STEAM-Academy-PRO/revolution-robotics-kit/certificates/Documentation/Bluetooth-testing-manual/05-select-robots.jpg

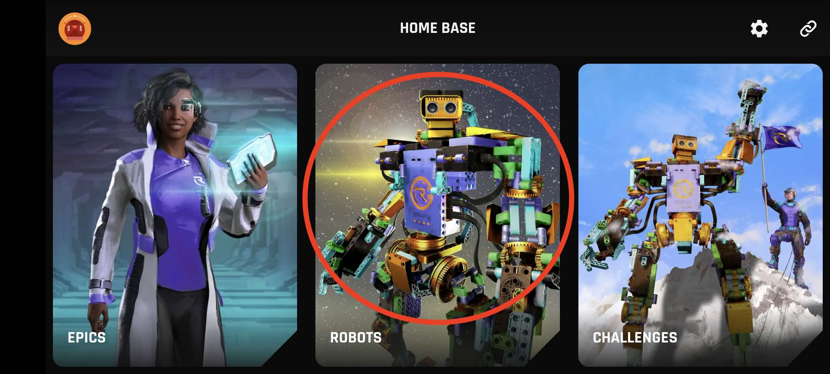
certificates/Documentation/Bluetooth-testing-manual/05-select-robots.jpg
