STEAM-Academy-PRO/revolution-robotics-kit/certificates/Documentation/Bluetooth-testing-manual/06-A-tester-in-most-recent.jpg

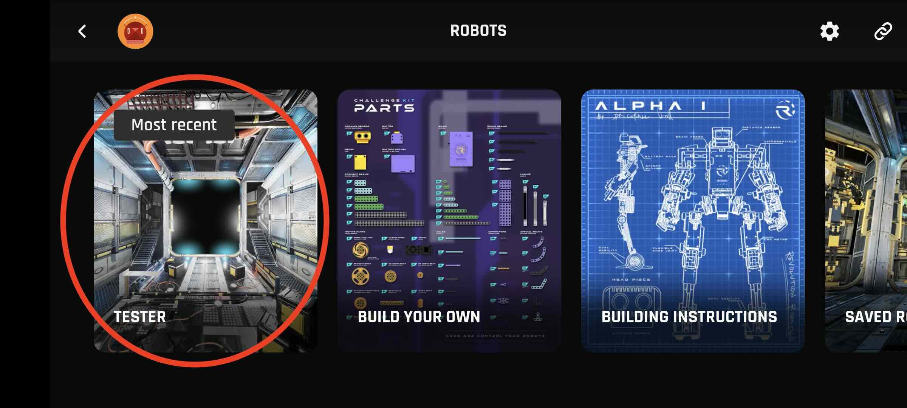
certificates/Documentation/Bluetooth-testing-manual/06-A-tester-in-most-recent.jpg
