STEAM-Academy-PRO/revolution-robotics-kit/README.md

# Revolution Robotics Kit
The repository contains all resources needed to manufacture the kit

# Bill of Materials
Find the [latest BoM here](https://docs.google.com/spreadsheets/d/1262smQJIMRbo7T9IJH0D1xYeTHnK25JgkaZvrPby7Jk/edit#gid=518901317).
