STEAM-Academy-PRO/revolution-robotics-kit/certificates/Documentation/Block-diagram/SA-RR-CK-2.0-Block-diagram-2024-07-18.pptx

## Revolution Robotics Block diagram

2024/07/18
Laszlo B.

## Slide 2

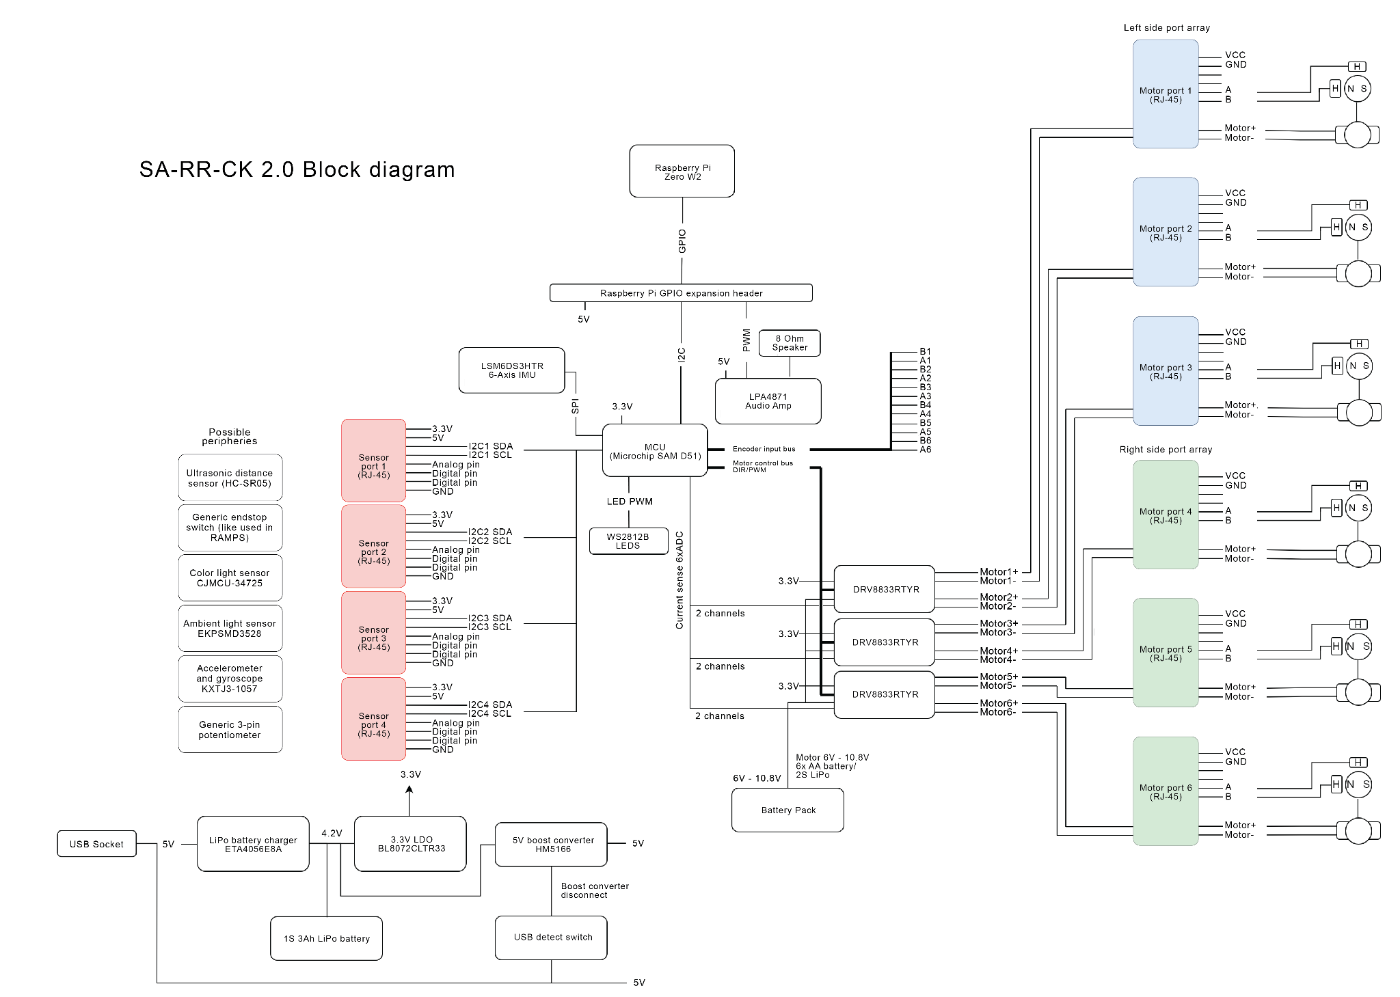
[picture p3: figure]

## Slide 3

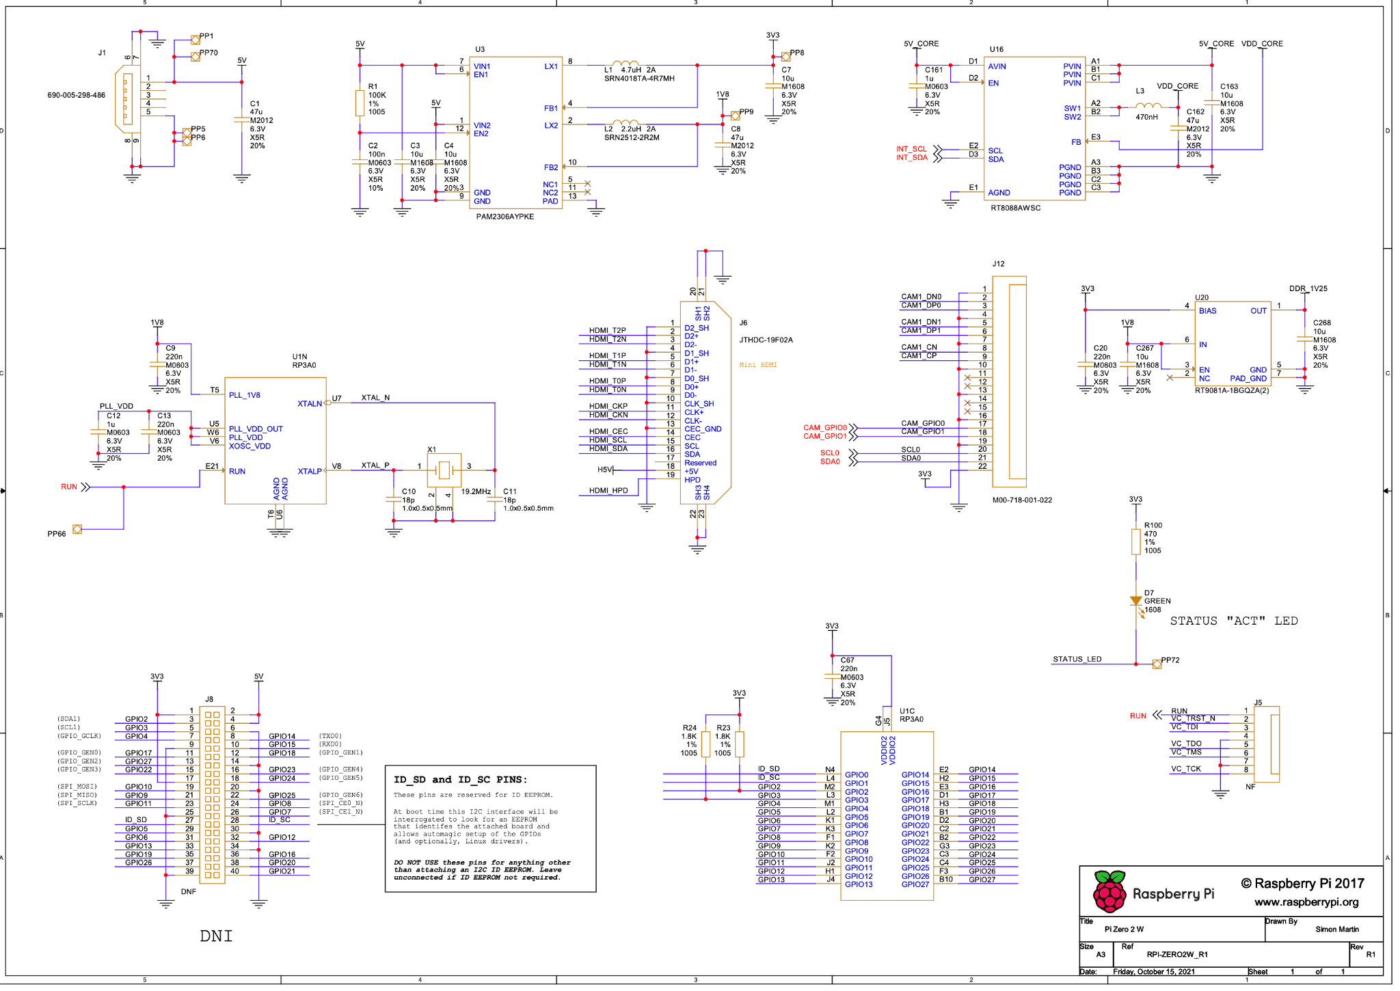
[picture p4: figure]
