STEAM-Academy-PRO/revolution-robotics-kit/accessories/CF - Challenge Field/Challenge Field.png

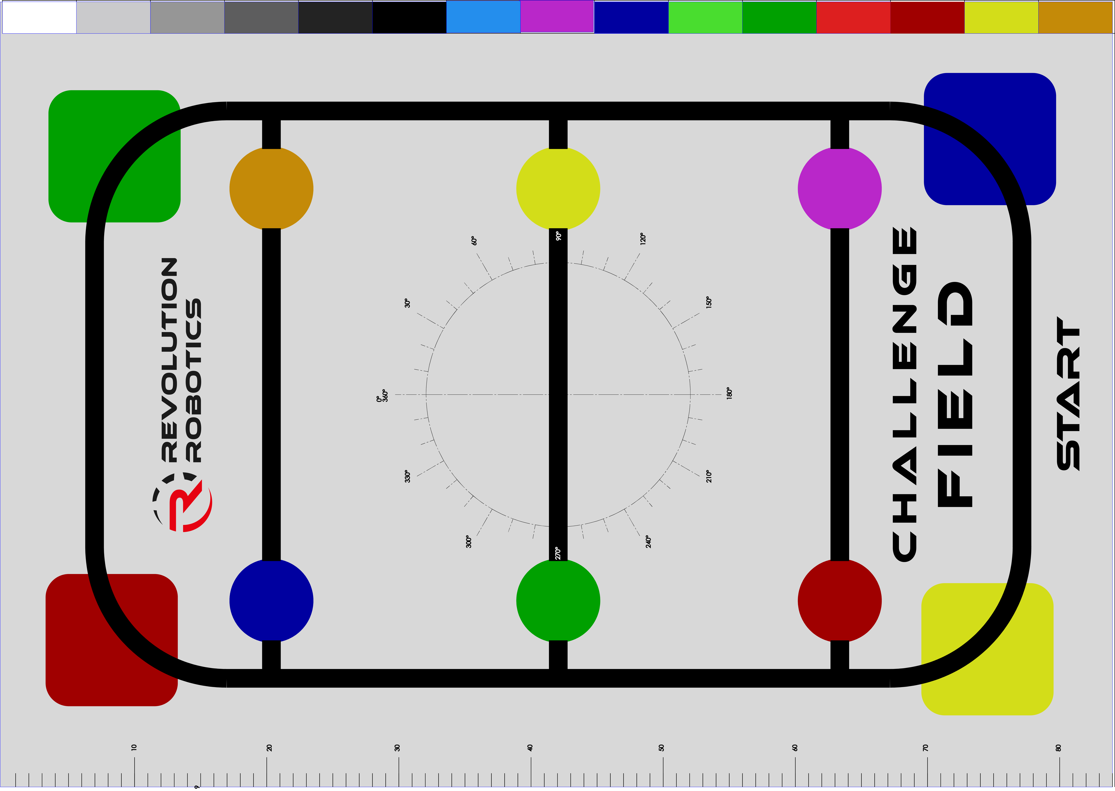
accessories/CF - Challenge Field/Challenge Field.png
