STEAM-Academy-PRO/revolution-robotics-kit/accessories/MT - Measuring tape/Labeling/Measuring-tape-back-bg-trans.png

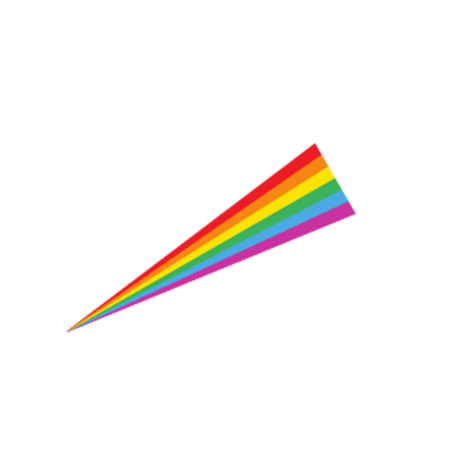
accessories/MT - Measuring tape/Labeling/Measuring-tape-back-bg-trans.png
