STEAM-Academy-PRO/revolution-robotics-kit/mechanical parts/WH - Wheels/CW - Caster Wheel/Specification/caster wheel 万向轮图纸20190429.jpg

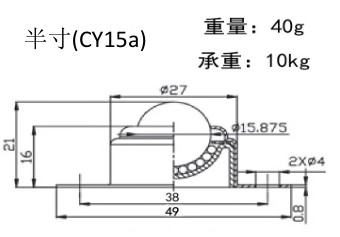
mechanical parts/WH - Wheels/CW - Caster Wheel/Specification/caster wheel 万向轮图纸20190429.jpg
