STEAM-Academy-PRO/revolution-robotics-kit/toolbox/LEGO Spike box additional trays/2024-06-11-lego-spike-box-inside-trays-top-packed.jpg

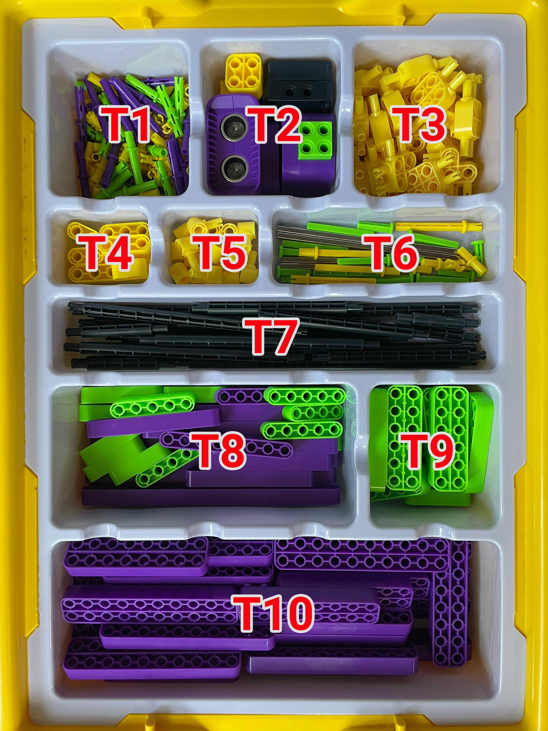
toolbox/LEGO Spike box additional trays/2024-06-11-lego-spike-box-inside-trays-top-packed.jpg
