STEAM-Academy-PRO/revolution-robotics-kit/electronic parts/BA - Battery Pack/Battery-pack-v2-production/Tray/battery-tray.md

Note: There's two different sizes from the tray that fit the plastic. One of them is too big, it fits the space without any room left, so we struggled to pull it out even with the extra rubber band attached around it to help.

**The correct width should be around ~46mm and not ~48mm**
