STEAM-Academy-PRO/revolution-robotics-kit/electronic parts/BU - Button Sensor/Button-sensor-v1-production/BoM/BoM-Button-Sensor.xlsx

Sheet: BOM Report
Bill of Materials |  |  | Bill of Materials For Project [AnalogButton.PrjPCB] (No PCB Document Selected)
Source Data From: |  | AnalogButton.PrjPCB
Project: |  | AnalogButton.PrjPCB
Variant: |  | None
Creation Date: | 2019. 05. 24. | 11:10:39
Print Date: | 2019-07-30 | 13:43:15
# | Footprint | Manufacturer | Manufacturer Part Number | Designator | Description | Quantity
1 | FSMJSMA | Dongguan Rui Peter | TD-06XB | B1 | SMD tactile switch 6*6*7mm | 1
2 | RJ45 | Guozhi | 5721-8P8C-全塑有耳 | U1 | RJ 45 connector | 1
3 |  |  | PCB (Bumper_switch output_0531) | PCB | PCB | 1
 |  |  |  |  |  | 3
Approved |  | Notes

Sheet: Project Information
Project Full Path | C:\_RevolutionRobotics\Hardware\Blocks\AnalogButton\AnalogButton.PrjPCB
Project Filename | AnalogButton.PrjPCB
Variant Name | None
Data-Source Filename | AnalogButton.PrjPCB
Data-Source Full Path | C:\_RevolutionRobotics\Hardware\Blocks\AnalogButton\AnalogButton.PrjPCB
Title | Bill of Materials For Project [AnalogButton.PrjPCB] (No PCB Document Selected)
Total Quantity | 2
Report Time | 11:10:39
Report Date | 2019. 05. 24.
Report Date & Tine | 2019. 05. 24. 11:10:39
Output Name | Bill of Materials
Output Type | BOM_PartType
Output Generator Name | BOM
Output Generator Description | Bill of Materials
