STEAM-Academy-PRO/revolution-robotics-kit/electronic parts/US - Ultrasonic Sensor/Ultrasonic-Sensor-v1-production/BoM/BOM-Ultrasonic-Sensor.xlsx

Sheet: BOM Report
Bill of Materials |  |  | Bill of Materials For Project [HC-SR04.PrjPCB] (No PCB Document Selected)
Source Data From: |  | HC-SR04.PrjPCB
Project: |  | HC-SR04.PrjPCB
Variant: |  | None
Creation Date: | 2019. 05. 24. | 11:03:54
Print Date: | 2019-07-30 | 13:43:15
# | Footprint | Manufacturer | Manufacturer Part Number | Designator | Description | Quantity
1 | US-025 | 宏创微 | US-025 | S1 | Ultrasonic sensor | 1
2 | RJ45 | Guozhi | 5721-8P8C-全塑有耳 | U1 | RJ 45 connector | 1
3 |  |  | PCB (Ultrasound output_0613) | PCB | PCB | 1
 |  |  |  |  |  | 3
Approved |  | Notes

Sheet: Project Information
Project Full Path | C:\_RevolutionRobotics\Hardware\Blocks\HC-SR04\HC-SR04.PrjPCB
Project Filename | HC-SR04.PrjPCB
Variant Name | None
Data-Source Filename | HC-SR04.PrjPCB
Data-Source Full Path | C:\_RevolutionRobotics\Hardware\Blocks\HC-SR04\HC-SR04.PrjPCB
Title | Bill of Materials For Project [HC-SR04.PrjPCB] (No PCB Document Selected)
Total Quantity | 2
Report Time | 11:03:54
Report Date | 2019. 05. 24.
Report Date & Tine | 2019. 05. 24. 11:03:54
Output Name | Bill of Materials
Output Type | BOM_PartType
Output Generator Name | BOM
Output Generator Description | Bill of Materials
