STEAM-Academy-PRO/revolution-robotics-kit/electronic parts/BR - Brain/Brain-v2-production/D sample [Start-of-Production]/BOM/LEDs-board-v2-rev4.4.0-20240621.xlsx

Sheet: Part List Report
 | Component list |  |  | Bill of Materials for Variant [NO_DNP_leds_board] of Project [leds_board.PrjPcb] (No PCB Document Selected)
 | Source Data From: |  |  | leds_board.PrjPcb
 | Project: |  |  | leds_board.PrjPcb
 | Variant: |  |  | NO_DNP_leds_board
 | Version: |  |  | 4.4
 | Report Date: |  | 21.06.2024 | 11:54
 | Print Date: |  | 2024-06-21 | 11:54:36
# | Manufacturer | PartNumber | Description | Quantity | Designator | Mounted
1 | Yageo | CC0402KRX7R7BB104 | Capacitor, 100nF, 10%, 16V, X7R, -55/+125,0402 | 16 | C1, C2, C3, C4, C5, C6, C7, C8, C9, C10, C11, C12, C13, C14, C15, C16 | Yes
2 | Yageo | CC0805KKX5R8BB106 | Capacitor, 10uF, 10%, 25V, X5R, -55/+85, 0805 | 1 | C17 | Yes
3 | TAIWAN TONGJIA OPTOELECTRONICS TECHNOLOGY | TJ-S5050RGBICSY62-A6 | LED, RGB, 3.5-5.5V, SK6812 Serial Interface, 5050, -40/+85, SMD | 16 | LED1, LED2, LED3, LED4, LED5, LED6, LED7, LED8, LED9, LED10, LED11, LED12, LED13, LED14, LED15, LED16 | Yes
4 | SHENZHENTONGHUIDA TECHNOLOGY | HTD-S1511-30LH-003 | Speaker, magnetic, spring, 8 Ohm, 0.7W, 300Hz-20kHz, Top Rectangular, 85dB | 1 | LS1 | No
5 |  | LED_board | PCB, Rev_4.4 | 1 | MECH1
6 | Nexperia | NX7002AK,215 | MOSFET, N-CH, 60V, 190mA, -55/+150, TO-236AB | 1 | Q1 | Yes
7 | Yageo | RC0402FR-074K7L | Resistor, 4.7K, 1%, 0.063W, -55/+155, 0402 | 1 | R1 | Yes
8 | Yageo | RC0402FR-0747KL | Resistor, 47K, 1%, 0.063W, -55/+155, 0402 | 1 | R2 | Yes

Sheet: Project Information
Project Full Path | Z:\Projects\Revolution_Robotics_Robot_Controller\robot_controller_V3\Development\SCH-PCB_AD_24\leds_board.PrjPcb
Project Filename | leds_board.PrjPcb
Variant Name | NO_DNP_leds_board
Data-Source Filename | leds_board.PrjPcb
Data-Source Full Path | Z:\Projects\Revolution_Robotics_Robot_Controller\robot_controller_V3\Development\SCH-PCB_AD_24\leds_board.PrjPcb
Title | Bill of Materials for Variant [NO_DNP_leds_board] of Project [leds_board.PrjPcb] (No PCB Document Selected)
Total Quantity | 38
Report Time | 11:54
Report Date | 21.06.2024
Report Date & Tine | 21.06.2024 11:54
Output Name | Bill of Materials
Output Type | BomReport
Output Generator Name | BOM
Output Generator Description | Bill of Materials
