STEAM-Academy-PRO/revolution-robotics-kit/electronic parts/BR - Brain/Brain-v2-production/C sample [Pre-Production]/BOM/Carrier-board-v2-rev3.3.0-20240415.xlsx

Sheet: Part List Report
 | Component list |  |  | Bill of Materials for Variant [NO_DNP_carrier_board] of Project [carrier_board.PrjPcb] (No PCB Document Selected)
 | Source Data From: |  |  | carrier_board.PrjPcb
 | Project: |  |  | carrier_board.PrjPcb
 | Variant: |  |  | NO_DNP_carrier_board
 | Version: |  |  | 3.3.0
 | Report Date: |  | 15.04.2024 | 18:18
 | Print Date: |  | 2024-04-15 | 18:19:07
# | Manufacturer | PartNumber | Description | Quantity | Designator | Mounted
1 | ShenZhen BatteryPower Technology | 683866P | Battery, Li-Pol, 3.7V, 2000mAh, 69x39x7mm, 0/+40 | 1 | BAT1
2 | Yageo | CC0402KRX7R8BB103 | Capacitor, 10nF, 25V, X7R, 10%, -55/+125, 0402 | 7 | C1, C21, C22, C32, C33, C46, C47 | Yes
3 | Yageo | CC0805KKX5R8BB106 | Capacitor, 10uF, 25V, X5R, 10%, -55/+85, 0805 | 18 | C2, C3, C23, C34, C48, C52, C53, C55, C56, C85, C87, C89, C91, C93, C95, C97, C101, C103 | Yes
4 | Yageo | CC0402KRX7R7BB104 | Capacitor, 100nF, 16V, X7R, 10%, -55/+125,0402 | 43 | C4, C5, C7, C8, C9, C10, C11, C12, C13, C14, C18, C26, C35, C39, C43, C44, C58, C69, C70, C71, C73, C74, C76, C77, C82, C84, C86, C88, C90, C92, C94, C96, C100, C102, C104, C106, C108, C109, C110, C116, C117, C118, C119 | Yes
5 | Yageo | CC0402MRX5R7BB475 | Capacitor, 4.7uF, 16V, X5R, 20%, -55/+85, 0402 | 3 | C6, C15, C59 | Yes
6 | Murata | GCM155R71H222KA37D | Capacitor, 2.2nF, 50V, X7R, 10%, -55/+125, 0402 | 15 | C16, C17, C24, C25, C28, C29, C30, C37, C38, C41, C42, C49, C50, C51, C107 | Yes
7 | Yageo | CC0402KRX5R6BB225 | Capacitor, 2.2uF, 10V, X5R, 10%, -55/+85, 0402 | 4 | C20, C31, C45, C99 | Yes
8 | Samsung | CL21A226KPCLRNC | Capacitor, 22uF, 10V, X5R, 10%, -55/+85, 0805 | 5 | C27, C60, C72, C75, C114 | Yes
9 | Yageo | CC0402KRX5R7BB105 | Capacitor, 1uF, 16V, X5R, 10%, -55/+85, 0402 | 15 | C36, C57, C61, C62, C63, C64, C65, C66, C67, C68, C80, C81, C83, C98, C113 | Yes
10 | Yageo | CC0402KRX7R9BB153 | Capacitor, 15nF, 10%, 50V, X7R, -55/+125, 0402 | 1 | C40 | Yes
11 | Yageo | CC0603KRX7R6BB394 | Capacitor, 390nF, 10%, 10V, X7R, -55/+125, 0603 | 1 | C78 | Yes
12 | Yageo | CC0402KRX7R7BB333 | Capacitor, 33nF, 16V, X7R, 10%, -55/+125, 0402 | 1 | C79 | Yes
13 | Yageo | CC0402KRX7R9BB332 | Capacitor, 3300pF, 10%, 50V, X7R, -55/+125, 0402 | 1 | C105 | Yes
14 | AVX | TPSD227K010R0150 | Capacitor, Tantal, 220uF, 10%, 10V, 150mOhm, -55/+125, 2917 | 1 | C115 | Yes
15 | Astron | 5611086-103-R | Conn, RJ-45, RA, 3POS, Shielded, -40/+85, TH | 2 | CON2, CON3 | Yes
16 | Dongguan Rui Peter | DC-091 | Conn, Jack, 30VDC, 8A, Flat angle, -30/+70, TH | 1 | CON4 | Yes
17 | Astron | RL23D26-40-C | Conn, Header, Female, 20x2POS, P-2.54mm, RA, -40/+105, TH | 1 | CON6 | Yes
18 | Astron | A1001-WV-05-NP | Conn, Header, Vertical, Male, 5POS, P-1mm, -25/+85, SMD | 1 | CON7 | Yes
19 | Guozhi | 56L-88-421223 | Conn, RJ-45, RA, 4POS, Shielded, -40/+85, TH | 1 | CON8 | Yes
20 | Micro Commercial | SD15C-TP | Diode, TVS, Bidir, 15VWM, 30VC, -55/+125, SOD-323 | 12 | D1, D4, D5, D9, D17, D18, D19, D23, D31, D32, D33, D37 | Yes
21 | Sursemi | ST0521D4 | Diode, TVS, 5VWM, 12VC, -55/+125, DFN1006-2 | 11 | D2, D10, D15, D24, D29, D38, D43, D51, D55, D60, D64 | Yes
22 | TI | LM431BCM3/NOPB | Zener shunt regulator, Precision, 2.5-36V, 1%, 0/+70, SOT-23 | 4 | D3, D8, D11, D14 | Yes
23 | Sursemi | ST0361D4 | Diode, TVS, 3.3VWM, 8VC, -55/+125, DFN1006-2 | 20 | D6, D7, D12, D13, D20, D21, D26, D27, D34, D35, D40, D41, D52, D56, D61, D65, D66, D68, D69, D70 | Yes
24 | Diodes | SMBJ10CA-13-F | Diode, TVS, Bidir, 10VRWM, 17VC, -55/+150, SMB | 1 | D44 | Yes
25 | Sursemi | ST0524D25 | Diode, TVS, 4-ch, 5VWM, 15VC, -55/+125, DFN2510-10 | 4 | D48, D53, D58, D71 | Yes
26 | Murata | BLM18AG121SN1D | Ferrite Bead, 0.5A, 120 Ohm/100MHz, -55/+125, 0603 | 2 | FB1, FB2 | Yes
27 | Taiyo Yuden | BKP1005EM221-T | Ferrite Bead, 1A, 220Ohm/100MHz, -55/+85, SMD, 0402 | 8 | FB4, FB5, FB6, FB7, FB8, FB9, FB10, FB11 | Yes
28 | Bel Fuse | 0ZCM0005FF2G | Fuse, PTC, Resettable, 50mA, 15VDC, -40/+85, 0603, AEC-Q200 | 6 | FU2, FU4, FU6, FU8, FU10, FU12 | Yes
29 | Bel Fuse | 0ZCK0010FF2G | Fuse, PTC, Resettable, 100mA, 15VDC, -40/+85, 0805, AEC-Q200 | 7 | FU13, FU14, FU15, FU16, FU18, FU19, FU20 | Yes
30 | Bel Fuse | 0ZCK0050AF2E | Fuse, PTC, Resettable, 500mA, 9VDC, -40/+85, 0805, AEC-Q200 | 1 | FU17 | Yes
31 | Littelfuse | 1206SFH100F/24-2 | Fuse, 10A, 24VDC, -55/+125, 1206 | 1 | FU21 | Yes
32 | SHENZHEN MICROGATE TECHNOLOGY | MAPM0520F-1R0M-LF | Inductor, 1uH, 6A, 20%, 17mOhm, Shielded, -55/+125, 5.9x5.2x2.0 | 1 | L2 | Yes
33 | SHENZHEN MICROGATE TECHNOLOGY | MPIT5020-2R2N-LF | Inductor, 2.2uH, 2.9A, 30%, 32mOhm, Shielded, -25/+120, 5.0x5.0x2.1 | 1 | L3 | Yes
34 | Taiyo Yuden | MAKK2016T2R2M | Inductor, 2.2uH, 20%, 1.5A, 131mOhm, -40/+105, 0806 | 1 | L4 | Yes
35 | Astron | SH10028-05-50-R | Conn, Female, With cable 50mm, 1x5pos, 28AWG, P-1mm, TH | 1 | MECH1
36 | Raspberry Pi | Raspberry Pi Zero 2 W | 1Ghz CPU, 512MB SDRAM, Bluetooth 4.2, 2.4GHz 802.11 b/g/n wireless LAN, 65x30mm | 1 | MECH2
37 |  | GENERIC_PCB |  | 1 | MECH3
38 | Astron | RL17D02-40-C-4-3.05/5.84/5.00 | Conn, Header, Male, 20x2POS, P-2.54mm, -40/+105, TH | 1 | MECH4 | Yes
39 | Nexperia | NX7002AK,215 | MOSFET, N-CH, 60V, 190mA, -55/+150, TO-236AB | 10 | Q1, Q3, Q4, Q5, Q6, Q7, Q9, Q10, Q11, Q12 | Yes
40 | Infineon | ISC045N03L5SATMA1 | Transistor, MOSFET, N-CH, 30V, 63A, -55/+150, PowerTDFN-8 | 1 | Q2 | Yes
41 | Prisemi | PPM8PN30V12 | Transistor, MOSFET, P-CH, 30V, 12A, -55/150, PDFN3.3*3.3-8L | 2 | Q8, Q17 | Yes
42 | Yageo | RC0402FR-07100KL | Resistor, 100K, 1%, 0.063W, -55/+155, 0402 | 12 | R1, R19, R44, R86, R90, R94, R97, R128, R137, R147, R158, R162 | Yes
43 | Yageo | RC0402FR-0747KL | Resistor, 47K, 1%, 0.063W, -55/+155, 0402 | 14 | R2, R25, R28, R29, R34, R37, R41, R42, R43, R47, R52, R56, R57, R120 | Yes
44 | Yageo | RC0402FR-074K7L | Resistor, 4.7K, 1%, 0.063W, -55/+155, 0402 | 4 | R3, R4, R5, R6 | Yes
45 | Yageo | RC0402FR-07100RL | Resistor, 100, 1%, 0.063W, -55/+155, 0402 | 29 | R7, R14, R15, R20, R24, R33, R36, R48, R55, R61, R64, R72, R77, R123, R125, R126, R129, R133, R135, R136, R138, R142, R145, R146, R148, R151, R154, R155, R159 | Yes
46 | Yageo | RC0402FR-0710KL | Resistor, 10K, 1%, 0.063W, -55/+155, 0402 | 36 | R8, R9, R10, R22, R23, R38, R39, R50, R51, R62, R65, R66, R67, R68, R69, R79, R80, R84, R92, R93, R119, R122, R131, R139, R165, R166, R167, R168, R169, R170, R171, R172, R173, R174, R175, R176 | Yes
47 | Yageo | RC0402FR-07680RL | Resistor, 680, 1%, 0.0625W, -55/155, 0402 | 20 | R11, R18, R21, R30, R35, R40, R49, R58, R63, R70, R75, R78, R124, R130, R134, R140, R143, R149, R152, R160 | Yes
48 | Yageo | RC0402FR-070RL | Resistor, 0, 1%, 0.063W, -55/+155, 0402 | 3 | R12, R71, R177 | Yes
49 | Yageo | RC0402FR-0739KL | Resistor, 39K, 1%, 0.0625W, -55/+155, 0402 | 12 | R16, R17, R31, R32, R45, R46, R59, R60, R73, R74, R87, R88 | Yes
50 | Vishay | RCWE1206R120FKEA | Resistor, 120mOhm, 1%, 0.5W, -55/155, 1206, AEC-Q200 | 6 | R26, R27, R53, R54, R81, R82 | Yes
51 | Yageo | RC0402FR-07470RL | Resistor, 470, 1%, 0.063W, -55/+155, 0402 | 4 | R76, R83, R85, R89 | Yes
52 | Yageo | RC0402FR-0730KL | Resistor, 30K, 1%, 0.0625W, -55/+155, 0402 | 1 | R91 | Yes
53 | Yageo | RC0402FR-072K7L | Resistor, 2.7K, 1%, 0.0625W, -55/+155, 0402 | 1 | R95 | Yes
54 | Yageo | RC0402FR-0710RL | Resistor, 10, 1%, 0.0625W, -55/+155, 0402 | 1 | R96 | Yes
55 | Yageo | RC0402FR-0720KL | Resistor, 20K, 1%, 0.0625W, -55/+155, 0402 | 12 | R100, R104, R105, R106, R107, R108, R116, R117, R121, R127, R132, R141 | Yes
56 | Yageo | RC0402FR-07910KL | Resistor, 910K, 1%, 0.0625W, -55/155, 0402 | 1 | R101 | Yes
57 | Yageo | RC0402FR-07240KL | Resistor, 240K, 1%, 0.0625W, -55/+155, 0402 | 1 | R102 | Yes
58 | Yageo | RC0402FR-07200KL | Resistor, 200K, 1%, 0.0625W, -55/+155, 0402 | 1 | R103 | Yes
59 | Yageo | RC0402FR-0713KL | Resistor, 13K, 1%, 0.0625W, -55/+155, 0402 | 1 | R109 | Yes
60 | Yageo | RC0402FR-07330KL | Resistor, 330K, 1%, 0.0625W, -55/+155, 0402 | 1 | R110 | Yes
61 | Yageo | RC0402FR-07120KL | Resistor, 120K, 1%, 0.0625W, -55/+155, 0402 | 1 | R111 | Yes
62 | Yageo | RC0402FR-0768KL | Resistor, 68K, 1%, 0.0625W, -55/155, 0402 | 1 | R114 | Yes
63 | Yageo | RC0402FR-07150RL | Resistor, 150, 1%, 0.0625W, -55/+155, 0402 | 1 | R115 | Yes
64 | Yageo | RC0402FR-071KL | Resistor, 1K, 1%, 0.063W, -55/+155, 0402 | 1 | R118 | Yes
65 | Yageo | RC0402FR-0756KL | Resistor, 56K, 1%, 0.0625W, -55/155, 0402 | 1 | R144 | Yes
66 | Yageo | RC0402FR-07150KL | Resistor, 150K, 1%, 0.0625W, -55/+155, 0402 | 4 | R157, R163, R164, R181 | Yes
67 | Jiang Yuan Zhizhao | P12-0542-002 | Switch, Slide, Vertical, DPDT, Shielded, RA, TH | 1 | S1 | Yes
68 | Microchip | ATSAMD51P19A-AUT | IC, MCU,32-bit,ARM Cortex M4,Flash 512K,1.8-3.6V,-40/+85, TQFP-128, AEC-Q100 | 1 | U1 | Yes
69 | Sungine | GC8833AT | IC, Motor Driver, Half-bridge, 2Ch, 2.7-15V, -40/+150, eTSSOP-16 | 3 | U2, U3, U4 | Yes
70 | Top Power ASIC | TP4056-42-SOP8-PP | IC, Li-Ion Battery Charger, 4.2V, 1A, -40/+85, SOP8 | 1 | U5 | Yes
71 | SG Micro | SGM6012-3.3YTN5G/TR | IC, DC/DC, Buck, 2.5-5.5V/3.3V, 800mA, -40/+85, TSOT-23-5 | 1 | U6 | Yes
72 | Microchip | MIC2876-AYMT-TR | IC, Boost Controller, 2.5V-5.5V/Adj, 3.8A, -40/+85, TDFN-8 | 1 | U7 | Yes
73 | ST | LSM6DS3HTR | IC, Accelerometer, Gyroscope, Temperature, 6 Axis, I2C/SPI, 3.3V, -40/+85, 14-LGA | 1 | U8 | Yes
74 | Analog Devices | LTC4352CDD#PBF | IC, Ideal Diode Controller, 2.9-18V, 0/+70, DFN-12 | 1 | U9 | Yes
75 | LowPowerSemi | LPW5209AB5F | IC, Power Switch, 2.5-6V, 2.1A, -40/+85, SOT23-5 | 8 | U10, U11, U12, U13, U20, U21, U22, U23 | Yes
76 | H&Msemi | HM5166 | IC, DC/DC, Boost, 2.7V-13.2V/4.5-13.8, 10Apeak, -40/+85, SOP8-PP | 1 | U14 | Yes
77 | BROADCHIP | BCT0104EGD-TR | IC, Level Translator, Bidir, 4Ch, 1.6-5.5V/2.3-5.5V, -40/+85, QFN3.5x3.5-14L | 4 | U15, U17, U18, U19 | Yes
78 | LowPowerSemi | LPA4871 | IC, Audio amplifier, Mono, 2.0V - 5.5V, -65/+150, SOP-8 | 1 | U16 | Yes

Sheet: Project Information
Project Full Path | Z:\Projects\Revolution_Robotics_Robot_Controller\robot_controller\Development\SCH-PCB_AD_20.1.14\carrier_board.PrjPcb
Project Filename | carrier_board.PrjPcb
Variant Name | NO_DNP_carrier_board
Data-Source Filename | carrier_board.PrjPcb
Data-Source Full Path | Z:\Projects\Revolution_Robotics_Robot_Controller\robot_controller\Development\SCH-PCB_AD_20.1.14\carrier_board.PrjPcb
Title | Bill of Materials for Variant [NO_DNP_carrier_board] of Project [carrier_board.PrjPcb] (No PCB Document Selected)
Total Quantity | 412
Report Time | 18:18
Report Date | 15.04.2024
Report Date & Tine | 15.04.2024 18:18
Output Name | Bill of Materials
Output Type | BomReport
Output Generator Name | BOM
Output Generator Description | Bill of Materials
