STEAM-Academy-PRO/revolution-robotics-kit/electronic parts/BR - Brain/Brain-v2-production/C sample [Pre-Production]/BOM/leds_board_v3.4.0_20190911.xlsx

Sheet: Part List Report
 | Component list |  |  | Bill of Materials for Project [leds_board.PrjPcb] (No PCB Document Selected)
 | Source Data From: |  |  | leds_board.PrjPcb
 | Project: |  |  | leds_board.PrjPcb
 | Variant: |  |  | 3.4
 | Report Date: |  | 11.09.2019 | 15:52
 | Print Date: |  | 2019-09-11 | 15:52:16
# | Manufacturer | Manufacturer Part Number | Part Description | Quantity | Designator | Mounted
1 | Yageo | CC0402KRX7R7BB104 | Capacitor, 100n, 16V, X7R, 10%, 0402 | 16 | C1, C2, C3, C4, C5, C6, C7, C8, C9, C10, C11, C12, C13, C14, C15, C16 | Yes
2 | Yageo | CC0805KKX5R8BB106 | Capacitor, 10u, 25V, X5R, 10%, -55/+85, 0805 | 1 | C17 | Yes
3 | TAIWAN TONGJIA OPTOELECTRONICS TECHNOLOGY | TJ-S5050RGBICSY62-A6 | LED, RGB, 3.5-5.5V, SK6812 Serial Interface, 5050, -40/+85, SMD | 16 | LED1, LED2, LED3, LED4, LED5, LED6, LED7, LED8, LED9, LED10, LED11, LED12, LED13, LED14, LED15, LED16 | Yes
4 | SHENZHENTONGHUIDA TECHNOLOGY | HTD-S1511-30LH-003 | Speaker, magnetic, spring, 8 Ohm, 0.7W, 300Hz-20kHz, Top Rectangular, 85dB | 1 | LS1 | DNP
5 |  | LED_board | PCB, Rev_3.3 | 1 | MECH1
6 | Nexperia | NX7002AK,215 | MOSFET, N-CH, 60V, 190mA, -55/+150, TO-236AB | 1 | Q1 | Yes
7 | Yageo | RC0402FR-074K7L | Resistor, 4.7K, 0.063W, 1%, -55/+155, 0402 | 1 | R1 | Yes
8 | Yageo | RC0402FR-0747KL | Resistor, 47K, 0.063W, 1%, -55/+155, 0402 | 1 | R2 | Yes

Sheet: Project Information
Project Full Path | Z:\Projects\Revolution_Robotics_Robot_Controller\Development\robot_controller\Development\SCH-PCB_AD_19.0.8\robot_controller\leds_board.PrjPcb
Project Filename | leds_board.PrjPcb
Variant Name | None
Data-Source Filename | leds_board.PrjPcb
Data-Source Full Path | Z:\Projects\Revolution_Robotics_Robot_Controller\Development\robot_controller\Development\SCH-PCB_AD_19.0.8\robot_controller\leds_board.PrjPcb
Title | Bill of Materials for Project [leds_board.PrjPcb] (No PCB Document Selected)
Total Quantity | 38
Report Time | 15:52
Report Date | 11.09.2019
Report Date & Tine | 11.09.2019 15:52
Output Name | Bill of Materials
Output Type | BOM_PartType
Output Generator Name | BOM
Output Generator Description | Bill of Materials
