STEAM-Academy-PRO/revolution-robotics-kit/electronic parts/MO - Motor/Motor-v2-production/Quality-control/Motor-QC-test-2024-04-20.xlsx

 |  |  |  |  | Motor QC report
 |  |  |  |  |  |  |  |  |  |  |  |  |  |  |  |  | 整理NO.:
Client |  |  |  |  | Production date |  |  | Check date |  |  | Check q'ty |  | Room temperature |  | Humidity |  | Approval | Check | Inspector
Model |  | FYFS130S-0005 |  |  | 2024.4.19 |  |  | 2024.4.19 |  |  | 6 PCS |  | 25 ℃ |  | 55 %RH |  |  |  | 王强
Rated Voltage |  | 7.4 V |  |  | Rated load |  |  | 20.g Weights |  |  | Result |  | Pass |  | Fail
No. | Item | Equipment | Value |  |  | 1 | 2 | 3 | 4 | 5 | 6 |  |  |  | MAX | MIN | R | X | Result
1 | No load current | A | 160mA max |  |  | 98 | 100 | 103 | 98 | 96 | 98 |  |  |  | 103 | 96 | 7.00 | 98.83333333 | OK
2 | No load speed | A | 10000±10%rpm |  |  | 10131 | 10075 | 10078 | 10060 | 10086 | 10069 |  |  |  | 10131 | 10060 | 71.00 | 10083.16667 | OK
3 | Rated load current | A | 500mA max |  |  | 400 | 400 | 404 | 405 | 404 | 400 |  |  |  | 405 | 400 | 5.00 | 402.1666667 | OK
4 | Rated load speed | A | 7500±10%rpm |  |  | 7787 | 7700 | 7685 | 7673 | 7700 | 7786 |  |  |  | 7787 | 7673 | 114.00 | 7721.833333 | OK
5 | Stall Torque | 两点法 | 74g-cm min |  |  | 86.44197952 | 84.84210526 | 84.22900125 | 84.28990364 | 84.54316848 | 88.20849759 |  |  |  | 88.20849759 | 84.22900125 | 3.98 | 85.42577596 | OK
5 | Stall current | A | 1.3A min |  |  | 1.61 | 1.57 | 1.58 | 1.56 | 1.58 | 1.58 |  |  |  | 1.61 | 1.56 | 0.05 | 1.58 | OK
6 | Axis length | F | 6.0±0.4mm |  |  | 6.02 | 6.01 | 6.01 | 6.02 | 6.02 | 6.03 |  |  |  | 6.03 | 6.01 | 0.02 | 6.02 | OK
7 | Axis clearance | F | 0.02-0.50mm |  |  | 0.12 | 0.15 | 0.16 | 0.15 | 0.14 | 0.15 |  |  |  | 0.16 | 0.12 | 0.04 | 0.14 | OK
8 | Motor outer dimension | E | 20.4±0.3mm |  |  | 20.38 | 20.39 | 20.38 | 20.37 | 20.38 | 20.40 |  |  |  | 20.40 | 20.37 | 0.03 | 20.38 | OK
9 | Motor length | E | 25.±0.1mm |  |  | 25.00 | 24.97 | 24.98 | 24.97 | 25.00 | 24.98 |  |  |  | 25.00 | 24.97 | 0.03 | 24.98 | OK
10 | Rotation direction | K | CCW |  |  | CCW | CCW | CCW | CCW | CCW | CCW |  |  |  |  |  |  |  | OK
11 | Noise | J | CCW background noise: 38db Distance: 30CM ≤50db |  |  | 42.2 | 43.1 | 41.9 | 43.1 | 42.4 | 41.3 |  |  |  | 43.10 | 41.30 | 1.80 | 42.33 | OK
12 | Noise | J | CCW background noise: 38db Distance: 30CM ≤50db |  |  | 42.8 | 41 | 44.2 | 42.3 | 41.1 | 41.9 |  |  |  | 44.20 | 41.00 | 3.20 | 42.22 | OK
13 | Vibration | L | Limited sample |  |  | OK | OK | OK | OK | OK | OK |  |  |  |  |  |  |  | OK
14 | Visual check | L | Visual inspection standard |  |  | OK | OK | OK | OK | OK | OK |  |  |  |  |  |  |  | OK
检验水平（MIL-STD-105E)Ⅱ 致命缺陷：0 重缺陷：0.15% 轻缺陷：1.5% |  |  |  |  |  |  |  |  |  | 出货数： PCS | PCS |  | 批号：
客户料号：/
Motor comprehensive tester |  | Multimeter | Micrometer | 2D measuring instrument | Caliper |  | Altimeter |  | Force gauge |  | Weights | Infrared tester |  | Noise tester |  | Visual check |  | Limited sample
A |  | B | C | D | E |  | F |  | G |  | H | I |  | J |  | K |  | L
