STEAM-Academy-PRO/revolution-robotics-kit/electronic parts/BA - Battery Pack/Battery-pack-v2-production/Image/battery-tray.png

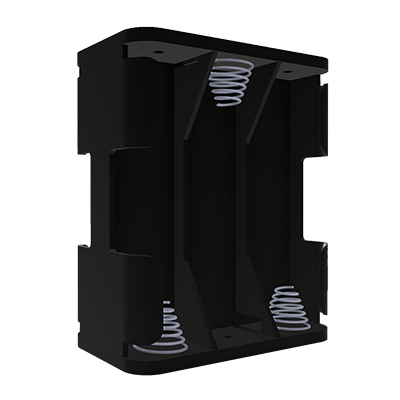
electronic parts/BA - Battery Pack/Battery-pack-v2-production/Image/battery-tray.png
