STEAM-Academy-PRO/revolution-robotics-kit/electronic parts/BA - Battery Pack/Battery-pack-v2-production/Tray/correct-battery-tray.jpg

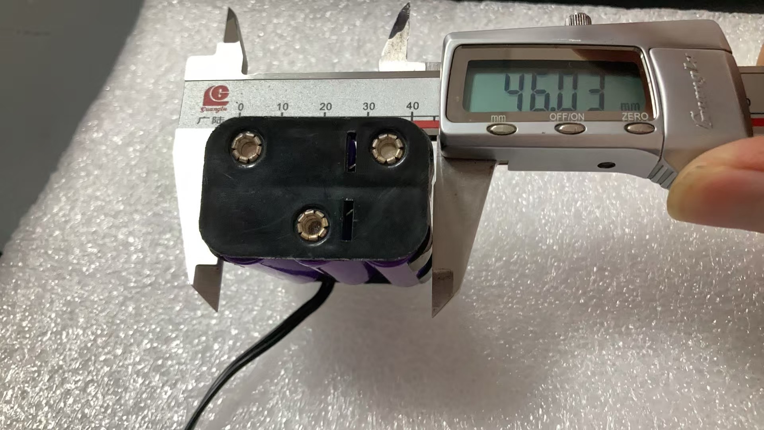
electronic parts/BA - Battery Pack/Battery-pack-v2-production/Tray/correct-battery-tray.jpg
