STEAM-Academy-PRO/revolution-robotics-kit/electronic parts/BR - Brain/Brain-v2-production/D sample [Start-of-Production]/Labeling/Brain label/Brain-labeling-top-full@8x.png

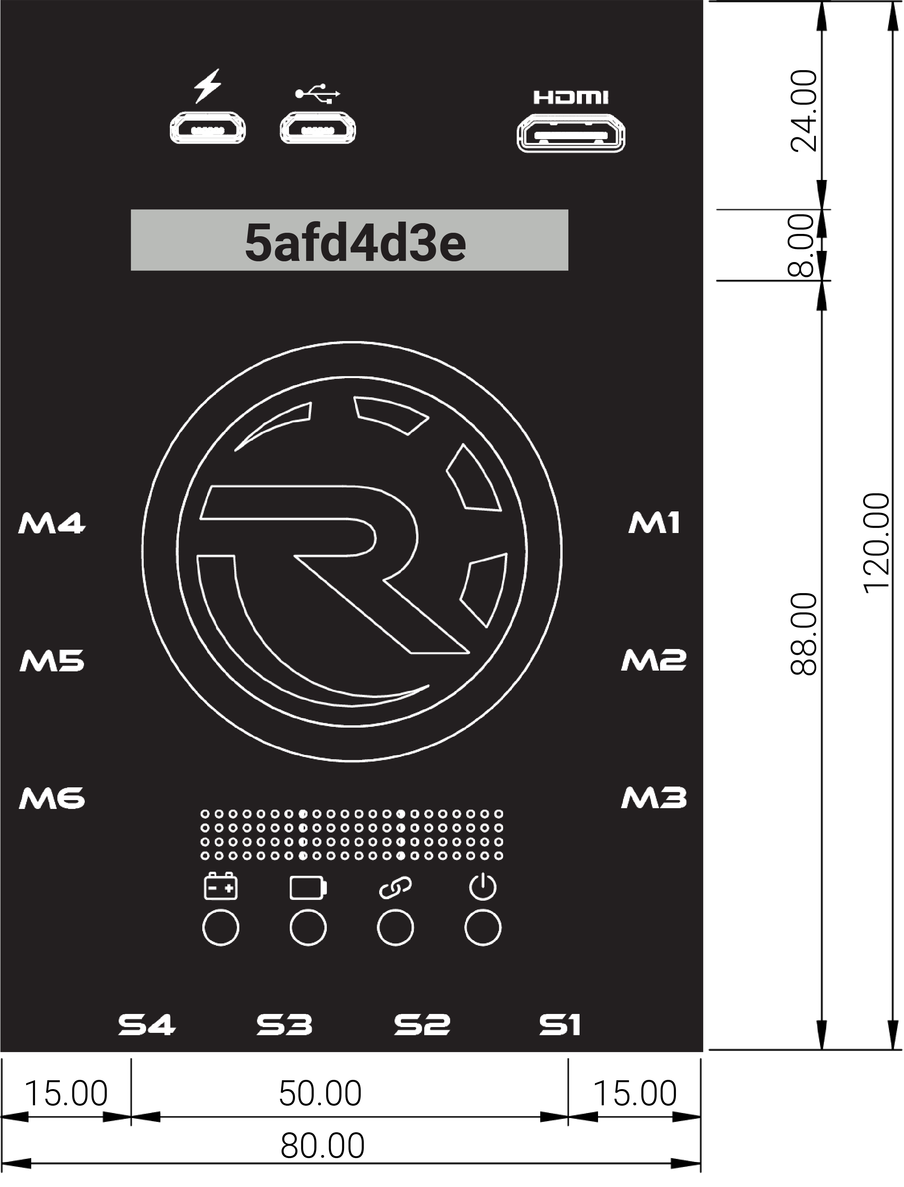
electronic parts/BR - Brain/Brain-v2-production/D sample [Start-of-Production]/Labeling/Brain label/Brain-labeling-top-full@8x.png
