STEAM-Academy-PRO/revolution-robotics-kit/electronic parts/BR - Brain/Brain-v2-production/D sample [Start-of-Production]/Labeling/Brain silk screen/Brain-silkscreen-side.png

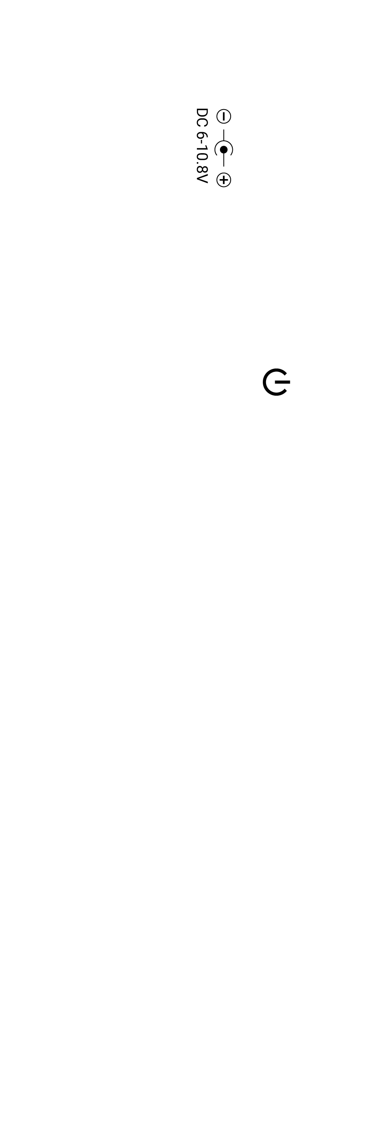
electronic parts/BR - Brain/Brain-v2-production/D sample [Start-of-Production]/Labeling/Brain silk screen/Brain-silkscreen-side.png
