STEAM-Academy-PRO/revolution-robotics-kit/electronic parts/BR - Brain/Brain-v2-production/D sample [Start-of-Production]/Labeling/Brain silk screen/Brain-silkscreen-top-white.png

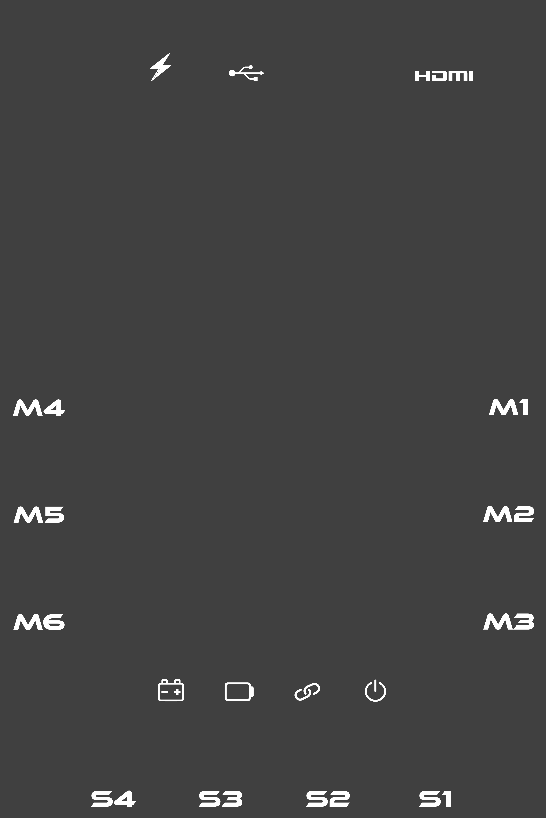
electronic parts/BR - Brain/Brain-v2-production/D sample [Start-of-Production]/Labeling/Brain silk screen/Brain-silkscreen-top-white.png
