STEAM-Academy-PRO/revolution-robotics-kit/electronic parts/BR - Brain/Brain-v2-production/D sample [Start-of-Production]/Labeling/SD Card/Micro-SD-card.png

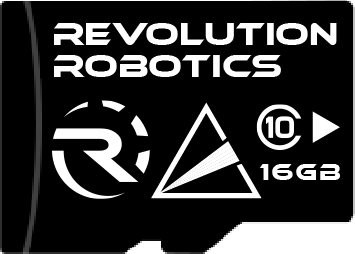
electronic parts/BR - Brain/Brain-v2-production/D sample [Start-of-Production]/Labeling/SD Card/Micro-SD-card.png
