STEAM-Academy-PRO/revolution-robotics-kit/electronic parts/BU - Button Sensor/_to_be_sorted/bubeta_asm-06-10.stp

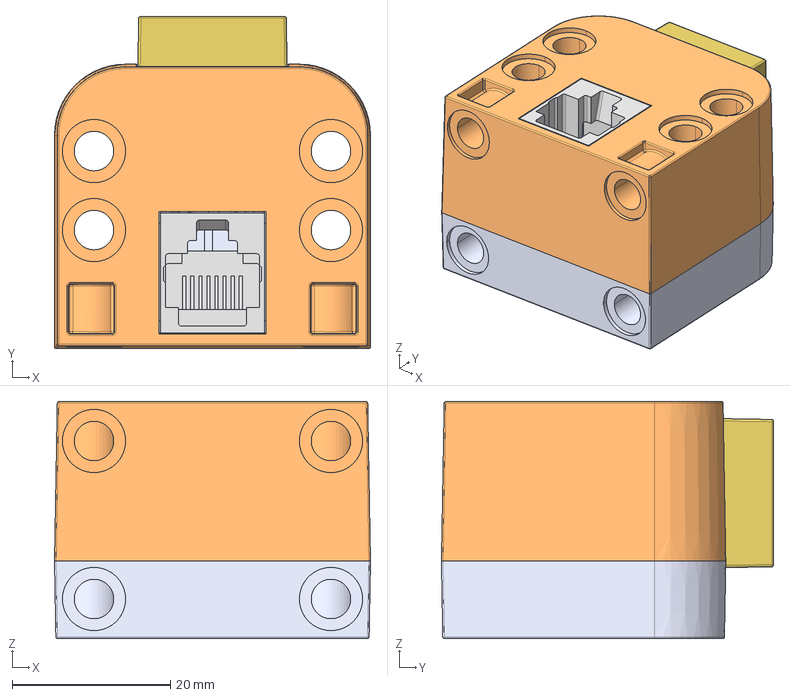
[picture p33: CAD file, 2024-02-20]
electronic parts/BU - Button Sensor/_to_be_sorted/bubeta_asm-06-10.stp
40.0 x 42.0 x 30.0 mm
RESSORT_1LAST_VERSION
BUCA_1_18LAST_VERSION
BUCA_2_19LAST_VERSION
BUMPER_BUTTON_7LAST_VERSION
BOARD_1LAST_VERSION
ST-1102W-7_1LAST_VERSION
RJ45_144-L_1LAST_VERSION
BUCA_4_1LAST_VERSION
M16 x 2
