STEAM-Academy-PRO/revolution-robotics-kit/electronic parts/LM - LED Matrix/LED-Matrix-v1-development/3D-model/LED-Matrix-full.SLDASM

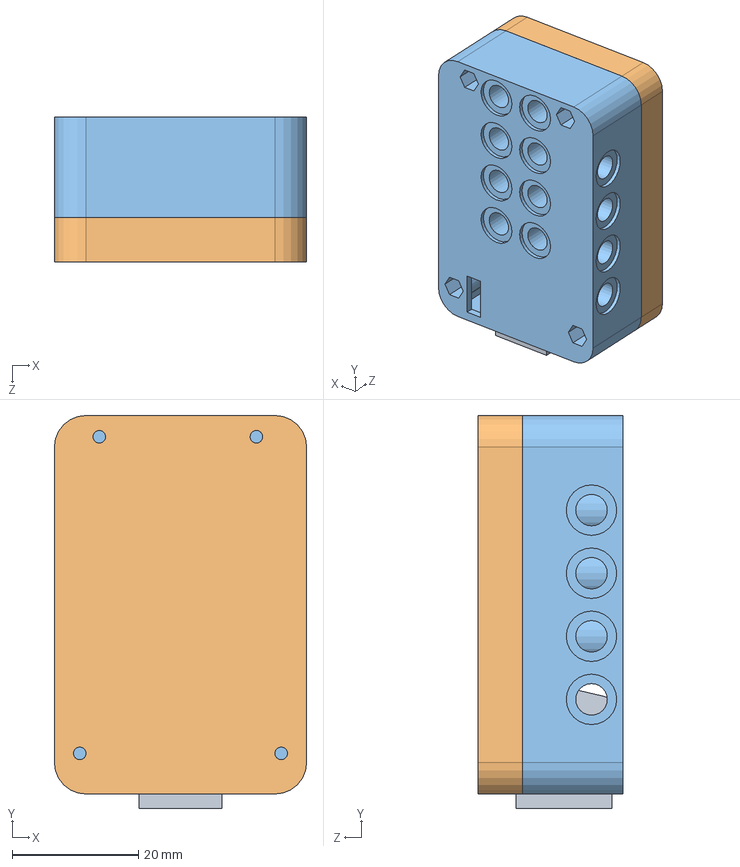
[picture p34: CAD file, 2024-04-02]
electronic parts/LM - LED Matrix/LED-Matrix-v1-development/3D-model/LED-Matrix-full.SLDASM
40.0 x 62.3 x 23.0 mm
singlepart
case top^LED Matrix Assembly
case bottom^LED Matrix Assembly
