STEAM-Academy-PRO/revolution-robotics-kit/electronic parts/US - Ultrasonic Sensor/Ultrasonic-Sensor-v1-production/3D-model/Ultrasonic-Sensor-full.sldasm

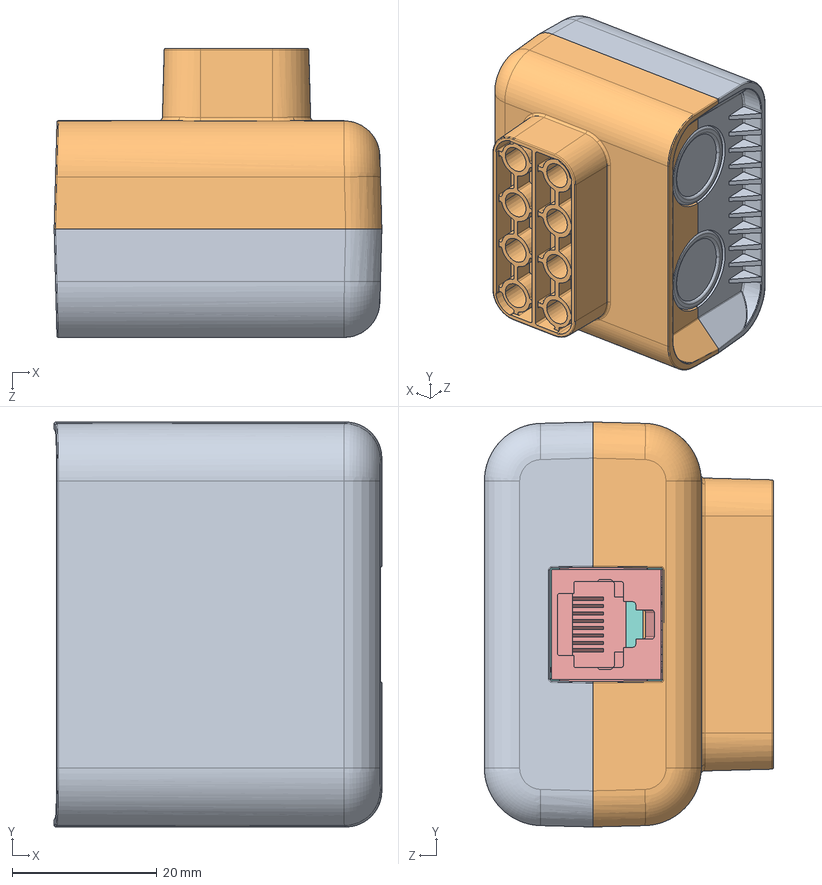
[picture p35: CAD file, 2024-04-02]
electronic parts/US - Ultrasonic Sensor/Ultrasonic-Sensor-v1-production/3D-model/Ultrasonic-Sensor-full.sldasm
45.3 x 56.0 x 40.0 mm
USCA_1^USCA_2_ANY_ASM_1_ASM_USBETA_ANY_ASM_2_ASM_USBETA_ASM_1_ASM_usbeta_asm_0701(2)_USbeta
USCA-2^USCA_2_ANY_ASM_1_ASM_USBETA_ANY_ASM_2_ASM_USBETA_ASM_1_ASM_usbeta_asm_0701(2)_USbeta
BOARD_STEP_ANY_1^HC-SR04_PCB__1__STEP_ANY_ASM_1_ASM_USPCBA_ANY_ASM_1_ASM_USBETA_ANY_ASM_2_ASM_USBETA_ASM_1_ASM_usbeta_asm_0701(2)_USbeta
PRT0002_1^ASM0006_ASM_1_ASM_ASM0005_ASM_1_ASM_USBETA_ANY_ASM_2_ASM_USBETA_ASM_1_ASM_usbeta_asm_0701(2)_USbeta x 2
PRT0003_1^ASM0006_ASM_1_ASM_ASM0005_ASM_1_ASM_USBETA_ANY_ASM_2_ASM_USBETA_ASM_1_ASM_usbeta_asm_0701(2)_USbeta x 2
PRT0004_1^ASM0006_ASM_1_ASM_ASM0005_ASM_1_ASM_USBETA_ANY_ASM_2_ASM_USBETA_ASM_1_ASM_usbeta_asm_0701(2)_USbeta x 2
PRT0005_1^ASM0006_ASM_1_ASM_ASM0005_ASM_1_ASM_USBETA_ANY_ASM_2_ASM_USBETA_ASM_1_ASM_usbeta_asm_0701(2)_USbeta x 2
PRT0010_1^ASM0005_ASM_1_ASM_USBETA_ANY_ASM_2_ASM_USBETA_ASM_1_ASM_usbeta_asm_0701(2)_USbeta
PRT0008_1^ASM0005_ASM_1_ASM_USBETA_ANY_ASM_2_ASM_USBETA_ASM_1_ASM_usbeta_asm_0701(2)_USbeta x 2
PRT0007_1^ASM0005_ASM_1_ASM_USBETA_ANY_ASM_2_ASM_USBETA_ASM_1_ASM_usbeta_asm_0701(2)_USbeta
PRT0011_1^ASM0005_ASM_1_ASM_USBETA_ANY_ASM_2_ASM_USBETA_ASM_1_ASM_usbeta_asm_0701(2)_USbeta
PRT0009_1^ASM0005_ASM_1_ASM_USBETA_ANY_ASM_2_ASM_USBETA_ASM_1_ASM_usbeta_asm_0701(2)_USbeta
RJ45_5721-L_1LAST_VERSION^USBETA_ANY_ASM_2_ASM_USBETA_ASM_1_ASM_usbeta_asm_0701(2)_USbeta
