STEAM-Academy-PRO/revolution-robotics-kit/mechanical parts/WH - Wheels/CW - Caster Wheel/_to_be_sorted/cwbeta_asm-05-19.stp

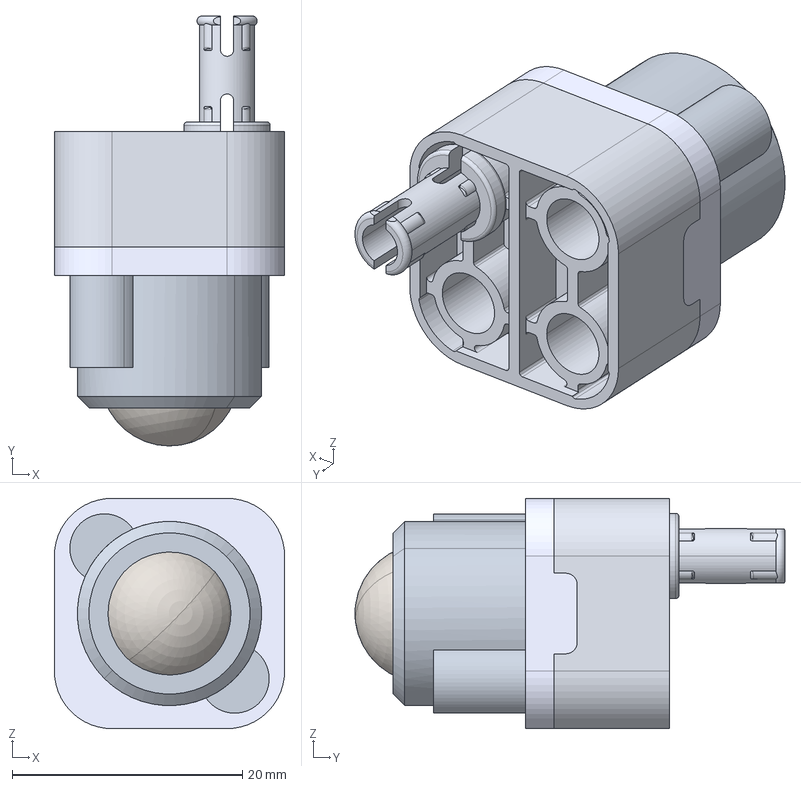
[picture p36: CAD file, 2024-02-20]
mechanical parts/WH - Wheels/CW - Caster Wheel/_to_be_sorted/cwbeta_asm-05-19.stp
20.0 x 37.3 x 20.0 mm
CWBA_1_ANY
CASTER_BODY_STP_ANY
CASTER_BALL_STP_ANY
CWBA_2_ANY
CUT-EXTRUDE1_1_
CUT-EXTRUDE1_2_
_CWBETA
CP1X1
