STEAM-Academy-PRO/revolution-robotics-kit/mechanical parts/WH - Wheels/CW - Caster Wheel/Caster Wheel.SLDASM

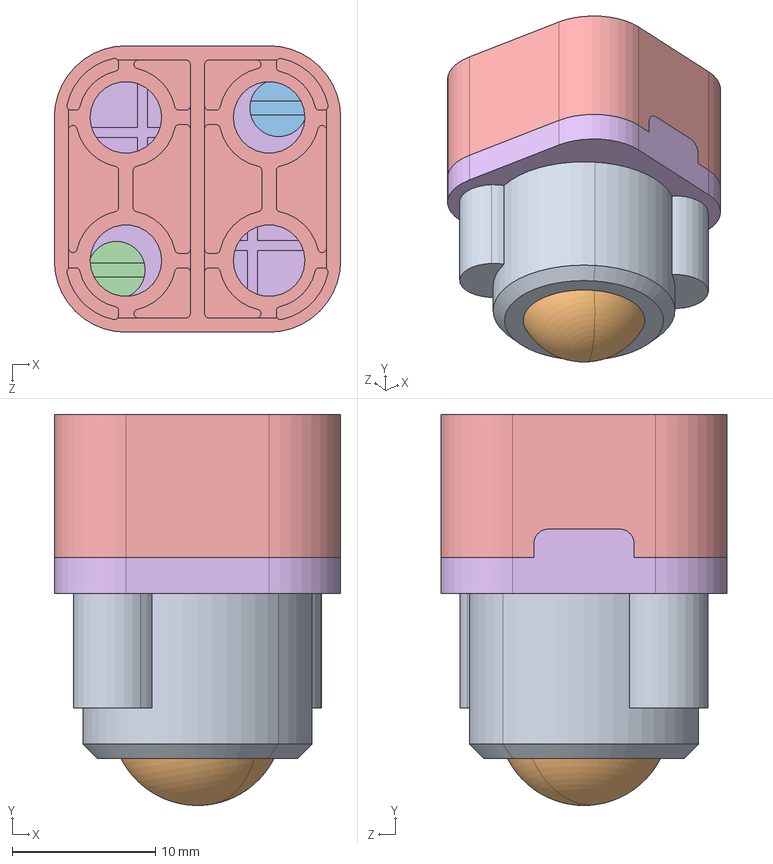
[picture p37: CAD file, 2024-04-02]
mechanical parts/WH - Wheels/CW - Caster Wheel/Caster Wheel.SLDASM
20.0 x 27.3 x 20.0 mm
CASTER_BODY_STP_ANY^CWPA_STP_ANY_ASM_CWPA_ANY_ASM_CWBETA_ANY_ASM_cwbeta_asm(2)_cwbeta_asm
CASTER_BALL_STP_ANY^CWPA_STP_ANY_ASM_CWPA_ANY_ASM_CWBETA_ANY_ASM_cwbeta_asm(2)_cwbeta_asm
CUT-EXTRUDE1_1_^SCREWS_CWBETA_ANY_ASM_CWBETA_ANY_ASM_cwbeta_asm(2)_cwbeta_asm
CUT-EXTRUDE1_2_^SCREWS_CWBETA_ANY_ASM_CWBETA_ANY_ASM_cwbeta_asm(2)_cwbeta_asm
CWBA_1_ANY^CWBETA_ANY_ASM_cwbeta_asm(2)_cwbeta_asm
CWBA_2_ANY^CWBETA_ANY_ASM_cwbeta_asm(2)_cwbeta_asm
