STEAM-Academy-PRO/revolution-robotics-kit/electronic parts/BU - Button Sensor/_to_be_sorted/bubeta_asm-05-21.stp

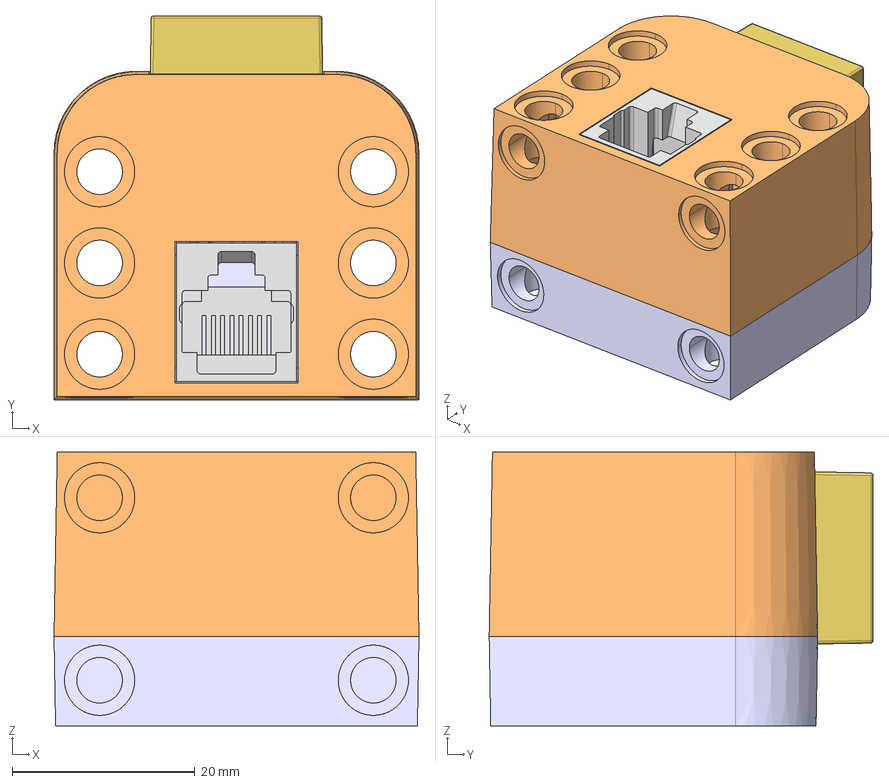
[picture p38: CAD file, 2024-02-20]
electronic parts/BU - Button Sensor/_to_be_sorted/bubeta_asm-05-21.stp
40.0 x 42.0 x 30.0 mm
RESSORT
BUCA_1
BUCA_2
BUMPER_BUTTON
BOARD
ST-1102W-7
RJ45_144-L
BUCA_4
