STEAM-Academy-PRO/revolution-robotics-kit/mechanical parts/WH - Wheels/OW - Omniwheel/Omniwheel/OWr_subbeta.SLDASM

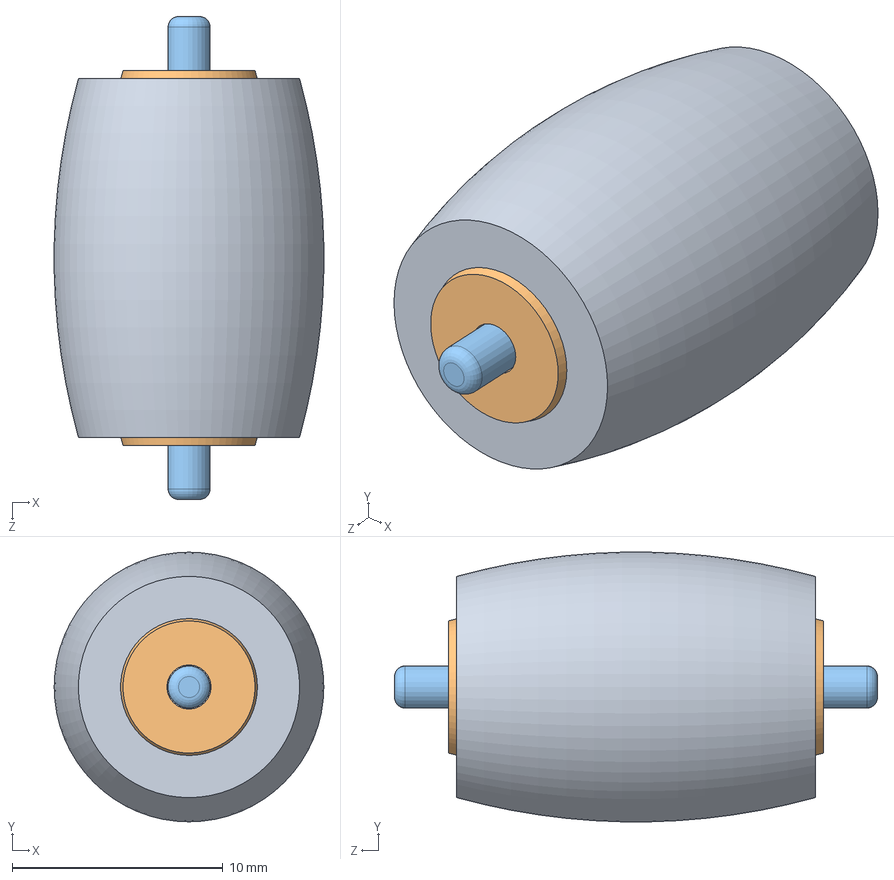
[picture p39: CAD file, 2024-04-02]
mechanical parts/WH - Wheels/OW - Omniwheel/Omniwheel/OWr_subbeta.SLDASM
12.8 x 12.8 x 22.9 mm
OWrR
OWrP
OWrA
