STEAM-Academy-PRO/revolution-robotics-kit/electronic parts/BU - Button Sensor/_to_be_sorted/bubeta_asm-06-25.stp

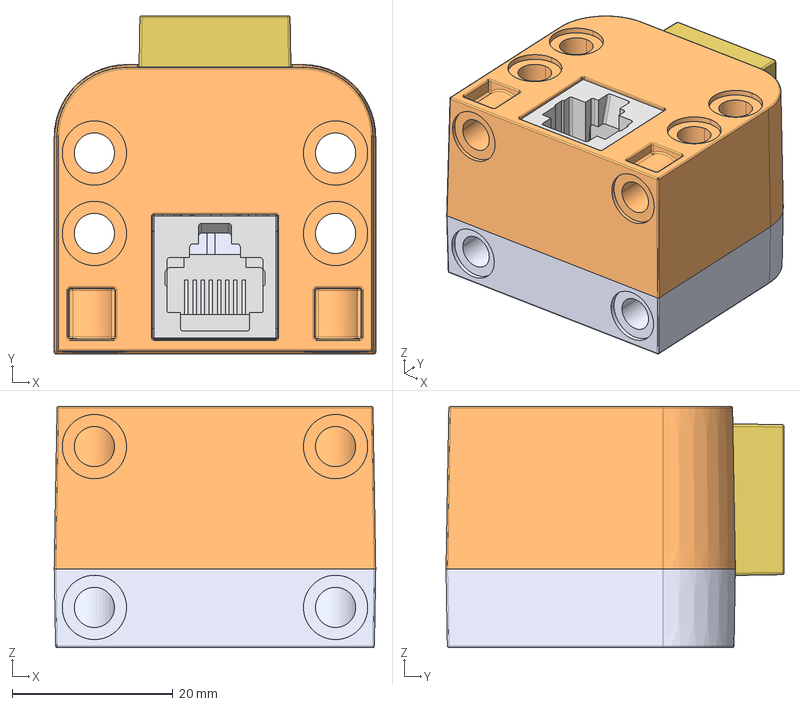
[picture p40: CAD file, 2023-09-20]
electronic parts/BU - Button Sensor/_to_be_sorted/bubeta_asm-06-25.stp
40.0 x 42.0 x 30.0 mm
RESSORT_1LAST_VERSION
BUCA_1
BUCA_2
BUCA_3
BOARD_1LAST_VERSION
ST-1102W-7_1LAST_VERSION
RJ45_5721-L_1LAST_VERSION
BUCA_4_1LAST_VERSION
