STEAM-Academy-PRO/revolution-robotics-kit/accessories/CA - Cables/RJ45-Cable-Plug.SLDPRT

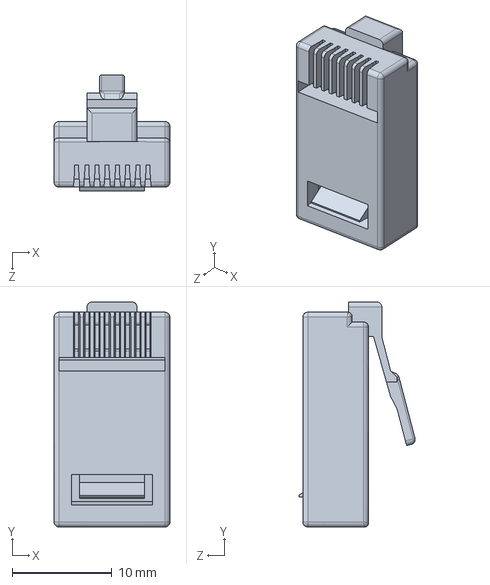
[picture p41: CAD file, 2024-04-02]
accessories/CA - Cables/RJ45-Cable-Plug.SLDPRT
11.6 x 22.5 x 11.6 mm
