STEAM-Academy-PRO/revolution-robotics-kit/accessories/CU - Cups/Cup.sldprt

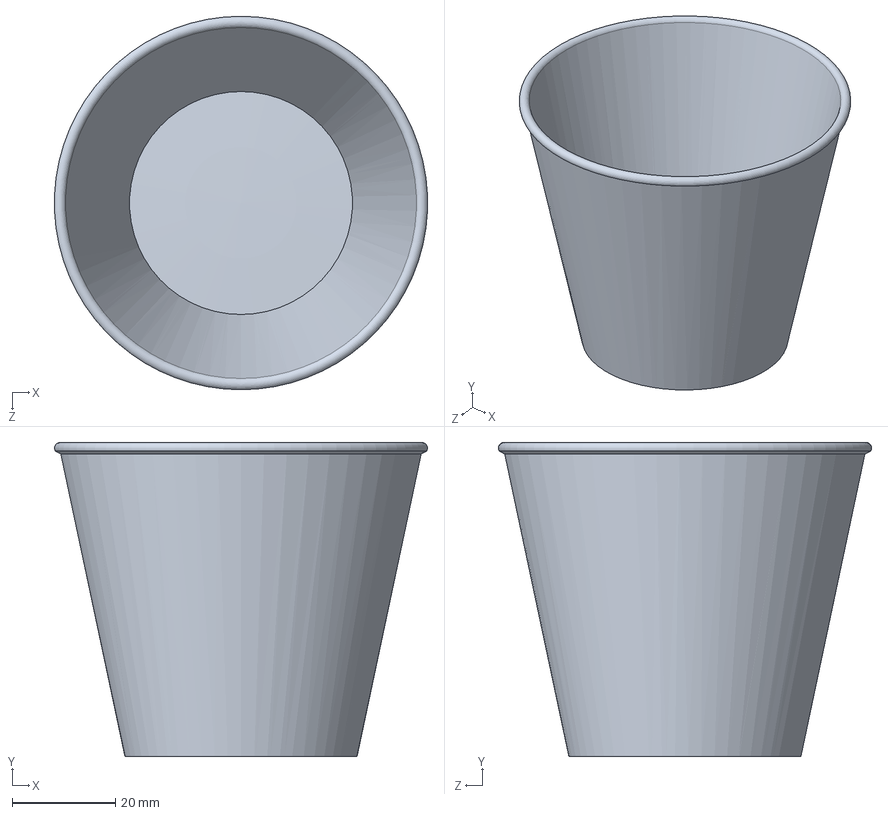
[picture p42: CAD file, 2024-04-02]
accessories/CU - Cups/Cup.sldprt
72.3 x 60.9 x 72.3 mm
