STEAM-Academy-PRO/revolution-robotics-kit/electronic parts/BA - Battery Pack/Battery-pack-v2-production/3D-model/AA-battery.sldprt

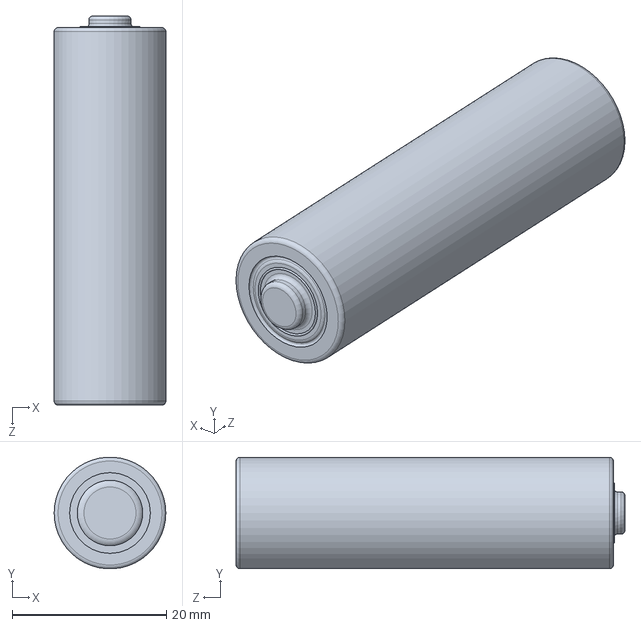
[picture p43: CAD file, 2024-03-27]
electronic parts/BA - Battery Pack/Battery-pack-v2-production/3D-model/AA-battery.sldprt
14.5 x 14.5 x 50.5 mm
