STEAM-Academy-PRO/revolution-robotics-kit/electronic parts/BA - Battery Pack/Battery-pack-v3-development/3D-model/BACA_top.SLDPRT

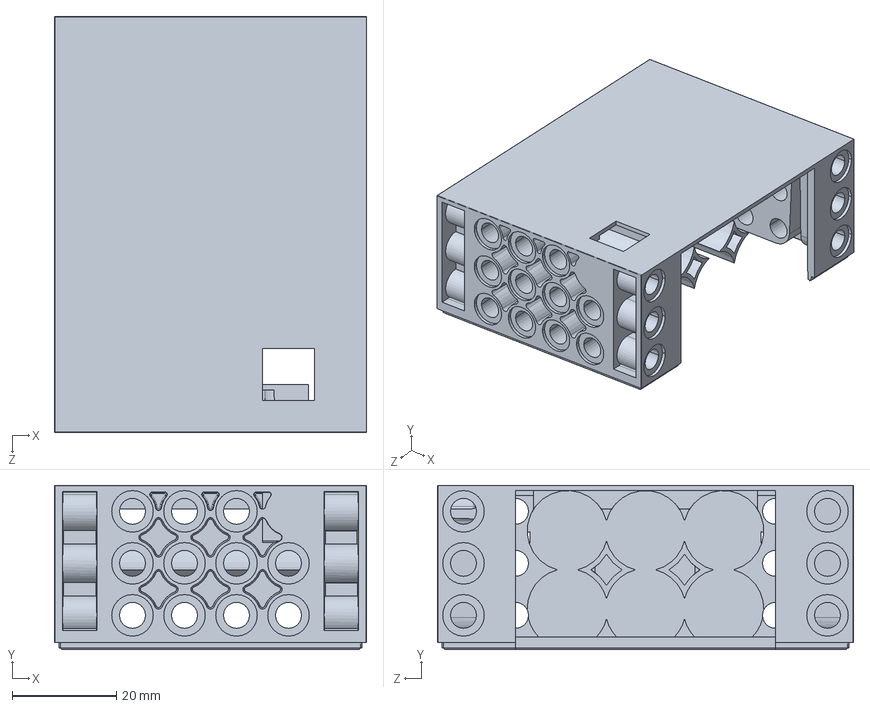
[picture p44: CAD file, 2024-03-27]
electronic parts/BA - Battery Pack/Battery-pack-v3-development/3D-model/BACA_top.SLDPRT
60.0 x 31.6 x 80.0 mm
