STEAM-Academy-PRO/revolution-robotics-kit/electronic parts/BU - Button Sensor/Button-sensor-v1-production/3D-model/Button-sensor-plastic.step

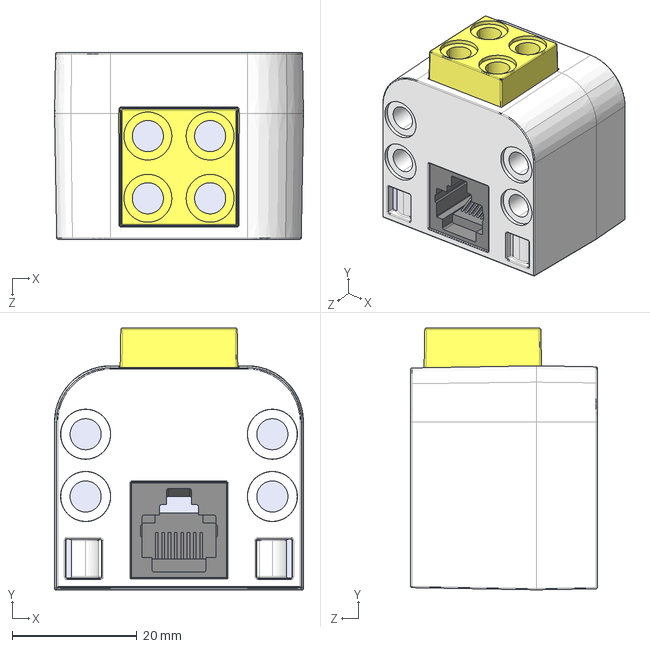
[picture p45: CAD file, 2024-03-27]
electronic parts/BU - Button Sensor/Button-sensor-v1-production/3D-model/Button-sensor-plastic.step
40.0 x 42.0 x 30.0 mm
