STEAM-Academy-PRO/revolution-robotics-kit/electronic parts/BU - Button Sensor/Button-sensor-v2-draft/3D-model/2024-06-13-button-mockup-by-david.STEP

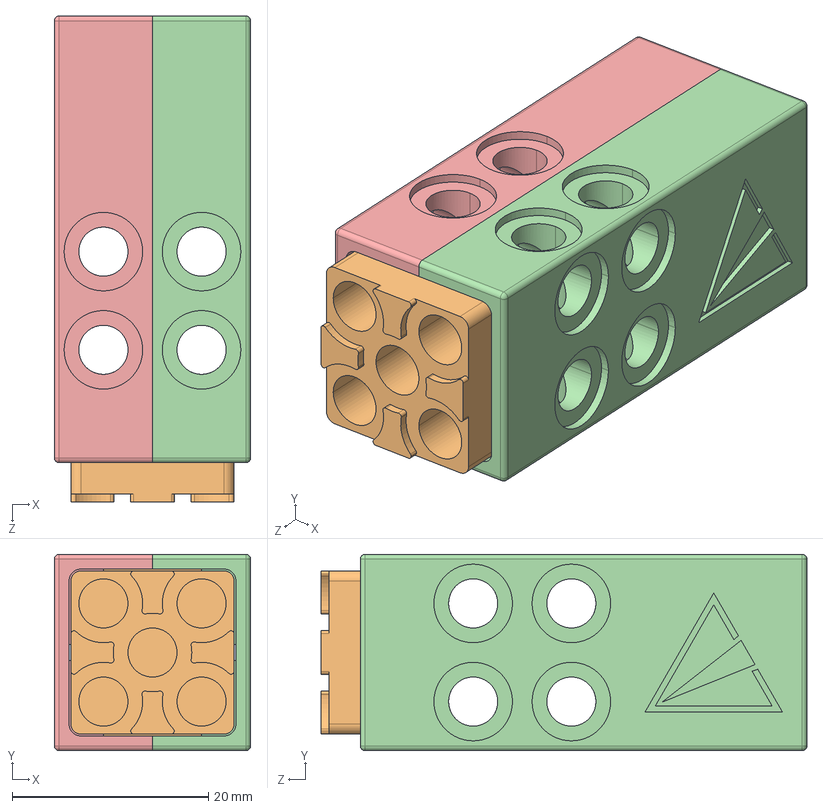
[picture p46: CAD file, 2024-07-08]
electronic parts/BU - Button Sensor/Button-sensor-v2-draft/3D-model/2024-06-13-button-mockup-by-david.STEP
20.0 x 20.0 x 49.5 mm
