STEAM-Academy-PRO/revolution-robotics-kit/electronic parts/CS - Colour Sensor/3D-model/Colour-Sensor.step

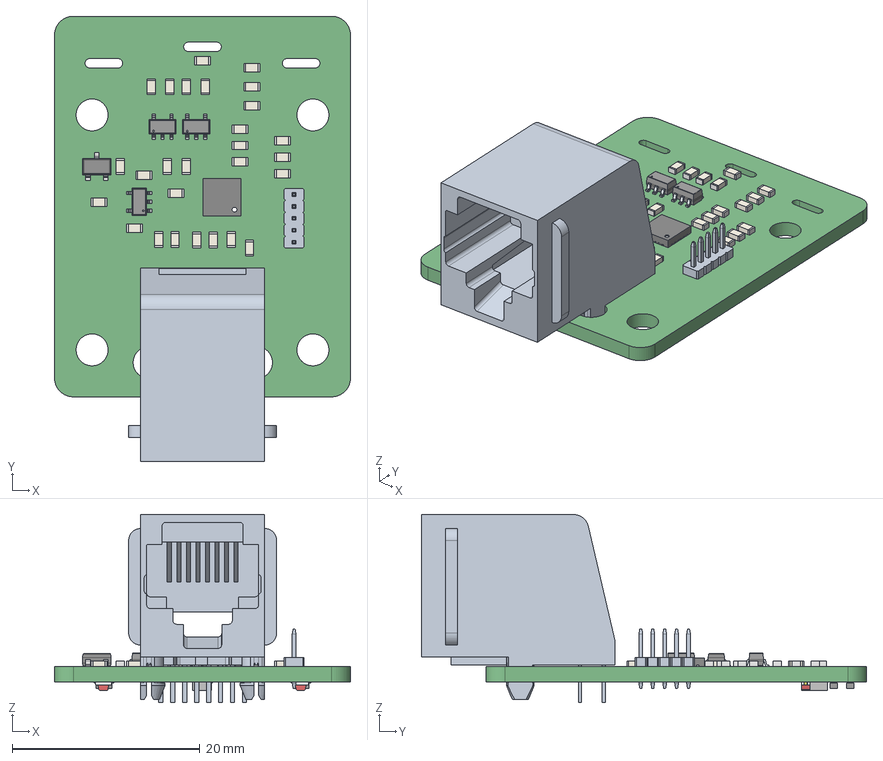
[picture p47: CAD file, 2024-02-20]
electronic parts/CS - Colour Sensor/3D-model/Colour-Sensor.step
31.5 x 47.4 x 20.0 mm
Board
Extruded x 82
('pin',_'1') x 3
('pin',_'2') x 3
Lens x 2
PinsArrayL x 3
PinsArrayR x 3
Open_CASCADE_STEP_translator_6.8_2.1
Open_CASCADE_STEP_translator_6.8_2.2.1
Thermal_Shape
Open_CASCADE_STEP_translator_6.8_2.4.1 x 24
SOT95P255X140-3N
rj45_144-L
SULLINS_GRPB051VWVN-RC
