STEAM-Academy-PRO/revolution-robotics-kit/electronic parts/MO - Motor/_to_be_sorted/motor-top-plastic-玩具装配体20190701.STEP

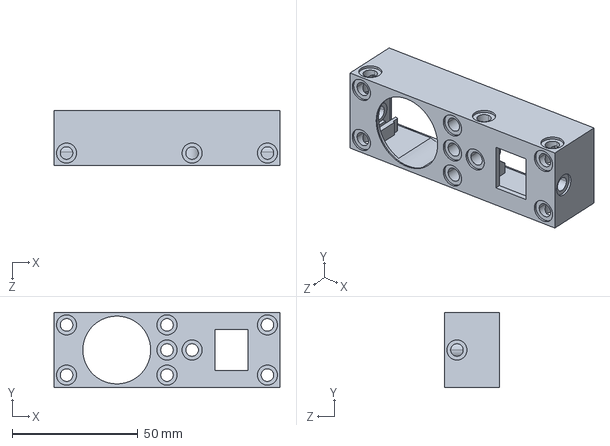
[picture p48: CAD file, 2023-09-20]
electronic parts/MO - Motor/_to_be_sorted/motor-top-plastic-玩具装配体20190701.STEP
90.0 x 30.0 x 22.0 mm
