STEAM-Academy-PRO/revolution-robotics-kit/mechanical parts/AB - Angled Beams/A120/A120.stp

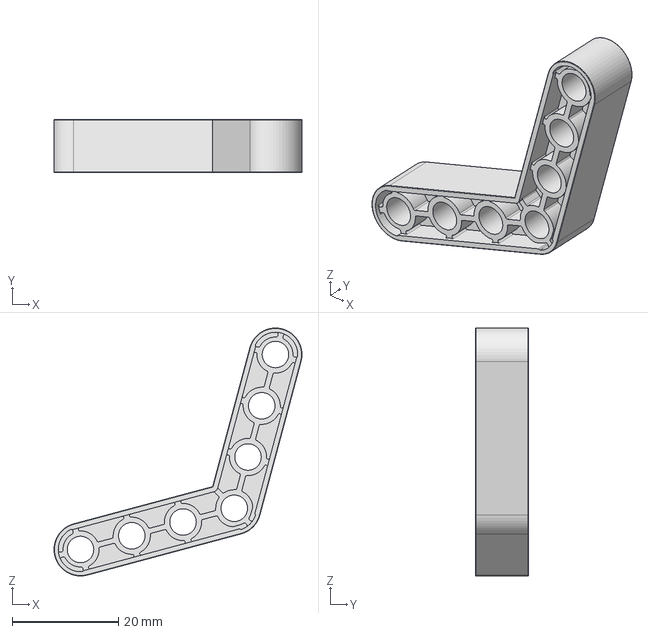
[picture p49: CAD file, 2024-04-02]
mechanical parts/AB - Angled Beams/A120/A120.stp
46.7 x 10.0 x 46.7 mm
