STEAM-Academy-PRO/revolution-robotics-kit/mechanical parts/AB - Angled Beams/A135/A135.stp

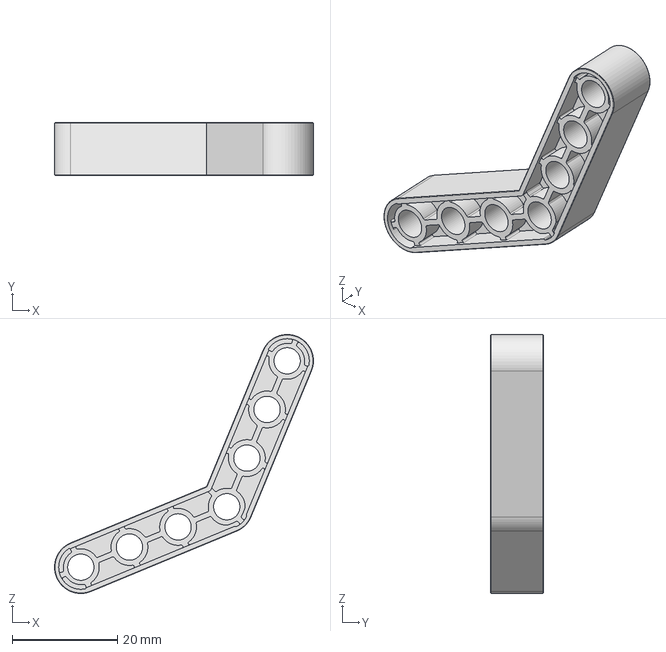
[picture p50: CAD file, 2024-04-02]
mechanical parts/AB - Angled Beams/A135/A135.stp
49.2 x 10.0 x 49.2 mm
