STEAM-Academy-PRO/revolution-robotics-kit/mechanical parts/AB - Angled Beams/A90L/A90L.stp

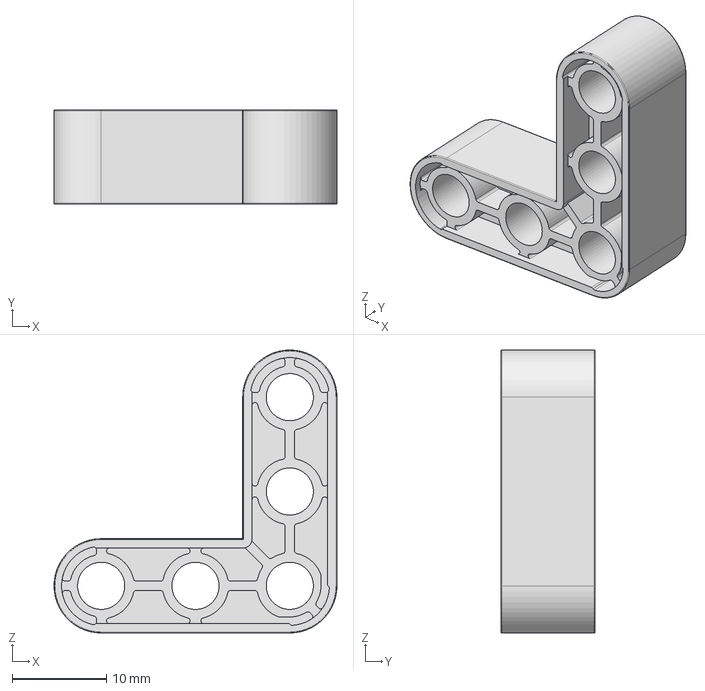
[picture p51: CAD file, 2024-04-02]
mechanical parts/AB - Angled Beams/A90L/A90L.stp
30.0 x 10.0 x 30.0 mm
