STEAM-Academy-PRO/revolution-robotics-kit/mechanical parts/AB - Angled Beams/A90T/A90T.stp

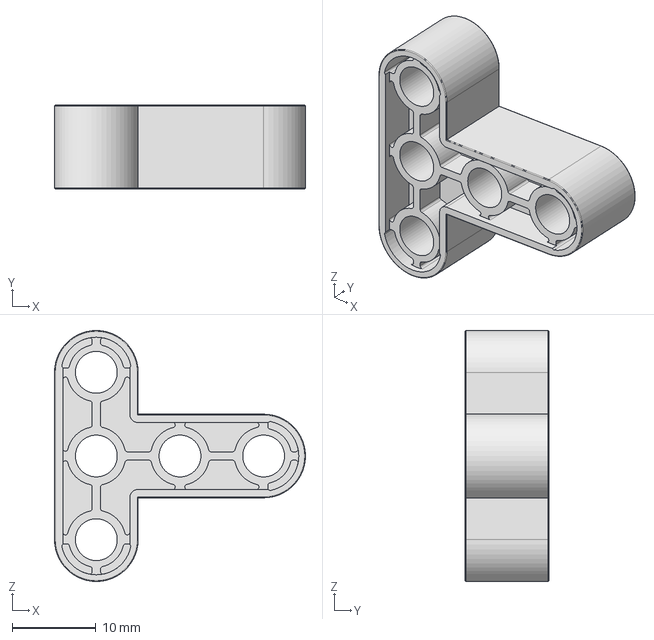
[picture p52: CAD file, 2024-04-02]
mechanical parts/AB - Angled Beams/A90T/A90T.stp
30.0 x 10.0 x 30.0 mm
