STEAM-Academy-PRO/revolution-robotics-kit/mechanical parts/AD - Adapters/Lego adapter/Lego system adapter.SLDPRT

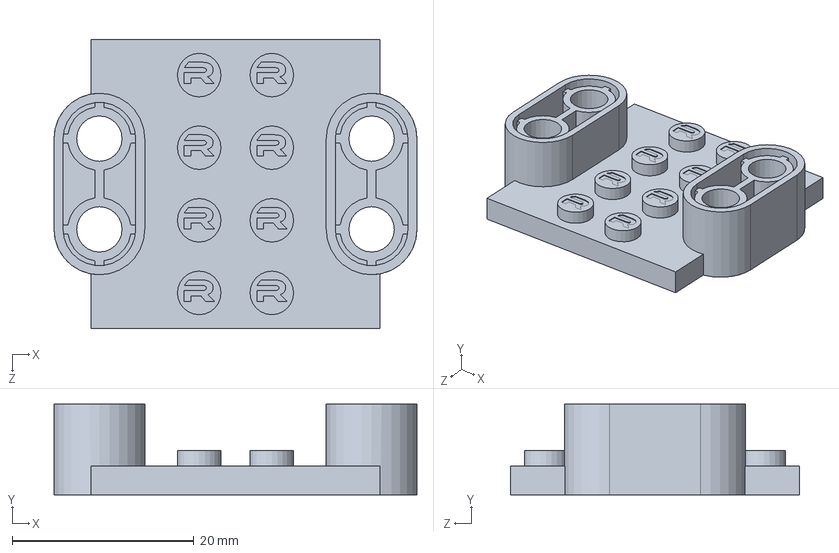
[picture p53: CAD file, 2024-04-02]
mechanical parts/AD - Adapters/Lego adapter/Lego system adapter.SLDPRT
40.0 x 10.0 x 31.8 mm
