STEAM-Academy-PRO/revolution-robotics-kit/mechanical parts/AX - Axles/AXp12s-m/AXp12s-m.stp

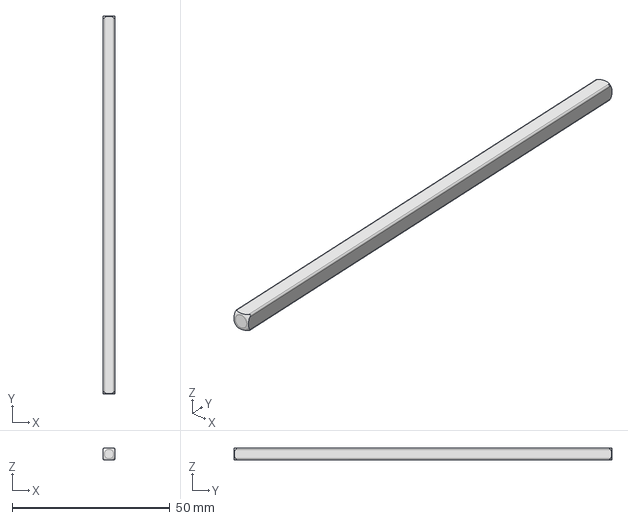
[picture p54: CAD file, 2024-04-02]
mechanical parts/AX - Axles/AXp12s-m/AXp12s-m.stp
3.75 x 120.0 x 3.75 mm
