STEAM-Academy-PRO/revolution-robotics-kit/mechanical parts/AX - Axles/AXp2c/AXp2c.stp

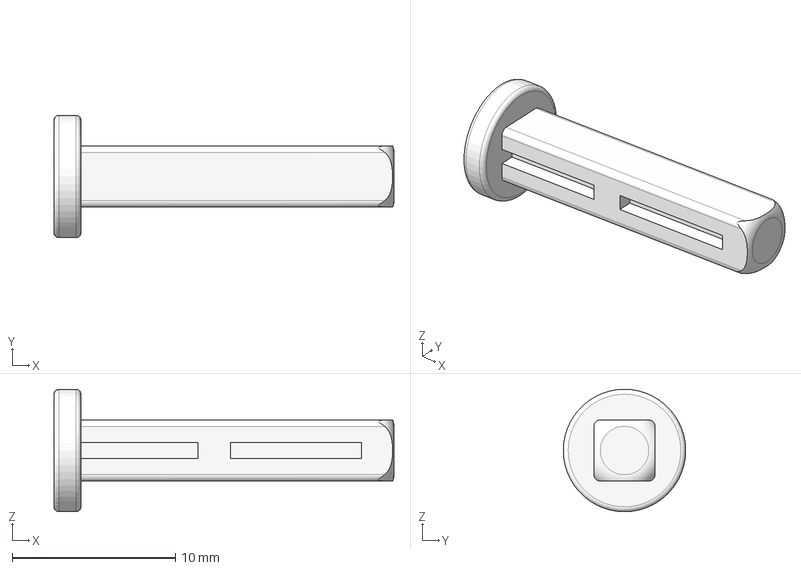
[picture p55: CAD file, 2024-04-02]
mechanical parts/AX - Axles/AXp2c/AXp2c.stp
20.8 x 7.50 x 7.50 mm
