STEAM-Academy-PRO/revolution-robotics-kit/mechanical parts/AX - Axles/AXp2p/AXp2p.stp

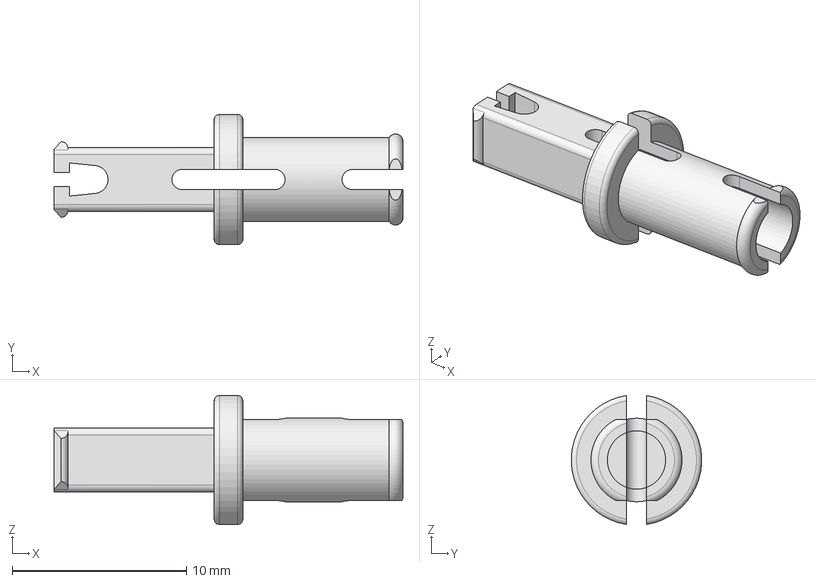
[picture p56: CAD file, 2024-04-02]
mechanical parts/AX - Axles/AXp2p/AXp2p.stp
20.1 x 7.49 x 7.41 mm
