STEAM-Academy-PRO/revolution-robotics-kit/mechanical parts/AX - Axles/AXp3c/AXp3c.stp

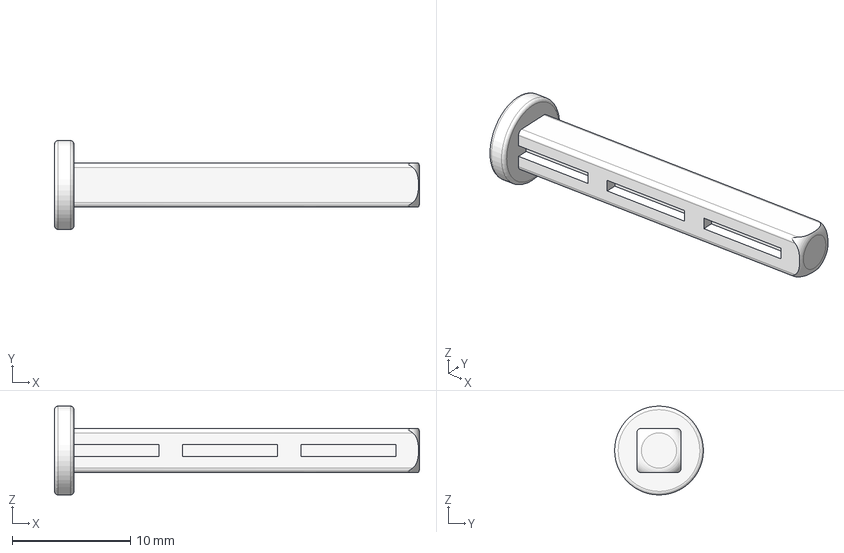
[picture p57: CAD file, 2024-04-02]
mechanical parts/AX - Axles/AXp3c/AXp3c.stp
30.8 x 7.50 x 7.50 mm
