STEAM-Academy-PRO/revolution-robotics-kit/mechanical parts/AX - Axles/AXp4p/AXp4p.stp

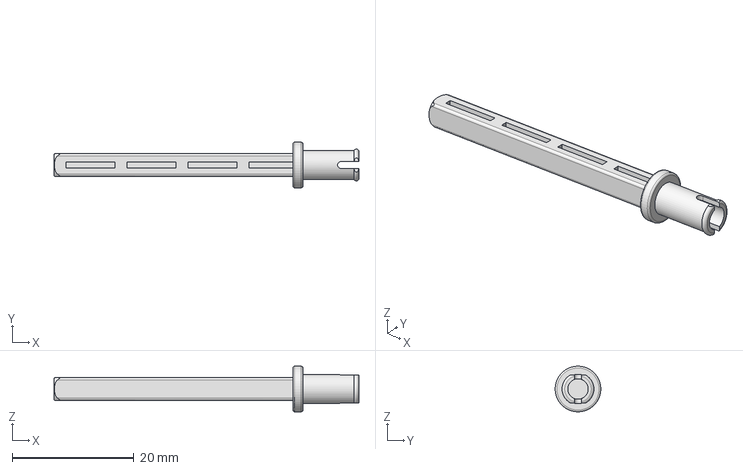
[picture p58: CAD file, 2024-04-02]
mechanical parts/AX - Axles/AXp4p/AXp4p.stp
50.0 x 7.50 x 7.50 mm
