STEAM-Academy-PRO/revolution-robotics-kit/mechanical parts/AX - Axles/AXp4s/AXp4s.stp

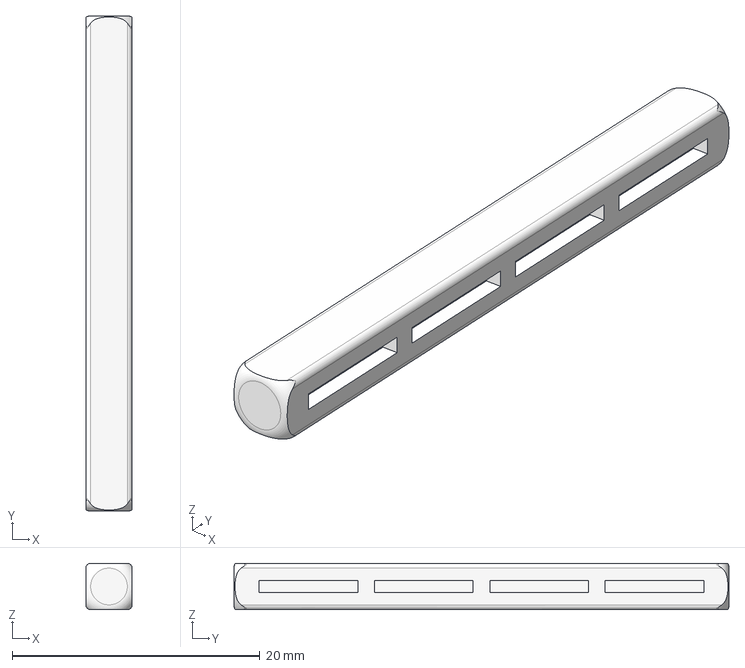
[picture p59: CAD file, 2024-04-02]
mechanical parts/AX - Axles/AXp4s/AXp4s.stp
3.75 x 40.0 x 3.75 mm
