STEAM-Academy-PRO/revolution-robotics-kit/mechanical parts/AX - Axles/AXp6s-m/AXp6s-m.stp

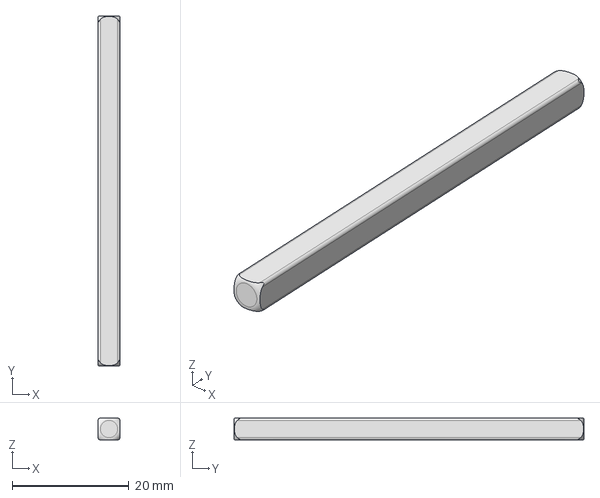
[picture p60: CAD file, 2024-04-02]
mechanical parts/AX - Axles/AXp6s-m/AXp6s-m.stp
3.75 x 60.0 x 3.75 mm
