STEAM-Academy-PRO/revolution-robotics-kit/mechanical parts/AXB - Axle Beams/AXb1/AXb1.stp

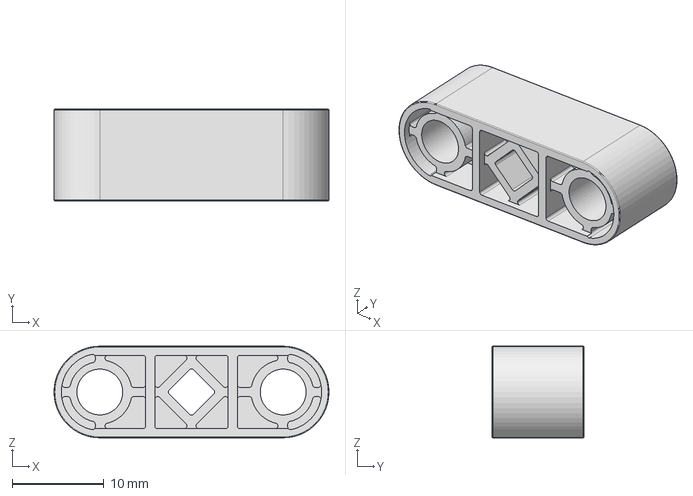
[picture p61: CAD file, 2024-04-02]
mechanical parts/AXB - Axle Beams/AXb1/AXb1.stp
30.0 x 10.0 x 10.0 mm
