STEAM-Academy-PRO/revolution-robotics-kit/mechanical parts/AXB - Axle Beams/AXb3/AXb3.stp

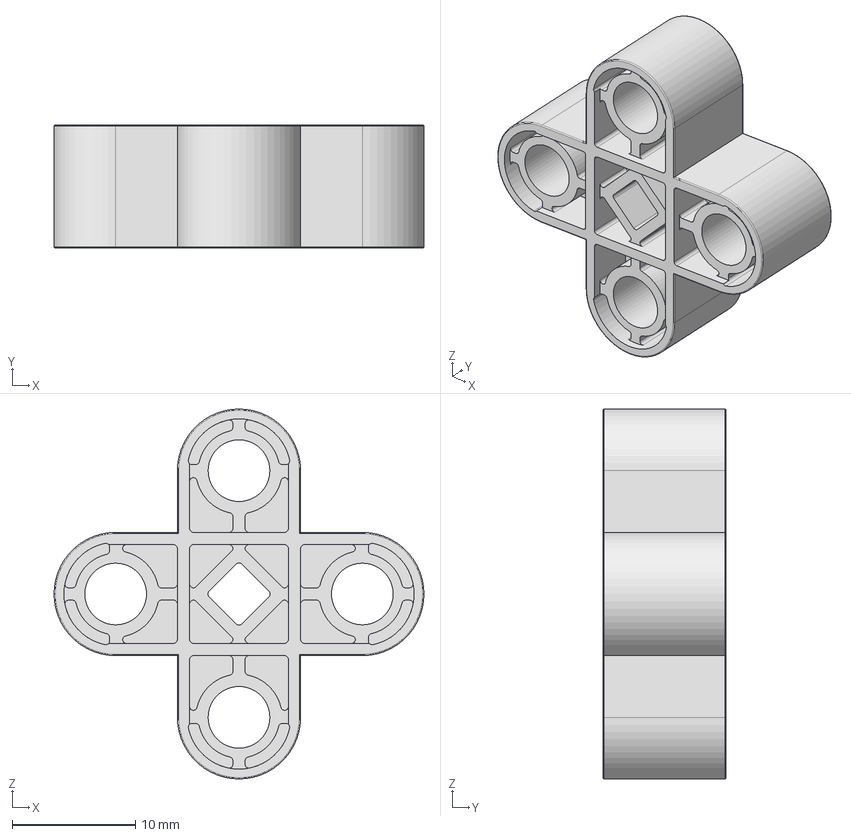
[picture p62: CAD file, 2024-04-02]
mechanical parts/AXB - Axle Beams/AXb3/AXb3.stp
30.0 x 10.0 x 30.0 mm
