STEAM-Academy-PRO/revolution-robotics-kit/mechanical parts/CB - Curved Beams/CB4H/CB4H.stp

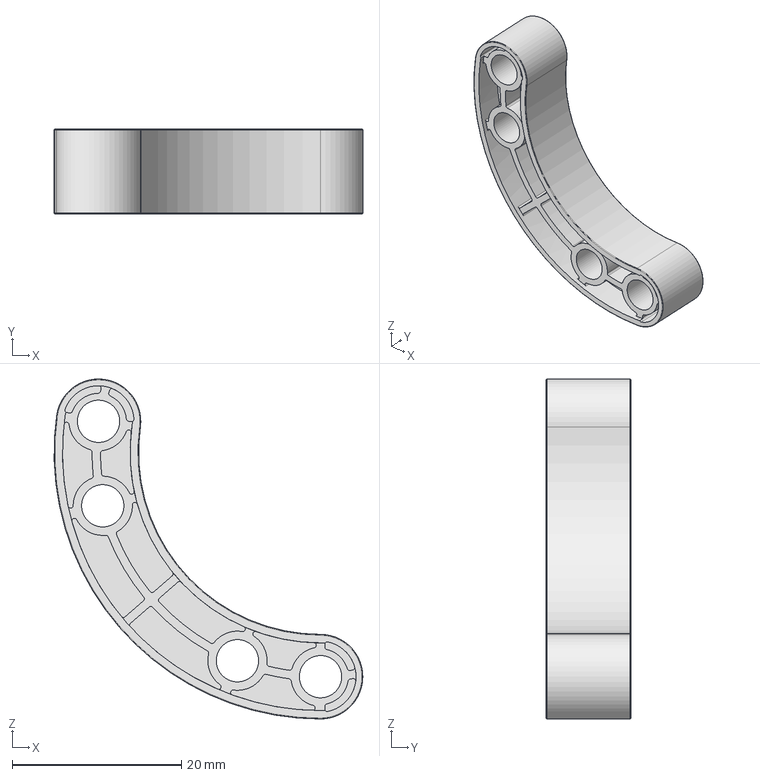
[picture p63: CAD file, 2024-04-02]
mechanical parts/CB - Curved Beams/CB4H/CB4H.stp
36.5 x 10.0 x 40.2 mm
