STEAM-Academy-PRO/revolution-robotics-kit/mechanical parts/CB - Curved Beams/CB6H/CB6H.stp

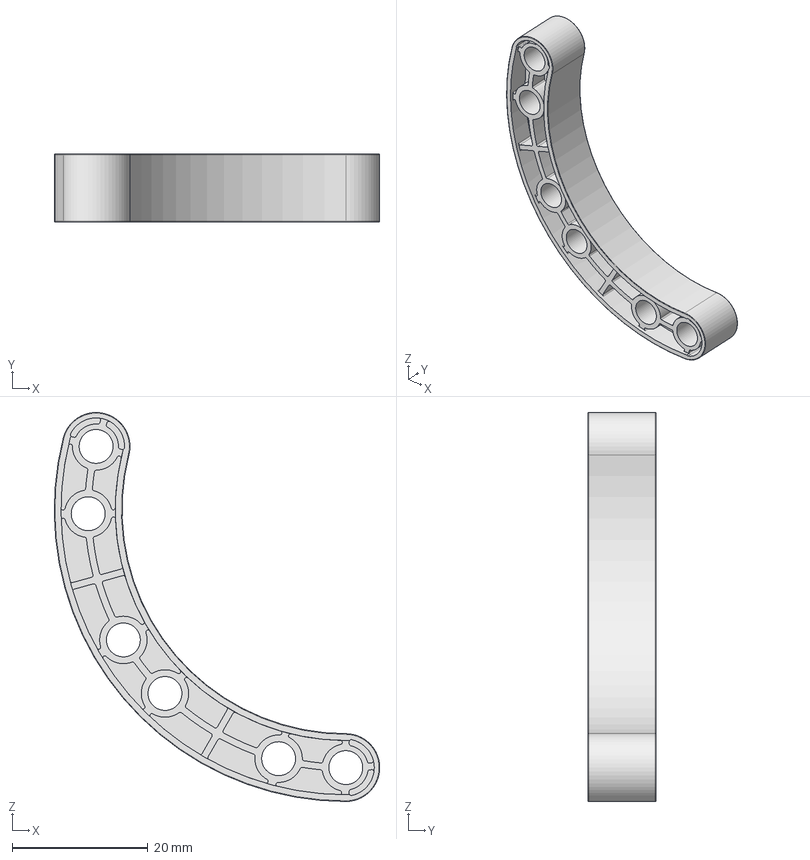
[picture p64: CAD file, 2024-04-02]
mechanical parts/CB - Curved Beams/CB6H/CB6H.stp
48.0 x 10.0 x 57.4 mm
