STEAM-Academy-PRO/revolution-robotics-kit/mechanical parts/CO - Connectors/CC1x1/CC1x1.stp

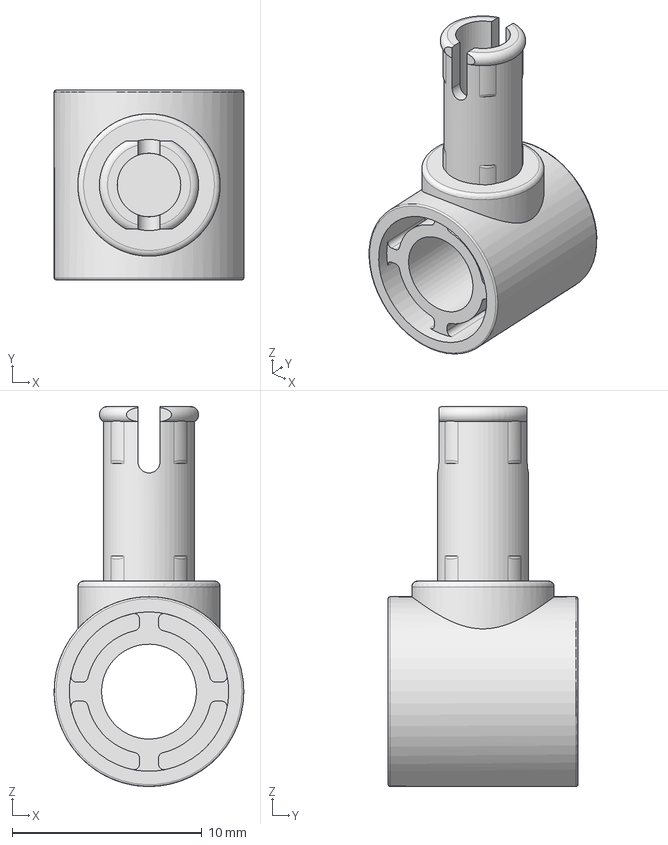
[picture p65: CAD file, 2024-04-02]
mechanical parts/CO - Connectors/CC1x1/CC1x1.stp
10.0 x 10.0 x 20.0 mm
