STEAM-Academy-PRO/revolution-robotics-kit/mechanical parts/CO - Connectors/CC2x1/CC2x1.STEP

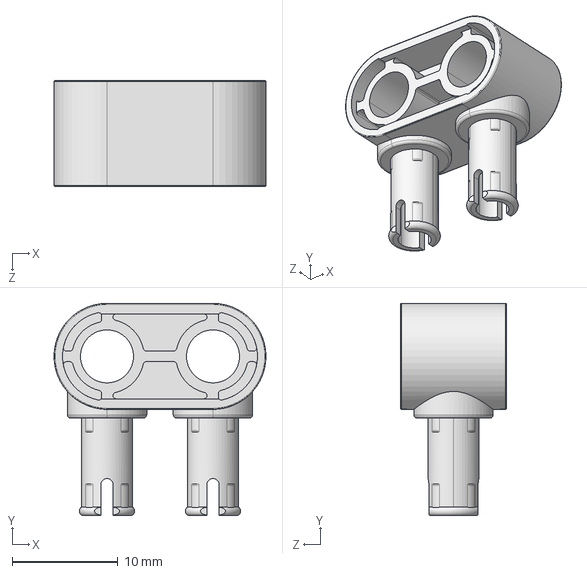
[picture p66: CAD file, 2024-02-20]
mechanical parts/CO - Connectors/CC2x1/CC2x1.STEP
20.0 x 20.0 x 10.0 mm
