STEAM-Academy-PRO/revolution-robotics-kit/mechanical parts/CO - Connectors/CC2x2/CC2x2.stp

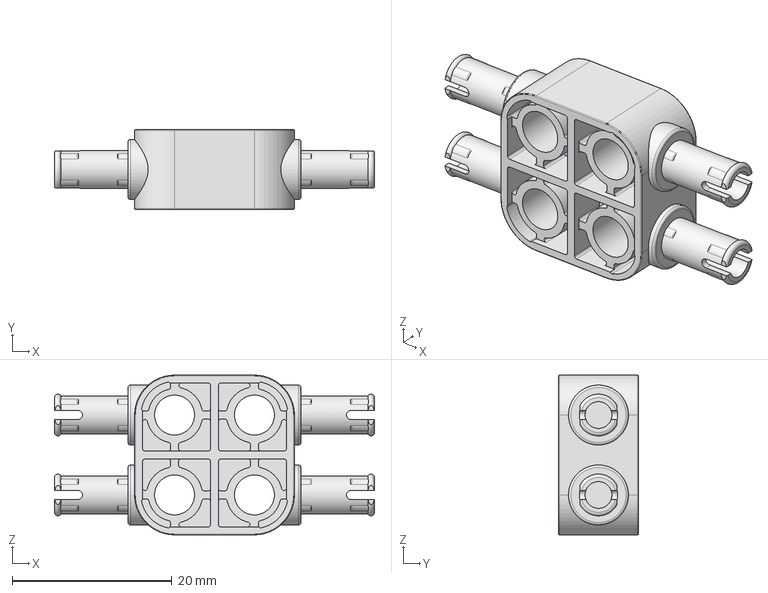
[picture p67: CAD file, 2024-04-02]
mechanical parts/CO - Connectors/CC2x2/CC2x2.stp
40.0 x 10.00 x 20.0 mm
