STEAM-Academy-PRO/revolution-robotics-kit/mechanical parts/CO - Connectors/CT2x2/CT2x2.stp

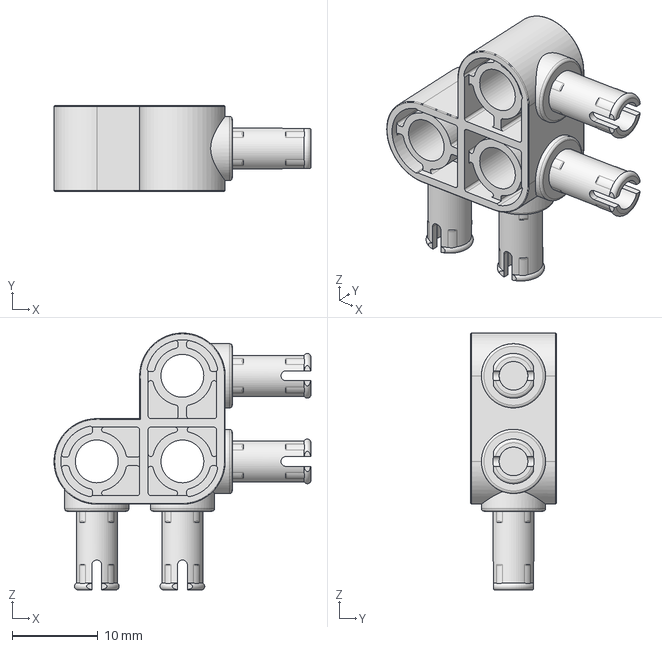
[picture p68: CAD file, 2024-04-02]
mechanical parts/CO - Connectors/CT2x2/CT2x2.stp
30.0 x 10.0 x 30.0 mm
