STEAM-Academy-PRO/revolution-robotics-kit/mechanical parts/GE - Gears/CG40/_to_be_sorted/CG40_china.SLDPRT

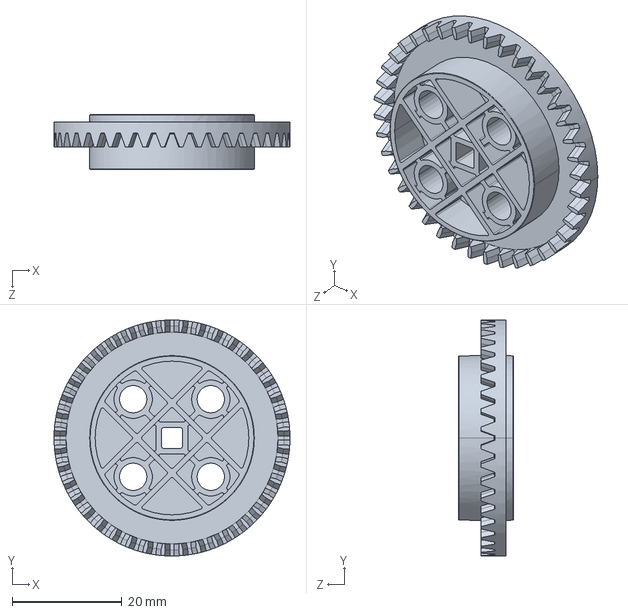
[picture p69: CAD file, 2023-09-20]
mechanical parts/GE - Gears/CG40/_to_be_sorted/CG40_china.SLDPRT
43.0 x 43.0 x 10.0 mm
