STEAM-Academy-PRO/revolution-robotics-kit/mechanical parts/GE - Gears/CG40/Crown.SLDPRT

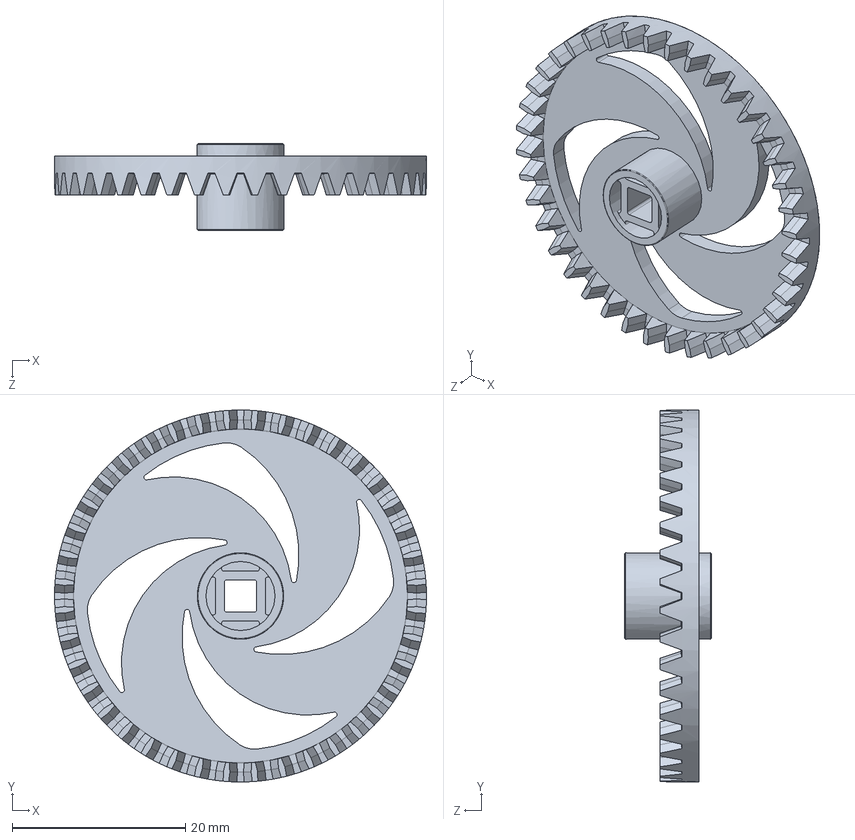
[picture p70: CAD file, 2024-04-02]
mechanical parts/GE - Gears/CG40/Crown.SLDPRT
43.0 x 43.0 x 10.0 mm
