STEAM-Academy-PRO/revolution-robotics-kit/mechanical parts/GE - Gears/EL8/EL8.stp

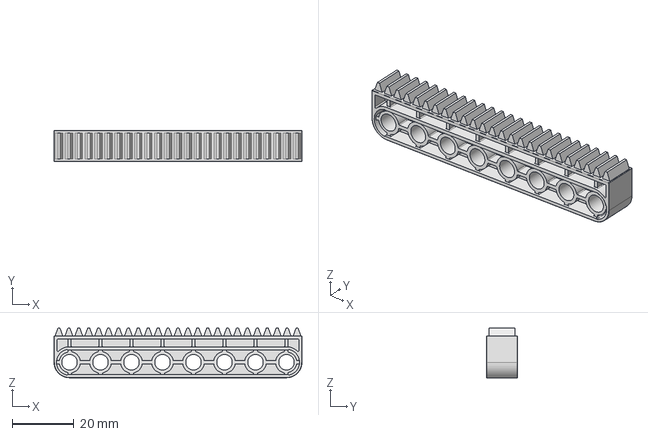
[picture p71: CAD file, 2024-04-02]
mechanical parts/GE - Gears/EL8/EL8.stp
80.0 x 10.0 x 16.0 mm
