STEAM-Academy-PRO/revolution-robotics-kit/mechanical parts/GE - Gears/G20/G20.stp

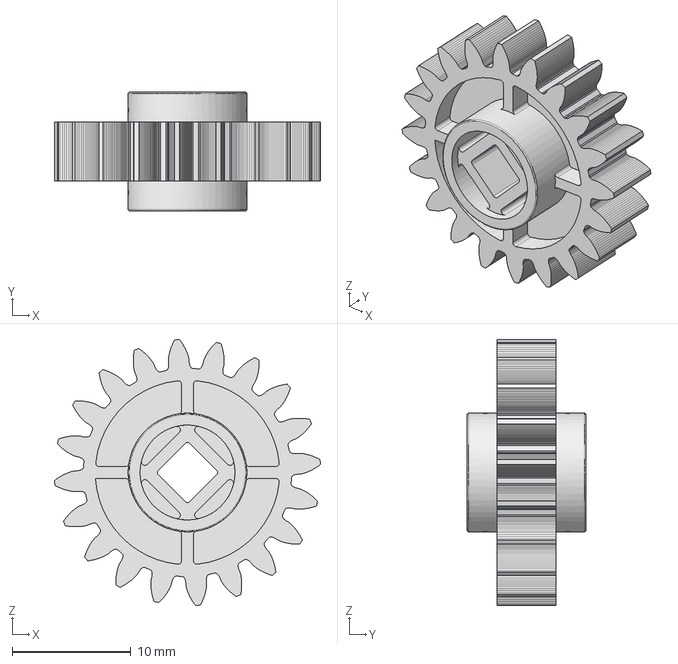
[picture p72: CAD file, 2024-04-02]
mechanical parts/GE - Gears/G20/G20.stp
22.4 x 10.0 x 22.4 mm
