STEAM-Academy-PRO/revolution-robotics-kit/mechanical parts/GE - Gears/G40/G40.stp

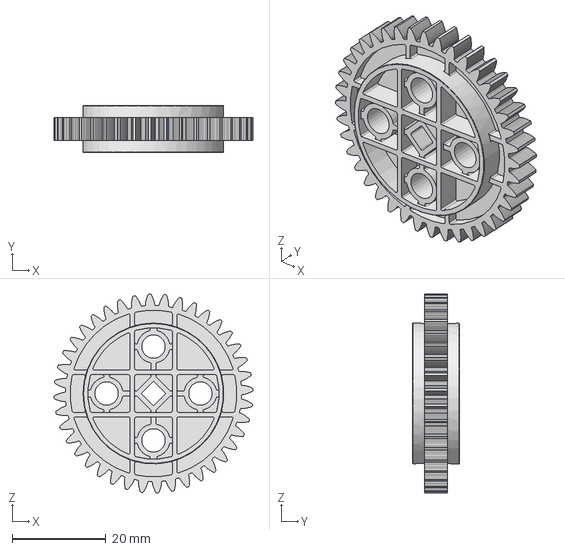
[picture p73: CAD file, 2024-04-02]
mechanical parts/GE - Gears/G40/G40.stp
42.4 x 10.0 x 42.4 mm
