STEAM-Academy-PRO/revolution-robotics-kit/mechanical parts/GE - Gears/G60/G60.stp

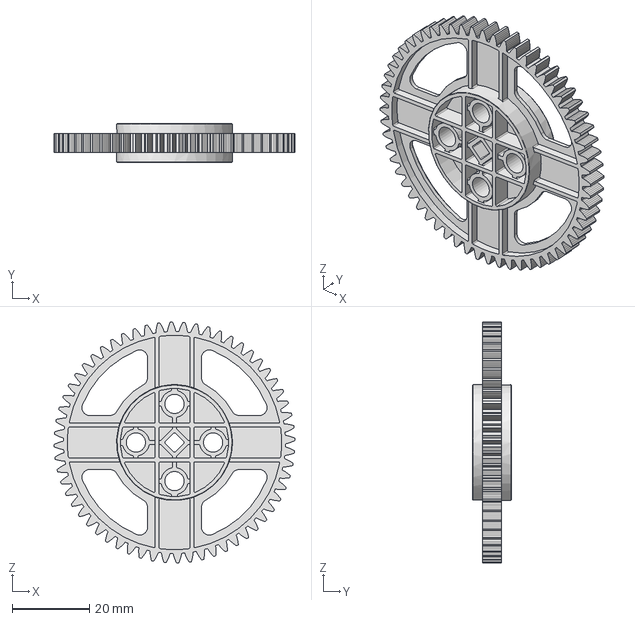
[picture p74: CAD file, 2024-04-02]
mechanical parts/GE - Gears/G60/G60.stp
62.4 x 10.0 x 62.4 mm
