STEAM-Academy-PRO/revolution-robotics-kit/mechanical parts/GE - Gears/WG30/_to_be_sorted/WG30_v2080802.stp

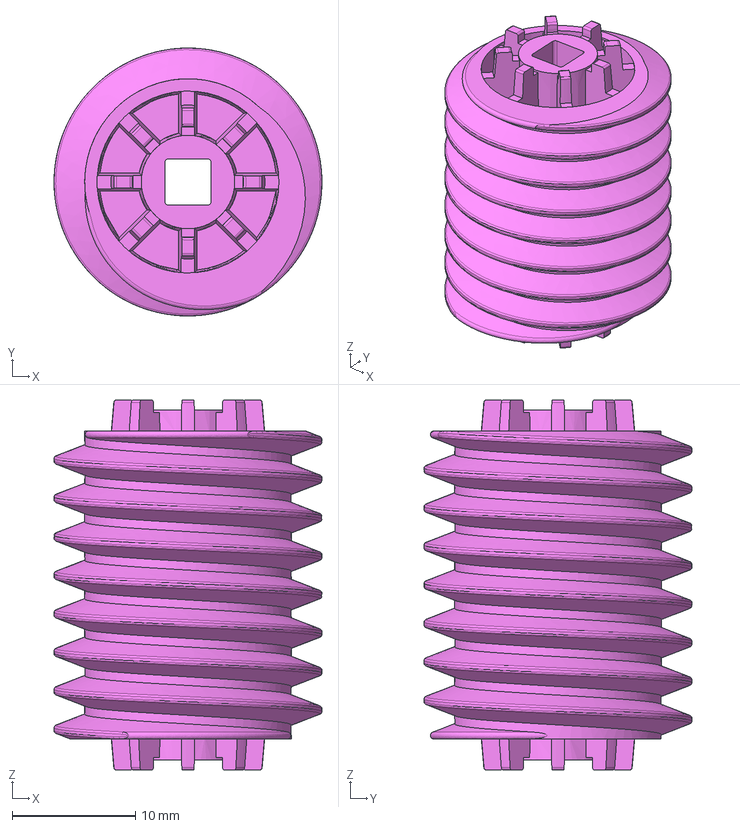
[picture p75: CAD file, 2023-09-20]
mechanical parts/GE - Gears/WG30/_to_be_sorted/WG30_v2080802.stp
21.7 x 21.7 x 30.0 mm
