STEAM-Academy-PRO/revolution-robotics-kit/mechanical parts/PI - Pins/CP1x1/CP1x1.SLDPRT

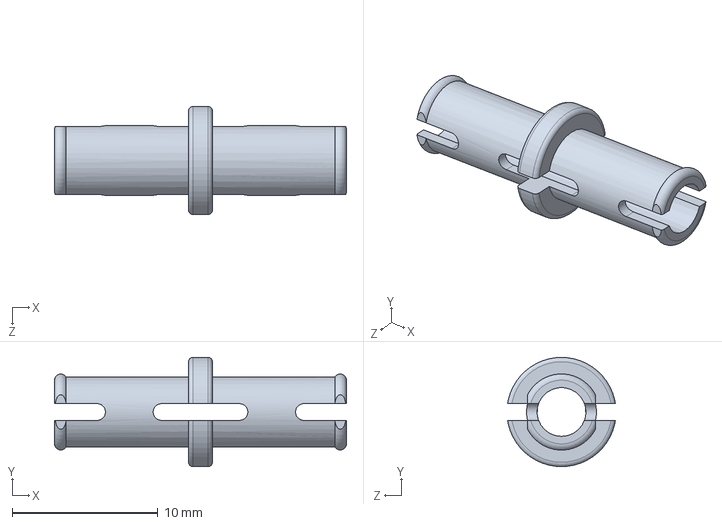
[picture p76: CAD file, 2024-04-02]
mechanical parts/PI - Pins/CP1x1/CP1x1.SLDPRT
20.1 x 7.50 x 7.41 mm
