STEAM-Academy-PRO/revolution-robotics-kit/mechanical parts/PI - Pins/CP2x1/CP2x1_no_anti_skid.stp

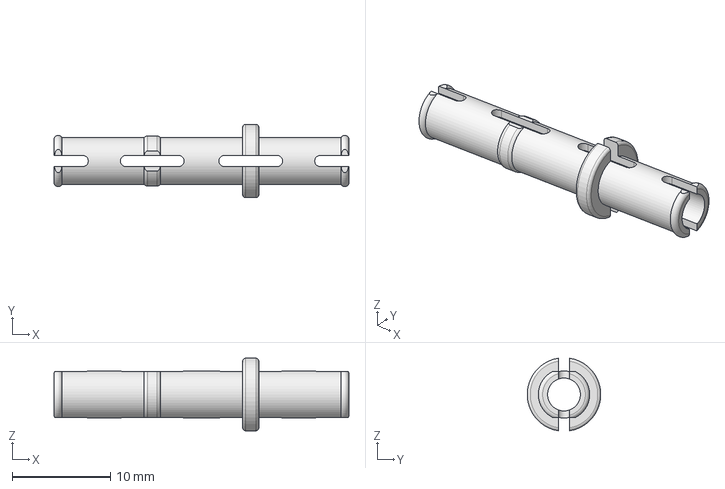
[picture p77: CAD file, 2024-04-02]
mechanical parts/PI - Pins/CP2x1/CP2x1_no_anti_skid.stp
30.1 x 7.49 x 7.41 mm
