STEAM-Academy-PRO/revolution-robotics-kit/mechanical parts/PI - Pins/CP2x2/CP2x2.SLDPRT

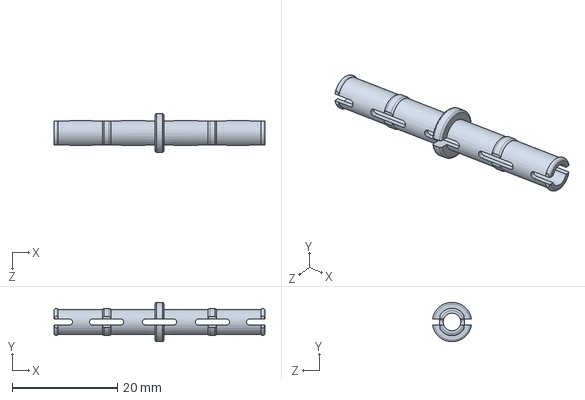
[picture p78: CAD file, 2024-04-02]
mechanical parts/PI - Pins/CP2x2/CP2x2.SLDPRT
40.2 x 7.47 x 7.41 mm
