STEAM-Academy-PRO/revolution-robotics-kit/mechanical parts/PR - Pin Removal/Pin removal tool/3D-printable-version/pin-removal-tool-3D-print.SLDPRT

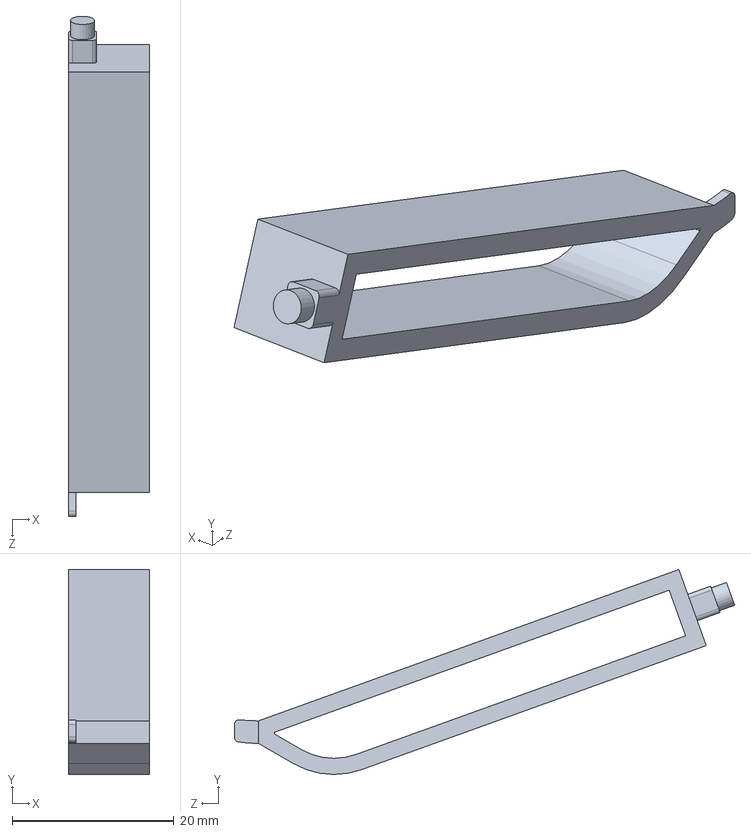
[picture p79: CAD file, 2024-04-02]
mechanical parts/PR - Pin Removal/Pin removal tool/3D-printable-version/pin-removal-tool-3D-print.SLDPRT
10.0 x 25.4 x 61.9 mm
