STEAM-Academy-PRO/revolution-robotics-kit/mechanical parts/RB - Round Beams/RB12/RB12.stp

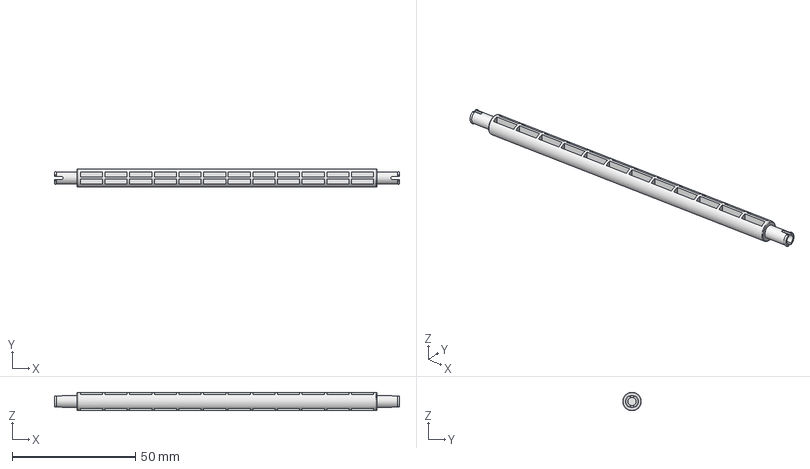
[picture p80: CAD file, 2024-04-02]
mechanical parts/RB - Round Beams/RB12/RB12.stp
140.1 x 7.50 x 7.50 mm
