STEAM-Academy-PRO/revolution-robotics-kit/mechanical parts/RB - Round Beams/RB16/RB16.stp

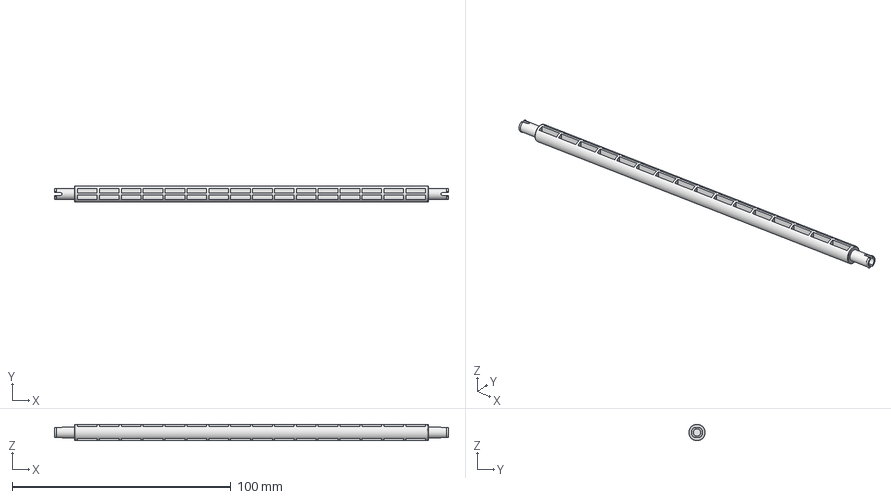
[picture p81: CAD file, 2024-04-02]
mechanical parts/RB - Round Beams/RB16/RB16.stp
180.1 x 7.50 x 7.50 mm
