STEAM-Academy-PRO/revolution-robotics-kit/mechanical parts/RB - Round Beams/RB3/RB3.stp

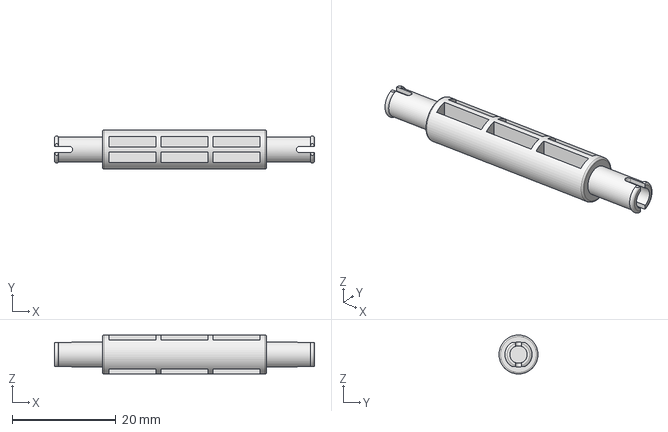
[picture p82: CAD file, 2024-04-02]
mechanical parts/RB - Round Beams/RB3/RB3.stp
50.0 x 7.50 x 7.50 mm
