STEAM-Academy-PRO/revolution-robotics-kit/mechanical parts/RB - Round Beams/RB4/RB4.stp

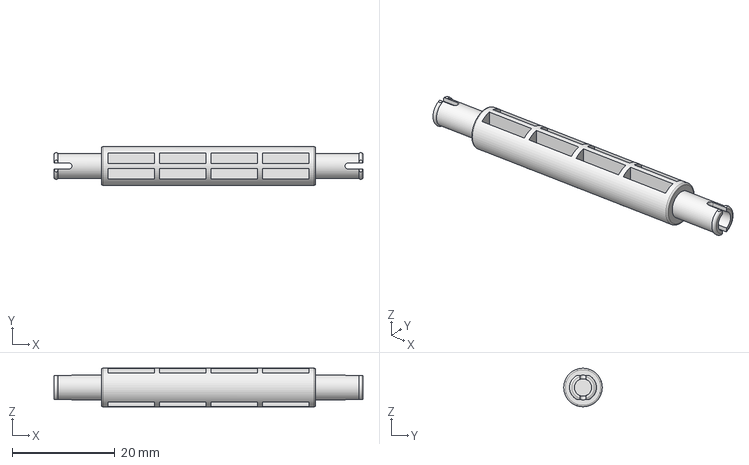
[picture p83: CAD file, 2024-04-02]
mechanical parts/RB - Round Beams/RB4/RB4.stp
60.0 x 7.50 x 7.50 mm
