STEAM-Academy-PRO/revolution-robotics-kit/mechanical parts/RB - Round Beams/RB8/RB8.stp

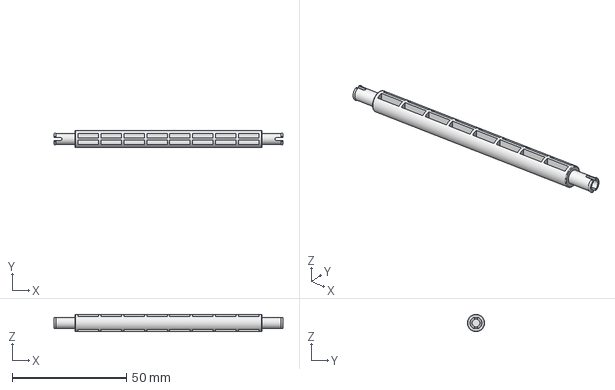
[picture p84: CAD file, 2024-04-02]
mechanical parts/RB - Round Beams/RB8/RB8.stp
100.1 x 7.50 x 7.50 mm
