STEAM-Academy-PRO/revolution-robotics-kit/mechanical parts/SB - Straight Beams/S1x1/S1x1.stp

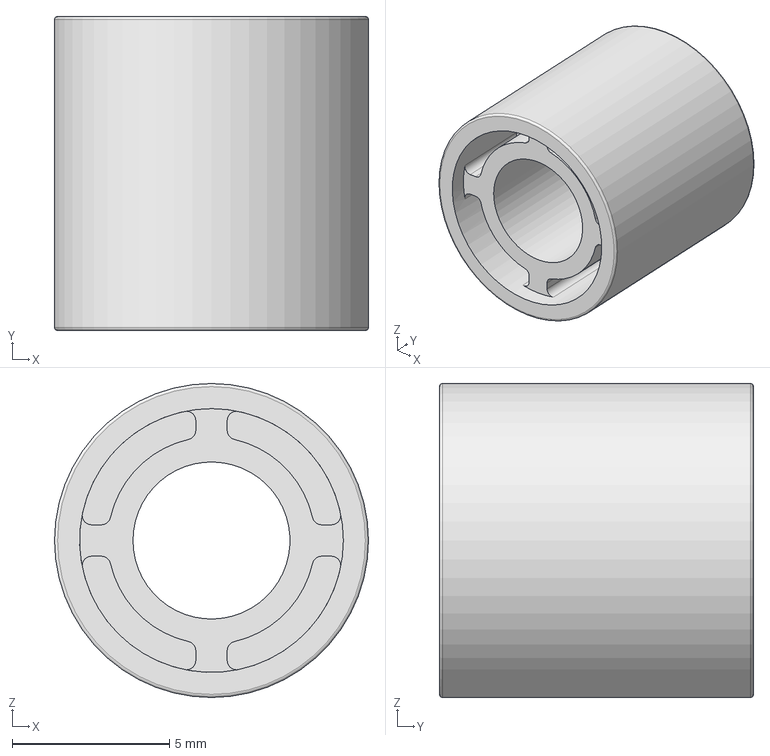
[picture p85: CAD file, 2024-04-02]
mechanical parts/SB - Straight Beams/S1x1/S1x1.stp
10.0 x 10.0 x 10.0 mm
