STEAM-Academy-PRO/revolution-robotics-kit/mechanical parts/SB - Straight Beams/S1x12/S1x12.stp

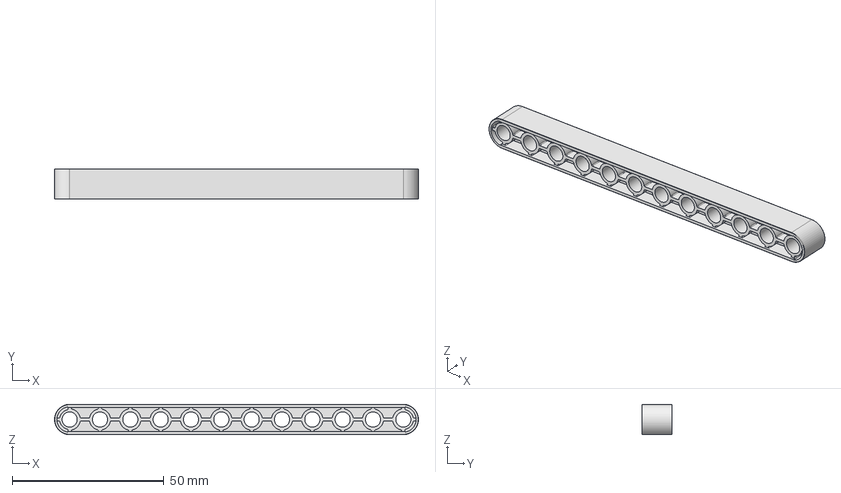
[picture p86: CAD file, 2024-04-02]
mechanical parts/SB - Straight Beams/S1x12/S1x12.stp
120.0 x 10.0 x 10.0 mm
