STEAM-Academy-PRO/revolution-robotics-kit/mechanical parts/SB - Straight Beams/S1x16/S1x16.stp

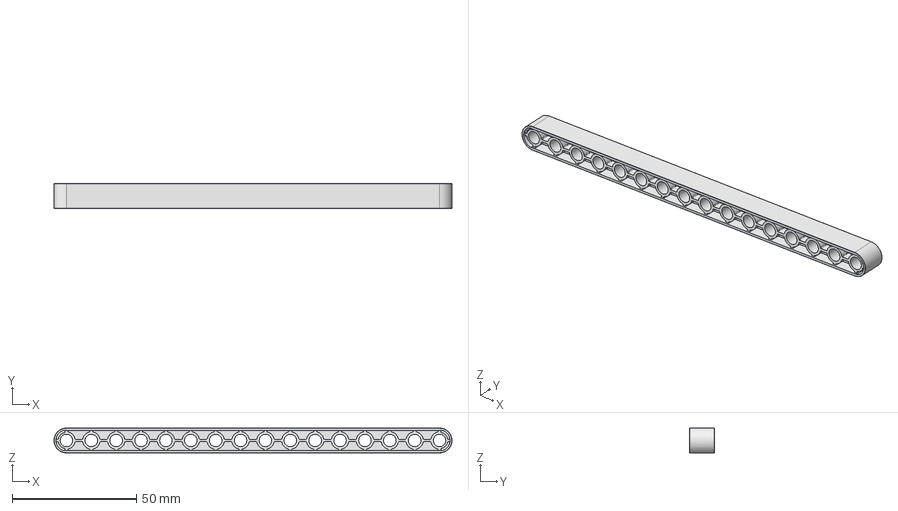
[picture p87: CAD file, 2024-04-02]
mechanical parts/SB - Straight Beams/S1x16/S1x16.stp
160.0 x 10.0 x 10.0 mm
