STEAM-Academy-PRO/revolution-robotics-kit/mechanical parts/SB - Straight Beams/S1x2/S1x2.stp

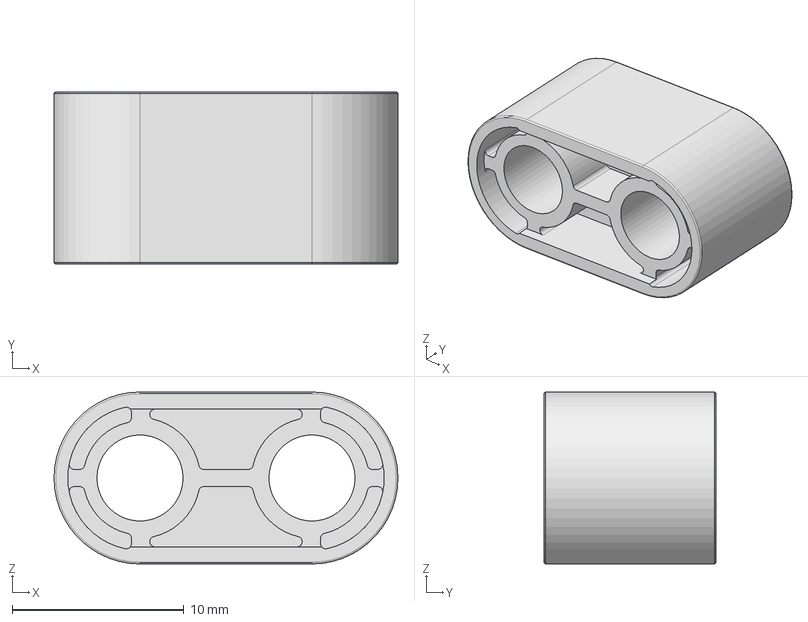
[picture p88: CAD file, 2024-04-02]
mechanical parts/SB - Straight Beams/S1x2/S1x2.stp
20.0 x 10.0 x 10.0 mm
