STEAM-Academy-PRO/revolution-robotics-kit/mechanical parts/SB - Straight Beams/S1x3/S1x3.stp

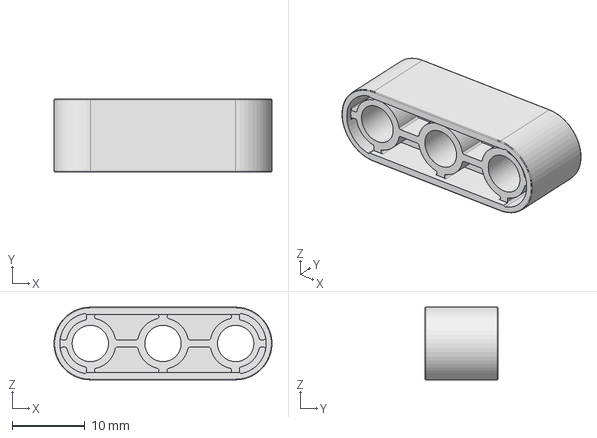
[picture p89: CAD file, 2024-04-02]
mechanical parts/SB - Straight Beams/S1x3/S1x3.stp
30.0 x 10.0 x 10.0 mm
