STEAM-Academy-PRO/revolution-robotics-kit/mechanical parts/SB - Straight Beams/S1x4/S1x4.stp

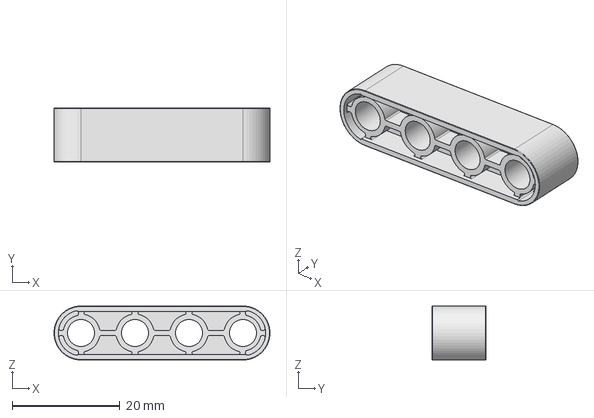
[picture p90: CAD file, 2024-04-02]
mechanical parts/SB - Straight Beams/S1x4/S1x4.stp
40.0 x 10.0 x 10.0 mm
