STEAM-Academy-PRO/revolution-robotics-kit/mechanical parts/SB - Straight Beams/S1x5/S1x5.stp

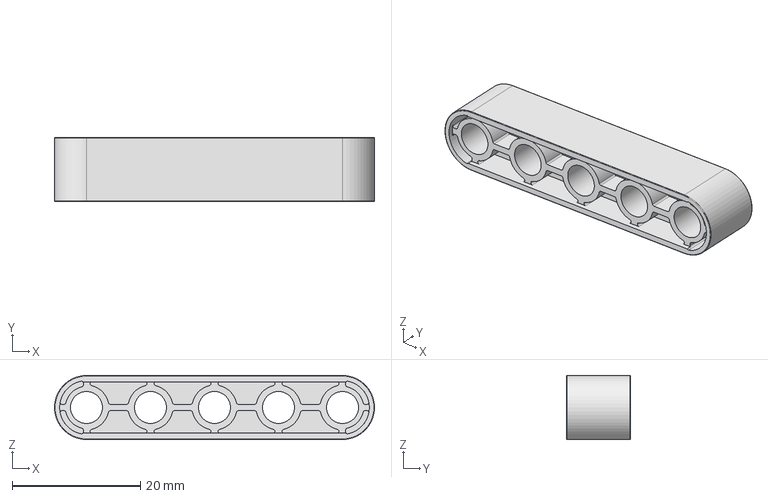
[picture p91: CAD file, 2024-04-02]
mechanical parts/SB - Straight Beams/S1x5/S1x5.stp
50.0 x 10.0 x 10.0 mm
