STEAM-Academy-PRO/revolution-robotics-kit/mechanical parts/SB - Straight Beams/S1x8/S1x8.stp

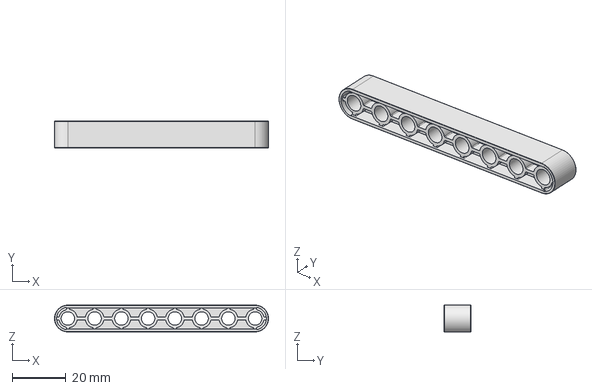
[picture p92: CAD file, 2024-04-02]
mechanical parts/SB - Straight Beams/S1x8/S1x8.stp
80.0 x 10.0 x 10.0 mm
