STEAM-Academy-PRO/revolution-robotics-kit/mechanical parts/SB - Straight Beams/S2x10/S2x10.stp

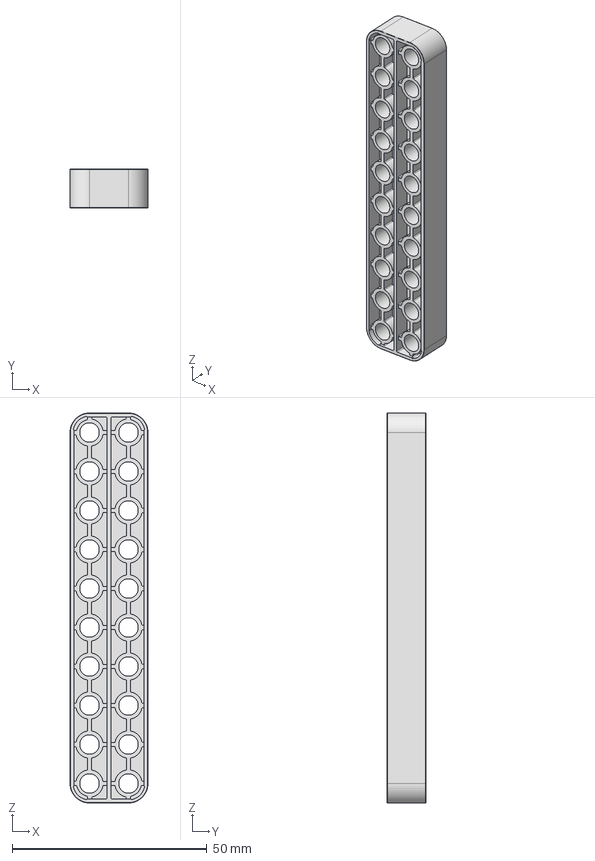
[picture p93: CAD file, 2024-04-02]
mechanical parts/SB - Straight Beams/S2x10/S2x10.stp
20.0 x 10.0 x 100.0 mm
