STEAM-Academy-PRO/revolution-robotics-kit/mechanical parts/SB - Straight Beams/S2x18/S2x18.stp

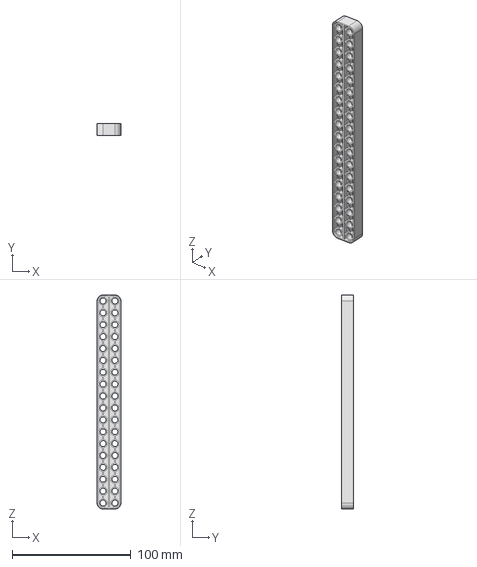
[picture p94: CAD file, 2024-04-02]
mechanical parts/SB - Straight Beams/S2x18/S2x18.stp
20.0 x 10.0 x 180.0 mm
