STEAM-Academy-PRO/revolution-robotics-kit/mechanical parts/SB - Straight Beams/S2x24/S2x24.stp

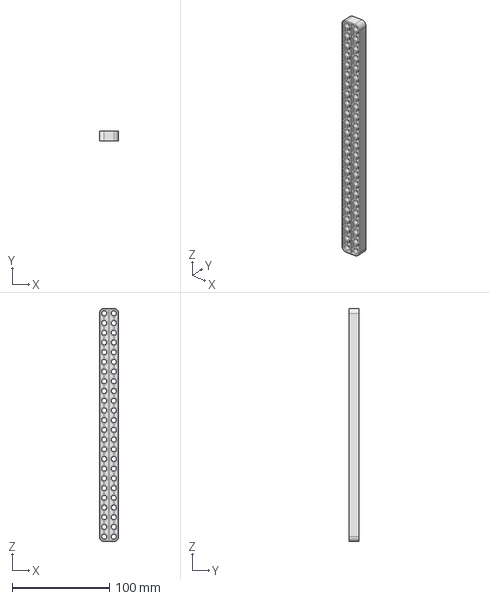
[picture p95: CAD file, 2024-04-02]
mechanical parts/SB - Straight Beams/S2x24/S2x24.stp
20.0 x 10.0 x 240.0 mm
