STEAM-Academy-PRO/revolution-robotics-kit/mechanical parts/SB - Straight Beams/S2x4/S2x4.stp

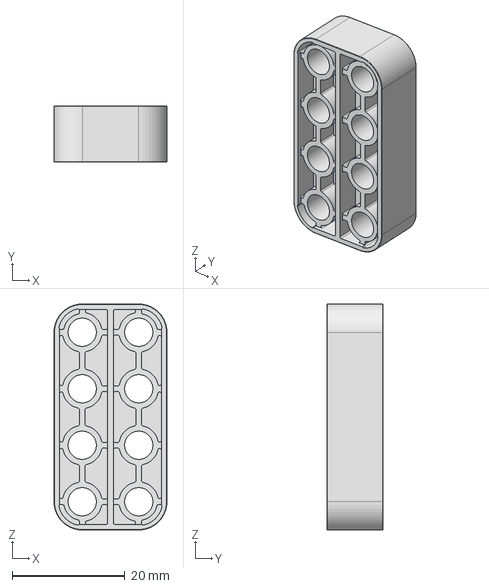
[picture p96: CAD file, 2024-04-02]
mechanical parts/SB - Straight Beams/S2x4/S2x4.stp
20.0 x 10.0 x 40.0 mm
