STEAM-Academy-PRO/revolution-robotics-kit/mechanical parts/SB - Straight Beams/S2x6/S2x6.stp

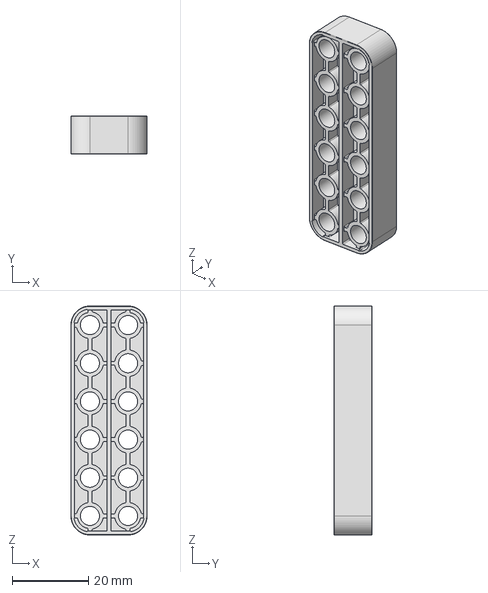
[picture p97: CAD file, 2024-04-02]
mechanical parts/SB - Straight Beams/S2x6/S2x6.stp
20.0 x 10.0 x 60.0 mm
