STEAM-Academy-PRO/revolution-robotics-kit/mechanical parts/SB - Straight Beams/S2x8/S2x8.stp

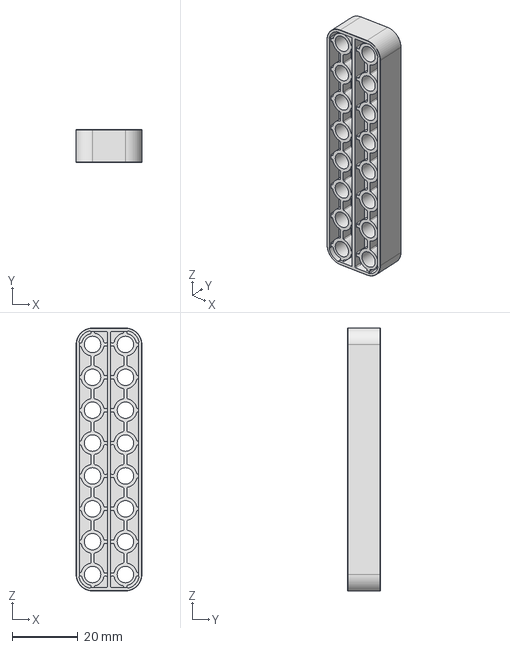
[picture p98: CAD file, 2024-04-02]
mechanical parts/SB - Straight Beams/S2x8/S2x8.stp
20.0 x 10.0 x 80.0 mm
