STEAM-Academy-PRO/revolution-robotics-kit/mechanical parts/SB - Straight Beams/S3x4/S3x4.stp

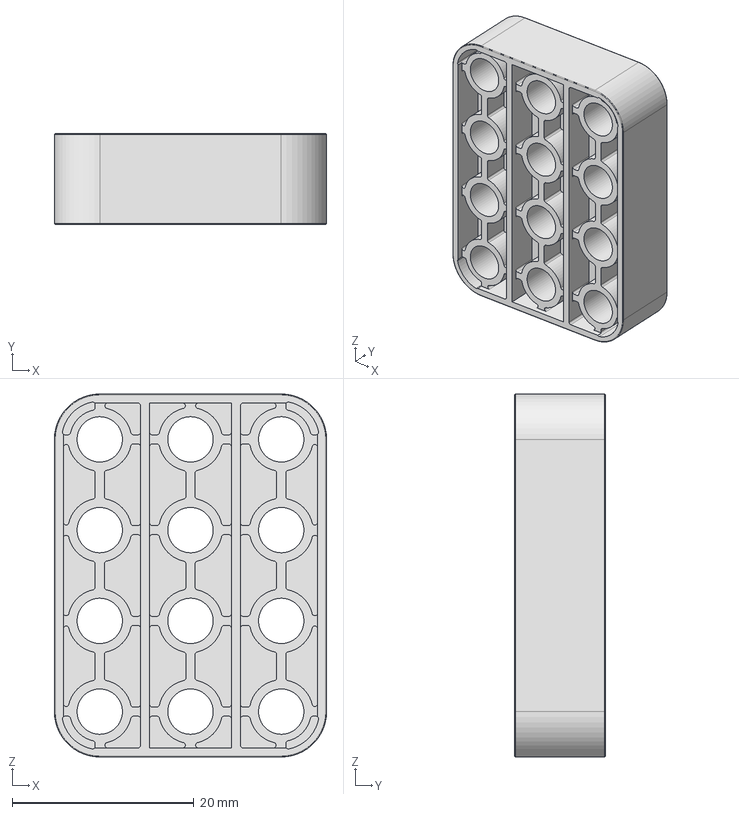
[picture p99: CAD file, 2024-04-02]
mechanical parts/SB - Straight Beams/S3x4/S3x4.stp
30.0 x 10.0 x 40.0 mm
