STEAM-Academy-PRO/revolution-robotics-kit/mechanical parts/SB - Straight Beams/S4x4/S4x4.stp

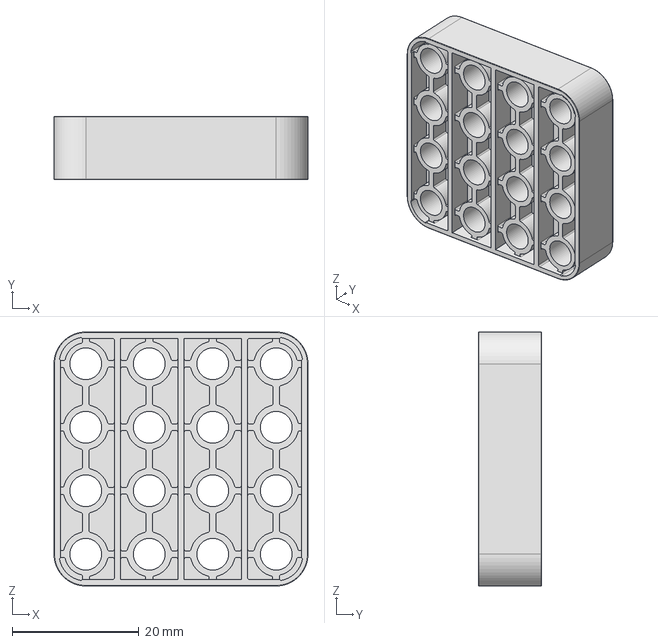
[picture p100: CAD file, 2024-04-02]
mechanical parts/SB - Straight Beams/S4x4/S4x4.stp
40.0 x 10.0 x 40.0 mm
