STEAM-Academy-PRO/revolution-robotics-kit/mechanical parts/SB - Straight Beams/S4x8/S4x8.stp

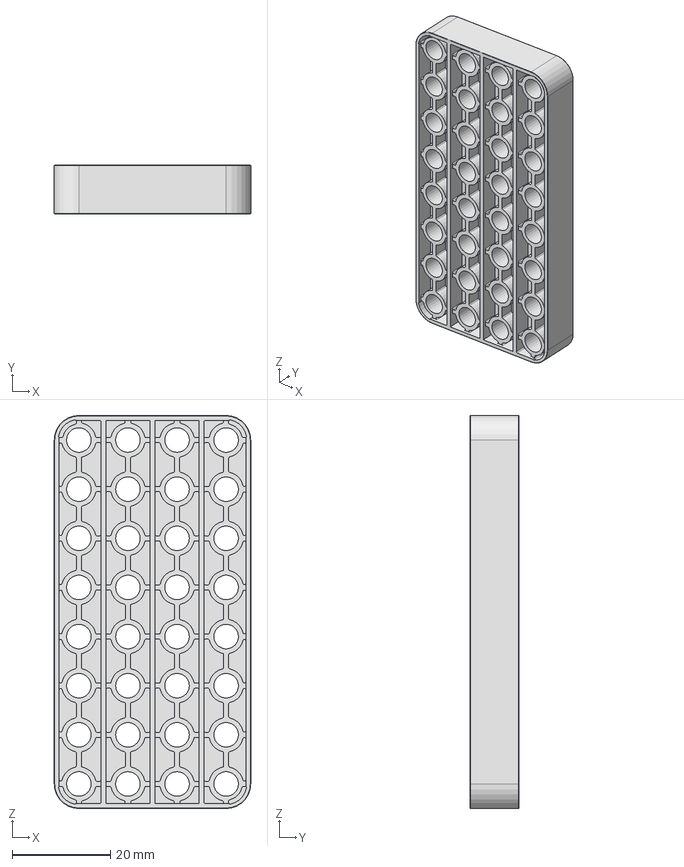
[picture p101: CAD file, 2024-04-02]
mechanical parts/SB - Straight Beams/S4x8/S4x8.stp
40.0 x 10.0 x 80.0 mm
