STEAM-Academy-PRO/revolution-robotics-kit/mechanical parts/TB - Twisted Beams/TB1x4/TB1x4.STEP

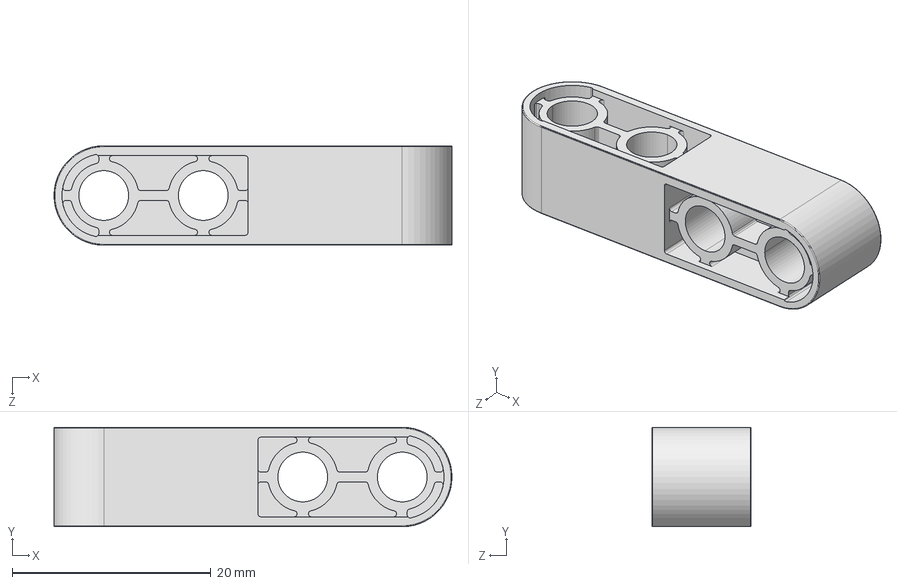
[picture p102: CAD file, 2024-02-20]
mechanical parts/TB - Twisted Beams/TB1x4/TB1x4.STEP
40.0 x 10.0 x 10.0 mm
