STEAM-Academy-PRO/revolution-robotics-kit/mechanical parts/WE - Wedges/WE5x4/WE5x4.stp

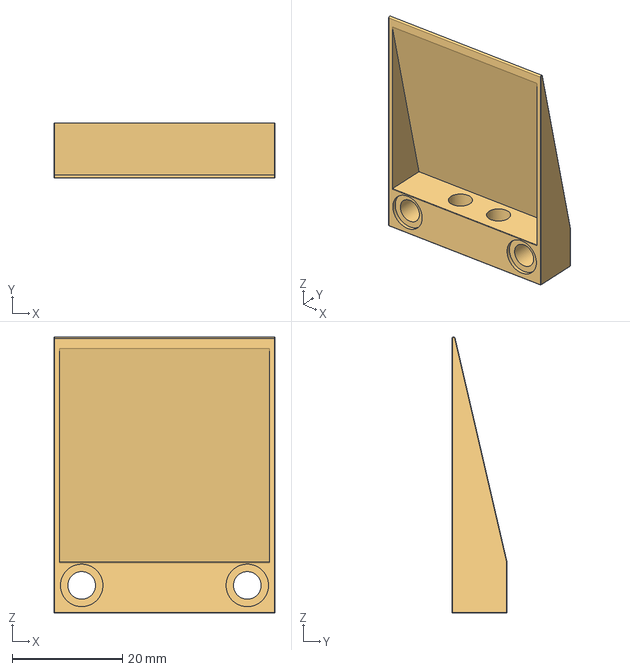
[picture p103: CAD file, 2024-04-02]
mechanical parts/WE - Wedges/WE5x4/WE5x4.stp
40.0 x 10.0 x 50.0 mm
