STEAM-Academy-PRO/revolution-robotics-kit/mechanical parts/WH - Wheels/OW - Omniwheel/Omniwheel/Mecanum adapter/mecanum_adapter_2.STL

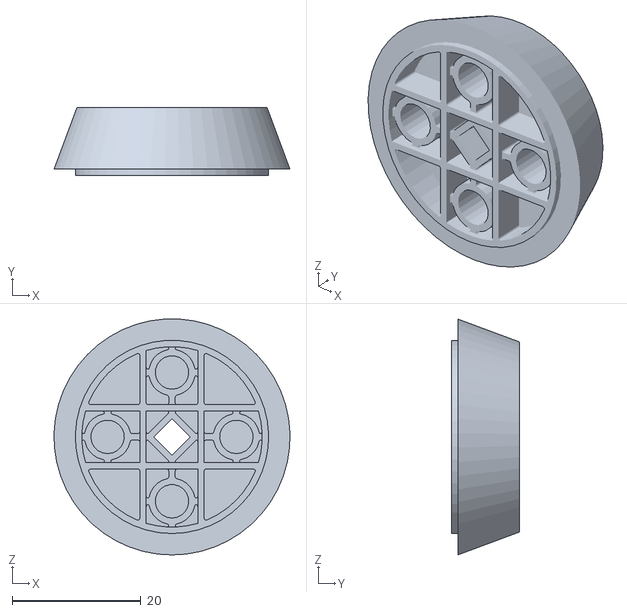
[picture p104: CAD file, 2024-04-02]
mechanical parts/WH - Wheels/OW - Omniwheel/Omniwheel/Mecanum adapter/mecanum_adapter_2.STL
36.6 x 10.6 x 36.6
