STEAM-Academy-PRO/revolution-robotics-kit/mechanical parts/WH - Wheels/OW - Omniwheel/Omniwheel/Omni adapter/omni adapter.SLDPRT

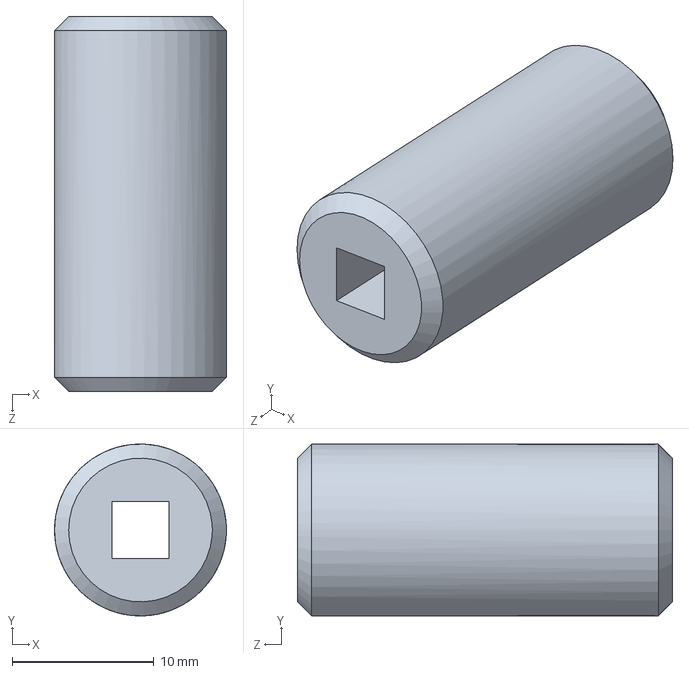
[picture p105: CAD file, 2024-04-02]
mechanical parts/WH - Wheels/OW - Omniwheel/Omniwheel/Omni adapter/omni adapter.SLDPRT
12.1 x 12.1 x 26.5 mm
