STEAM-Academy-PRO/revolution-robotics-kit/mechanical parts/WH - Wheels/OW - Omniwheel/Omniwheel/OWrA.SLDPRT

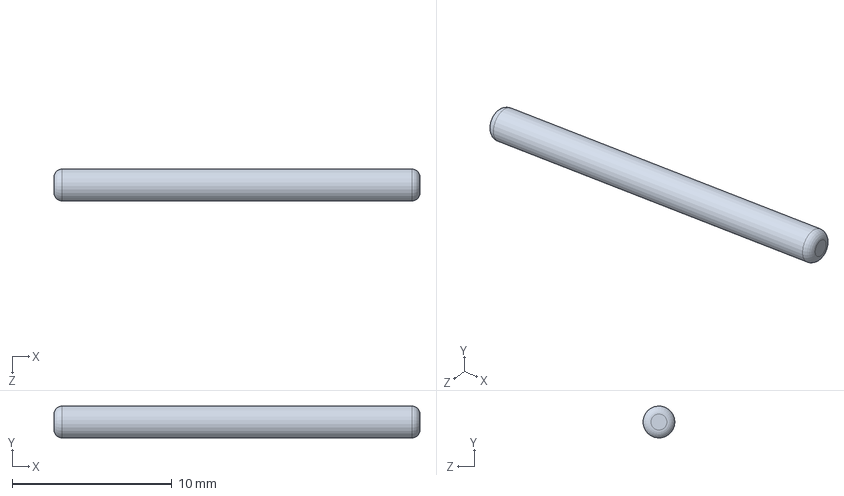
[picture p106: CAD file, 2024-04-02]
mechanical parts/WH - Wheels/OW - Omniwheel/Omniwheel/OWrA.SLDPRT
22.9 x 2.00 x 1.99 mm
