STEAM-Academy-PRO/revolution-robotics-kit/mechanical parts/WH - Wheels/OW - Omniwheel/Omniwheel/VEX/vex_rr_adapter.sldprt

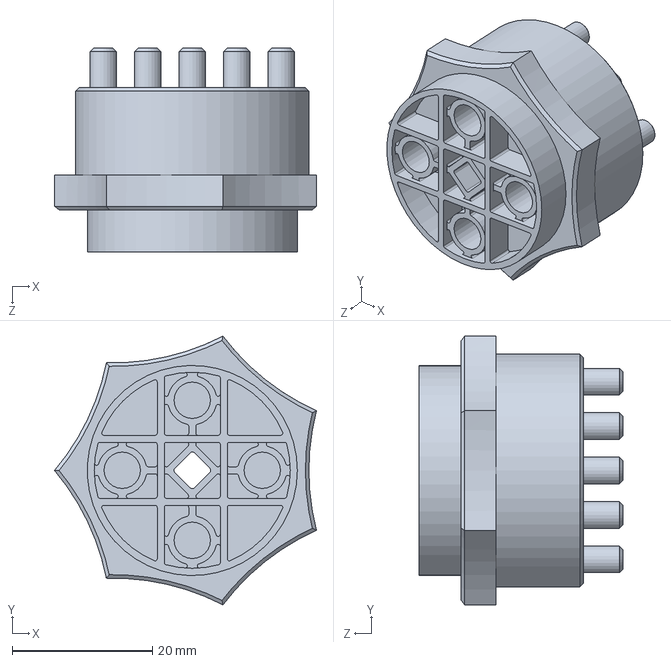
[picture p107: CAD file, 2024-04-02]
mechanical parts/WH - Wheels/OW - Omniwheel/Omniwheel/VEX/vex_rr_adapter.sldprt
37.4 x 38.4 x 29.1 mm
