STEAM-Academy-PRO/revolution-robotics-kit/mechanical parts/WH - Wheels/WHrM - Wheel Inside/_to_be_sorted/whrm-0720.stp

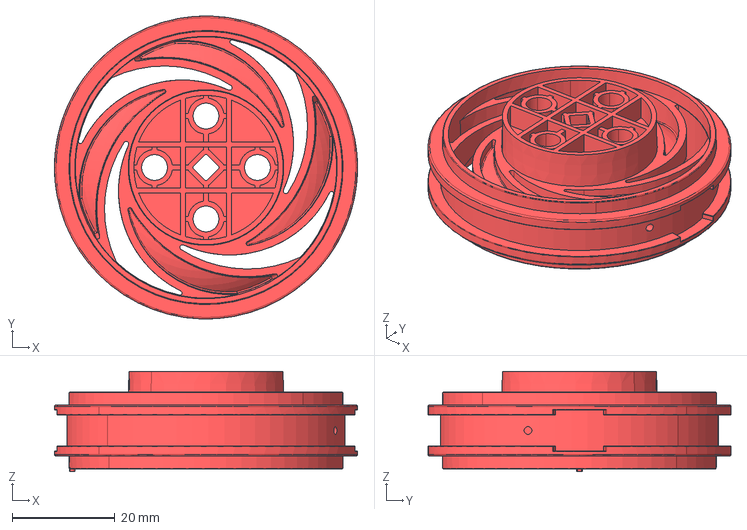
[picture p108: CAD file, 2023-09-20]
mechanical parts/WH - Wheels/WHrM - Wheel Inside/_to_be_sorted/whrm-0720.stp
58.9 x 58.9 x 19.5 mm
