STEAM-Academy-PRO/revolution-robotics-kit/mechanical parts/WH - Wheels/WHrM - Wheel Inside/WHrM.SLDPRT

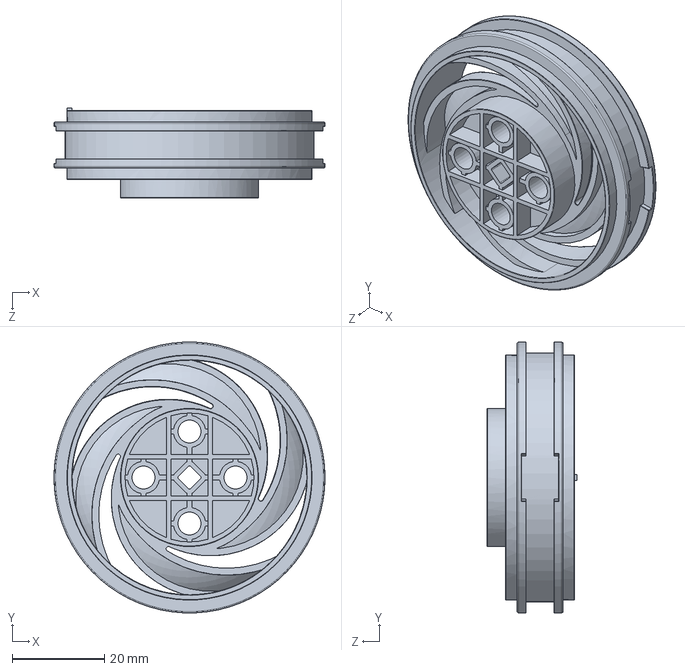
[picture p109: CAD file, 2024-04-02]
mechanical parts/WH - Wheels/WHrM - Wheel Inside/WHrM.SLDPRT
58.9 x 58.8 x 19.5 mm
