STEAM-Academy-PRO/revolution-robotics-kit/toolbox/LEGO Spike box additional trays/2024-06-11-lego-spike-box-inside-trays-top.STEP

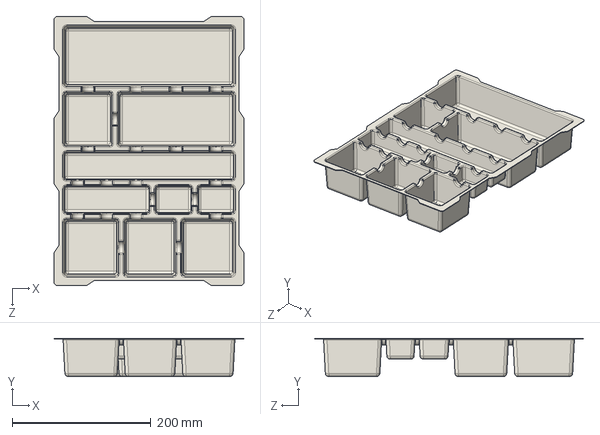
[picture p110: CAD file, 2024-07-08]
toolbox/LEGO Spike box additional trays/2024-06-11-lego-spike-box-inside-trays-top.STEP
274.0 x 55.0 x 388.0 mm
