STEAM-Academy-PRO/revolution-robotics-kit/accessories/CA - Cables/Cable-for-parts-list.SLDPRT

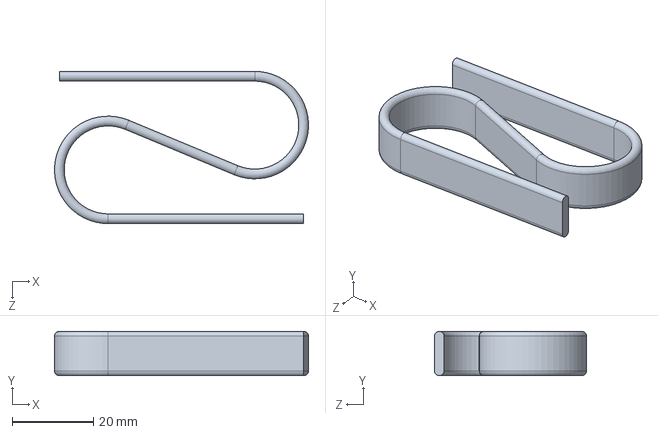
[picture p111: CAD file, 2024-04-02]
accessories/CA - Cables/Cable-for-parts-list.SLDPRT
62.4 x 10.9 x 37.4 mm
