STEAM-Academy-PRO/revolution-robotics-kit/electronic parts/BA - Battery Pack/Battery-pack-v2-production/3D-model/battery-tray.step

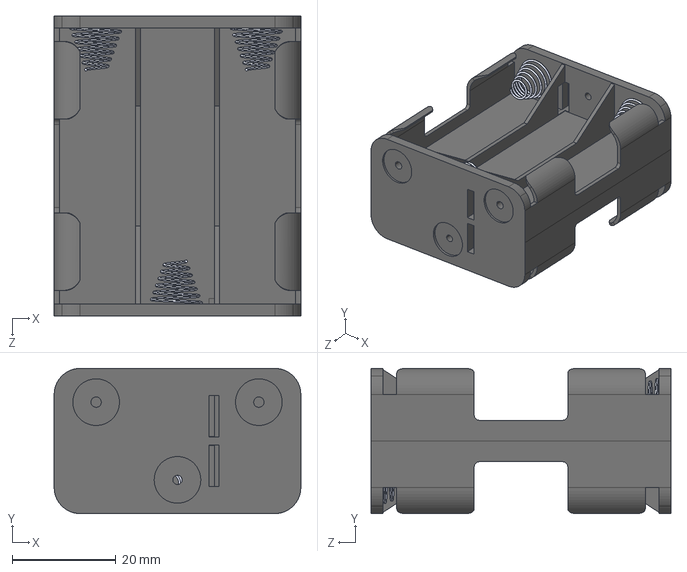
[picture p112: CAD file, 2024-03-27]
electronic parts/BA - Battery Pack/Battery-pack-v2-production/3D-model/battery-tray.step
47.6 x 28.0 x 57.9 mm
