STEAM-Academy-PRO/revolution-robotics-kit/electronic parts/BA - Battery Pack/Battery-pack-v3-development/3D-model/BACA_bottom.SLDPRT

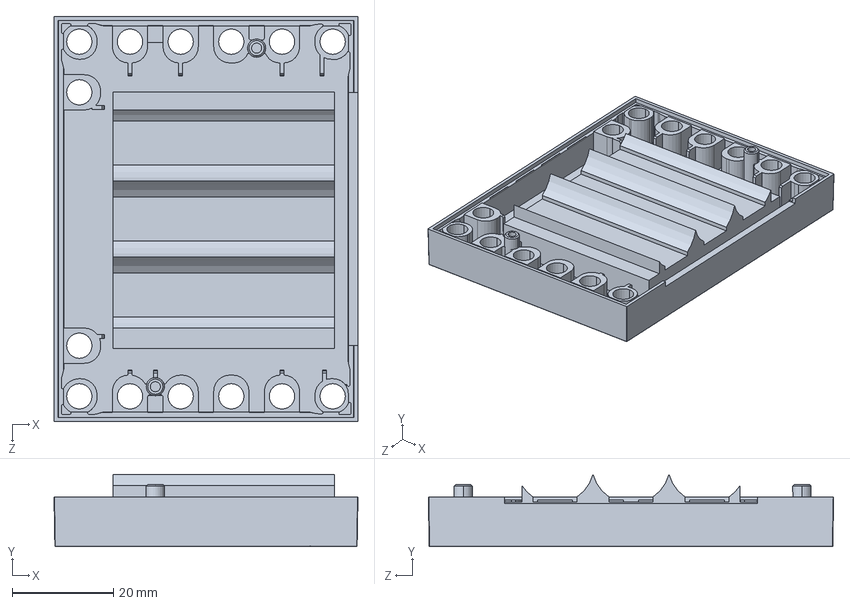
[picture p113: CAD file, 2024-03-27]
electronic parts/BA - Battery Pack/Battery-pack-v3-development/3D-model/BACA_bottom.SLDPRT
60.0 x 14.3 x 80.0 mm
