STEAM-Academy-PRO/revolution-robotics-kit/electronic parts/BU - Button Sensor/Button-sensor-v1-production/3D-model/Button-sensor-PCB.step

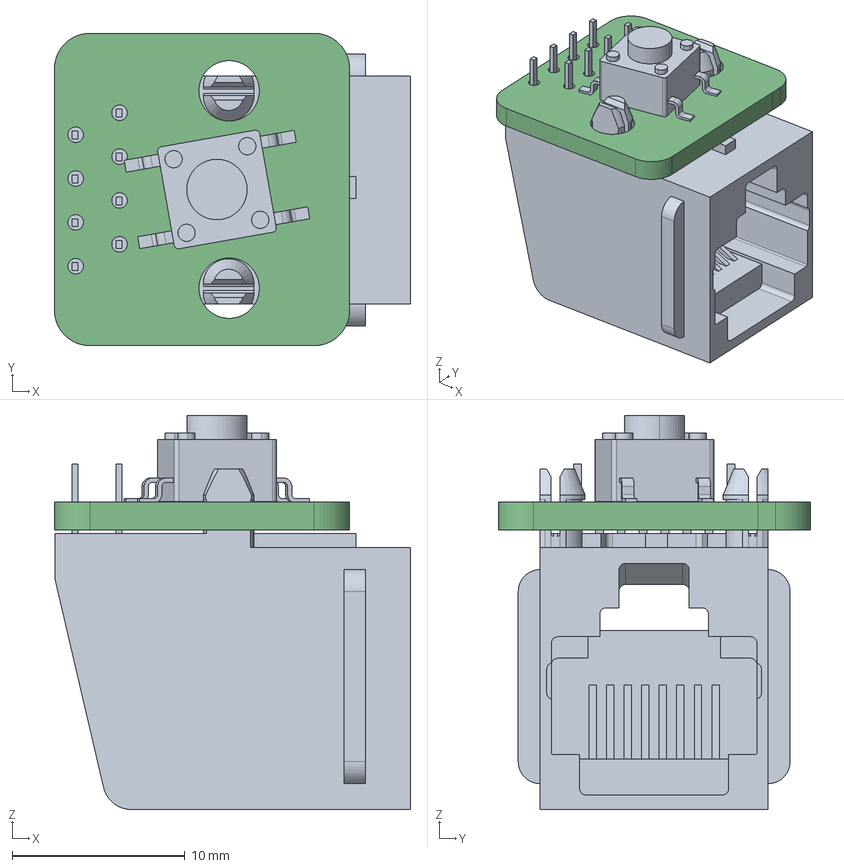
[picture p114: CAD file, 2023-09-20]
electronic parts/BU - Button Sensor/Button-sensor-v1-production/3D-model/Button-sensor-PCB.step
20.6 x 18.1 x 22.8 mm
Board
rj45_144-L
c-4-1437565-1-v-3d
