STEAM-Academy-PRO/revolution-robotics-kit/electronic parts/LM - LED Matrix/LED-Matrix-v1-development/3D-model/LED-Matrix-case-bottom.STL

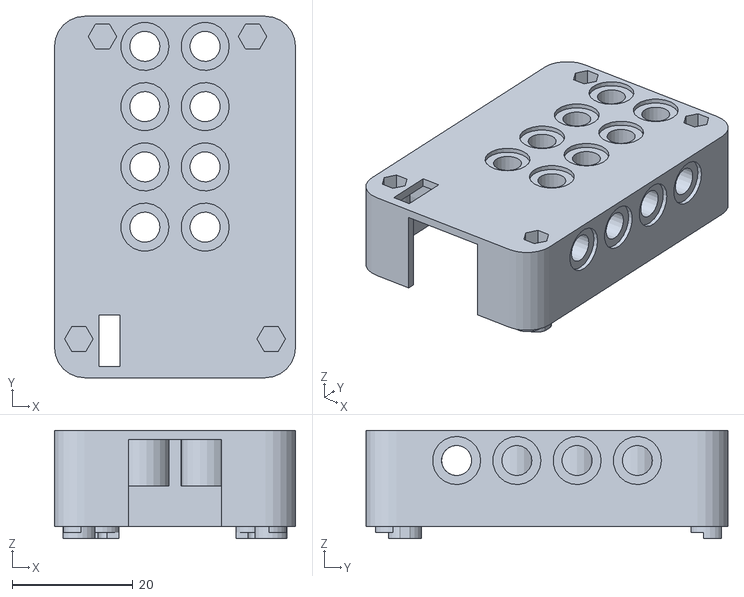
[picture p115: CAD file, 2024-04-02]
electronic parts/LM - LED Matrix/LED-Matrix-v1-development/3D-model/LED-Matrix-case-bottom.STL
40.0 x 60.0 x 18.0
