STEAM-Academy-PRO/revolution-robotics-kit/electronic parts/US - Ultrasonic Sensor/Ultrasonic-Sensor-v1-production/3D-model/Ultrasonic-Sensor-PCB.step

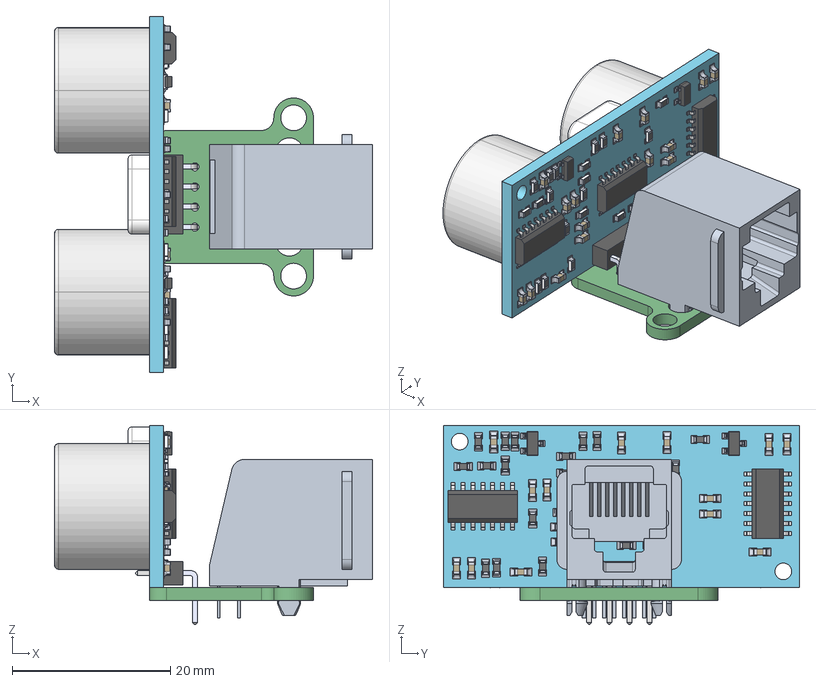
[picture p116: CAD file, 2023-09-20]
electronic parts/US - Ultrasonic Sensor/Ultrasonic-Sensor-v1-production/3D-model/Ultrasonic-Sensor-PCB.step
40.2 x 45.0 x 25.2 mm
Board
rj45_144-L
User_Library-HC-SR04_PCB
User_Library-HC-SR04_Transducer x 2
User_Library-HC-SR04_3_Pin_Header_90_Degree
User_Library-HC-SR04_14_Pin_SMT x 3
User_Library-HC-SR04_HC-SR04_Crystal.SLDASM
User_Library-HC-SR04_ssot3 x 2
User_Library-HC-SR04_MLC0603 x 20
User_Library-HC-SR04_603_cap_on_pad x 16
