STEAM-Academy-PRO/revolution-robotics-kit/mechanical parts/AD - Adapters/Lego adapter/Lego axle adapter.SLDPRT

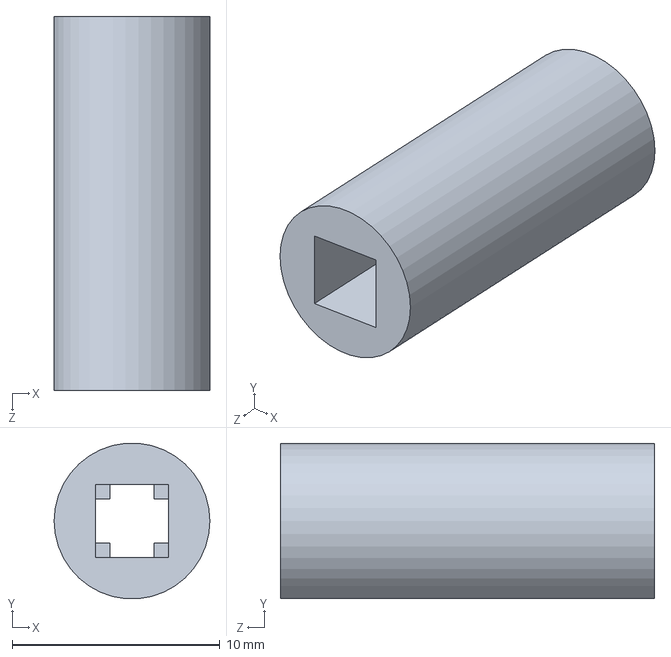
[picture p117: CAD file, 2024-04-02]
mechanical parts/AD - Adapters/Lego adapter/Lego axle adapter.SLDPRT
7.50 x 7.47 x 18.0 mm
