STEAM-Academy-PRO/revolution-robotics-kit/mechanical parts/CO - Connectors/CC1x1/CC1x2.STEP

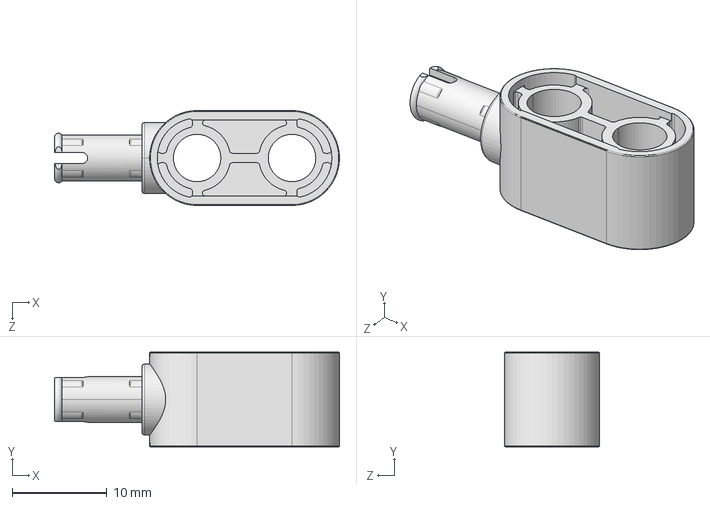
[picture p118: CAD file, 2024-02-20]
mechanical parts/CO - Connectors/CC1x1/CC1x2.STEP
30.0 x 10.0 x 10.0 mm
