STEAM-Academy-PRO/revolution-robotics-kit/mechanical parts/GE - Gears/WG30/Worm.SLDPRT

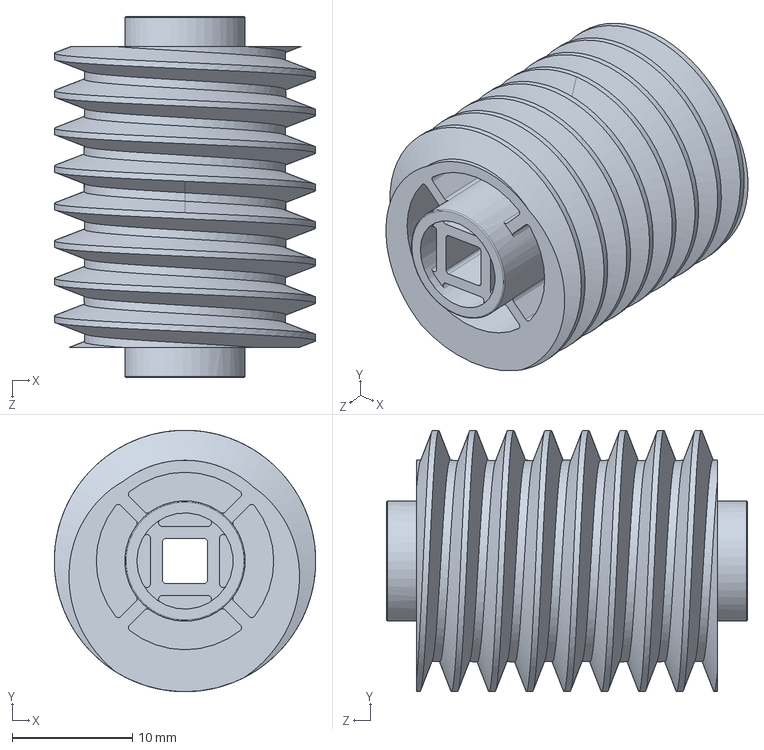
[picture p120: CAD file, 2024-04-02]
mechanical parts/GE - Gears/WG30/Worm.SLDPRT
21.7 x 21.7 x 30.0 mm
