STEAM-Academy-PRO/revolution-robotics-kit/mechanical parts/PR - Pin Removal/Pin removal tool/tool for production v2.STEP

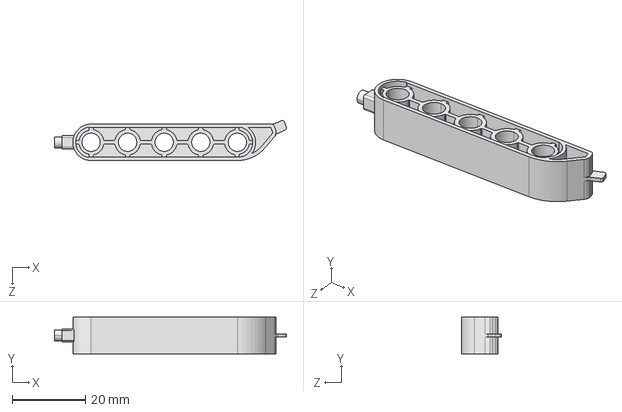
[picture p121: CAD file, 2024-04-02]
mechanical parts/PR - Pin Removal/Pin removal tool/tool for production v2.STEP
63.4 x 10.0 x 11.0 mm
