STEAM-Academy-PRO/revolution-robotics-kit/mechanical parts/WH - Wheels/OW - Omniwheel/Omniwheel/Mecanum adapter/mecanum_adapter.SLDPRT

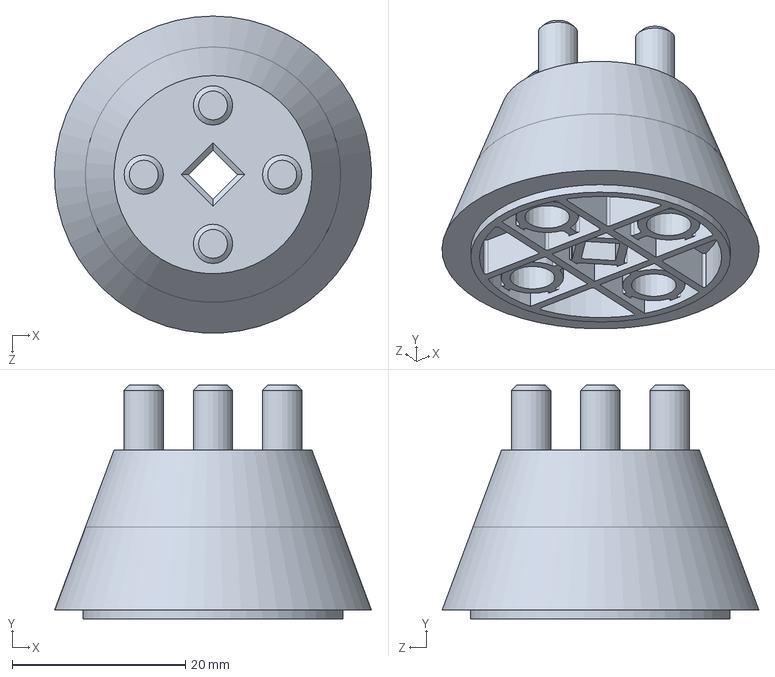
[picture p122: CAD file, 2024-04-02]
mechanical parts/WH - Wheels/OW - Omniwheel/Omniwheel/Mecanum adapter/mecanum_adapter.SLDPRT
36.6 x 27.0 x 36.6 mm
