STEAM-Academy-PRO/revolution-robotics-kit/mechanical parts/WH - Wheels/OW - Omniwheel/Omniwheel/VEX/vex_rr_adapter_2.STL

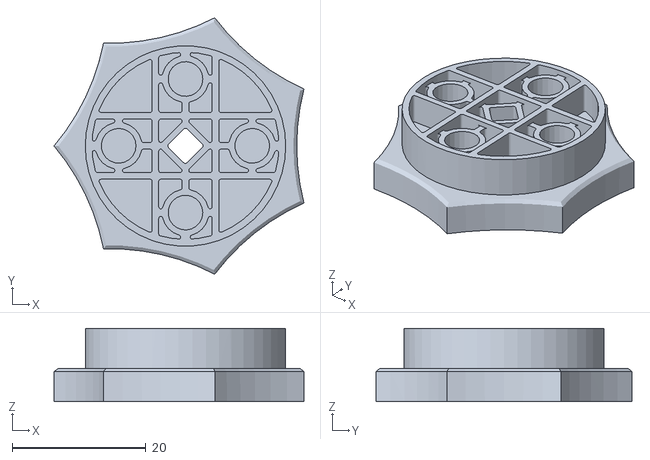
[picture p123: CAD file, 2024-04-02]
mechanical parts/WH - Wheels/OW - Omniwheel/Omniwheel/VEX/vex_rr_adapter_2.STL
37.4 x 38.4 x 11.0
