STEAM-Academy-PRO/revolution-robotics-kit/mechanical parts/WH - Wheels/WHrM - Wheel Inside/WHbeta.stp

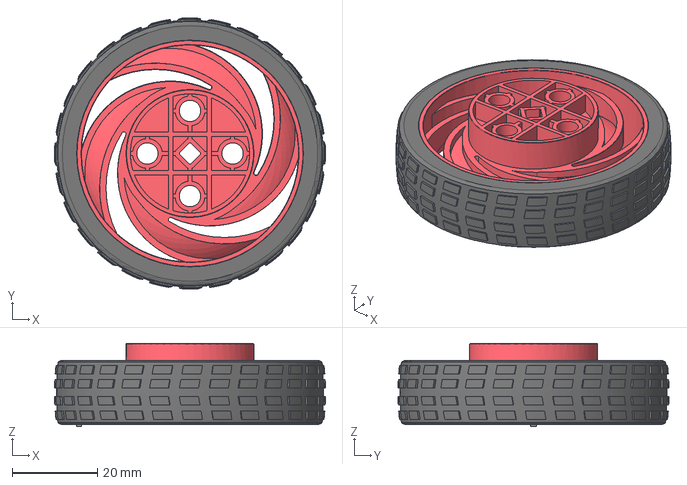
[picture p124: CAD file, 2024-04-02]
mechanical parts/WH - Wheels/WHrM - Wheel Inside/WHbeta.stp
63.6 x 63.6 x 19.5 mm
WHrM_ver2
WHtM_ver2
