STEAM-Academy-PRO/revolution-robotics-kit/mechanical parts/WH - Wheels/WHtM - Wheel Rubber/WHtM.stp

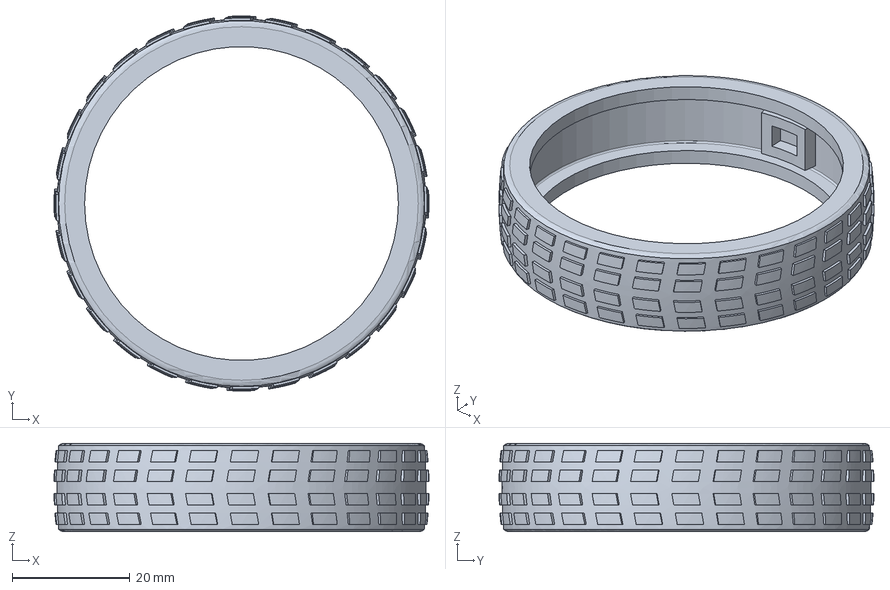
[picture p125: CAD file, 2024-04-02]
mechanical parts/WH - Wheels/WHtM - Wheel Rubber/WHtM.stp
63.6 x 63.6 x 15.0 mm
