STEAM-Academy-PRO/revolution-robotics-kit/toolbox/LEGO Spike box additional trays/2024-06-11-lego-spike-box-inside-trays-bottom.STEP

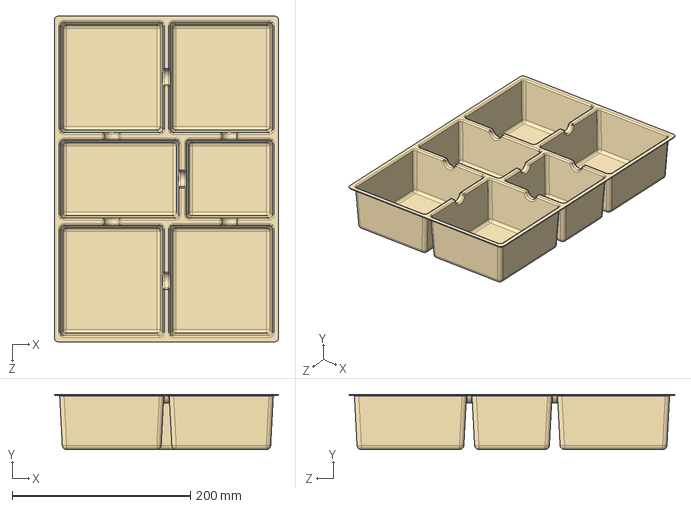
[picture p126: CAD file, 2024-07-08]
toolbox/LEGO Spike box additional trays/2024-06-11-lego-spike-box-inside-trays-bottom.STEP
252.0 x 62.0 x 366.0 mm
