STEAM-Academy-PRO/revolution-robotics-kit/electronic parts/BA - Battery Pack/Battery-pack-v3-development/3D-model/BAbeta_v2.STEP

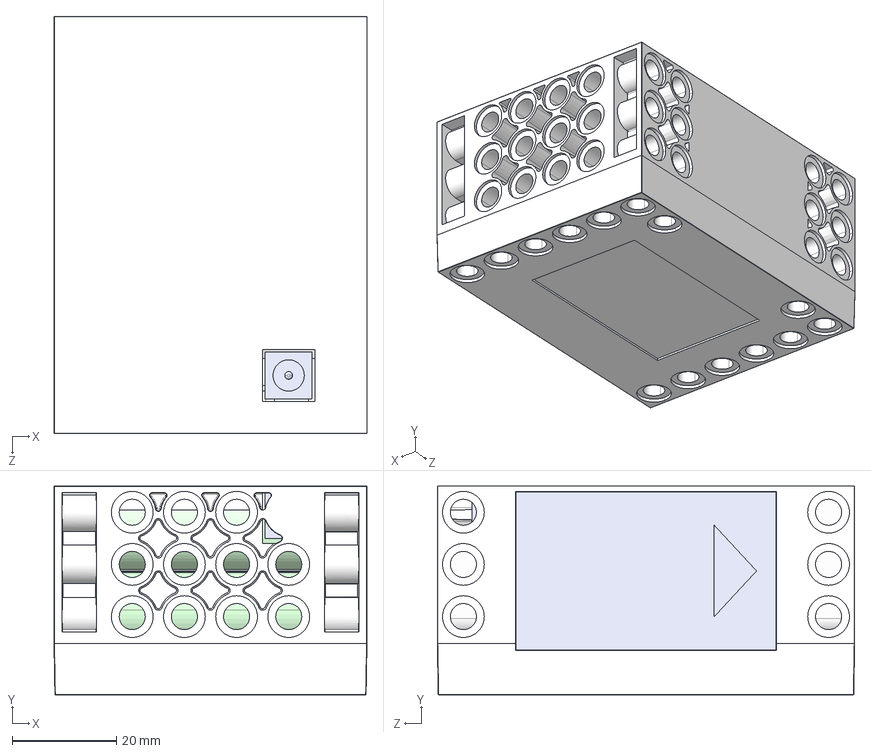
[picture p127: CAD file, 2024-03-27]
electronic parts/BA - Battery Pack/Battery-pack-v3-development/3D-model/BAbeta_v2.STEP
60.0 x 40.0 x 80.0 mm
BACA_bottom
BACA_top
BA_battery x 6
Part1^BAbeta_v2
Part2^BAbeta_v2
