STEAM-Academy-PRO/revolution-robotics-kit/electronic parts/LM - LED Matrix/LED-Matrix-v1-development/3D-model/LED-Matrix-singlepart.SLDPRT

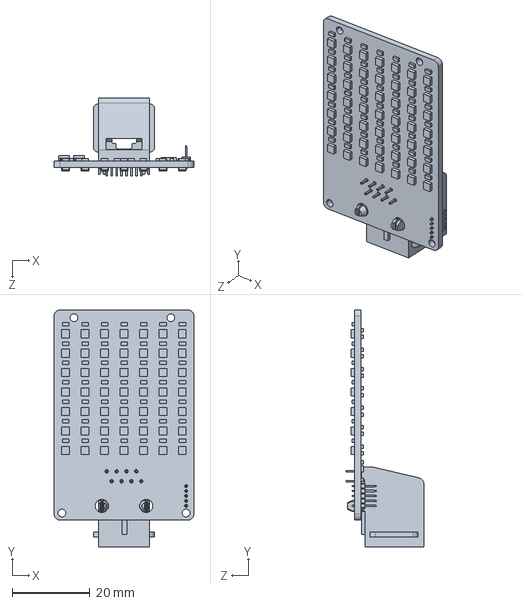
[picture p128: CAD file, 2024-04-02]
electronic parts/LM - LED Matrix/LED-Matrix-v1-development/3D-model/LED-Matrix-singlepart.SLDPRT
35.9 x 60.9 x 20.0 mm
