STEAM-Academy-PRO/revolution-robotics-kit/mechanical parts/AD - Adapters/Lego adapter/Lego adapter.SLDPRT

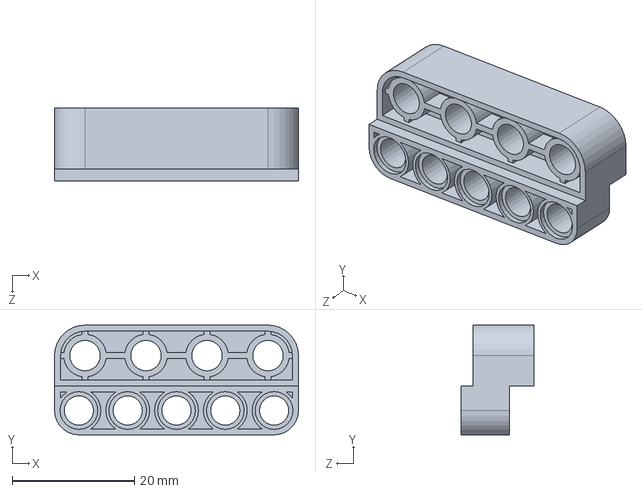
[picture p129: CAD file, 2024-04-02]
mechanical parts/AD - Adapters/Lego adapter/Lego adapter.SLDPRT
40.0 x 18.0 x 12.0 mm
