STEAM-Academy-PRO/revolution-robotics-kit/mechanical parts/GE - Gears/WG30/WG30_v3.STEP

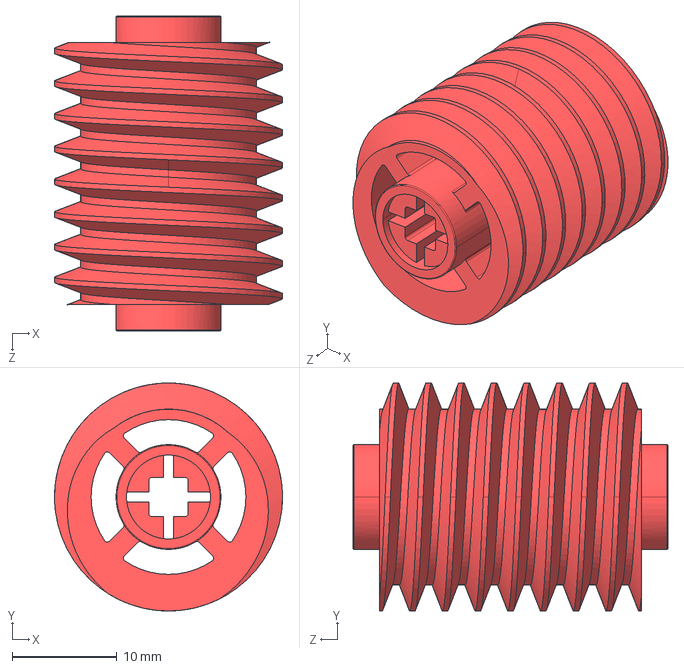
[picture p130: CAD file, 2024-04-02]
mechanical parts/GE - Gears/WG30/WG30_v3.STEP
21.7 x 21.7 x 30.0 mm
