STEAM-Academy-PRO/revolution-robotics-kit/mechanical parts/WH - Wheels/OW - Omniwheel/Omniwheel/Mecanum adapter/mecanum_adapter_1.STL

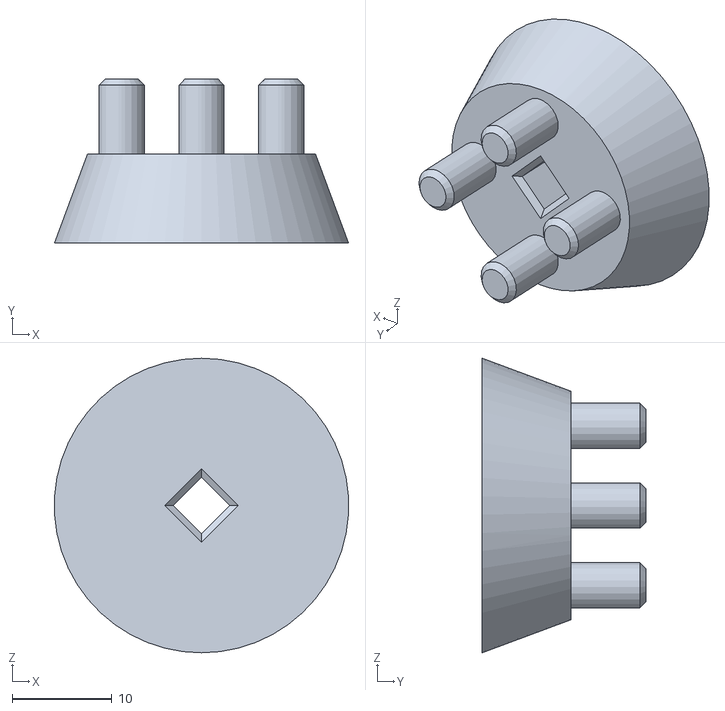
[picture p131: CAD file, 2024-04-02]
mechanical parts/WH - Wheels/OW - Omniwheel/Omniwheel/Mecanum adapter/mecanum_adapter_1.STL
29.5 x 16.4 x 29.5
