STEAM-Academy-PRO/revolution-robotics-kit/mechanical parts/WH - Wheels/OW - Omniwheel/Omniwheel/OWbeta.STEP

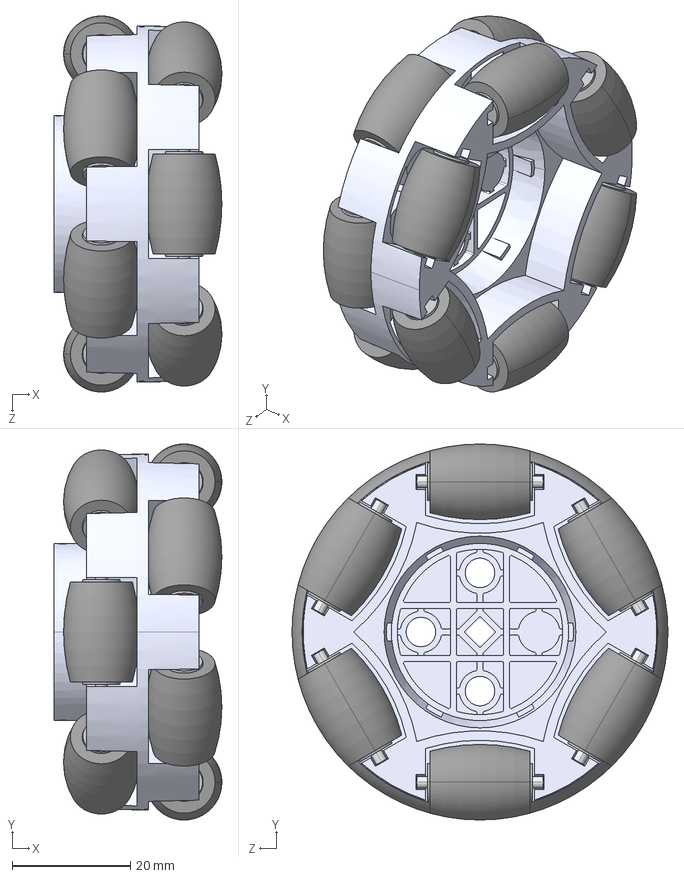
[picture p132: CAD file, 2024-04-02]
mechanical parts/WH - Wheels/OW - Omniwheel/Omniwheel/OWbeta.STEP
28.4 x 63.7 x 63.7 mm
OWrR x 12
OWrP x 12
OWrA x 12
OWcA
