STEAM-Academy-PRO/revolution-robotics-kit/mechanical parts/WH - Wheels/OW - Omniwheel/Omniwheel/VEX/vex_rr_adapter_1.STL

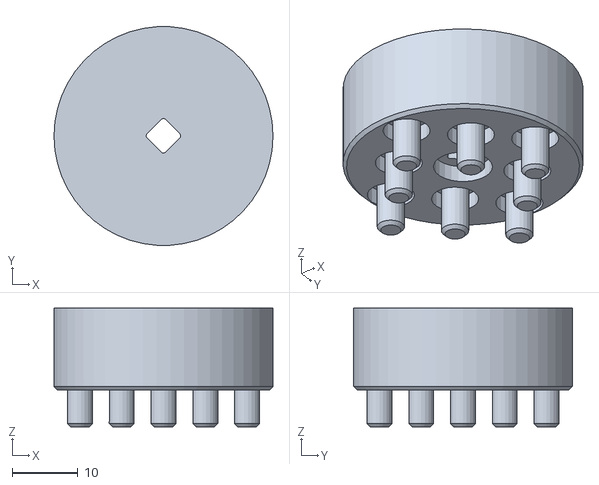
[picture p133: CAD file, 2024-04-02]
mechanical parts/WH - Wheels/OW - Omniwheel/Omniwheel/VEX/vex_rr_adapter_1.STL
33.3 x 33.2 x 18.1
