STEAM-Academy-PRO/revolution-robotics-kit/mechanical parts/AD - Adapters/Lego adapter/Lego adapter_for_print.SLDPRT

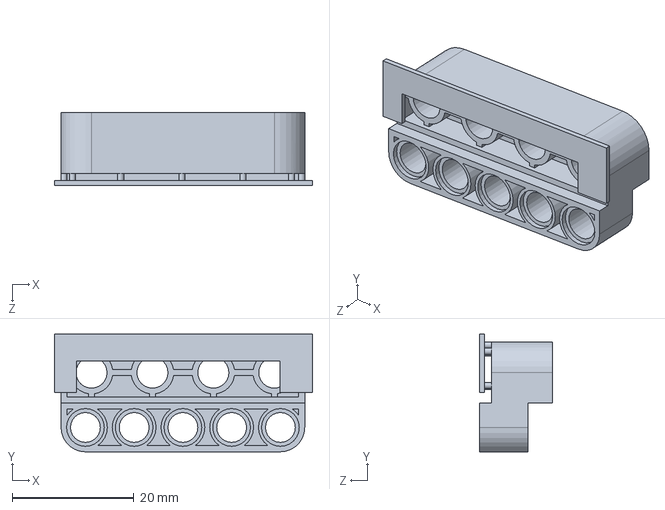
[picture p135: CAD file, 2024-04-02]
mechanical parts/AD - Adapters/Lego adapter/Lego adapter_for_print.SLDPRT
42.3 x 19.3 x 12.0 mm
