STEAM-Academy-PRO/revolution-robotics-kit/mechanical parts/GE - Gears/WG30/_to_be_sorted/WG30-0806.stp

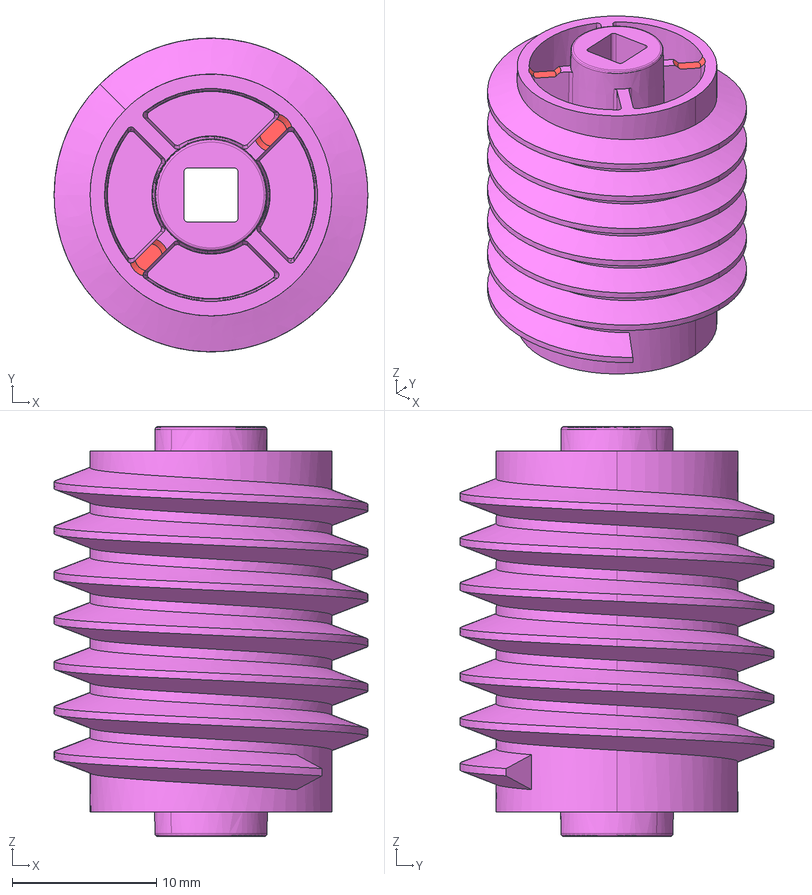
[picture p136: CAD file, 2023-09-20]
mechanical parts/GE - Gears/WG30/_to_be_sorted/WG30-0806.stp
21.7 x 21.7 x 28.4 mm
