STEAM-Academy-PRO/revolution-robotics-kit/mechanical parts/WH - Wheels/OW - Omniwheel/Omniwheel/OWrR.SLDPRT

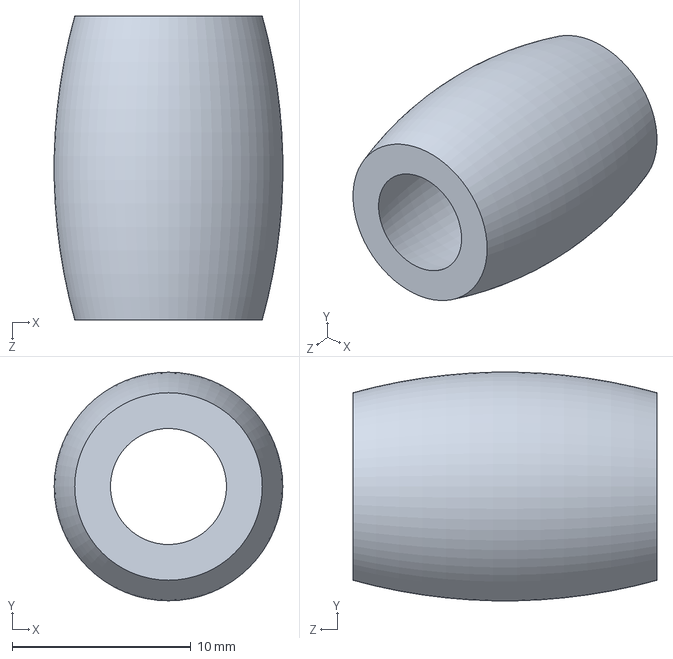
[picture p137: CAD file, 2024-04-02]
mechanical parts/WH - Wheels/OW - Omniwheel/Omniwheel/OWrR.SLDPRT
12.8 x 12.8 x 17.0 mm
