STEAM-Academy-PRO/revolution-robotics-kit/mechanical parts/WH - Wheels/OW - Omniwheel/Omniwheel/VEX/228-2536.STEP

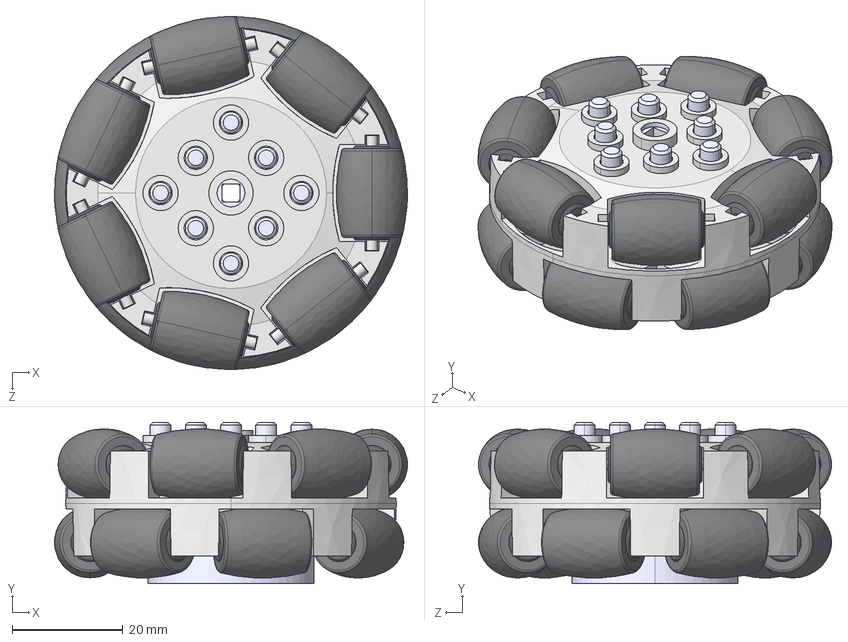
[picture p138: CAD file, 2024-04-02]
mechanical parts/WH - Wheels/OW - Omniwheel/Omniwheel/VEX/228-2536.STEP
63.7 x 29.1 x 63.7 mm
228-2536-004-1.STEP x 14
228-2536-003-1.STEP x 14
228-2536-002-1.STEP x 14
228-2536-001-1.STEP
vex_rr_adapter
