STEAM-Academy-PRO/revolution-robotics-kit/mechanical parts/WH - Wheels/WHrM - Wheel Inside/WHbeta_onepart.SLDPRT

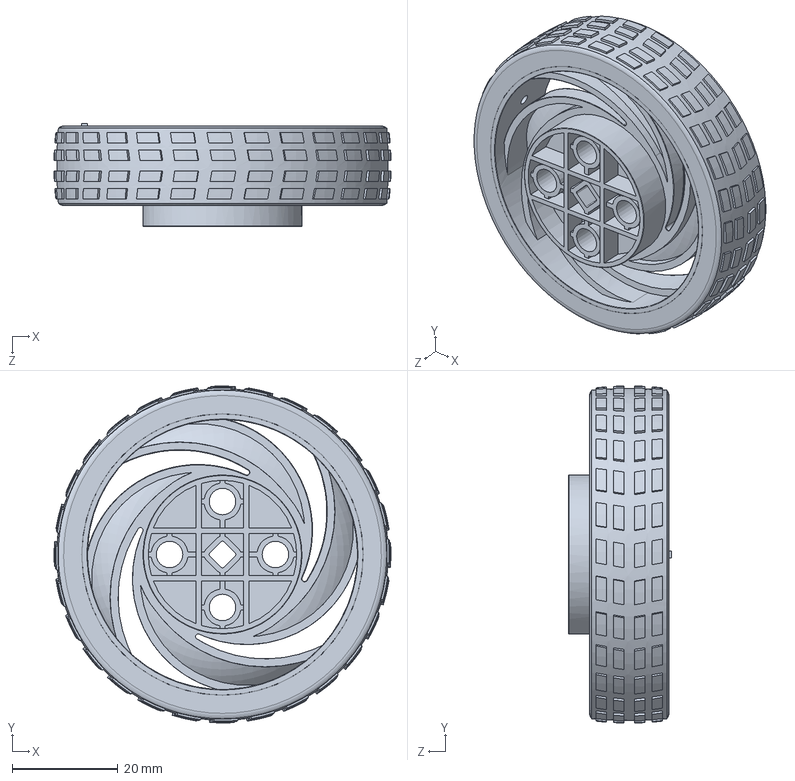
[picture p139: CAD file, 2024-04-02]
mechanical parts/WH - Wheels/WHrM - Wheel Inside/WHbeta_onepart.SLDPRT
63.6 x 63.6 x 19.5 mm
