STEAM-Academy-PRO/revolution-robotics-kit/electronic parts/LM - LED Matrix/LED-Matrix-v1-development/3D-model/LED-Matrix.step

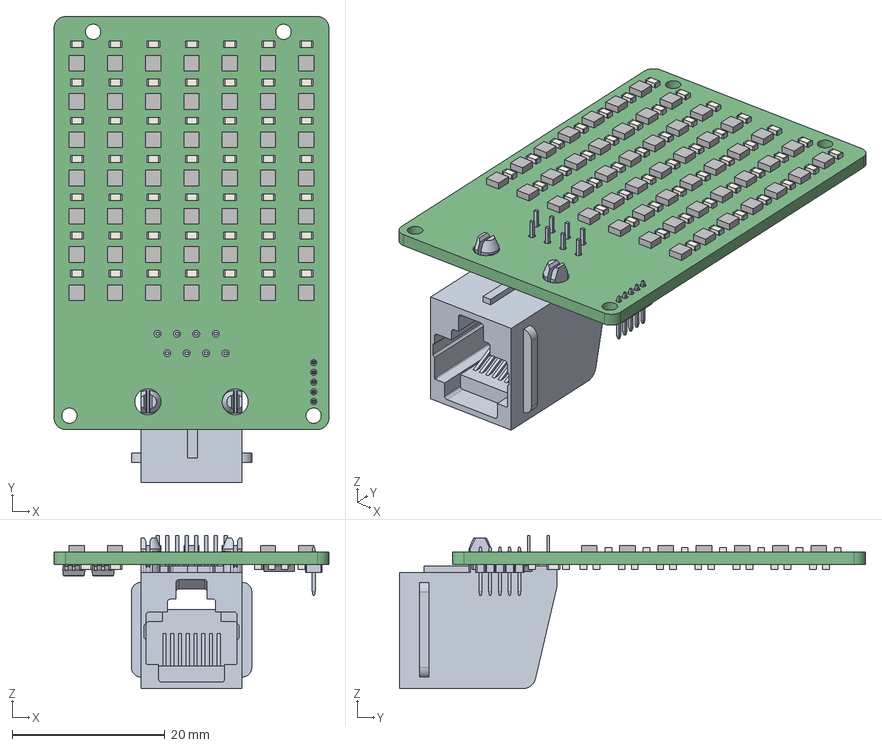
[picture p140: CAD file, 2024-02-20]
electronic parts/LM - LED Matrix/LED-Matrix-v1-development/3D-model/LED-Matrix.step
35.9 x 60.9 x 20.0 mm
Board
Extruded x 532
PinsArrayL x 2
PinsArrayR x 2
Open_CASCADE_STEP_translator_6.8_2.1
Open_CASCADE_STEP_translator_6.8_2.2.1
Thermal_Shape
Open_CASCADE_STEP_translator_6.8_2.4.1 x 24
rj45_144-L
SULLINS_GRPB051VWVN-RC
