STEAM-Academy-PRO/revolution-robotics-kit/mechanical parts/WH - Wheels/OW - Omniwheel/Omniwheel/OWcA.sldprt

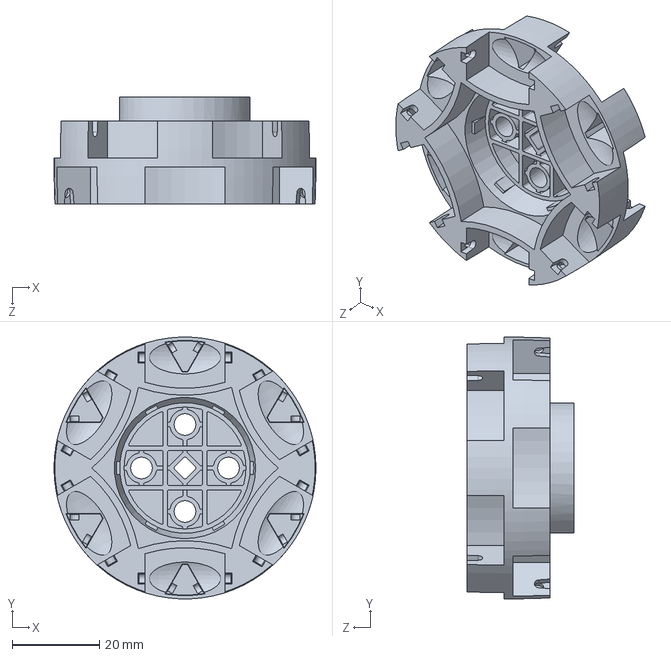
[picture p141: CAD file, 2024-04-02]
mechanical parts/WH - Wheels/OW - Omniwheel/Omniwheel/OWcA.sldprt
60.2 x 60.2 x 24.5 mm
