STEAM-Academy-PRO/revolution-robotics-kit/(list of files, cad)

Other CAD files:
electronic parts/BU - Button Sensor/_to_be_sorted/bubeta_asm-07-01.stp
electronic parts/BU - Button Sensor/_to_be_sorted/bubeta_asm-06-28.stp
mechanical parts/PR - Pin Removal/Pin removal tool/tool for production.SLDPRT
mechanical parts/WH - Wheels/WHtM - Wheel Rubber/WHrM.stp
mechanical parts/GE - Gears/CG40/CG40.STEP
mechanical parts/PI - Pins/CP1x1/CP1x1_no_anti_skid.stp
mechanical parts/PI - Pins/CP2x1/CP2x1.SLDPRT
mechanical parts/PI - Pins/CP2x2/CP2x2_no_anti_skid.stp
mechanical parts/GE - Gears/WG30/_to_be_sorted/WG30_china.SLDPRT
mechanical parts/WH - Wheels/WHrM - Wheel Inside/WHrM_final.STEP
electronic parts/BA - Battery Pack/Battery-pack-v3-development/3D-model/BA_battery.SLDPRT
accessories/CF - Challenge Field/_legacy/A1 field.SLDPRT
accessories/CF - Challenge Field/_legacy/arena.SLDASM
accessories/CF - Challenge Field/_legacy/arena.SLDDRW
accessories/CF - Challenge Field/_legacy/arena.SLDPRT
accessories/CF - Challenge Field/_legacy/arena_2.SLDDRW
accessories/CF - Challenge Field/_legacy/base1.SLDPRT
accessories/CF - Challenge Field/_legacy/base2.SLDPRT
accessories/CF - Challenge Field/_legacy/challenge field.SLDDRW
accessories/CF - Challenge Field/_legacy/corner.SLDPRT
accessories/CF - Challenge Field/_legacy/field.SLDPRT
accessories/CF - Challenge Field/_legacy/overlay.SLDPRT
accessories/CF - Challenge Field/_legacy/sides.SLDPRT
electronic parts/BA - Battery Pack/Battery-pack-v1-production/Labeling/BACA_2.SLDDRW
electronic parts/BA - Battery Pack/Battery-pack-v1-production/Labeling/BACA_2.SLDPRT
electronic parts/BA - Battery Pack/Battery-pack-v1-production/Labeling/Battery_labeling.DXF
electronic parts/BA - Battery Pack/Battery-pack-v1-production/Labeling/Battery_labeling.SLDDRW
electronic parts/BA - Battery Pack/Battery-pack-v3-development/3D-model/BAbeta_v2.SLDASM
electronic parts/BA - Battery Pack/_legacy/BAbeta_battery.STEP
electronic parts/BA - Battery Pack/_legacy/BAbeta_bottom.STEP
electronic parts/BA - Battery Pack/_legacy/BAbeta_top.STEP
electronic parts/BA - Battery Pack/_legacy/BAbeta_tray_black.STEP
electronic parts/BA - Battery Pack/_legacy/BAbeta_tray_metal.STEP
electronic parts/BR - Brain/Brain-v1-production/A sample/3D model/RRRC_led_board_20190212.step
electronic parts/BR - Brain/Brain-v1-production/B sample/3D model/683866P_2000mAh.SLDPRT
electronic parts/BR - Brain/Brain-v1-production/B sample/3D model/leds_board_2019-06-12.step
electronic parts/BR - Brain/Brain-v1-production/C sample [Pre-Production]/3D model/leds_board_2019-06-12.step
electronic parts/BR - Brain/Brain-v1-production/C sample [Pre-Production]/PCB/RRRC_LEDsBoard_manufacturing_v2.3_20190802(02AB22211A0)(SK167ZC02624A0) 机械图.dwg
electronic parts/BR - Brain/Brain-v1-production/D sample [Start-Of-Production]/3D Model/Barin-transparent-LED-cover.STEP
electronic parts/BR - Brain/Brain-v1-production/D sample [Start-Of-Production]/3D Model/Brain-RJ45-black.STEP
electronic parts/BR - Brain/Brain-v1-production/D sample [Start-Of-Production]/3D Model/Brain-RJ45-metal.STEP
electronic parts/BR - Brain/Brain-v1-production/D sample [Start-Of-Production]/3D Model/Brain-red-logo.STEP
electronic parts/BR - Brain/Brain-v1-production/D sample [Start-Of-Production]/CAD Project/Inventor imported/BRBETA-0618_683866P_2000mAh.ipt
electronic parts/BR - Brain/Brain-v1-production/D sample [Start-Of-Production]/CAD Project/Inventor imported/BRBETA-0618_BRAIN_HOUSING_ASM.iam
electronic parts/BR - Brain/Brain-v1-production/D sample [Start-Of-Production]/CAD Project/Inventor imported/BRBETA-0618_BRBETA_ANY_ASM.iam
electronic parts/BR - Brain/Brain-v1-production/D sample [Start-Of-Production]/CAD Project/Inventor imported/BRBETA-0618_BRCA_1.ipt
electronic parts/BR - Brain/Brain-v1-production/D sample [Start-Of-Production]/CAD Project/Inventor imported/BRBETA-0618_BRCA_2.ipt
electronic parts/BR - Brain/Brain-v1-production/D sample [Start-Of-Production]/CAD Project/Inventor imported/BRBETA-0618_BRCA_3.ipt
electronic parts/BR - Brain/Brain-v1-production/D sample [Start-Of-Production]/CAD Project/Inventor imported/BRBETA-0618_BRCA_4.ipt
electronic parts/BR - Brain/Brain-v1-production/D sample [Start-Of-Production]/CAD Project/Inventor imported/BRBETA-0618_BRCA_5.ipt
electronic parts/BR - Brain/Brain-v1-production/D sample [Start-Of-Production]/CAD Project/Inventor imported/BRBETA-0618_BRCA_6.ipt
electronic parts/BR - Brain/Brain-v1-production/D sample [Start-Of-Production]/CAD Project/Inventor imported/BRBETA-0618_BRCA_STICKER_ANY.ipt
electronic parts/BR - Brain/Brain-v1-production/D sample [Start-Of-Production]/CAD Project/Inventor imported/BRBETA-0618_COLOR_WHEEL.ipt
electronic parts/BR - Brain/Brain-v1-production/D sample [Start-Of-Production]/CAD Project/Inventor imported/BRBETA-0618_Electronics assembly.iam
electronic parts/BR - Brain/Brain-v1-production/D sample [Start-Of-Production]/CAD Project/Inventor imported/BRBETA-0618_LED_colorer.ipt
electronic parts/BR - Brain/Brain-v1-production/D sample [Start-Of-Production]/CAD Project/Inventor imported/BRBETA-0618_SCREW__2_5_X_10.ipt
electronic parts/BR - Brain/Brain-v1-production/D sample [Start-Of-Production]/CAD Project/Inventor imported/BRBETA-0618_SCREW__2_5_X_4.ipt
electronic parts/BR - Brain/Brain-v1-production/D sample [Start-Of-Production]/CAD Project/Inventor imported/BRBETA-0618_TF16gbA.ipt
electronic parts/BR - Brain/Brain-v1-production/D sample [Start-Of-Production]/CAD Project/Inventor imported/BRBETA-0618__LED_COLORER.ipt
electronic parts/BR - Brain/Brain-v1-production/D sample [Start-Of-Production]/CAD Project/Inventor imported/BRled1/7379649056.iam
electronic parts/BR - Brain/Brain-v1-production/D sample [Start-Of-Production]/CAD Project/Inventor imported/BRled1/7379649376.iam
electronic parts/BR - Brain/Brain-v1-production/D sample [Start-Of-Production]/CAD Project/Inventor imported/BRled1/7379657056.iam
electronic parts/BR - Brain/Brain-v1-production/D sample [Start-Of-Production]/CAD Project/Inventor imported/BRled1/Board.iam
electronic parts/BR - Brain/Brain-v1-production/D sample [Start-Of-Production]/CAD Project/Inventor imported/BRled1/C1.iam
electronic parts/BR - Brain/Brain-v1-production/D sample [Start-Of-Production]/CAD Project/Inventor imported/BRled1/C10.iam
electronic parts/BR - Brain/Brain-v1-production/D sample [Start-Of-Production]/CAD Project/Inventor imported/BRled1/C11.iam
electronic parts/BR - Brain/Brain-v1-production/D sample [Start-Of-Production]/CAD Project/Inventor imported/BRled1/C12.iam
electronic parts/BR - Brain/Brain-v1-production/D sample [Start-Of-Production]/CAD Project/Inventor imported/BRled1/C13.iam
electronic parts/BR - Brain/Brain-v1-production/D sample [Start-Of-Production]/CAD Project/Inventor imported/BRled1/C14.iam
electronic parts/BR - Brain/Brain-v1-production/D sample [Start-Of-Production]/CAD Project/Inventor imported/BRled1/C15.iam
electronic parts/BR - Brain/Brain-v1-production/D sample [Start-Of-Production]/CAD Project/Inventor imported/BRled1/C16.iam
electronic parts/BR - Brain/Brain-v1-production/D sample [Start-Of-Production]/CAD Project/Inventor imported/BRled1/C2.iam
electronic parts/BR - Brain/Brain-v1-production/D sample [Start-Of-Production]/CAD Project/Inventor imported/BRled1/C3.iam
electronic parts/BR - Brain/Brain-v1-production/D sample [Start-Of-Production]/CAD Project/Inventor imported/BRled1/C4.iam
electronic parts/BR - Brain/Brain-v1-production/D sample [Start-Of-Production]/CAD Project/Inventor imported/BRled1/C5.iam
electronic parts/BR - Brain/Brain-v1-production/D sample [Start-Of-Production]/CAD Project/Inventor imported/BRled1/C6.iam
electronic parts/BR - Brain/Brain-v1-production/D sample [Start-Of-Production]/CAD Project/Inventor imported/BRled1/C7.iam
electronic parts/BR - Brain/Brain-v1-production/D sample [Start-Of-Production]/CAD Project/Inventor imported/BRled1/C8.iam
electronic parts/BR - Brain/Brain-v1-production/D sample [Start-Of-Production]/CAD Project/Inventor imported/BRled1/C9.iam
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
