STEAM-Academy-PRO/revolution-robotics-kit/certificates/Documentation/Bluetooth-testing-manual/SA-RR-CK-2.0-Bluetooth-testing-manual-2024-07-18.pptx

## Revolution Robotics Bluetooth testing manual

2024/07/18
Laszlo B.

## 1) Install the provided APK

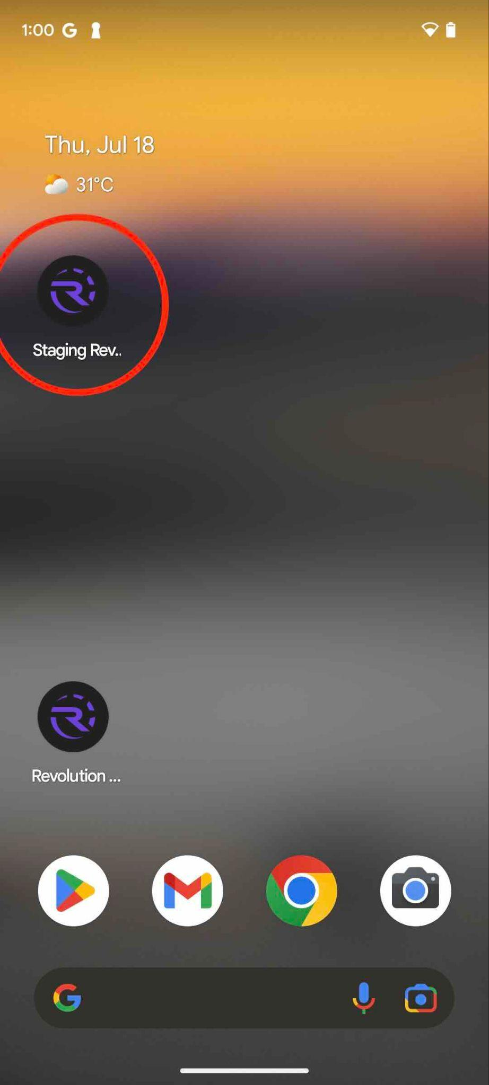
[picture p143: figure]

1. Use an Android phone
2. A “Staging Revolution Robotics” app should appear
3. This is the test version of the application, same as in the app store.
4. Open the app

## 2) Log in

1. Select language to be English, click next
2. Select “Login with Code Name”
3. Use credentials
  - code name: Certificates
  - pass: Certificates123

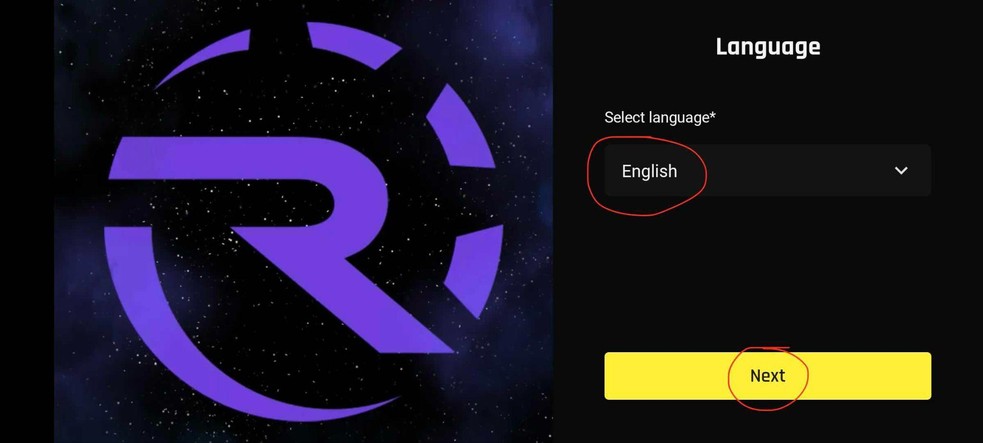
[picture p144: figure]
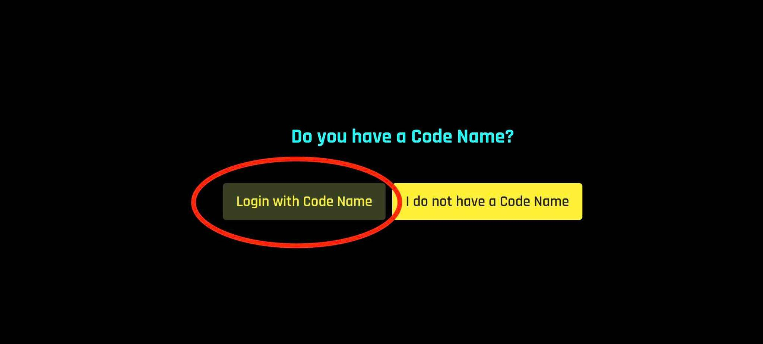
[picture p145: figure]
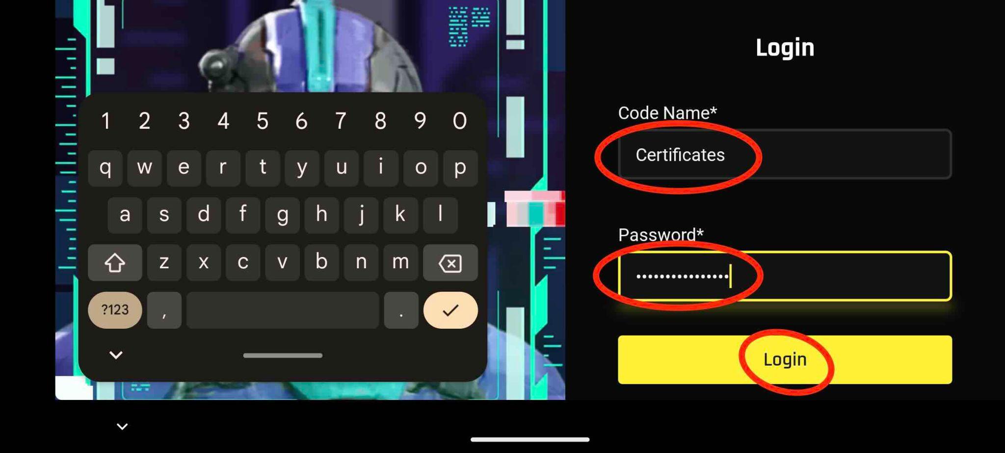
[picture p146: figure]

## 3) Find the testing robot

1. Select “Robots”
2. Locate the robot named “TESTER”
  a. Either in the “Most recent” section
  b. Or in the “Saved Robots” section”
3. You will arrive to the configuration screen

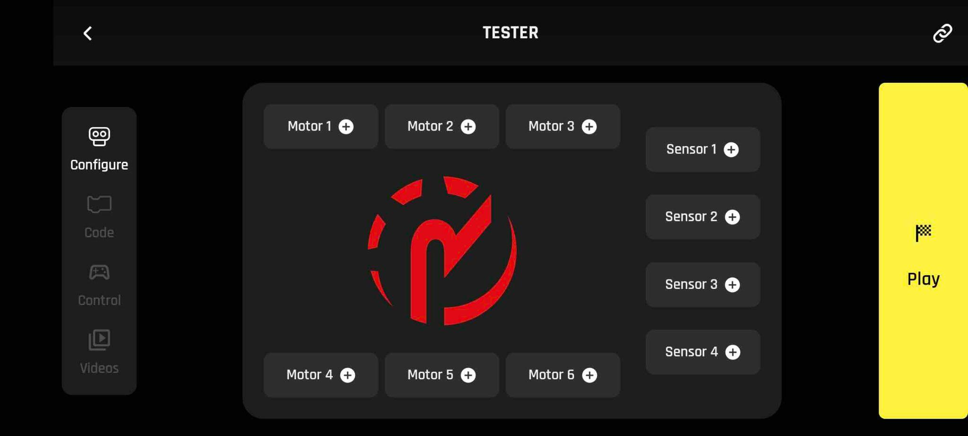
[picture p147: figure]
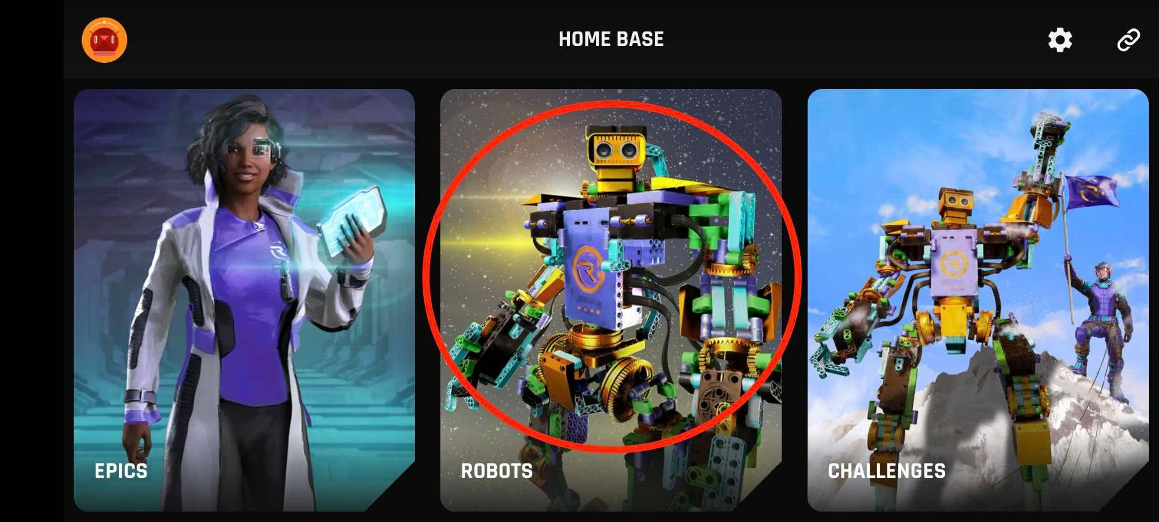
[picture p148: figure]

2b

2a

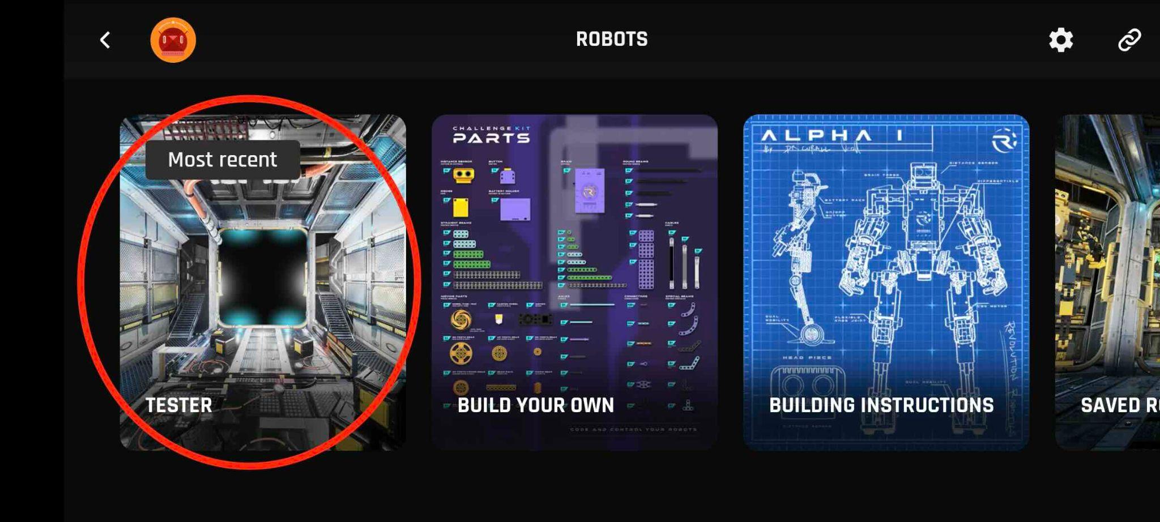
[picture p149: figure]
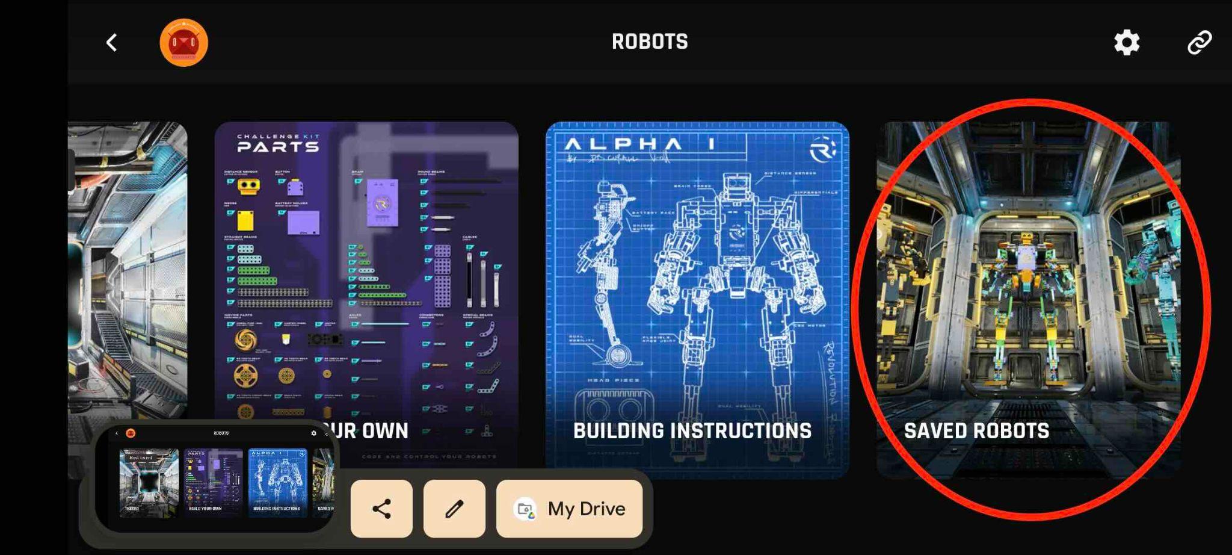
[picture p150: figure]
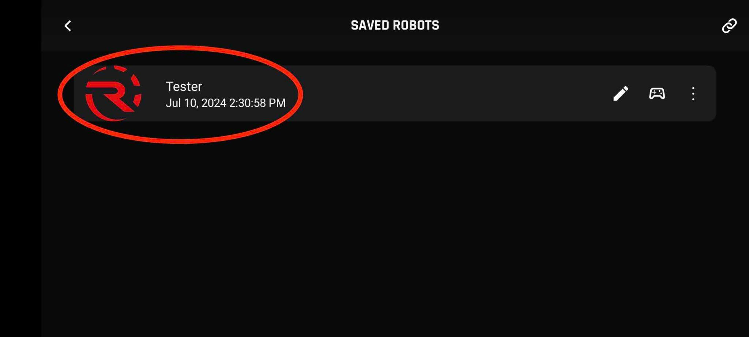
[picture p151: figure]

## 4) Turn on the brain

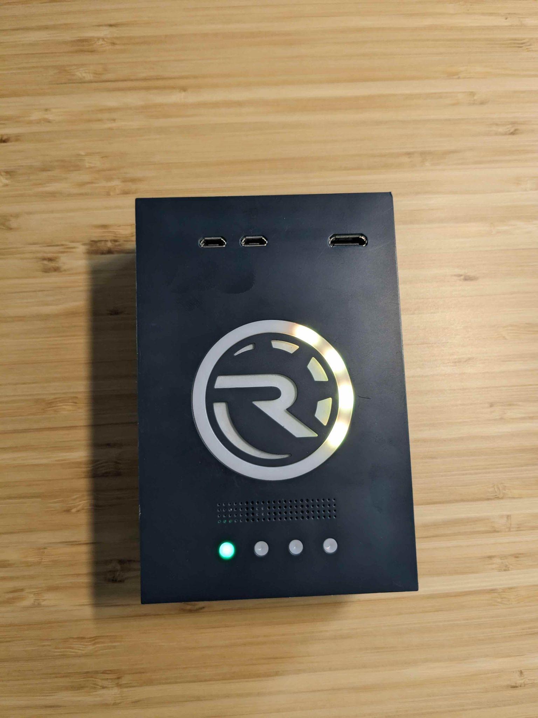
[picture p152: figure]
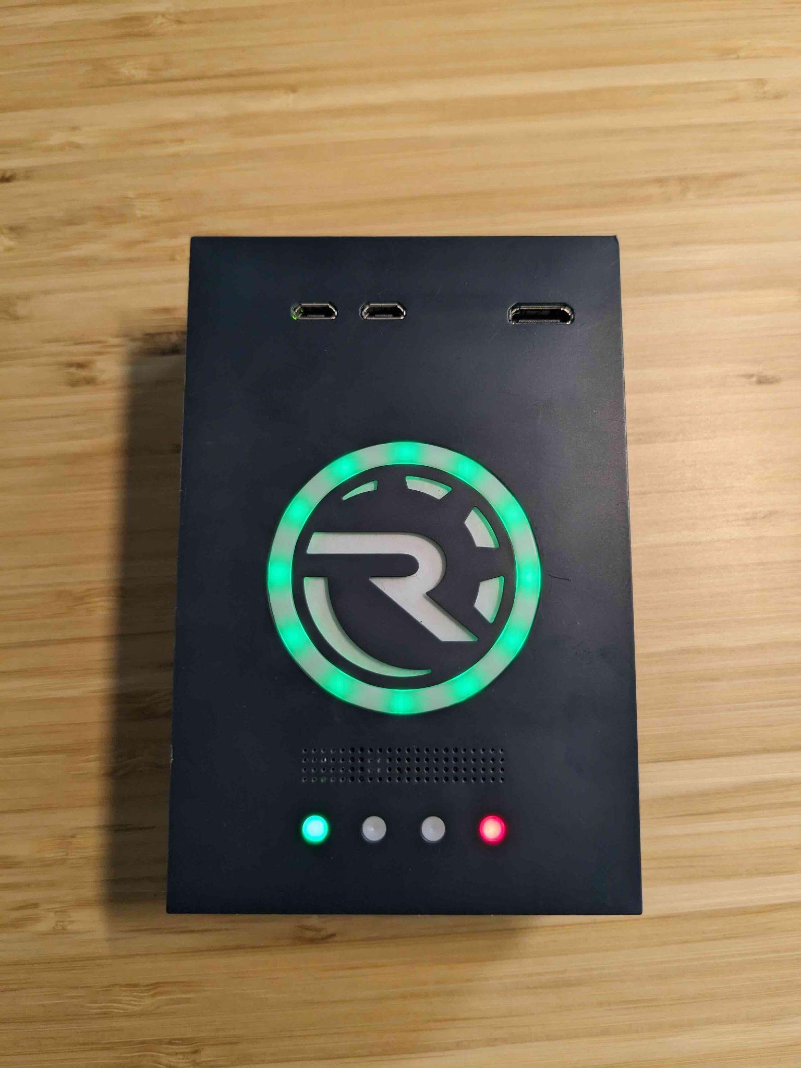
[picture p153: figure]

1. Wait for the loading sequence (yellow light goes round)
2. Wait until all LEDs are green, fading in and out. Also there will be a confirmation sound by the robot.

## 5) Connect to the brain

1. Connect to the brain by clicking on the chain icon on the top right of the screen
2. Select the brain ID (Note: it will be different for every brain)
3. Wait for connection.The robot will make a sound and the chain icon will turn blue

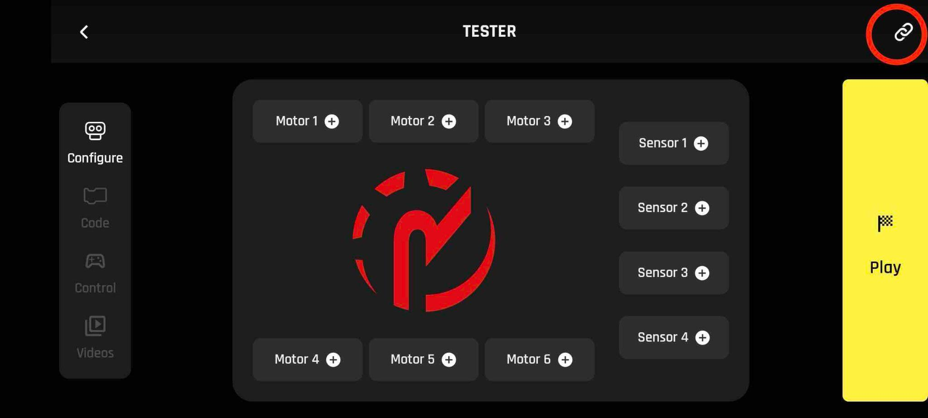
[picture p154: figure]
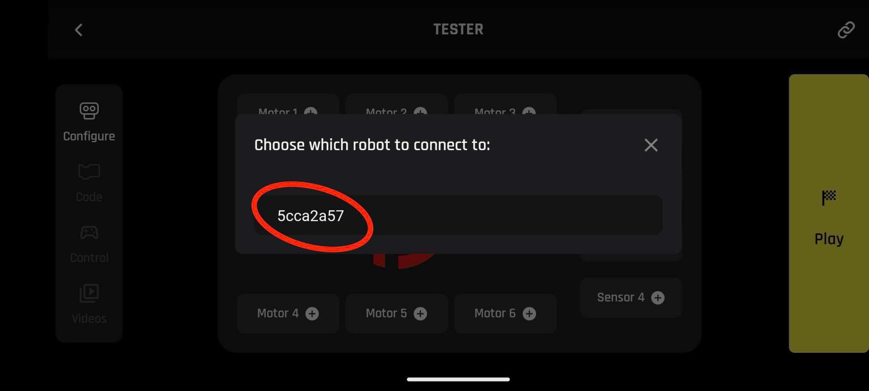
[picture p155: figure]
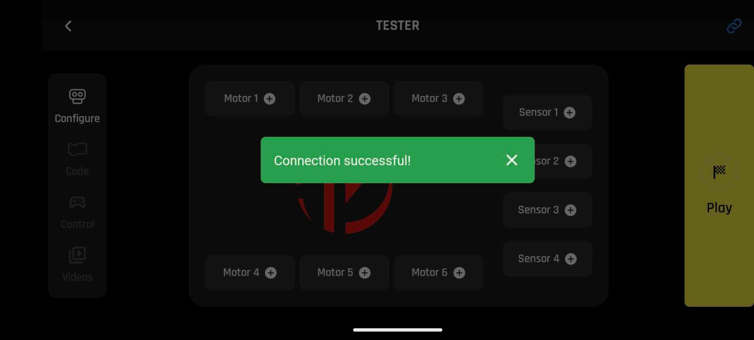
[picture p156: figure]
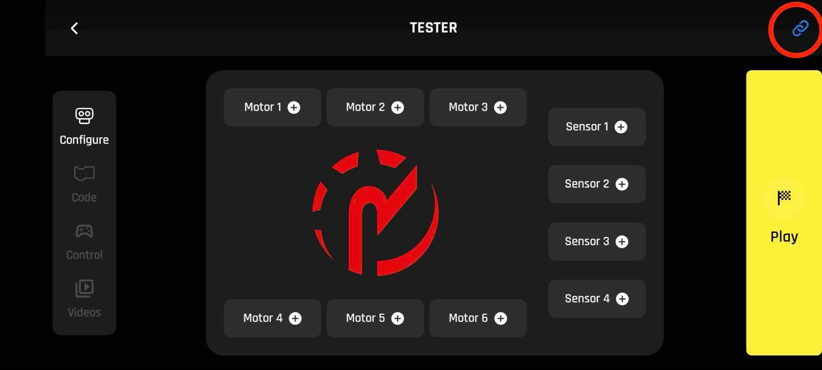
[picture p157: figure]

## 6) Enter play mode

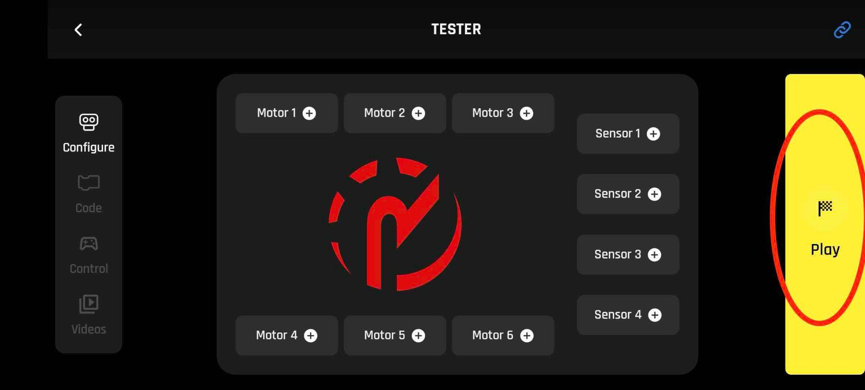
[picture p158: figure]

1. Click “Play”
2. A joystick should appear with one program called “Lights”

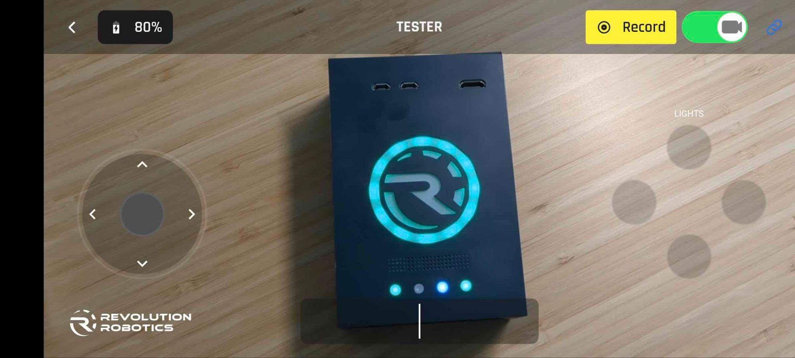
[picture p159: figure]

## 7) Run the program

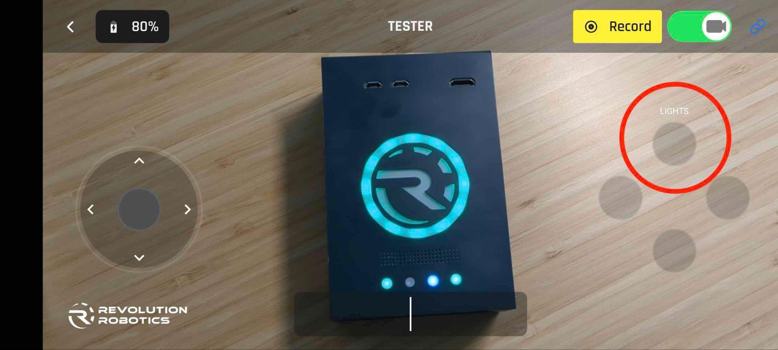
[picture p160: figure]

1. Click on the program called “Lights”.
2. A single blue LED should go round and round in the circle indicating that the program is running

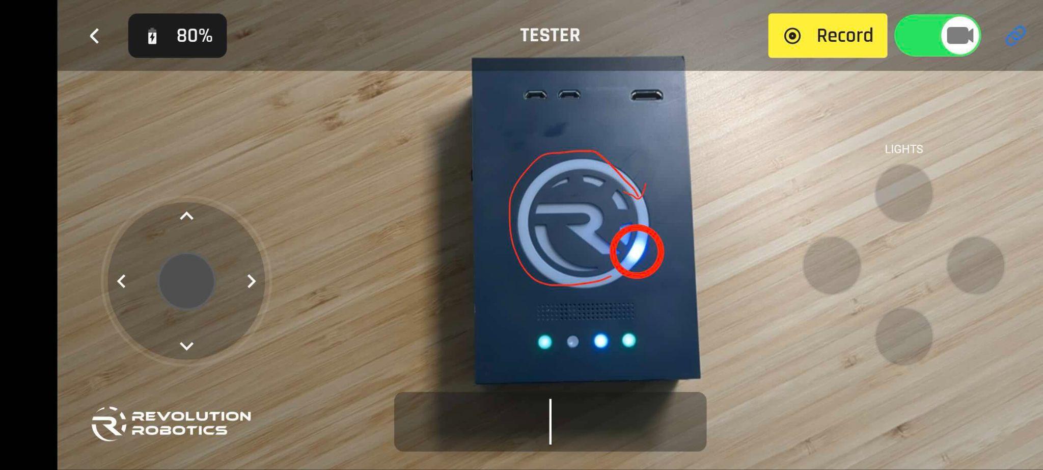
[picture p161: figure]

## 8) Do the measurements

While the blue LED goes in circles, Bluetooth connection is continuous between the phone / tablet and the robot.
