STEAM-Academy-PRO/revolution-robotics-kit/electronic parts/BR - Brain/Brain-v1-production/C sample [Pre-Production]/Brain assembly instructions/Assembly instructions.pptx

## Revolution Robotics

Brain (BRbeta) assembly instructions

## Step 1: Start with top cover (BRcA_1)

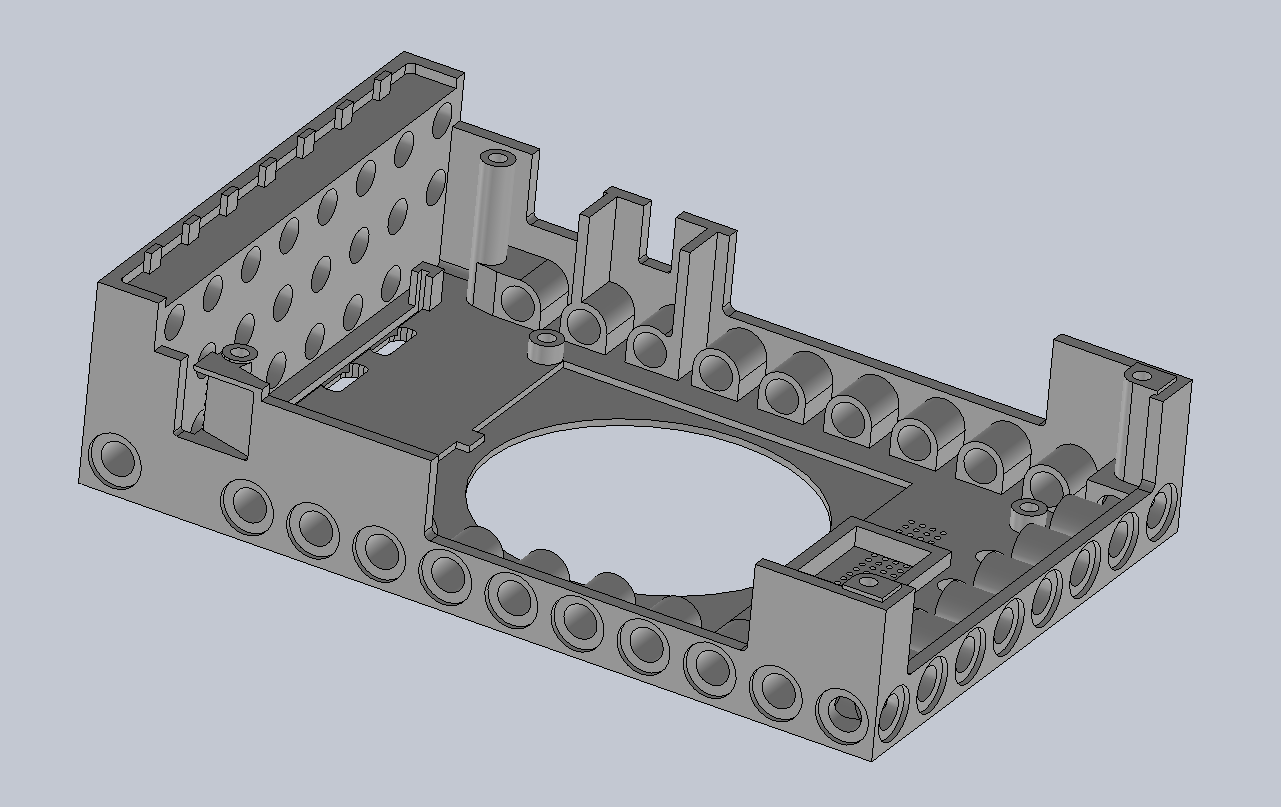
[picture p162: figure]

## Step 2: Attach transparent ring (BRcA_4) and light pipes (BRcA_5)

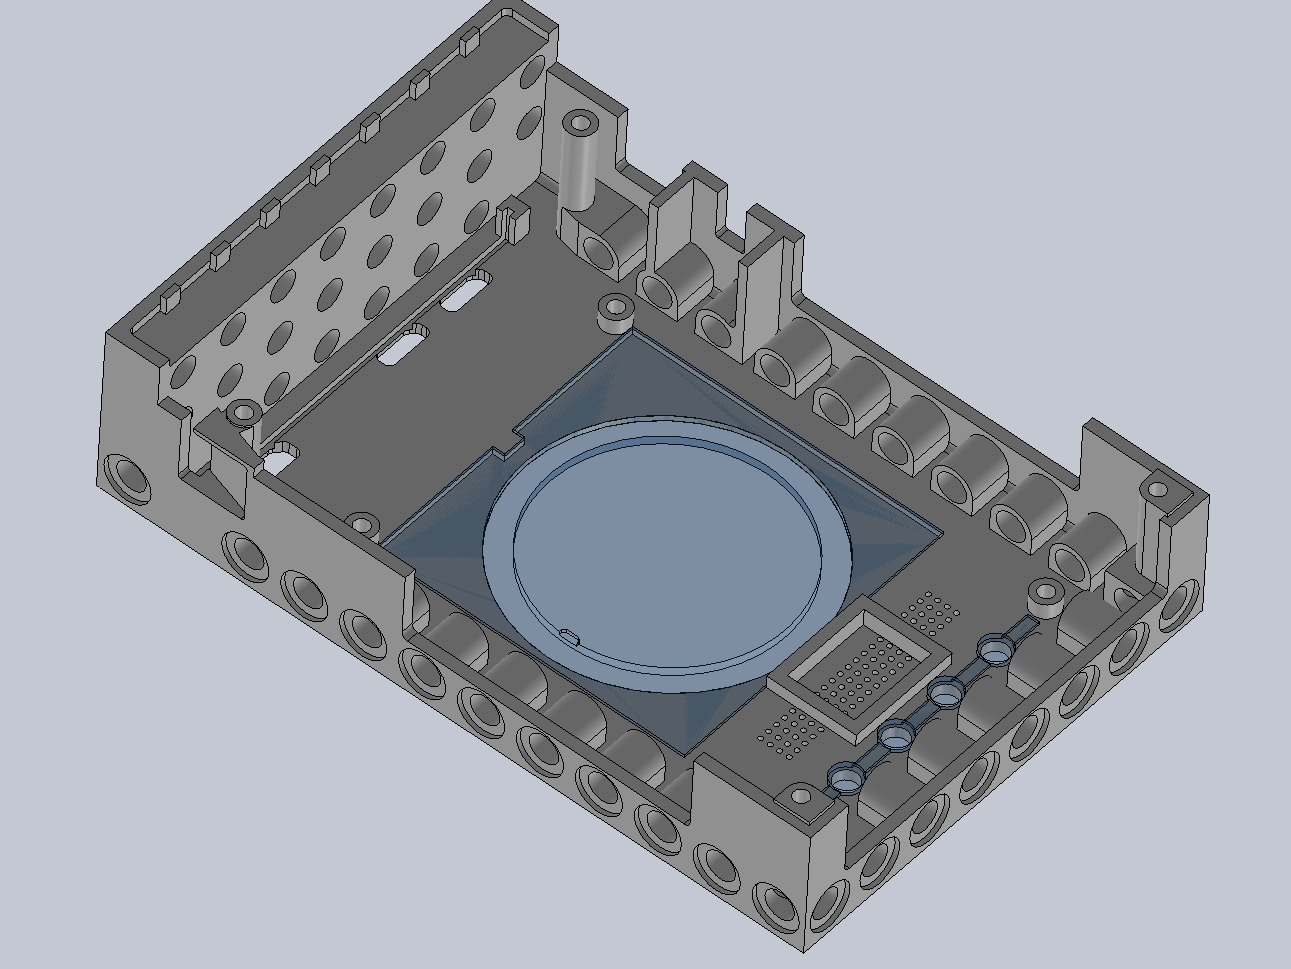
[picture p163: figure]

## Step 3: Insert red-black sticker

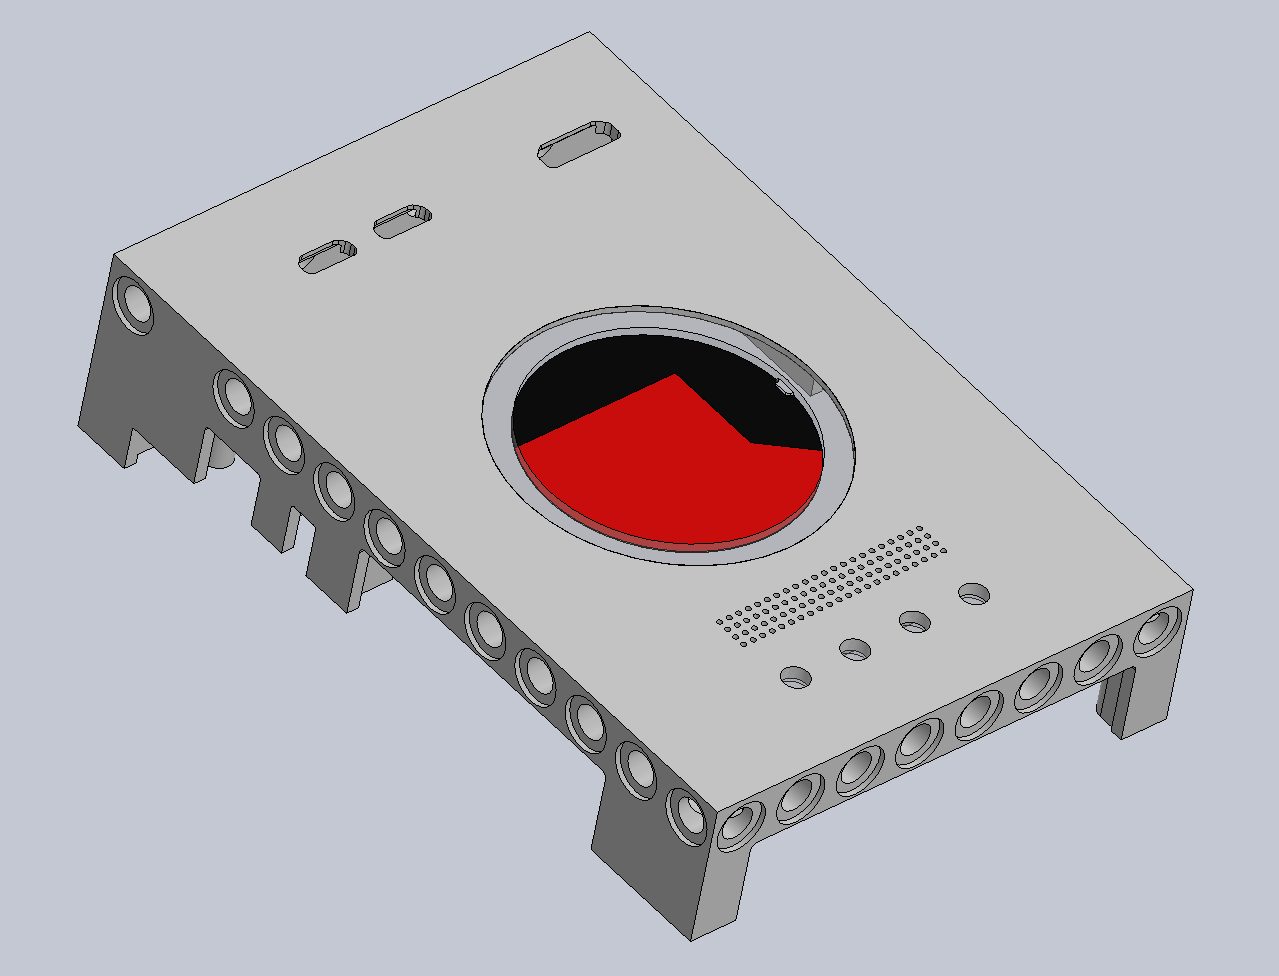
[picture p164: figure]

## Step 4: Add logo part (BRcA_3)

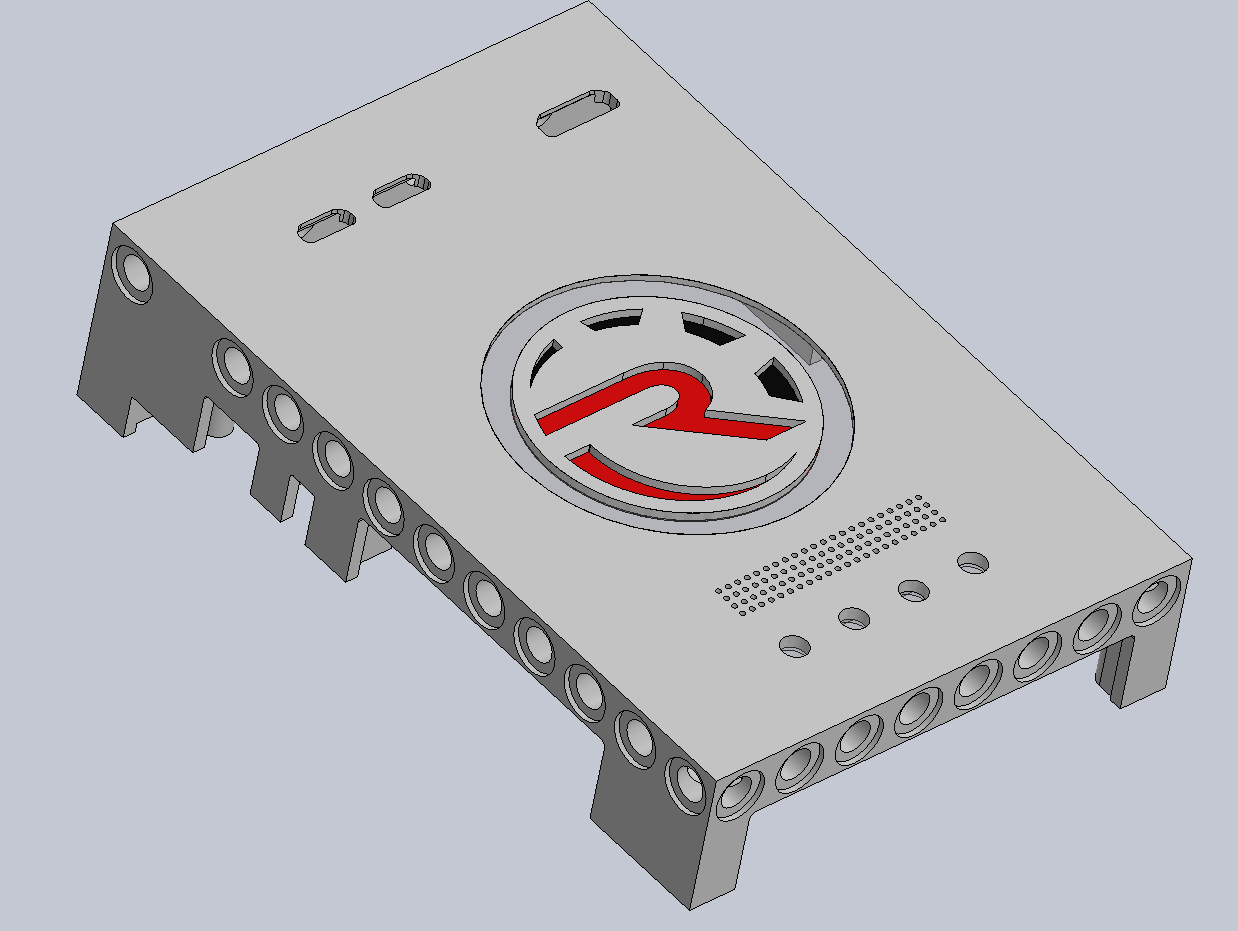
[picture p165: figure]

## Step 5: Insert LED board

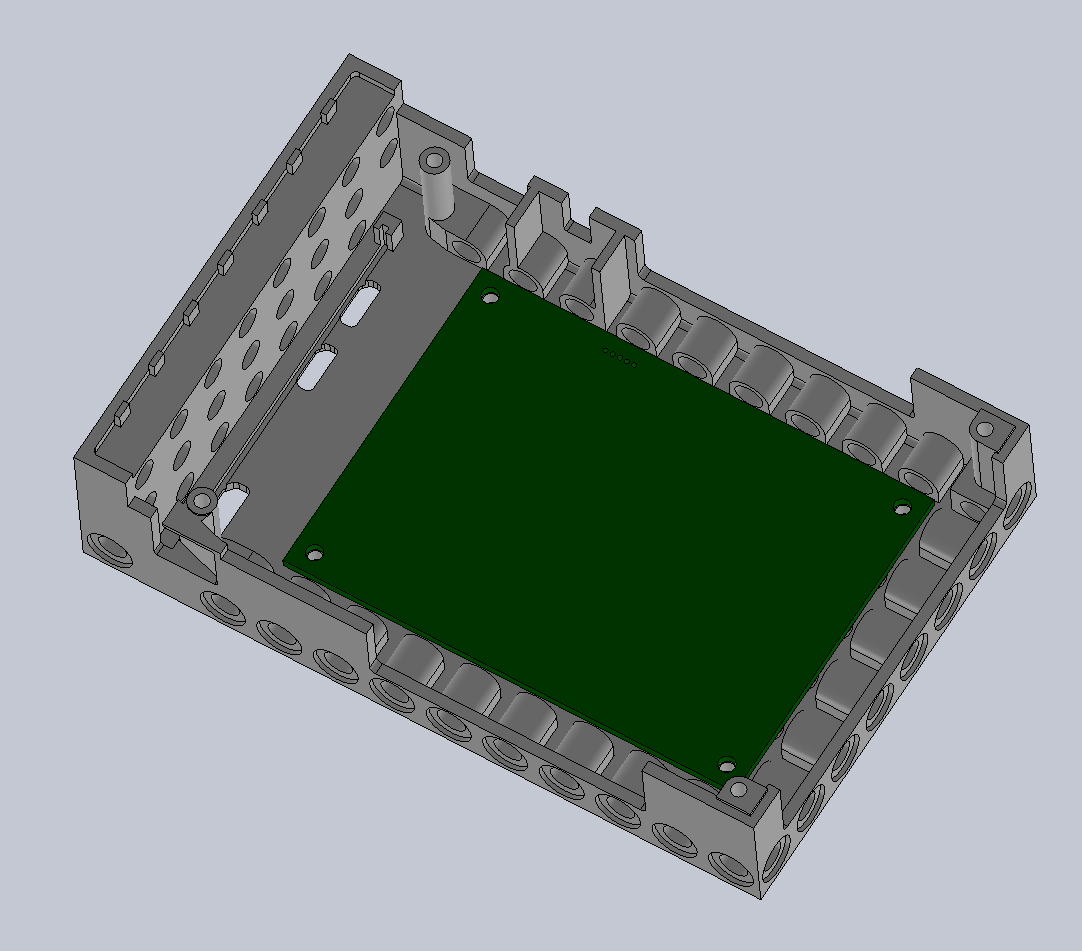
[picture p166: figure]

## Step 6: Screw LED board

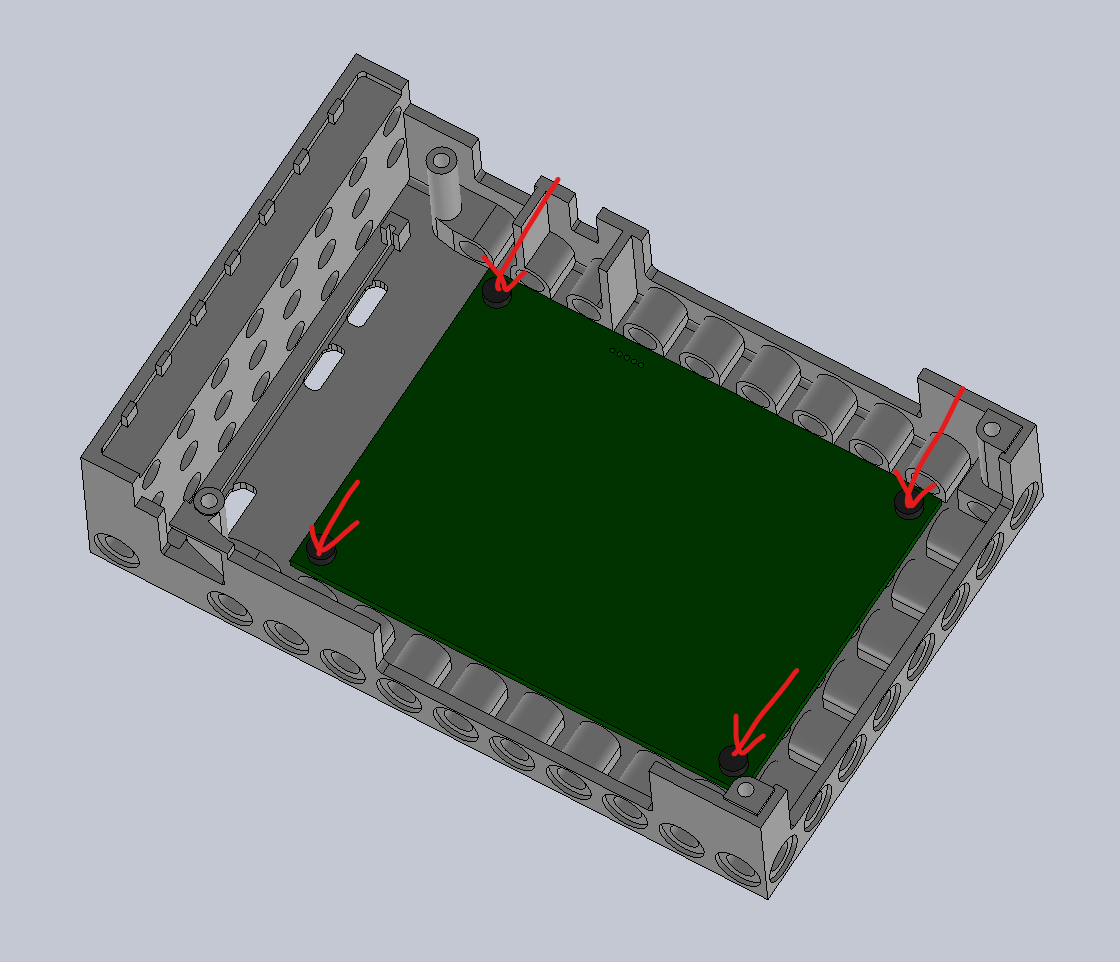
[picture p167: figure]

## Step 7: Use adhesive tape to attach battery to LED board

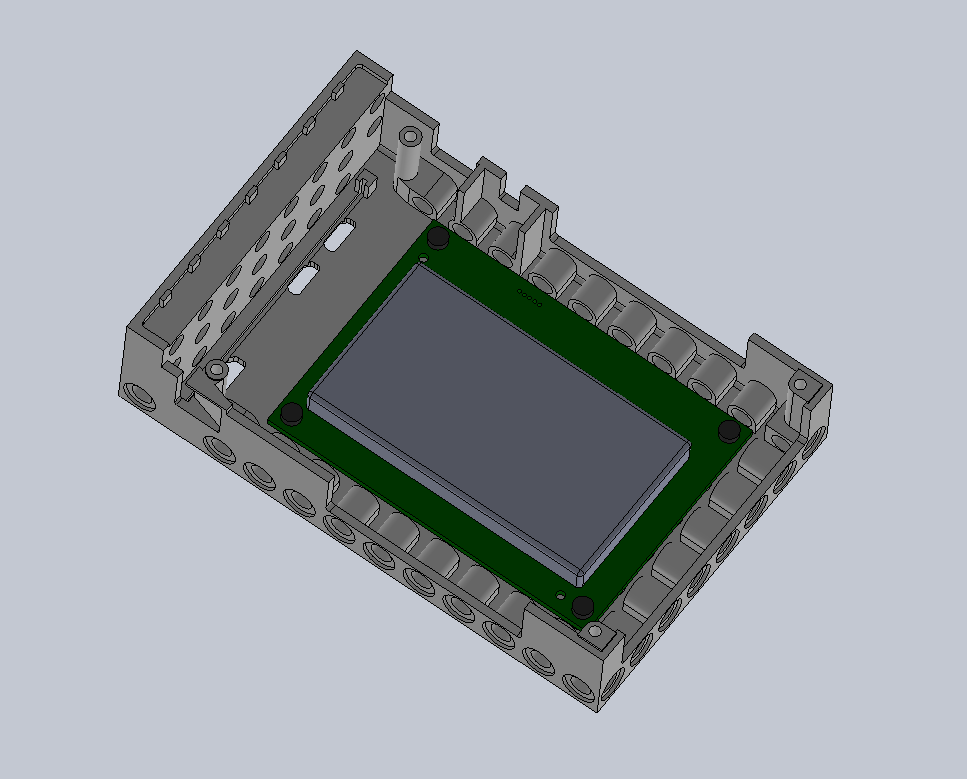
[picture p168: figure]

## Step 8: Assemble carrier board with Raspberry Pi Zero W

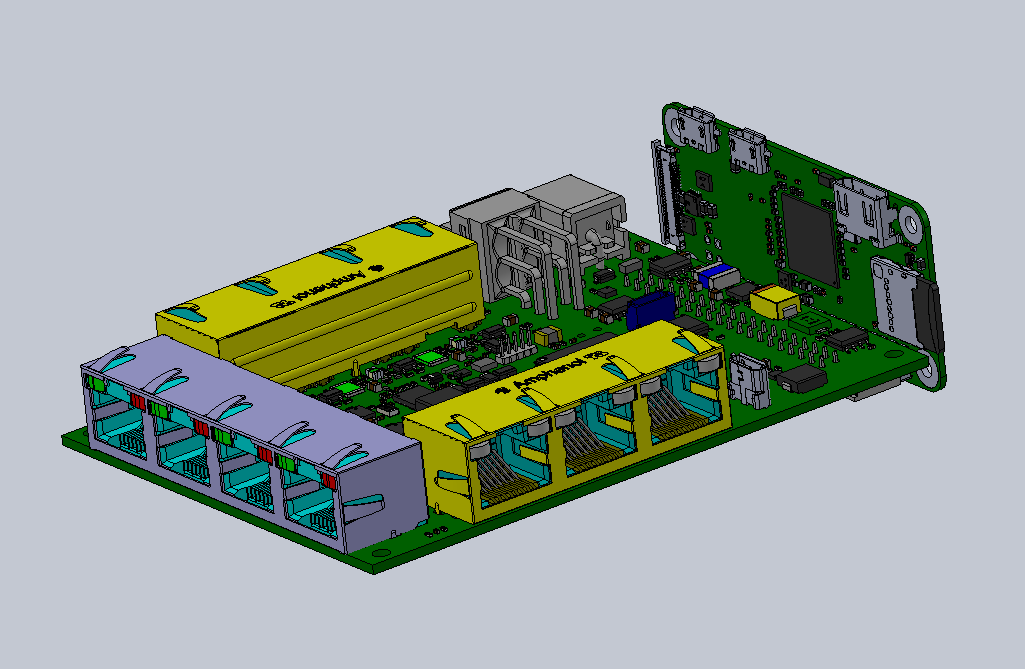
[picture p169: figure]

## Step 9: Connect LED board and battery wires

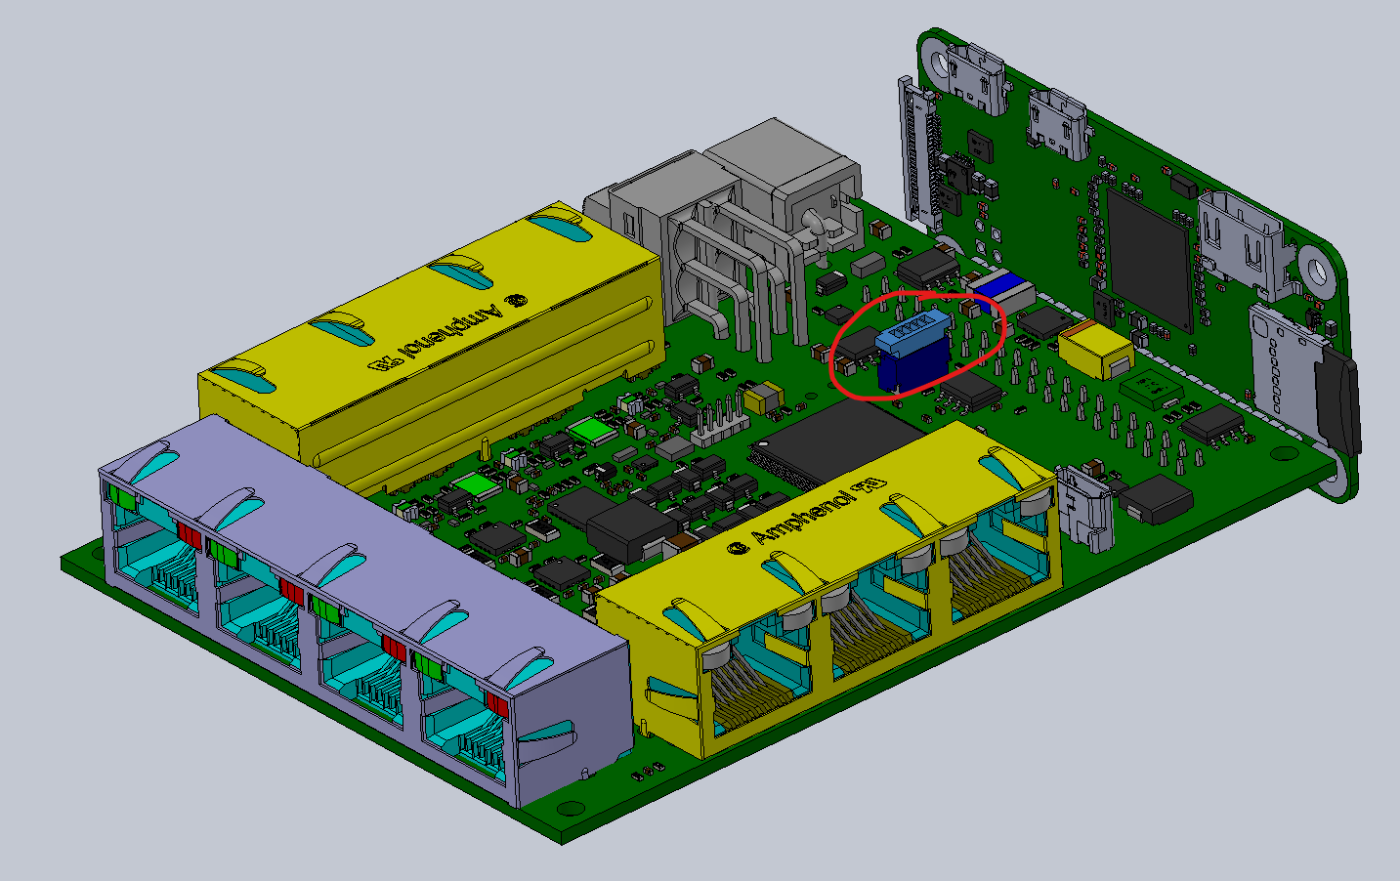
[picture p170: figure]
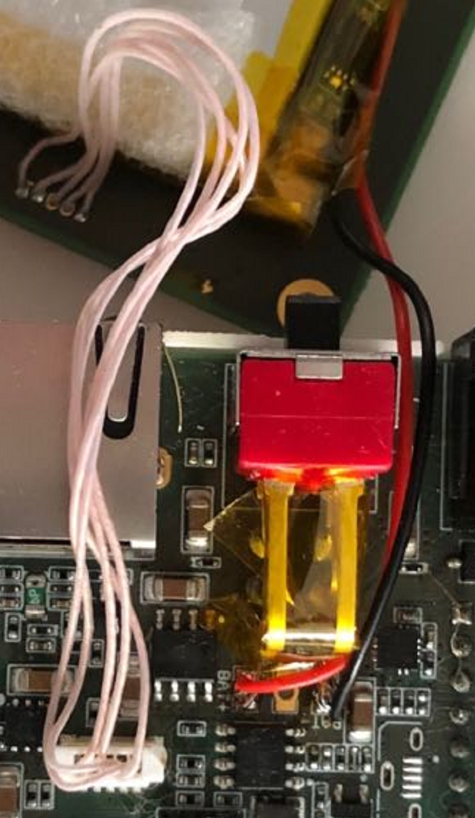
[picture p171: figure]
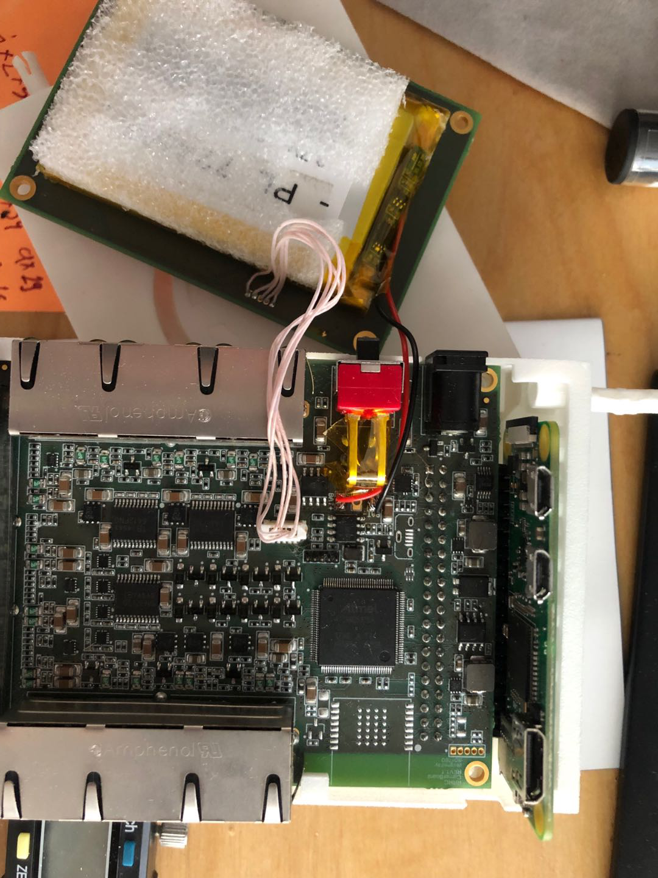
[picture p172: figure]

## Step 10: Insert carrier board to top cover

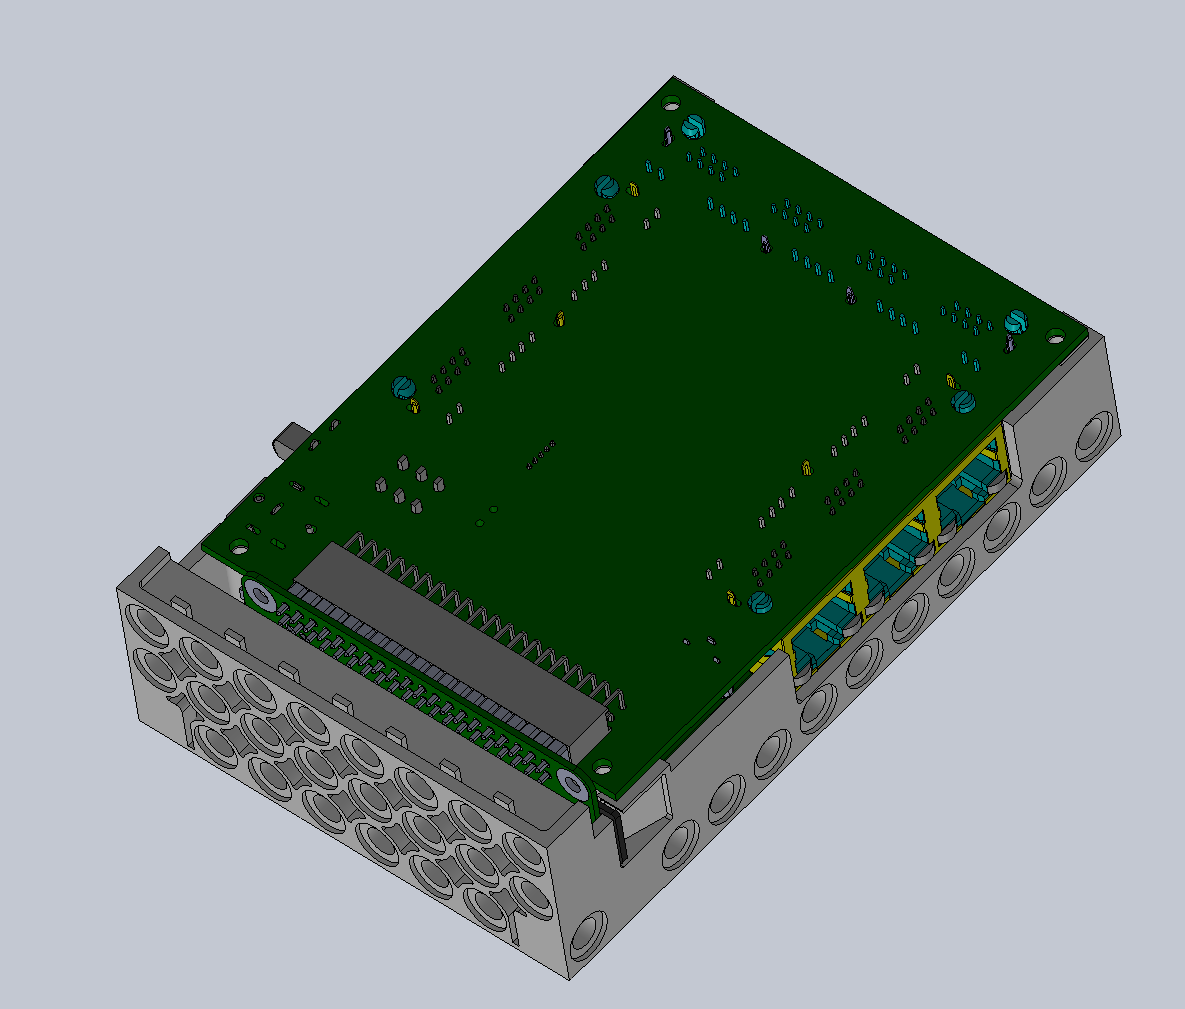
[picture p173: figure]

## Step 11: Add plastic sheet (BRcA_6) to bottom cover (BRcA_2)

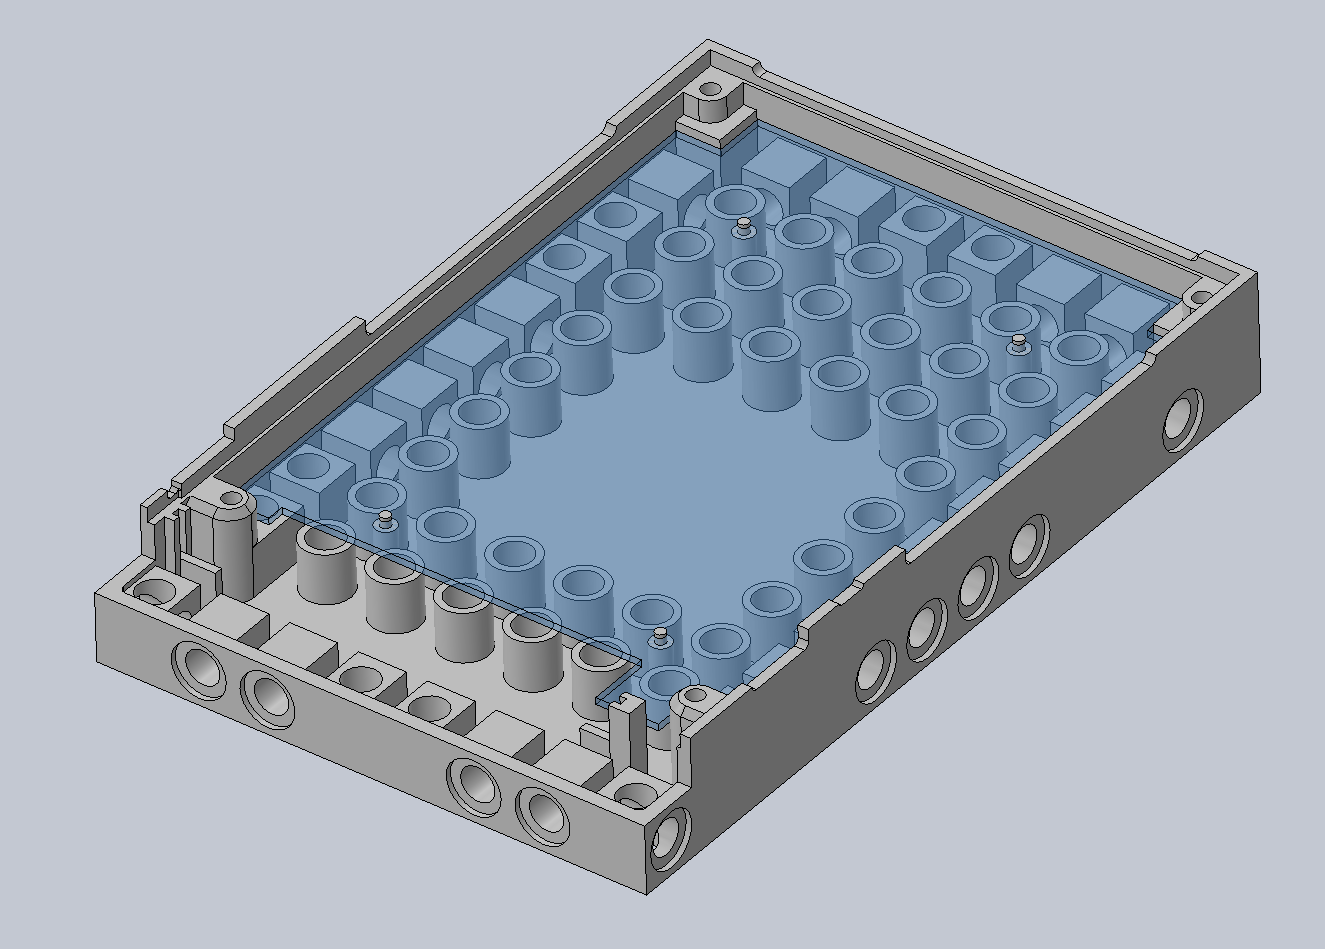
[picture p174: figure]

## Step 12: Attach bottom cover to top cover

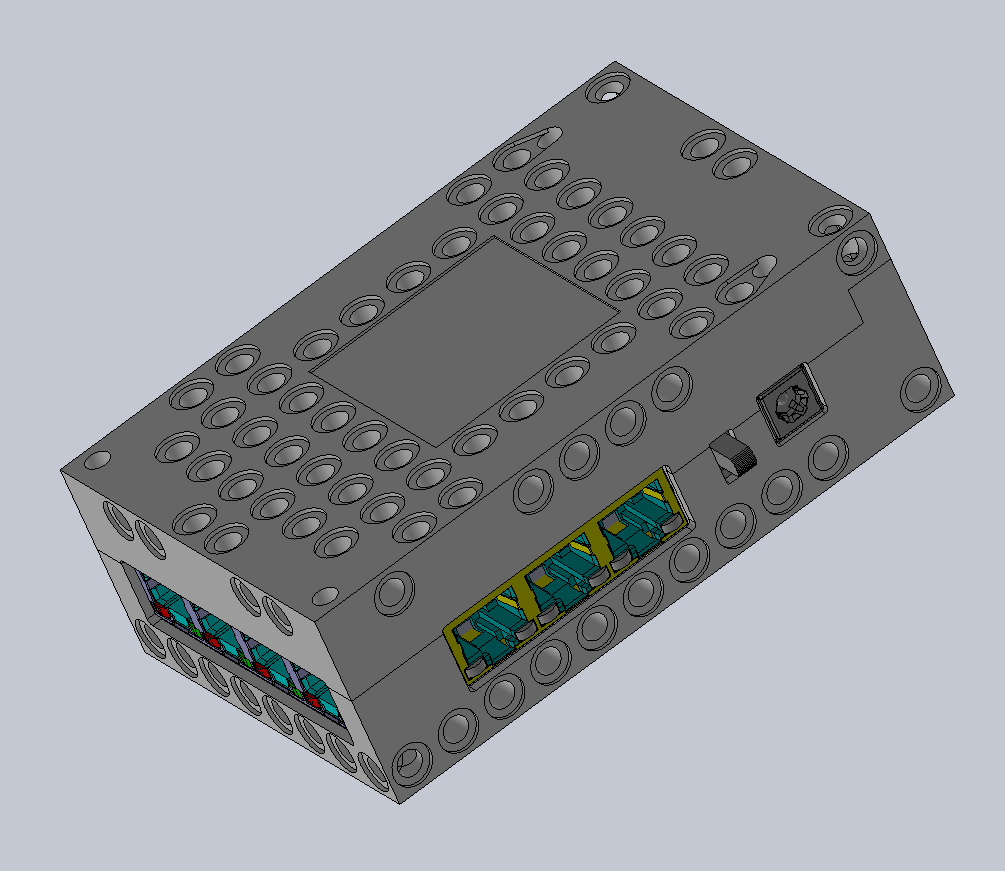
[picture p175: figure]

## Step 13: Screw bottom part to top cover

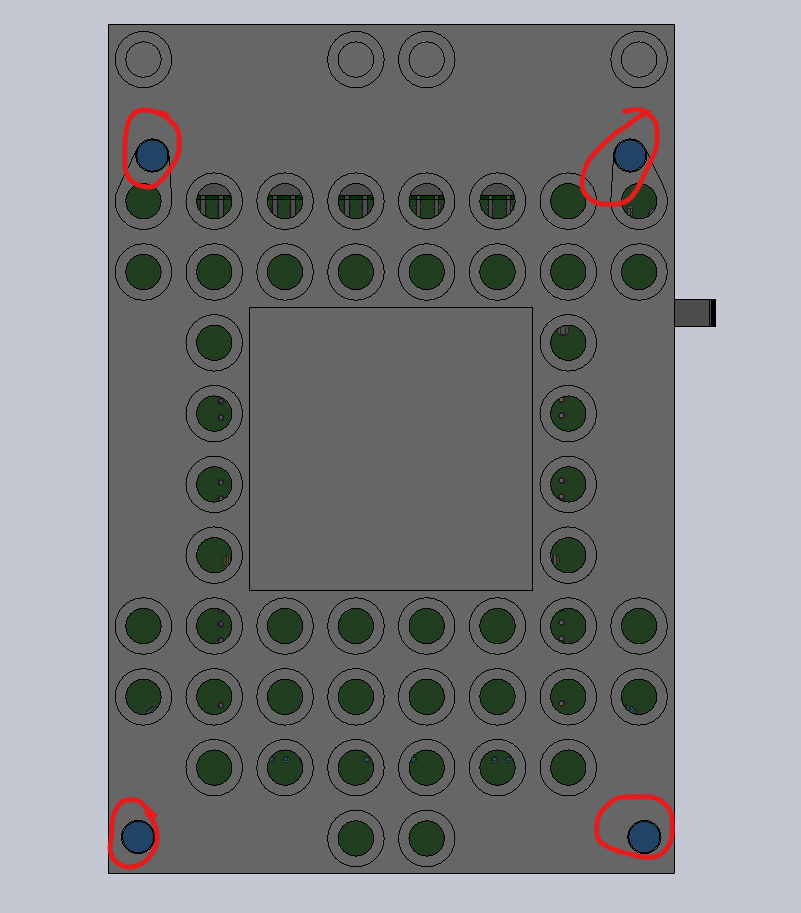
[picture p176: figure]
