STEAM-Academy-PRO/revolution-robotics-kit/electronic parts/BR - Brain/Brain-v1-production/C sample [Pre-Production]/Programming instructions/Programming Instructions.pptx

## Revolution Robotics Foundation

Firmware upload with JFlash Lite

## Connecting the JLink Mini debugger

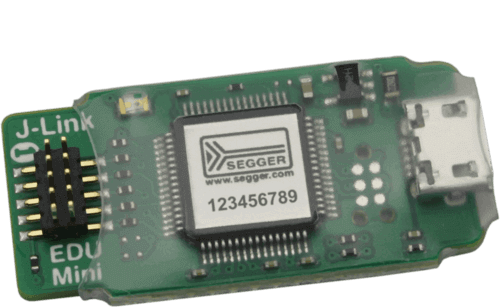
[picture p177: figure]
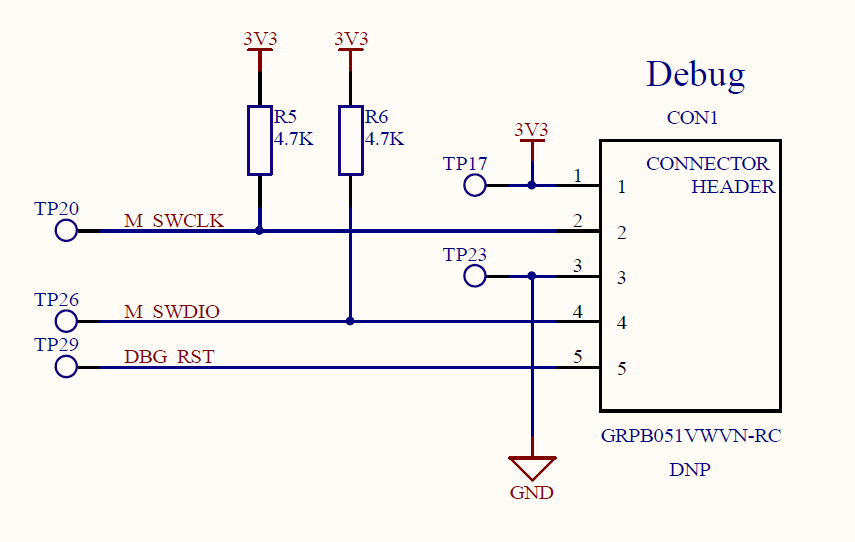
[picture p178: figure]
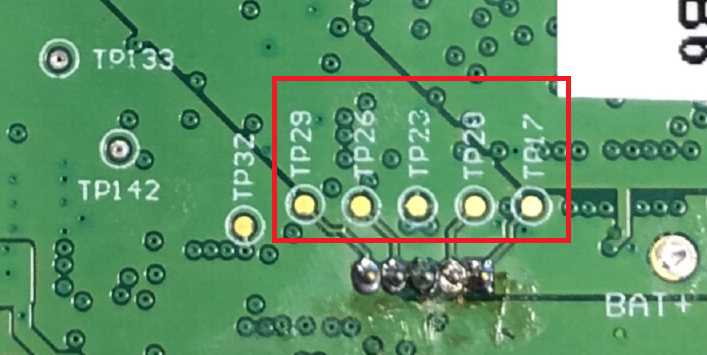
[picture p179: figure]
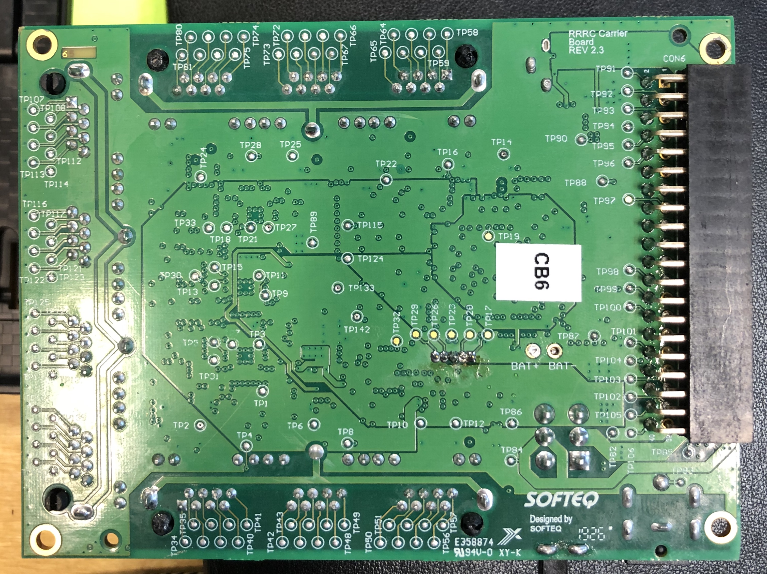
[picture p180: figure]
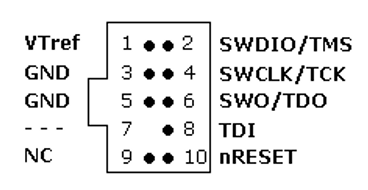
[picture p181: figure]

You have to connect debugger pins:
- Pin 1 to TP17
- Pin 2 to TP26
- Pin 3 to TP23
- Pin 4 to TP20
- Pin 10 to TP29

Please note, that you can flash the MCU firmware only when MCU is powered on!

## Using JLink command line tool for flashing

- 1) Install JLink_Windows_V644g.exe
- 2) Run our flashbl2.bat file (make sure that rrrc_bootloader.bin is next to the flashbl2.bat)

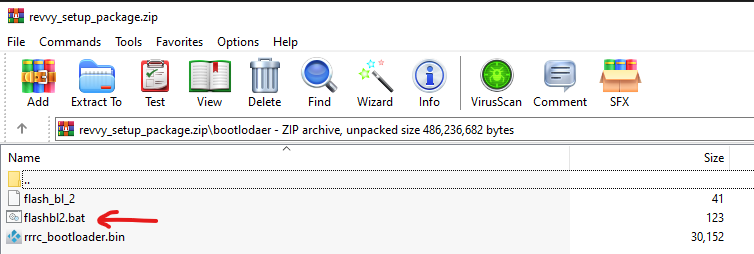
[picture p182: figure]

## Burn Raspberry PI TF card I.

- Download etcher: https://www.balena.io/etcher/
- Install etcher

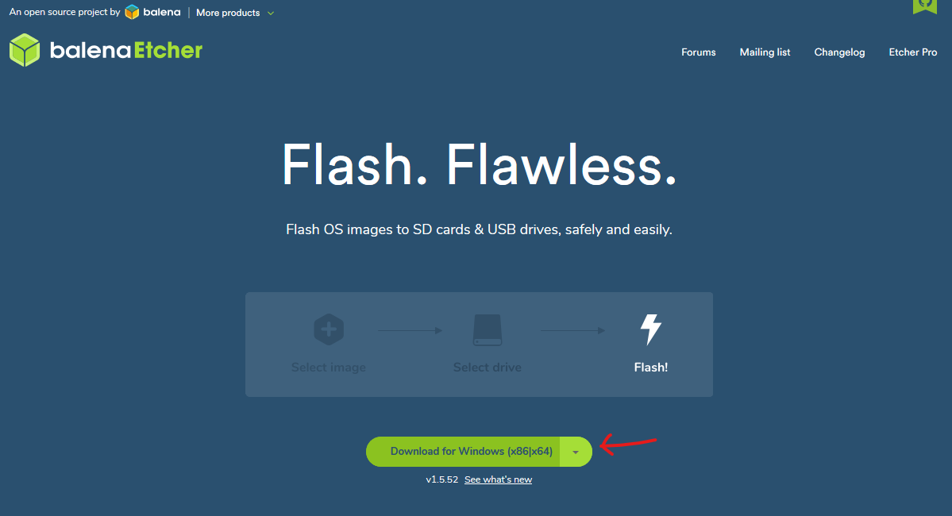
[picture p183: figure]

## Burn Raspberry PI TF card II.

- Select our image:
- Select target TF card:
- Press Flash!

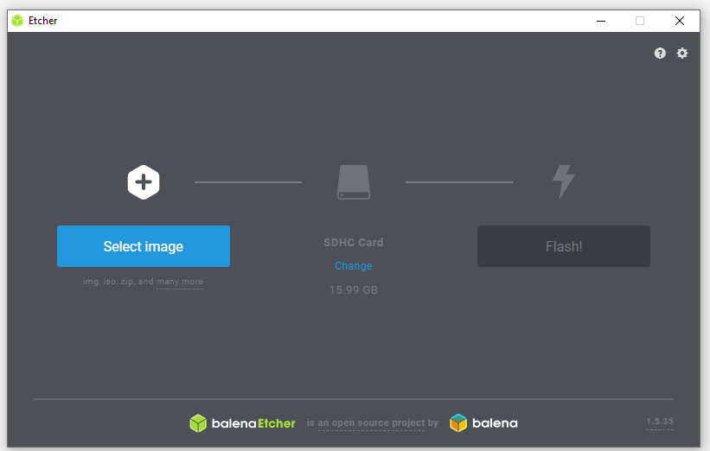
[picture p184: figure]
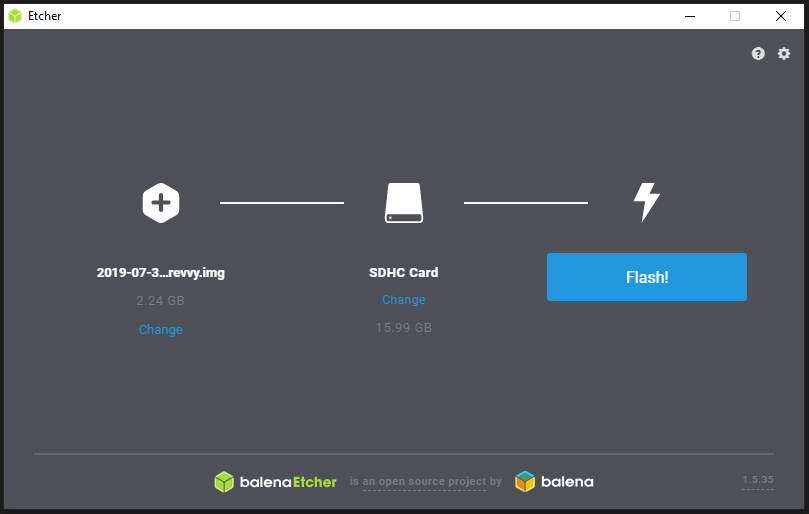
[picture p185: figure]
