STEAM-Academy-PRO/revolution-robotics-kit/electronic parts/BR - Brain/Brain-v1-production/B sample/PCB/0437客户RRRC_LEDsBoard_manufacturing_v2.2_20190610工程咨询 ENG EQ(02AE21418A0)_answered.xls

广东科翔电子科技有限公司
工程咨询/ENG EQ
To : Marketing / |  |  |  |  | DATE : | 2019-06-13
From : ME / | 陈谨异 |  |  |  | EQ S/NO : | 1
CC : | 曾攀/胡座泉
Customer : | 0437 |  | In-House P/No :
Customer P/No. : | RRRC_LEDsBoard_manufacturing_v2.2_20190610 |  | 02AE21418A0
为了避免交期延误，请在收到工程咨询后4小时内回复，否之交期将顺延！ (注意：图片放大后会更清晰) |  |  | Customer Comments
 |  |  | 如不同意，请填写其它建议/if NO, Pls add suggestion
EQ1:此项目我司未找到相关阻抗管控信息，我司认为此板无需阻抗管控。请确认！/EQ1: This project did not find relevant impedance control information, whether this board is not need impedance control. pls confirm
 |  |  | 建议/suggestion：
EQ2:如下图，高亮处的孔，和各线路层均有连接，孔径表上定义为NPTH属性，我司建议按实际Gerber资料为准，高亮处4个孔按PTH孔属性制作，请确认！ EQ2: See figure, the highlighted four holes and each circuit layer are connected. The aperture table is defined as the NPTH attribute. We suggest to follow the actual Gerber data. The highlighted four holes will make per the PTH hole properties. pls confirm!
 |  |  | 建议：/suggestion：You can make them plated
EQ3:关于标记，为方便追溯，建议在字符层添加我司厂标、UL及生产周期，以厂内常用“YYWW"制作（Y-年，W-周），具体位置由我司自定，请确认？ EQ3: Marking, for easy traceability, can we add our factory standard, UL and production date code in the character layer, date code in "YYWW" , the position is customized by us, pls confirm?
 |  |  | 建议suggestion：
EQ4:由于贵司未提供拼版图，附件为我司设计的拼板图，请确认是否可行？（ 请考虑贵司贴片后元器件是否有碰撞等，如不可行，请贵司指正修改或拼版图给我司） EQ4: Since you have not provided imposition map, attachment is a puzzle map designed by our company,Pls confirm if it is ok? (Pls check if there are any collisions in the components after patch, if it is not confirm, pls modify or provide the imposition map to us)
 |  |  | 建议suggestion：
EQ5:贵司提供的制作标准不全或制作标准过于严格，为方便我司制作，建议依我司常规制作， 孔径公差: PTH±3mil(via孔忽略)，NPTH±2mil 成型公差 ±5mil， 金厚min0.025um，镍厚min2.54um,， 通孔孔铜：min 0.7mil ； 线宽/线距公差：≥4.0mil:+/-20%； 板弯翘最大：0.75%， 防焊厚度：10-50um 其他未明确我司建议按IPC-A-600G CLASS2标准制作，请确认是否可行？ EQ5: Sugest to follow our regular production standards. The production standards provided by your company are incomplete or too strict. Aperture tolerance: PTH ± 3mil (via hole ignored), NPTH ± 2mil Molding tolerance: ±5mil, Gold thickness: min0.025um, nickel thickness min2.54um, Through hole copper: min 0.7mil; Line width / line spacing tolerance: ≥ 4.0mil: +/- 20%; The maximum bending of the board is : 0.75%. Solder mask thickness: 10-50um Others not listed, we will follow IPC-A-600G CLASS2 standard, please confirm
 |  |  | 建议suggestion：
Approved by :
Name : |  | Phone No.: |  | Date :
Form No.: XY-SOP-ME-01/02 |  |  |  |  |  | Rev.:B/00
