STEAM-Academy-PRO/revolution-robotics-kit/certificates/Documentation/User-manual/4A-select-build-instructions.jpeg

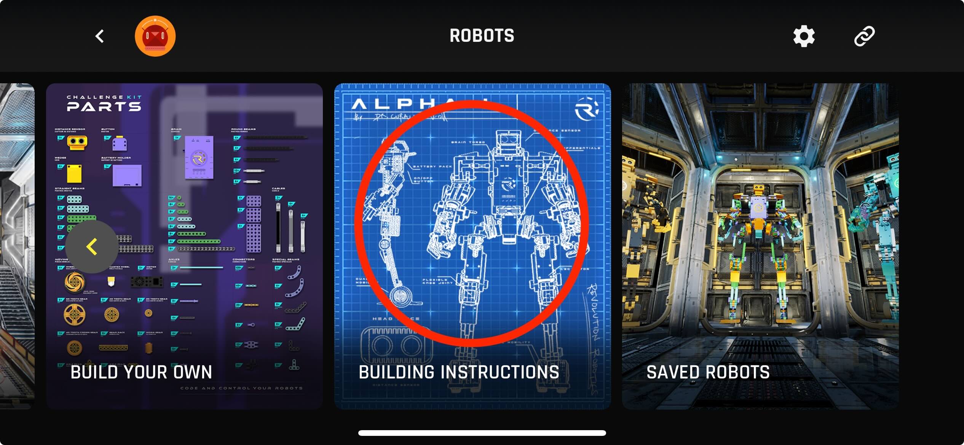
certificates/Documentation/User-manual/4A-select-build-instructions.jpeg
