STEAM-Academy-PRO/revolution-robotics-kit/certificates/Documentation/User-manual/4B-Select-Revvy.PNG

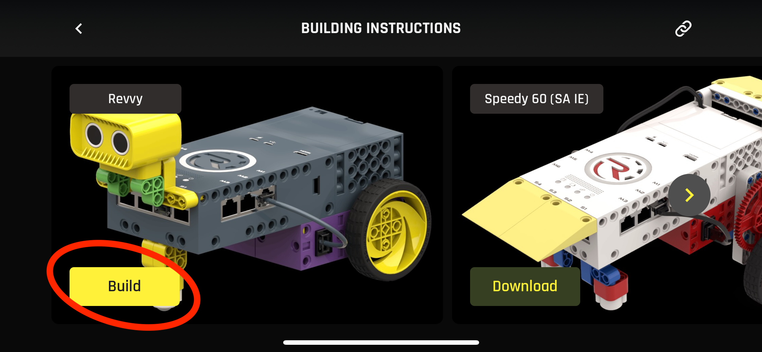
certificates/Documentation/User-manual/4B-Select-Revvy.PNG
