STEAM-Academy-PRO/revolution-robotics-kit/certificates/Documentation/User-manual/5-Build-instructions.PNG

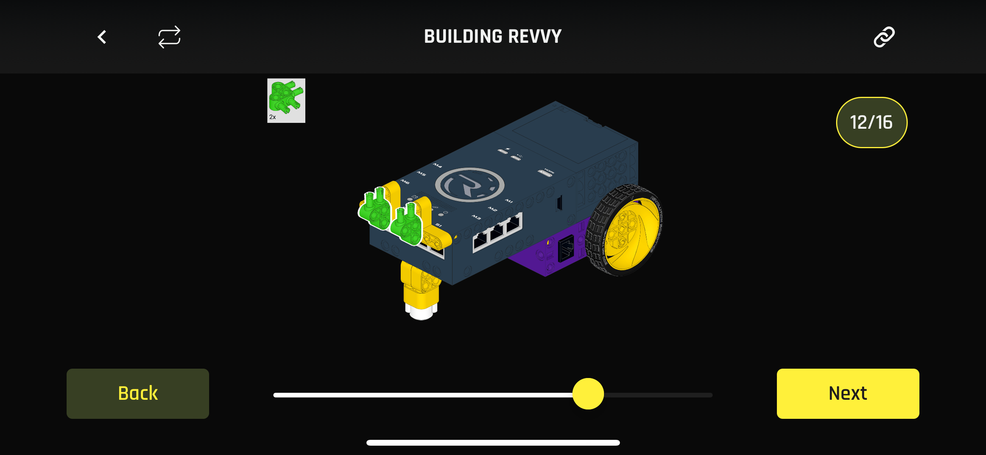
certificates/Documentation/User-manual/5-Build-instructions.PNG
