STEAM-Academy-PRO/revolution-robotics-kit/certificates/Documentation/User-manual/6-configuration-screen.jpg

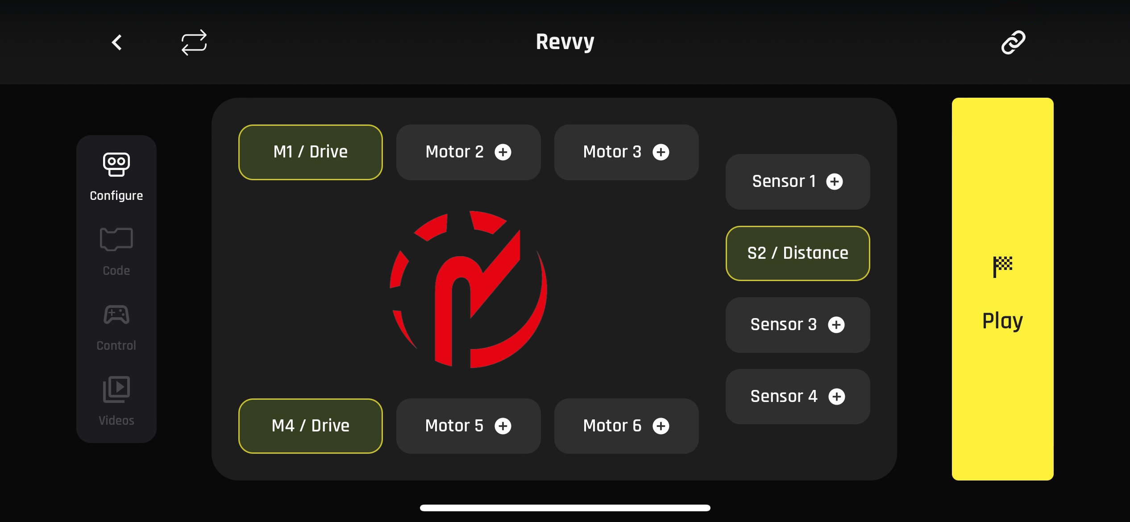
certificates/Documentation/User-manual/6-configuration-screen.jpg
