STEAM-Academy-PRO/revolution-robotics-kit/certificates/Documentation/User-manual/10-coding-screen.PNG

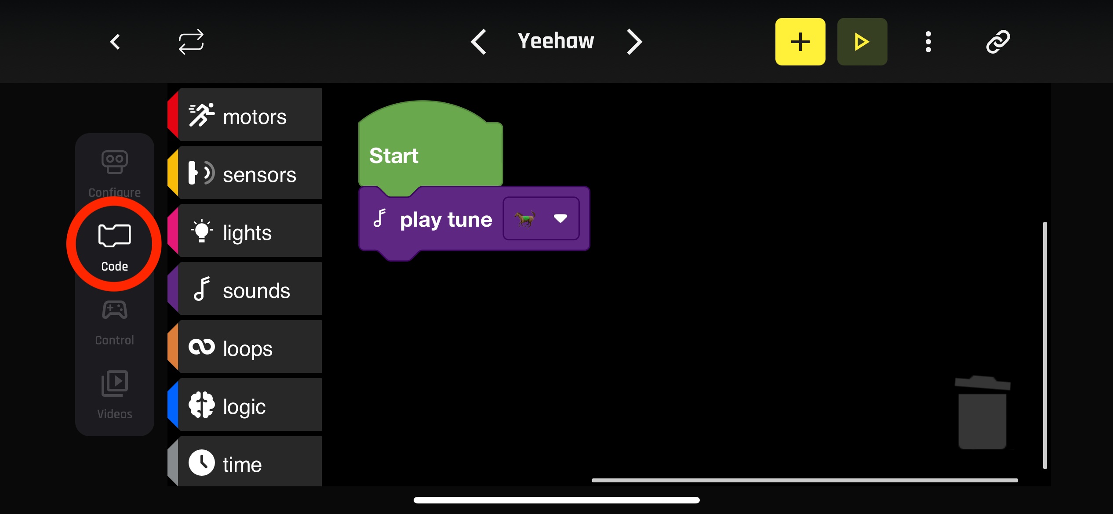
certificates/Documentation/User-manual/10-coding-screen.PNG
