STEAM-Academy-PRO/revolution-robotics-kit/certificates/Documentation/User-manual/11-controller.jpeg

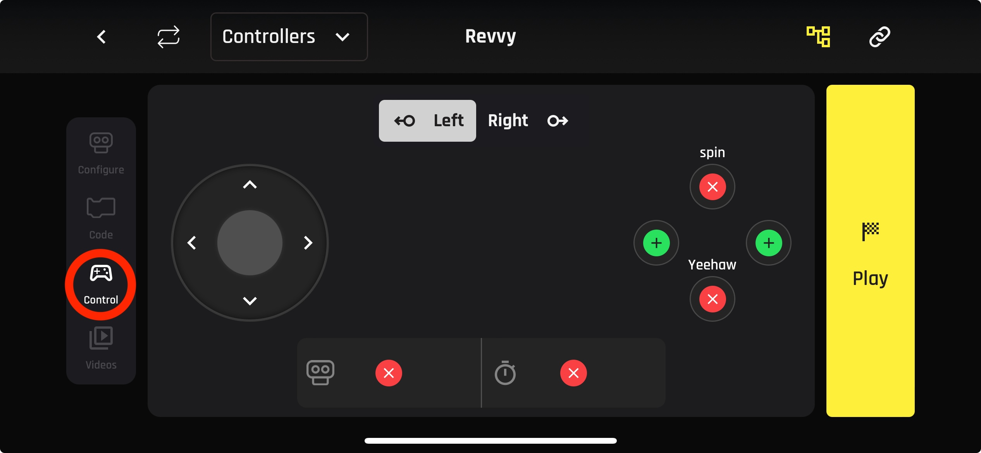
certificates/Documentation/User-manual/11-controller.jpeg
