STEAM-Academy-PRO/revolution-robotics-kit/electronic parts/BR - Brain/Brain-v1-production/C sample [Pre-Production]/Test/Production line test App.pptx

## Production line test App

Revolution Robotics Foundation

## Requirements

- Start the app directly on config screen with a play button
- Config can be autosaved
- No remote controller config
- Modified test codes for motors and sensors
- No blockly support, no support for multiple robots, no settings, etc
- Top menu buttons are unnecessary
- Only 2 screens are needed + Bluetooth modal
- Only android app!

## Screen 1 – Config screen

- Start the app here, no back button
- Add a play button
- Remove UI elements (red)

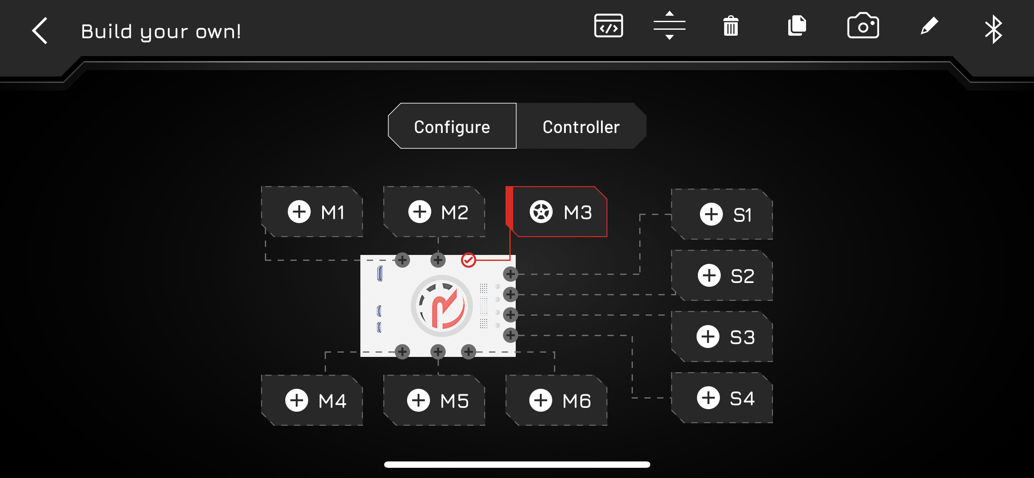
[picture p193: figure]

## Screen 2 – Remote controller

- Only for drivetrain test, buttons can be greyed out
- Back button to config screen

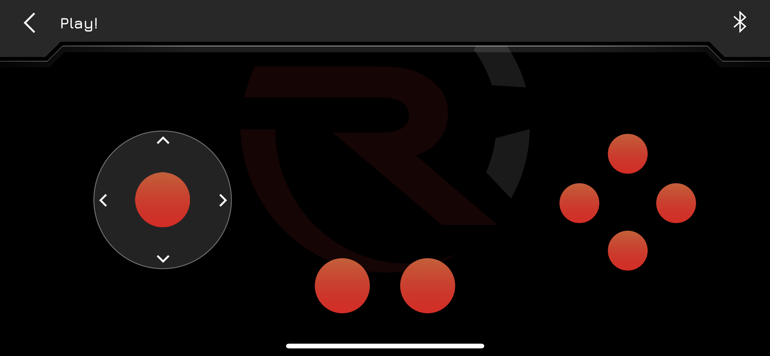
[picture p194: figure]

## Bluetooth connection modal

- Don’t need help screen, show devices immediately

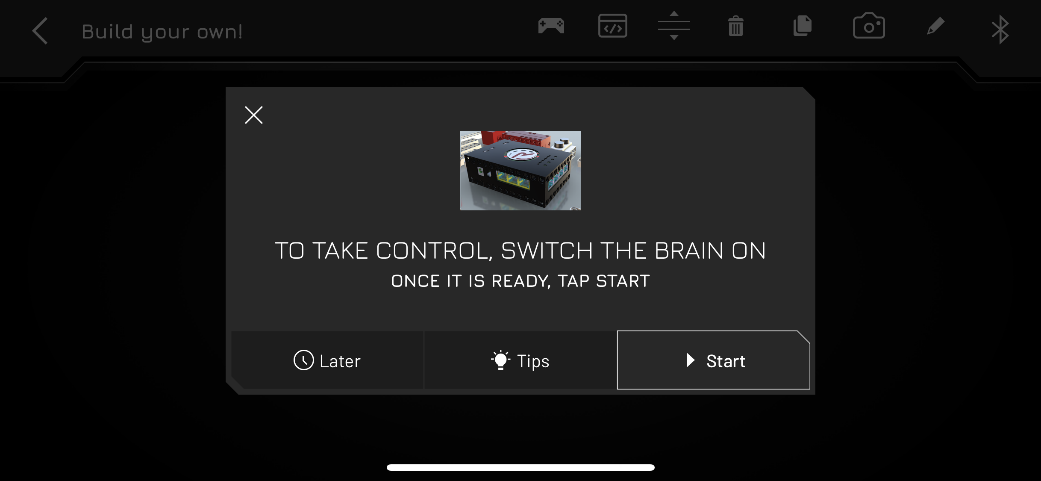
[picture p195: figure]
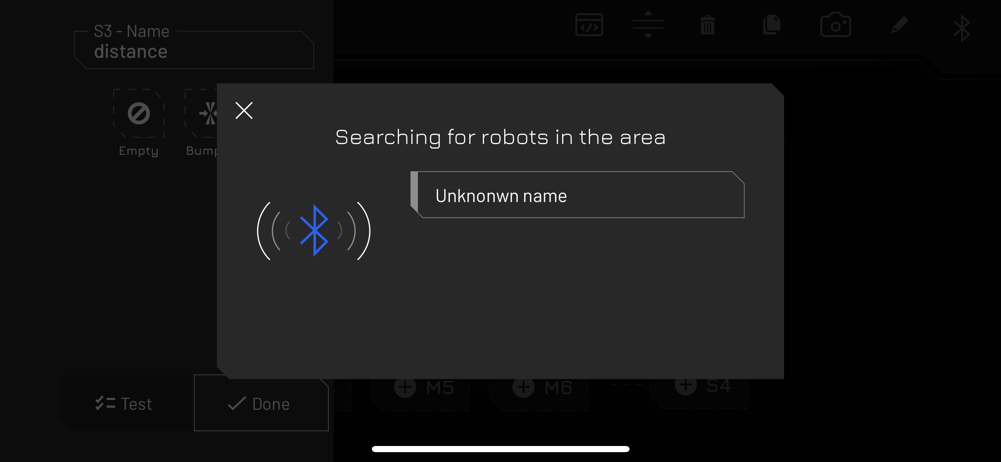
[picture p196: figure]
