STEAM-Academy-PRO/revolution-robotics-kit/electronic parts/BR - Brain/Brain-v1-production/B sample/Test requirements.xlsx

Sheet: Main page
 |  | Revolution Robotics Foundation
 |  | Test requirements
History
Version | Date | Modifier
0.1 | 2019.06.26 | David Dudas

Sheet: Main PCB
Test equipment needed:
 | - pogo pin test fixture (142 test points) |  | See testpoints
 | - Jlink programmer on testpoints
 | - simulate I2C devices, e.g. I2C EPROM with known data (5pcs)
 | - logic analyzer / oscilloscope to measure PWMs
 | - signal generator to generate fake encoder signals (2 channels)
 | - adjustable power supply for simulating different battery voltage
 | - UART for communication between MCU and test equipment
 | - digital IO
 | - reverse polarity test on motor battery
 | - temporary speaker for audio test
 | - current measurement
Test equipment setup:
 | Test after battery is installed and LED board is attached to main board
 | Jlink has to be connected to (TP17, TP20, TP23, TP26, TP29)
 | MCU has to communicate with test equipment on UART on TP98
Test steps:
 | Vertical switch must be in turned OFF state
 | Flash test firmware on Debug port (TP17, TP20, TP23, TP26, TP29)
 | TP84 VBAT must be configured as input!
 | Test vertical switch
 |  | Turn on switch manually --> real battery is turned ON
 | Read and store battery voltage
 |  | Read battery voltage on VBAT | Read TP84
 | Test reset functionality
 |  | Apply RPI MCU reset | Set TP102 to HIGH
 |  | measure DBG RST | Read TP29, it must go to LOW from HIGH
 |  | Release RPI MCU RESET | Set TP102 to LOW
 |  | measure DBG RST | Read TP29, it must go to HIGH
 | Test reverse battery protection
 |  | Apply 8V on TP83 | Measure TP86
 |  | Apply -8V on TP83 | Measure TP86
 |  | Apply 8V on TP83 | Measure TP86
 | Test power supplies
 |  | Measure sensor 5V | TP107, TP116, TP125, TP134
 |  | Measure sensor 3V3 | TP109, TP118, TP127, TP136
 |  | Measure 4V5 | TP88
 |  | MCU turns on and off servo supply ENA | TP89
 | Test battery charger functionality
 |  | Set 5V_RPI_SW to floating | Set TP91 to floating
 |  | Read charger enable | Read TP85 it must be LOW
 |  | Read 5V_RPI | Read TP82, it must be 4.5V
 |  | Apply 5V on 5V_RPI_SW | Set TP91 to 5V
 |  | Read charger enable | Read TP85 it must be HIGH
 |  | Read 5V_RPI | Read TP82, it must be 5V
 |  | Set 5V_RPI_SW to floating | Set TP91 to floating
 |  | Read charger enable | Read TP85 it must be LOW again
 |  | Read 5V_RPI | Read TP82, it must be 4.5V
 |  | Read and save MCU log on UART |  | MCU records CHG/STATUS
 | Turn off the switch manually --> real battery is turned OFF
 |  | Make sure that switch is turned OFF | Read TP84, if there is any voltage on TP84 test must wait!
 | TP84 VBAT must be configured as 4.2V power supply!
 |  | Connect GND | Connect TP94 to GND
 |  | Turn on 4.2V on VBAT | Set 4.2V on TP84
 | Test LED voltage dependency
 |  | Test LEDs with min and max battery voltage --> 3.0V to 4.4V
 |  | Check LED functionality on low battery | Set 3.0V on TP84
 |  | Visually check LEDs
 |  | Check LED functionality on charged battery | Set 4.4V on TP84
 |  | Visually check LEDs
 |  | Turn on normal 4.2V on VBAT | Set 4.2V on TP84
 | Test audio circuit
 |  | Enable audio driver | Set TP97 to High
 |  | Send test PWM from test environment | On TP104
 |  | Use a temporary speaker for evaluation
 | Test IO functionalities of the Brain
 |  | Apply signal generator pulses on encoders at RJ45 with specified ferquency |  | MCU records encoder values
 |  |  | TBD frequency, 50% duty cycle, 4.5V amplitude, 1/4 phase delay between 2 channels
 |  |  | Signal A on TP34, TP42, TP50, TP58, TP66, TP74
 |  |  | Signal B on TP38, TP46, TP54, TP62, TP70, TP78
 |  | MCU drives motor PWMs, test equipment reads the frequency, duty cycle, etc
 |  |  | Apply 8V on TP83 and measure TP86
 |  |  | MCU drives the PWM lines with TBD frequency and TBD duty cycle
 |  |  | MOT PWM and MOT+ and MOT- pins must be read by test equipment with logic analyzer or oscilloscope
 |  |  | record the following data: TP36, TP39, TP40, TP44, TP47, TP48, TP52, TP55, TP56, TP60, TP63, TP64, TP68, TP71, TP72, TP76, TP79, TP80
 |  |  | if 18 channels recording is too much, we suggest to measure in sequence
 |  | MCU reads I2C device on every (5) port |  | MCU reads values from I2C devices
 |  |  | RPI I2C: SDA TP92, SCL TP93
 |  |  | SEN3: SDA TP110, SCL TP111
 |  |  | SEN2: SDA TP119, SCL TP120
 |  |  | SEN1: SDA TP128, SCL TP129
 |  |  | SEN0: SDA TP137, SCL TP138
 |  | Measure level shifters and analog inputs
 |  | Connect the following pins together: |  | MCU records voltage levels
 |  |  | SEN3: TP108 to TP112
 |  |  | SEN2: TP117 to TP121
 |  |  | SEN1: TP126 to TP130
 |  |  | SEN0: TP135 to TP139
 |  | Set logic high on RPI GPIOs with low impedance and MCU will read it |  | MCU records readings
 |  |  | Let TP99, TP100, TP101, TP103, TP105, TP106 float
 |  |  | Set TP99, TP100, TP101, TP103, TP105, TP106 to HIGH
 |  |  | Let TP99, TP100, TP101, TP103, TP105, TP106 float
 | IMU check |  |  | MCU records IMU values
 |  | MCU will read IMU registers, no test equipment is needed
 | Read and save MCU log on UART |  |  | MCU sends collected data to test equipment
 | During the whole measurement
 |  | measure and store avg, max, min current on VBAT supply
 | Flash user firmware on Debug port (TP17, TP20, TP23, TP26, TP29)

Sheet: Bumper switch
Test equipment needed:
 | - RJ45 interface to connect bumper switch
 | - Digital IO
 | - 3V3 supply
Test equipment setup:
 | Connect 3V3 supply to pin 3 of the RJ45
 | Connect digital input of the test equipment to pin 6
Test steps:
 | Measure pin 6 with released button
 | Measure pin 6 with pressed button
 | Repeat steps a few times
Evaluation criteria/test requirements:
 | If button is pressed pin 3 and 6 must be connected by the switch, test voltage (3V3) can be measured on pin 6
 | If button is released pin 3 and 6 must be disconnected by the switch, pin 6 should be floating
 | Every other pins of RJ45 has to be floating regardless the switch is pressed or not
 | Short circuit is forbidden between any of the pins
Data to store from every sensor with unique/traceable ID:
 | Test result (PASSED or FAILED)

Sheet: Ultrasonic sensor
Test equipment needed:
 | - RJ45 interface to connect ultrasonic sensor
 | - Digital IO with precise time measurement
 | - 5V supply
 | - Obstacle with at least 2 different position to make sure sensor is working
Test equipment setup:
 | Connect 5V supply to pin 1 of the RJ45 and GND to pin8
 | Connect digital output of the test equipment to pin 2
 | Connect digital input of the test equipment to pin7
Test steps:
 | Apply 10us TRIGGER pulse on pin 2
 | Measure the length of ECHO signal on pin 7 see picture
 | Apply different obstacle distance and repeat above 2 steps
Evaluation criteria/test requirements:
 | The length of ECHO pulse must match the distance of the obstacle
 | Every other pins of RJ45 has to be floating
 | Short circuit is forbidden between any of the pins
 | ECHO signal amplitude must be >= 4.5V
Data to store from every sensor with unique/traceable ID:
 | avg ECHO length with different (known) obstacle distances
 | Test result (PASSED or FAILED)

Sheet: Motor pack
Test equipment needed:
 | - RJ45 interface to connect motor pack
 | - H-bridge to drive the motor in both directions, max 9V
 | - motor current measurement
 | - 5V supply for encoders
 | - 2 channel Logic analyzer/oscilloscope for encoder signal measurement
 | - acoustic test equipment
Test equipment setup:
 | Connect 5V supply to pin 4 of the RJ45 and GND to pin8 (encoder supply)
 | Connect channel1 of logic analyzer to pin 1
 | Connect channel2 of logic analyzer to pin 5
 | Connect outputs of H-bridge to MOT+ pin 3 and MOT- pin 7
Test steps:
 | Start recording of encoder signals, current, acoustic
 | Apply 8.4V on MOT+ and GND on MOT-
 | Let the motor pack turn at least 10 (TBD) full rotation on the output shaft
 | Apply 8.4V on MOT- and GND on MOT+
 | Let the motor pack turn at least 10 (TBD) full rotation on the output shaft
 | Stop recording of signals
Evaluation criteria/test requirements:
 | Motor must be able to rotate in both directions
 | Both encoder channels must count the rotation of magnet
 | Encoder signal amplitude must be >= 4.5V
 | The phase between the 2 channels must be 1/4 period during the whole measurement as seen on the picture
 | Number of pulses should match the phisical rotation of the motor
 | Speed and current must be nearly the same in both directions
 | Acoustic results of the whole motor pack must be acceptable (TBD)
Data to store from every sensor with unique/traceable ID:
 | avg, min and max current in both directions
 | avg, min and max speed in both directions
 | max acoutsic level
 | avg phase between the encoder channels
 | Test result (PASSED or FAILED)

Sheet: Final test of brain
Record unique ID of rapsberry pi and print it to the label

Sheet: List of test points
Net | Name | X Coord | Y Coord | Side | Hole Size | Type | Functionality | Description | RJ45?
MOT1_PWM0 | TP1-1 | 67.45mm | 24.15mm | Bottom | 0mm | Surface mount | MCU MOT1 PWM_A | MCU pin
MOT2_INT0 | TP2-1 | 76.4mm | 19.35mm | Bottom | 0mm | Surface mount | MCU MOT2 ENC_A | MCU pin
MOT1_PWM1 | TP3-1 | 67.95mm | 30.825mm | Bottom | 0mm | Surface mount | MCU MOT1 PWM_B | MCU pin
MOT2_INT1 | TP4-1 | 69.8mm | 16.4mm | Bottom | 0mm | Surface mount | MCU MOT2 ENC_B | MCU pin
MOT2_PWM0 | TP5-1 | 74.35mm | 31.2mm | Bottom | 0mm | Surface mount | MCU MOT2 PWM_A | MCU pin
MOT1_INT0 | TP6-1 | 60.1mm | 19.4mm | Bottom | 0mm | Surface mount | MCU MOT1 ENC_A | MCU pin
MOT2_PWM1 | TP7-1 | 71.775mm | 30.85mm | Bottom | 0mm | Surface mount | MCU MOT2 PWM_B | MCU pin
MOT1_INT1 | TP8-1 | 55.35mm | 16.7mm | Bottom | 0mm | Surface mount | MCU MOT1 ENC_B | MCU pin
MOT0_PWM0 | TP9-1 | 67mm | 37.8mm | Bottom | 0mm | Surface mount | MCU MOT0 PWM_A | MCU pin
MOT0_INT0 | TP10-1 | 44.9mm | 19.525mm | Bottom | 0mm | Surface mount | MCU MOT0 ENC_A | MCU pin
MOT0_PWM1 | TP11-1 | 67.9mm | 40.675mm | Bottom | 0mm | Surface mount | MCU MOT0 PWM_B | MCU pin
MOT0_INT1 | TP12-1 | 39.9mm | 19.5mm | Bottom | 0mm | Surface mount | MCU MOT0 ENC_B | MCU pin
MOT5_PWM0 | TP13-1 | 74.3mm | 39.25mm | Bottom | 0mm | Surface mount | MCU MOT5 PWM_A | MCU pin
MOT5_INT0 | TP14-1 | 32.725mm | 57.725mm | Bottom | 0mm | Surface mount | MCU MOT5 ENC_A | MCU pin
MOT5_PWM1 | TP15-1 | 74.25mm | 41.9mm | Bottom | 0mm | Surface mount | MCU MOT5 PWM_B | MCU pin
MOT5_INT1 | TP16-1 | 40.6mm | 56.4mm | Bottom | 0mm | Surface mount | MCU MOT5 ENC_B | MCU pin
3V3 | TP17-1 | 35.2mm | 32.05mm | Bottom | 0mm | Surface mount | Jlink 3V3 | Jlink
MOT3_PWM0 | TP18-1 | 72.5mm | 47.55mm | Bottom | 0mm | Surface mount | MCU MOT3 PWM_A | MCU pin
MOT4_INT0 | TP19-1 | 34.95mm | 46.05mm | Bottom | 0mm | Surface mount | MCU MOT4 ENC_A | MCU pin
M_SWCLK | TP20-1 | 37.75mm | 32.05mm | Bottom | 0mm | Surface mount | Jlink SWCLK | Jlink
MOT3_PWM1 | TP21-1 | 69.05mm | 47.55mm | Bottom | 0mm | Surface mount | MCU MOT3 PWM_B | MCU pin
MOT4_INT1 | TP22-1 | 49.5mm | 54.275mm | Bottom | 0mm | Surface mount | MCU MOT4 ENC_B | MCU pin
GND | TP23-1 | 40.35mm | 32.05mm | Bottom | 0mm | Surface mount | Jlink GND | Jlink
MOT4_PWM0 | TP24-1 | 76.15mm | 54.9mm | Bottom | 0mm | Surface mount | MCU MOT4 PWM_A | MCU pin
MOT3_INT0 | TP25-1 | 62.95mm | 57.85mm | Bottom | 0mm | Surface mount | MCU MOT3 ENC_A | MCU pin
M_SWDIO | TP26-1 | 42.9mm | 32.05mm | Bottom | 0mm | Surface mount | Jlink SWDIO | Jlink
MOT4_PWM1 | TP27-1 | 66.5mm | 47.55mm | Bottom | 0mm | Surface mount | MCU MOT4 PWM_B | MCU pin
MOT3_INT1 | TP28-1 | 68.85mm | 57.825mm | Bottom | 0mm | Surface mount | MCU MOT3 ENC_B | MCU pin
DBG_RST | TP29-1 | 45.45mm | 32.1mm | Bottom | 0mm | Surface mount | Jlink RST | Jlink
PORT2_IN1 | TP30-1 | 77.05mm | 40.7mm | Bottom | 0mm | Surface mount | MCU SEN2 US ECHO | MCU pin
PORT1_IN1 | TP31-1 | 74.4mm | 28.6mm | Bottom | 0mm | Surface mount | MCU SEN1 US ECHO | MCU pin
PORT0_IN1 | TP32-1 | 48.2mm | 31.15mm | Bottom | 0mm | Surface mount | MCU SEN0 US ECHO | MCU pin
PORT3_IN1 | TP33-1 | 75.05mm | 47.55mm | Bottom | 0mm | Surface mount | MCU SEN3 US ECHO | MCU pin
NetCON2_1 | TP34-1 | 78.74mm | 2.54mm | Bottom | 0mm | Surface mount | MOT2 ENC_A |  | RJ45
NetCON2_2 | TP35-1 | 77.47mm | 5.08mm | Bottom | 0mm | Surface mount | MOT2 SERVO 5V | If enabled, TP89 after fuse | RJ45
MOT2+ | TP36-1 | 76.2mm | 2.54mm | Bottom | 0mm | Surface mount | MOT2+ | Based on MCU MOT2 PWM_A and MCU MOT2 PWM_B | RJ45
NetCON2_4 | TP37-1 | 74.93mm | 5.08mm | Bottom | 0mm | Surface mount | MOT2 ENC Supply | fix 5V | RJ45
NetCON2_5 | TP38-1 | 73.66mm | 2.54mm | Bottom | 0mm | Surface mount | MOT2 ENC_B |  | RJ45
PWM2 | TP39-1 | 72.39mm | 5.08mm | Bottom | 0mm | Surface mount | MOT2 SERVO PWM | Based on MCU MOT2 PWM_A | RJ45
MOT2- | TP40-1 | 71.12mm | 2.54mm | Bottom | 0mm | Surface mount | MOT2- | Based on MCU MOT2 PWM_A and MCU MOT2 PWM_B | RJ45
PGND | TP41-1 | 69.85mm | 5.08mm | Bottom | 0mm | Surface mount | MOT2 GND |  | RJ45
NetCON2_13 | TP42-1 | 64.77mm | 2.54mm | Bottom | 0mm | Surface mount | MOT1 ENC_A |  | RJ45
NetCON2_14 | TP43-1 | 63.5mm | 5.08mm | Bottom | 0mm | Surface mount | MOT1 SERVO 5V | If enabled, TP89 after fuse | RJ45
MOT1+ | TP44-1 | 62.23mm | 2.54mm | Bottom | 0mm | Surface mount | MOT1+ | Based on MCU MOT1 PWM_A and MCU MOT1 PWM_B | RJ45
NetCON2_16 | TP45-1 | 60.96mm | 5.08mm | Bottom | 0mm | Surface mount | MOT1 ENC Supply | fix 5V | RJ45
NetCON2_17 | TP46-1 | 59.69mm | 2.54mm | Bottom | 0mm | Surface mount | MOT1 ENC_B |  | RJ45
PWM1 | TP47-1 | 58.42mm | 5.08mm | Bottom | 0mm | Surface mount | MOT1 SERVO PWM | Based on MCU MOT1 PWM_A | RJ45
MOT1- | TP48-1 | 57.15mm | 2.54mm | Bottom | 0mm | Surface mount | MOT1- | Based on MCU MOT1 PWM_A and MCU MOT1 PWM_B | RJ45
PGND | TP49-1 | 55.88mm | 5.08mm | Bottom | 0mm | Surface mount | MOT1 GND |  | RJ45
NetCON2_25 | TP50-1 | 50.8mm | 2.54mm | Bottom | 0mm | Surface mount | MOT0 ENC_A |  | RJ45
NetCON2_26 | TP51-1 | 49.53mm | 5.08mm | Bottom | 0mm | Surface mount | MOT0 SERVO 5V | If enabled, TP89 after fuse | RJ45
MOT0+ | TP52-1 | 48.26mm | 2.54mm | Bottom | 0mm | Surface mount | MOT0+ | Based on MCU MOT0 PWM_A and MCU MOT0 PWM_B | RJ45
NetCON2_28 | TP53-1 | 46.99mm | 5.08mm | Bottom | 0mm | Surface mount | MOT0 ENC Supply | fix 5V | RJ45
NetCON2_29 | TP54-1 | 45.72mm | 2.54mm | Bottom | 0mm | Surface mount | MOT0 ENC_B |  | RJ45
PWM0 | TP55-1 | 44.45mm | 5.08mm | Bottom | 0mm | Surface mount | MOT0 SERVO PWM | Based on MCU MOT0 PWM_A | RJ45
MOT0- | TP56-1 | 43.18mm | 2.54mm | Bottom | 0mm | Surface mount | MOT0- | Based on MCU MOT0 PWM_A and MCU MOT0 PWM_B | RJ45
PGND | TP57-1 | 41.91mm | 5.08mm | Bottom | 0mm | Surface mount | MOT0 GND |  | RJ45
NetCON3_1 | TP58-1 | 40.64mm | 74.93mm | Bottom | 0mm | Surface mount | MOT5 ENC_A |  | RJ45
NetCON3_2 | TP59-1 | 41.91mm | 72.39mm | Bottom | 0mm | Surface mount | MOT5 SERVO 5V | If enabled, TP89 after fuse | RJ45
MOT5+ | TP60-1 | 43.18mm | 74.93mm | Bottom | 0mm | Surface mount | MOT5+ | Based on MCU MOT5 PWM_A and MCU MOT5 PWM_B | RJ45
NetCON3_4 | TP61-1 | 44.45mm | 72.39mm | Bottom | 0mm | Surface mount | MOT5 ENC Supply | fix 5V | RJ45
NetCON3_5 | TP62-1 | 45.72mm | 74.93mm | Bottom | 0mm | Surface mount | MOT5 ENC_B |  | RJ45
PWM5 | TP63-1 | 46.99mm | 72.39mm | Bottom | 0mm | Surface mount | MOT5 SERVO PWM | Based on MCU MOT5 PWM_A | RJ45
MOT5- | TP64-1 | 48.26mm | 74.93mm | Bottom | 0mm | Surface mount | MOT5- | Based on MCU MOT5 PWM_A and MCU MOT5 PWM_B | RJ45
PGND | TP65-1 | 49.53mm | 72.39mm | Bottom | 0mm | Surface mount | MOT5 GND |  | RJ45
NetCON3_13 | TP66-1 | 55.88mm | 74.93mm | Bottom | 0mm | Surface mount | MOT4 ENC_A |  | RJ45
NetCON3_14 | TP67-1 | 57.15mm | 72.39mm | Bottom | 0mm | Surface mount | MOT4 SERVO 5V | If enabled, TP89 after fuse | RJ45
MOT4+ | TP68-1 | 58.42mm | 74.93mm | Bottom | 0mm | Surface mount | MOT4+ | Based on MCU MOT4 PWM_A and MCU MOT4 PWM_B | RJ45
NetCON3_16 | TP69-1 | 59.69mm | 72.39mm | Bottom | 0mm | Surface mount | MOT4 ENC Supply | fix 5V | RJ45
NetCON3_17 | TP70-1 | 60.96mm | 74.93mm | Bottom | 0mm | Surface mount | MOT4 ENC_B |  | RJ45
PWM4 | TP71-1 | 62.23mm | 72.39mm | Bottom | 0mm | Surface mount | MOT4 SERVO PWM | Based on MCU MOT4 PWM_A | RJ45
MOT4- | TP72-1 | 63.5mm | 74.93mm | Bottom | 0mm | Surface mount | MOT4- | Based on MCU MOT4 PWM_A and MCU MOT4 PWM_B | RJ45
PGND | TP73-1 | 64.77mm | 72.39mm | Bottom | 0mm | Surface mount | MOT4 GND |  | RJ45
NetCON3_25 | TP74-1 | 69.75mm | 74.93mm | Bottom | 0mm | Surface mount | MOT3 ENC_A |  | RJ45
NetCON3_26 | TP75-1 | 71.02mm | 72.39mm | Bottom | 0mm | Surface mount | MOT3 SERVO 5V | If enabled, TP89 after fuse | RJ45
MOT3+ | TP76-1 | 72.29mm | 74.93mm | Bottom | 0mm | Surface mount | MOT3+ | Based on MCU MOT3 PWM_A and MCU MOT3 PWM_B | RJ45
NetCON3_28 | TP77-1 | 73.56mm | 72.39mm | Bottom | 0mm | Surface mount | MOT3 ENC Supply | fix 5V | RJ45
NetCON3_29 | TP78-1 | 74.83mm | 74.93mm | Bottom | 0mm | Surface mount | MOT3 ENC_B |  | RJ45
PWM3 | TP79-1 | 76.1mm | 72.39mm | Bottom | 0mm | Surface mount | MOT3 SERVO PWM | Based on MCU MOT3 PWM_A | RJ45
MOT3- | TP80-1 | 77.37mm | 74.93mm | Bottom | 0mm | Surface mount | MOT3- | Based on MCU MOT3 PWM_A and MCU MOT3 PWM_B | RJ45
PGND | TP81-1 | 78.64mm | 72.39mm | Bottom | 0mm | Surface mount | MOT3 GND |  | RJ45
5V_RPI | TP82-1 | 17.85mm | 18.15mm | Bottom | 0mm | Surface mount | 5V RPI | After switch
NetC52_2 | TP83-1 | 8.35mm | 11.1mm | Bottom | 0mm | Surface mount | VMOT IN | Before reverse battery protection
VBAT | TP84-1 | 32.2mm | 14.25mm | Bottom | 0mm | Surface mount | VBAT | Battery voltage after switch
CHG_EN | TP85-1 | 7.15mm | 15.25mm | Bottom | 0mm | Surface mount | CHG EN | Depends on 5V RPI voltage level
VMOTOR | TP86-1 | 32mm | 19.5mm | Bottom | 0mm | Surface mount | VMOT | After protection
3V3 | TP87-1 | 20.3mm | 31.85mm | Bottom | 0mm | Surface mount | LDO 3V3
4V5 | TP88-1 | 18.95mm | 53.7mm | Bottom | 0mm | Surface mount | BOOST 4V5
5VM | TP89-1 | 60.2mm | 45.3mm | Bottom | 0mm | Surface mount | BOOST 5V | Servo supply
5V | TP90-1 | 21.85mm | 59.6mm | Bottom | 0mm | Surface mount | BOOST 5V
5V_RPI_SW | TP91-1 | 15.3mm | 69mm | Bottom | 0mm | Surface mount | 5V RPI | Before switch
I2C4_SDA | TP92-1 | 15.3mm | 66.44mm | Bottom | 0mm | Surface mount | RPI I2C SDA
I2C4_SCL | TP93-1 | 15.3mm | 63.9mm | Bottom | 0mm | Surface mount | RPI I2C SCL
GND | TP94-1 | 15.3mm | 61.35mm | Bottom | 0mm | Surface mount | RPI GND
NetCON6_8 | TP95-1 | 15.3mm | 58.8mm | Bottom | 0mm | Surface mount | RPI UART TX | N.C
NetCON6_10 | TP96-1 | 15.3mm | 56.25mm | Bottom | 0mm | Surface mount | RPI UART RX | N.C
AMP_EN | TP97-1 | 15.3mm | 51.1mm | Bottom | 0mm | Surface mount | AUDIO AMP EN | Audio amplifier enable
RPI_GPIO1 | TP98-1 | 15.3mm | 51.1mm | Bottom | 0mm | Surface mount | RPI GPIO1 | UART TX to test equipment
RPI_GPIO2 | TP99-1 | 15.3mm | 38.55mm | Bottom | 0mm | Surface mount | RPI GPIO2 | (backup UART TX)
RPI_GPIO3 | TP100-1 | 15.3mm | 35.95mm | Bottom | 0mm | Surface mount | RPI GPIO3
RPI_GPIO4 | TP101-1 | 15.3mm | 30.9mm | Bottom | 0mm | Surface mount | RPI GPIO4
MCU_RST | TP102-1 | 15.3mm | 23.2mm | Bottom | 0mm | Surface mount | RPI MCU RST
RPI_GPIO0 | TP103-1 | 15.3mm | 25.75mm | Bottom | 0mm | Surface mount | RPI GPIO0
RPI_PWM | TP104-1 | 15.3mm | 28.3mm | Bottom | 0mm | Surface mount | AUDIO PWM
RPI_GPIO5 | TP105-1 | 15.3mm | 20.65mm | Bottom | 0mm | Surface mount | RPI GPIO5
RPI_GPIO6 | TP106-1 | 15.3mm | 18.1mm | Bottom | 0mm | Surface mount | RPI GPIO6
NetCON8_1 | TP107-1 | 100.33mm | 64.77mm | Bottom | 0mm | Surface mount | SEN3 5V |  | RJ45
NetCON8_2 | TP108-1 | 97.79mm | 63.5mm | Bottom | 0mm | Surface mount | SEN3 US TRG |  | RJ45
NetCON8_3 | TP109-1 | 100.33mm | 62.23mm | Bottom | 0mm | Surface mount | SEN3 3V3 |  | RJ45
NetCON8_4 | TP110-1 | 97.79mm | 60.96mm | Bottom | 0mm | Surface mount | SEN3 I2C SDA |  | RJ45
NetCON8_5 | TP111-1 | 100.33mm | 59.69mm | Bottom | 0mm | Surface mount | SEN3 I2C SCL |  | RJ45
NetCON8_6 | TP112-1 | 97.79mm | 58.42mm | Bottom | 0mm | Surface mount | SEN3 AIN |  | RJ45
NetCON8_7 | TP113-1 | 100.33mm | 57.15mm | Bottom | 0mm | Surface mount | SEN3 US ECHO |  | RJ45
GND | TP114-1 | 97.79mm | 55.88mm | Bottom | 0mm | Surface mount | SEN3 GND |  | RJ45
VCCB3 | TP115-1 | 55.1mm | 47.75mm | Bottom | 0mm | Surface mount | SEN3 LOGIC VCC | Level shifter
NetCON8_13 | TP116-1 | 100.33mm | 49.53mm | Bottom | 0mm | Surface mount | SEN2 5V |  | RJ45
NetCON8_14 | TP117-1 | 97.79mm | 48.26mm | Bottom | 0mm | Surface mount | SEN2 US TRG |  | RJ45
NetCON8_15 | TP118-1 | 100.33mm | 46.99mm | Bottom | 0mm | Surface mount | SEN2 3V3 |  | RJ45
NetCON8_16 | TP119-1 | 97.79mm | 45.72mm | Bottom | 0mm | Surface mount | SEN2 I2C SDA |  | RJ45
NetCON8_17 | TP120-1 | 100.33mm | 44.45mm | Bottom | 0mm | Surface mount | SEN2 I2C SCL |  | RJ45
NetCON8_18 | TP121-1 | 97.79mm | 43.18mm | Bottom | 0mm | Surface mount | SEN2 AIN |  | RJ45
NetCON8_19 | TP122-1 | 100.33mm | 41.91mm | Bottom | 0mm | Surface mount | SEN2 US ECHO |  | RJ45
GND | TP123-1 | 97.79mm | 40.64mm | Bottom | 0mm | Surface mount | SEN2 GND |  | RJ45
VCCB2 | TP124-1 | 55.15mm | 43mm | Bottom | 0mm | Surface mount | SEN2 LOGIC VCC | Level shifter
NetCON8_25 | TP125-1 | 100.265mm | 35.51mm | Bottom | 0mm | Surface mount | SEN1 5V |  | RJ45
NetCON8_26 | TP126-1 | 97.725mm | 34.24mm | Bottom | 0mm | Surface mount | SEN1 US TRG |  | RJ45
NetCON8_27 | TP127-1 | 100.265mm | 32.97mm | Bottom | 0mm | Surface mount | SEN1 3V3 |  | RJ45
NetCON8_28 | TP128-1 | 97.725mm | 31.7mm | Bottom | 0mm | Surface mount | SEN1 I2C SDA |  | RJ45
NetCON8_29 | TP129-1 | 100.265mm | 30.43mm | Bottom | 0mm | Surface mount | SEN1 I2C SCL |  | RJ45
NetCON8_30 | TP130-1 | 97.725mm | 29.16mm | Bottom | 0mm | Surface mount | SEN1 AIN |  | RJ45
NetCON8_31 | TP131-1 | 100.265mm | 27.89mm | Bottom | 0mm | Surface mount | SEN1 US ECHO |  | RJ45
GND | TP132-1 | 97.725mm | 26.62mm | Bottom | 0mm | Surface mount | SEN1 GND |  | RJ45
VCCB1 | TP133-1 | 56.6mm | 38.775mm | Bottom | 0mm | Surface mount | SEN1 LOGIC VCC | Level shifter
NetCON8_37 | TP134-1 | 100.33mm | 21.59mm | Bottom | 0mm | Surface mount | SEN0 5V |  | RJ45
NetCON8_38 | TP135-1 | 97.75mm | 20.345mm | Bottom | 0mm | Surface mount | SEN0 US TRG |  | RJ45
NetCON8_39 | TP136-1 | 100.29mm | 19.075mm | Bottom | 0mm | Surface mount | SEN0 3V3 |  | RJ45
NetCON8_40 | TP137-1 | 97.75mm | 17.805mm | Bottom | 0mm | Surface mount | SEN0 I2C SDA |  | RJ45
NetCON8_41 | TP138-1 | 100.29mm | 16.535mm | Bottom | 0mm | Surface mount | SEN0 I2C SCL |  | RJ45
NetCON8_42 | TP139-1 | 97.75mm | 15.265mm | Bottom | 0mm | Surface mount | SEN0 AIN |  | RJ45
NetCON8_43 | TP140-1 | 100.29mm | 13.995mm | Bottom | 0mm | Surface mount | SEN0 US ECHO |  | RJ45
GND | TP141-1 | 97.75mm | 12.725mm | Bottom | 0mm | Surface mount | SEN0 GND |  | RJ45
VCCB0 | TP142-1 | 53.875mm | 34.65mm | Bottom | 0mm | Surface mount | SEN0 LOGIC VCC | Level shifter
