STEAM-Academy-PRO/revolution-robotics-kit/electronic parts/MO - Motor/Motor-v2-production/Quality-control/Motor-QC-test-2024-08-15.JPG

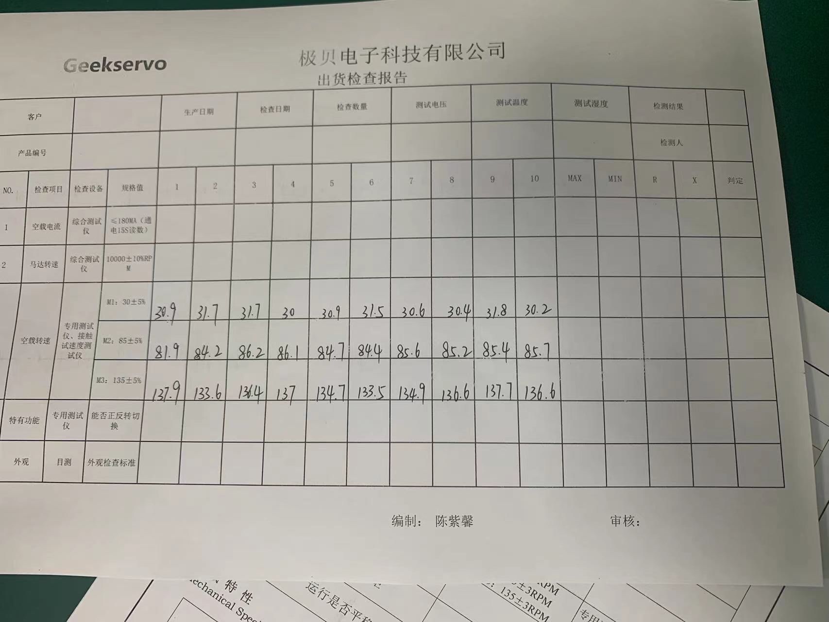
electronic parts/MO - Motor/Motor-v2-production/Quality-control/Motor-QC-test-2024-08-15.JPG
