STEAM-Academy-PRO/revolution-robotics-kit/toolbox/LEGO Spike box packing order/STEAM Academy - Revolution Robotics kit packing guide.pdf

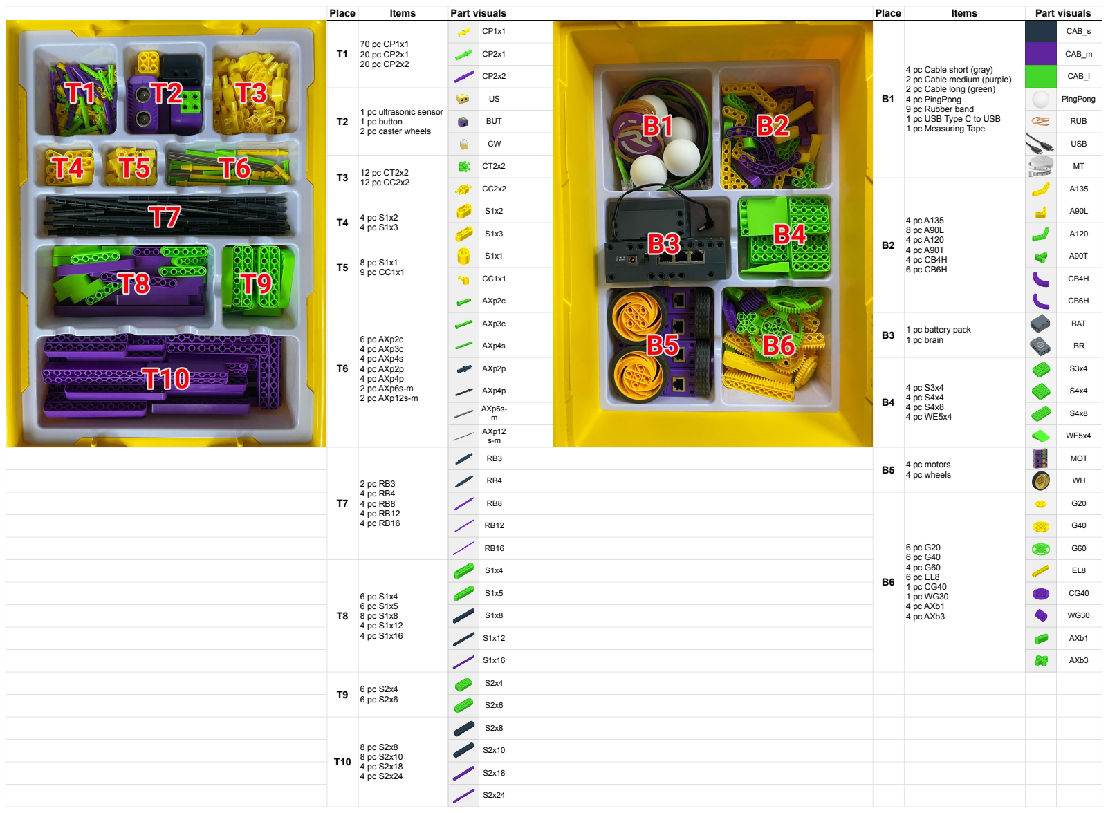
[picture p198: page 1]
Place; Items; Part visuals; CAB_s; CAB_m; CAB_l; PingPong; BUT; RUB; USB; 6 pc AXp2c 4 pc AXp3c 4 pc AXp4s 4 pc AXp2p 4 pc AXp4p 2 pc AXp6s-m 2 pc AXp12s-m; AXp2c; AXp3c; 1 pc battery pack; 1 pc brain; AXp4s; AXp2p; AXp4p; AXp6s- m; AXp12; 4 pc motors; 4 pc wheels; 6 pc G20 6 pc G40 4 pc G60 6 pc EL8 1 pc CG40 1 pc WG30 4 pc AXb1 4 pc AXb3; AXb1; AXb3

4 pc Cable short (gray)
2 pc Cable medium (purple)
2 pc Cable long (green)
4 pc PingPong
9 pc Rubber band
1 pc USB Type C to USB
1 pc Measuring Tape

1 pc ultrasonic sensor
1 pc button
2 pc caster wheels

BAT S3x4 S4x8 MOT G20
