STEAM-Academy-PRO/revolution-robotics-kit/mechanical parts/AX - Axles/AXp3c/AXp3c.PDF

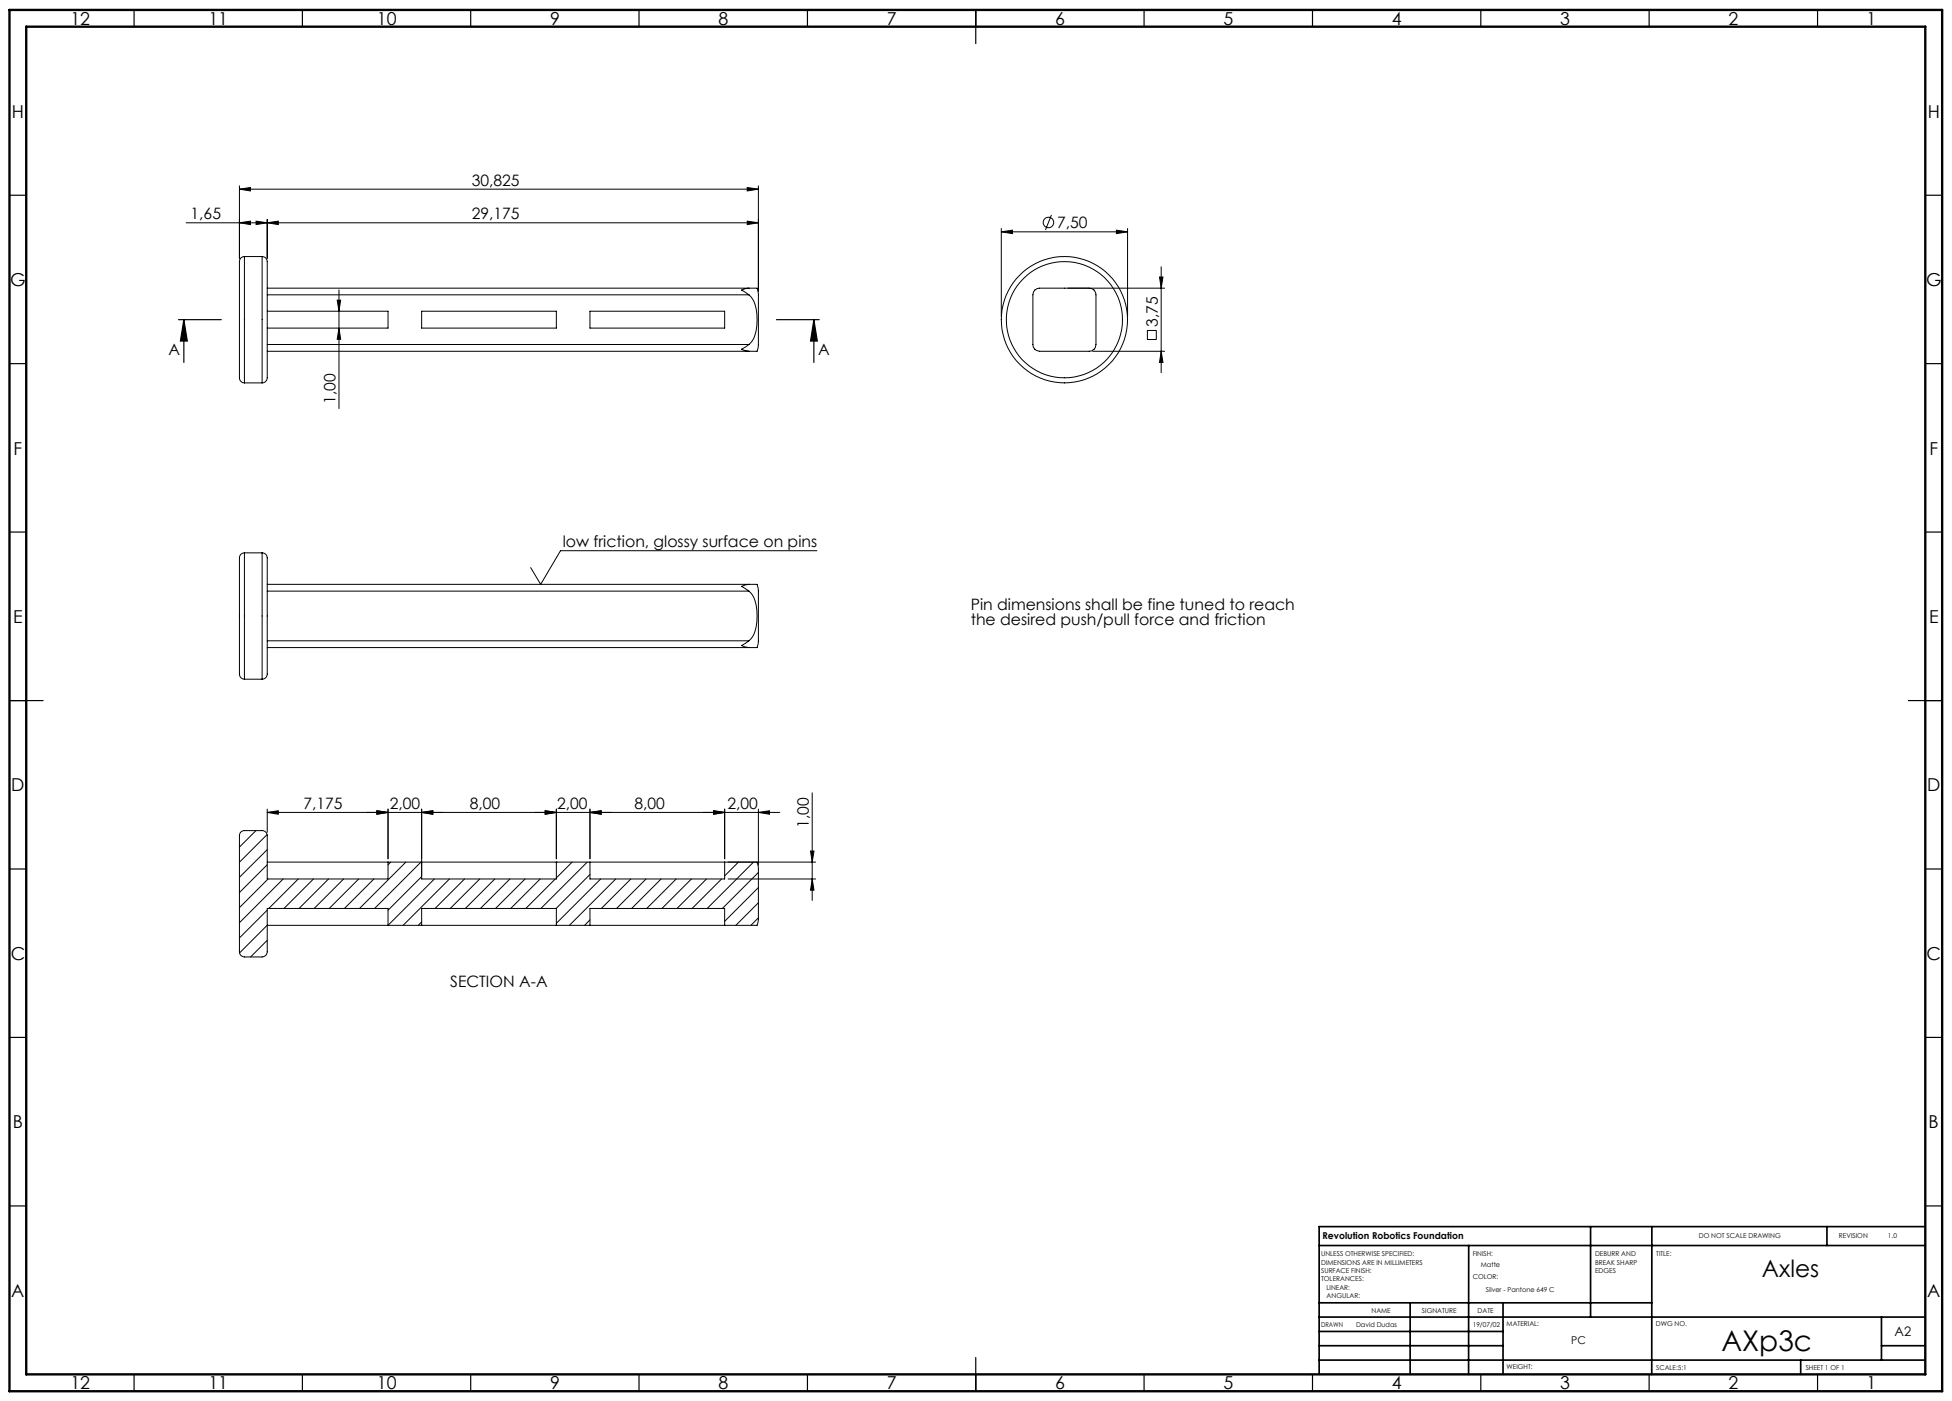
[picture p199: page 1]
SECTION A-A; SCALE:5:1; SHEET 1 OF 1

low friction, glossy surface on pins

Pin dimensions shall be fine tuned to reach
the desired push/pull force and friction

Revolution Robotics Foundation | | DO NOT SCALE DRAWING | REVISION 1.0

UNLESS OTHERWISE SPECIFIED: DIMENSIONS ARE IN MILLIMETERS SURFACE FINISH: TOLERANCES: LINEAR: ANGULAR: | FINISH: Matte COLOR: Silver - Pantone 649 C | DEBURR AND BREAK SHARP EDGES | TITLE: Axles

NAME | SIGNATURE | DATE

DRAWN David Dudas | | 19/07/02 | MATERIAL: PC | DWG NO. AXp3c | A2
