STEAM-Academy-PRO/revolution-robotics-kit/mechanical parts/WH - Wheels/WHrM - Wheel Inside/WHrM.PDF

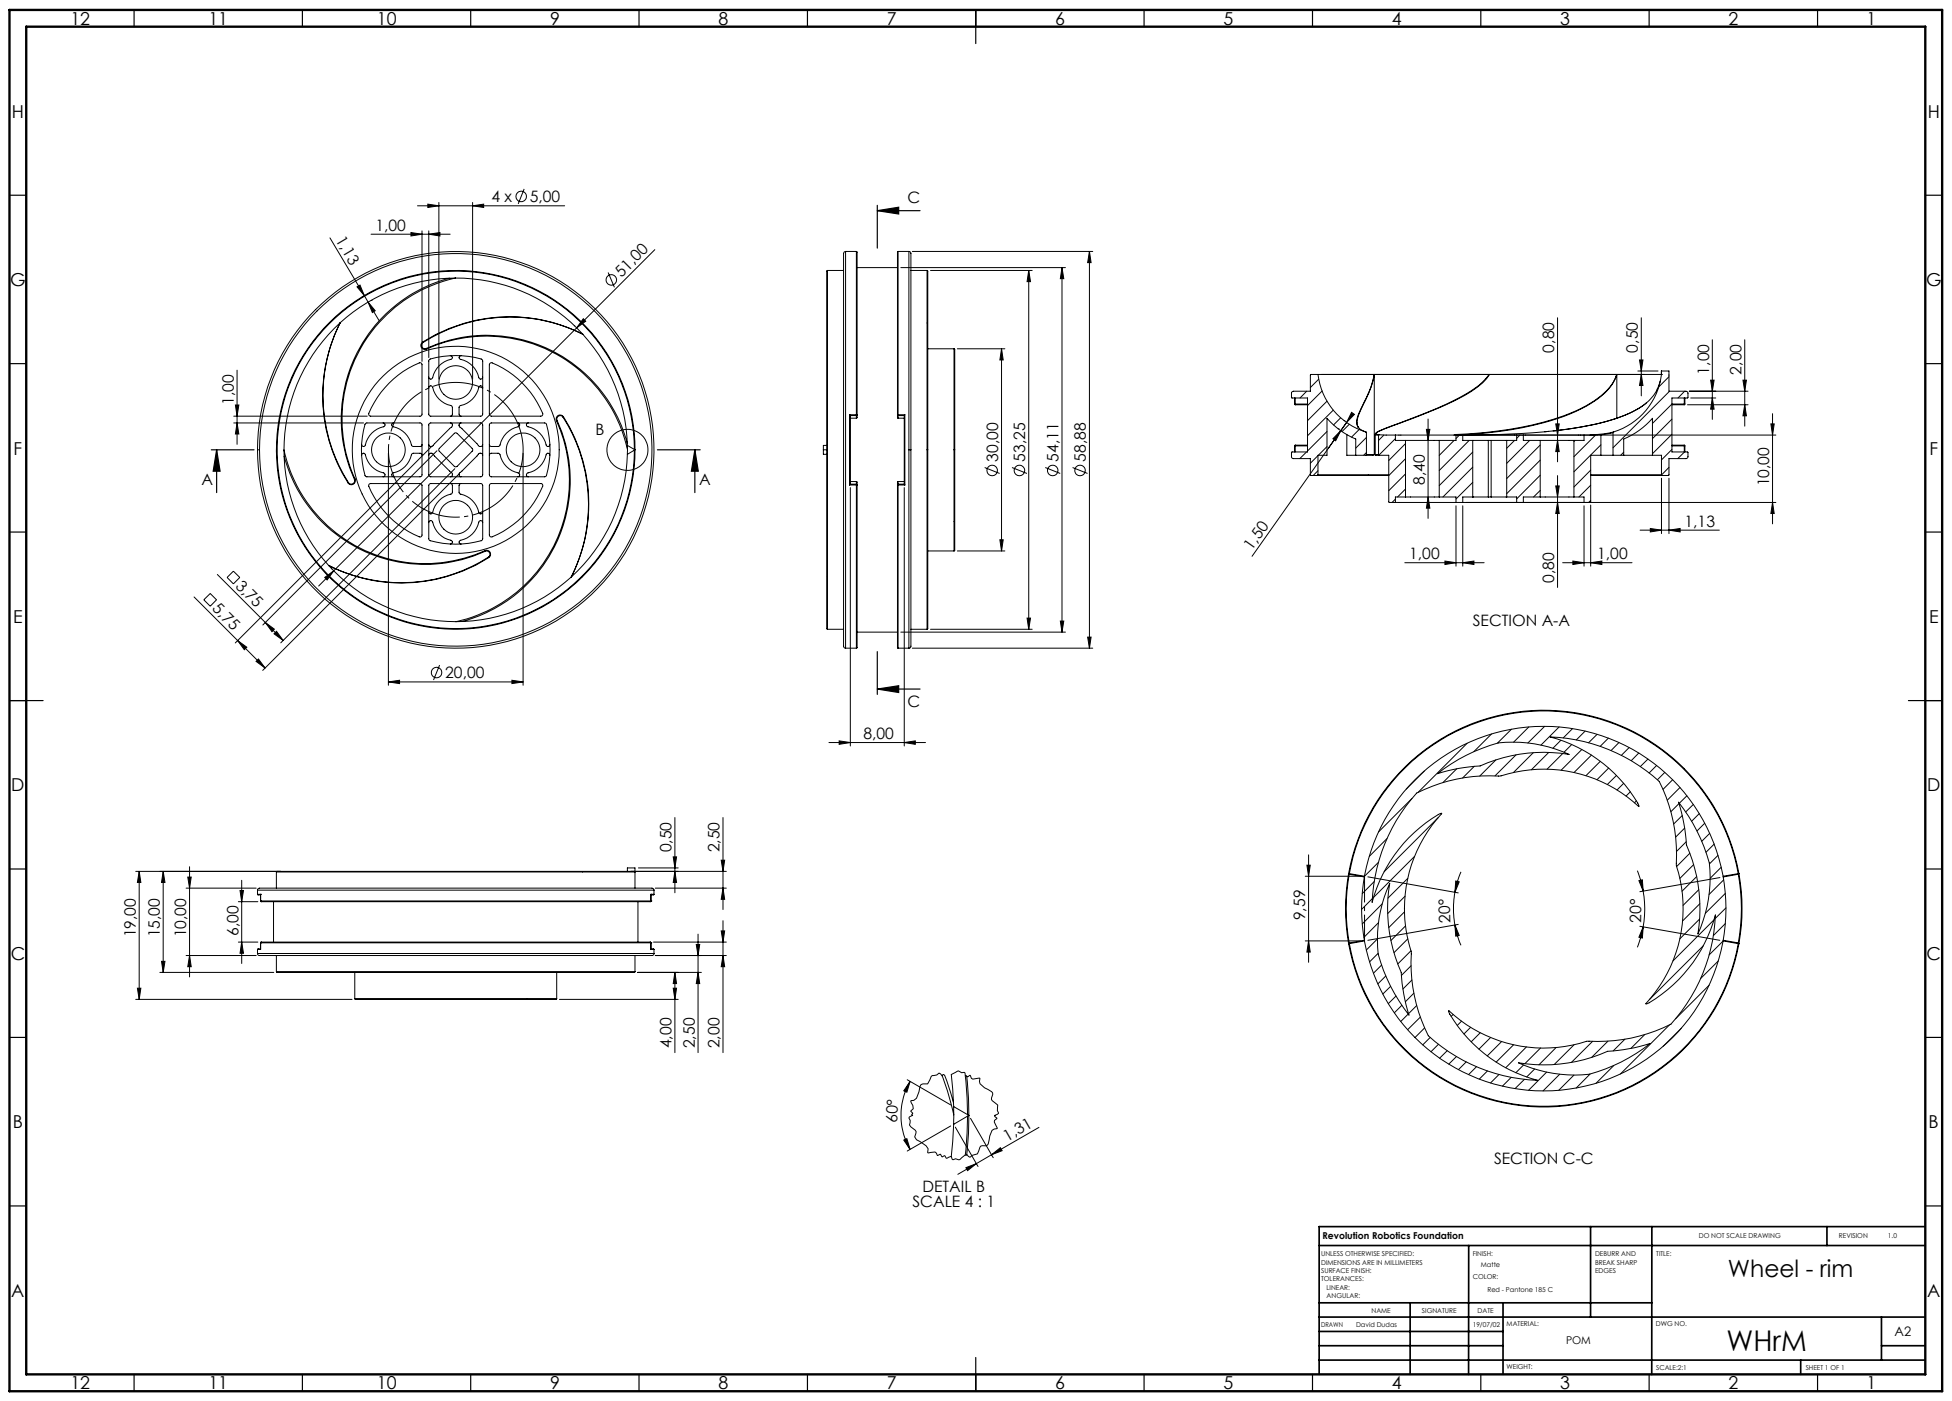
[picture p200: page 1]
SECTION A-A; DETAIL B SCALE 4 : 1; SECTION C-C; SCALE:2:1; SHEET 1 OF 1

Revolution Robotics Foundation | | DO NOT SCALE DRAWING | REVISION 1.0

UNLESS OTHERWISE SPECIFIED: DIMENSIONS ARE IN MILLIMETERS SURFACE FINISH: TOLERANCES: LINEAR: ANGULAR: | FINISH: Matte COLOR: Red - Pantone 185 C | DEBURR AND BREAK SHARP EDGES | TITLE: Wheel - rim

NAME | SIGNATURE | DATE

DRAWN David Dudas | | 19/07/02 | MATERIAL: POM | DWG NO. WHrM | A2
