STEAM-Academy-PRO/revolution-robotics-kit/mechanical parts/WH - Wheels/WHtM - Wheel Rubber/WHtM.PDF

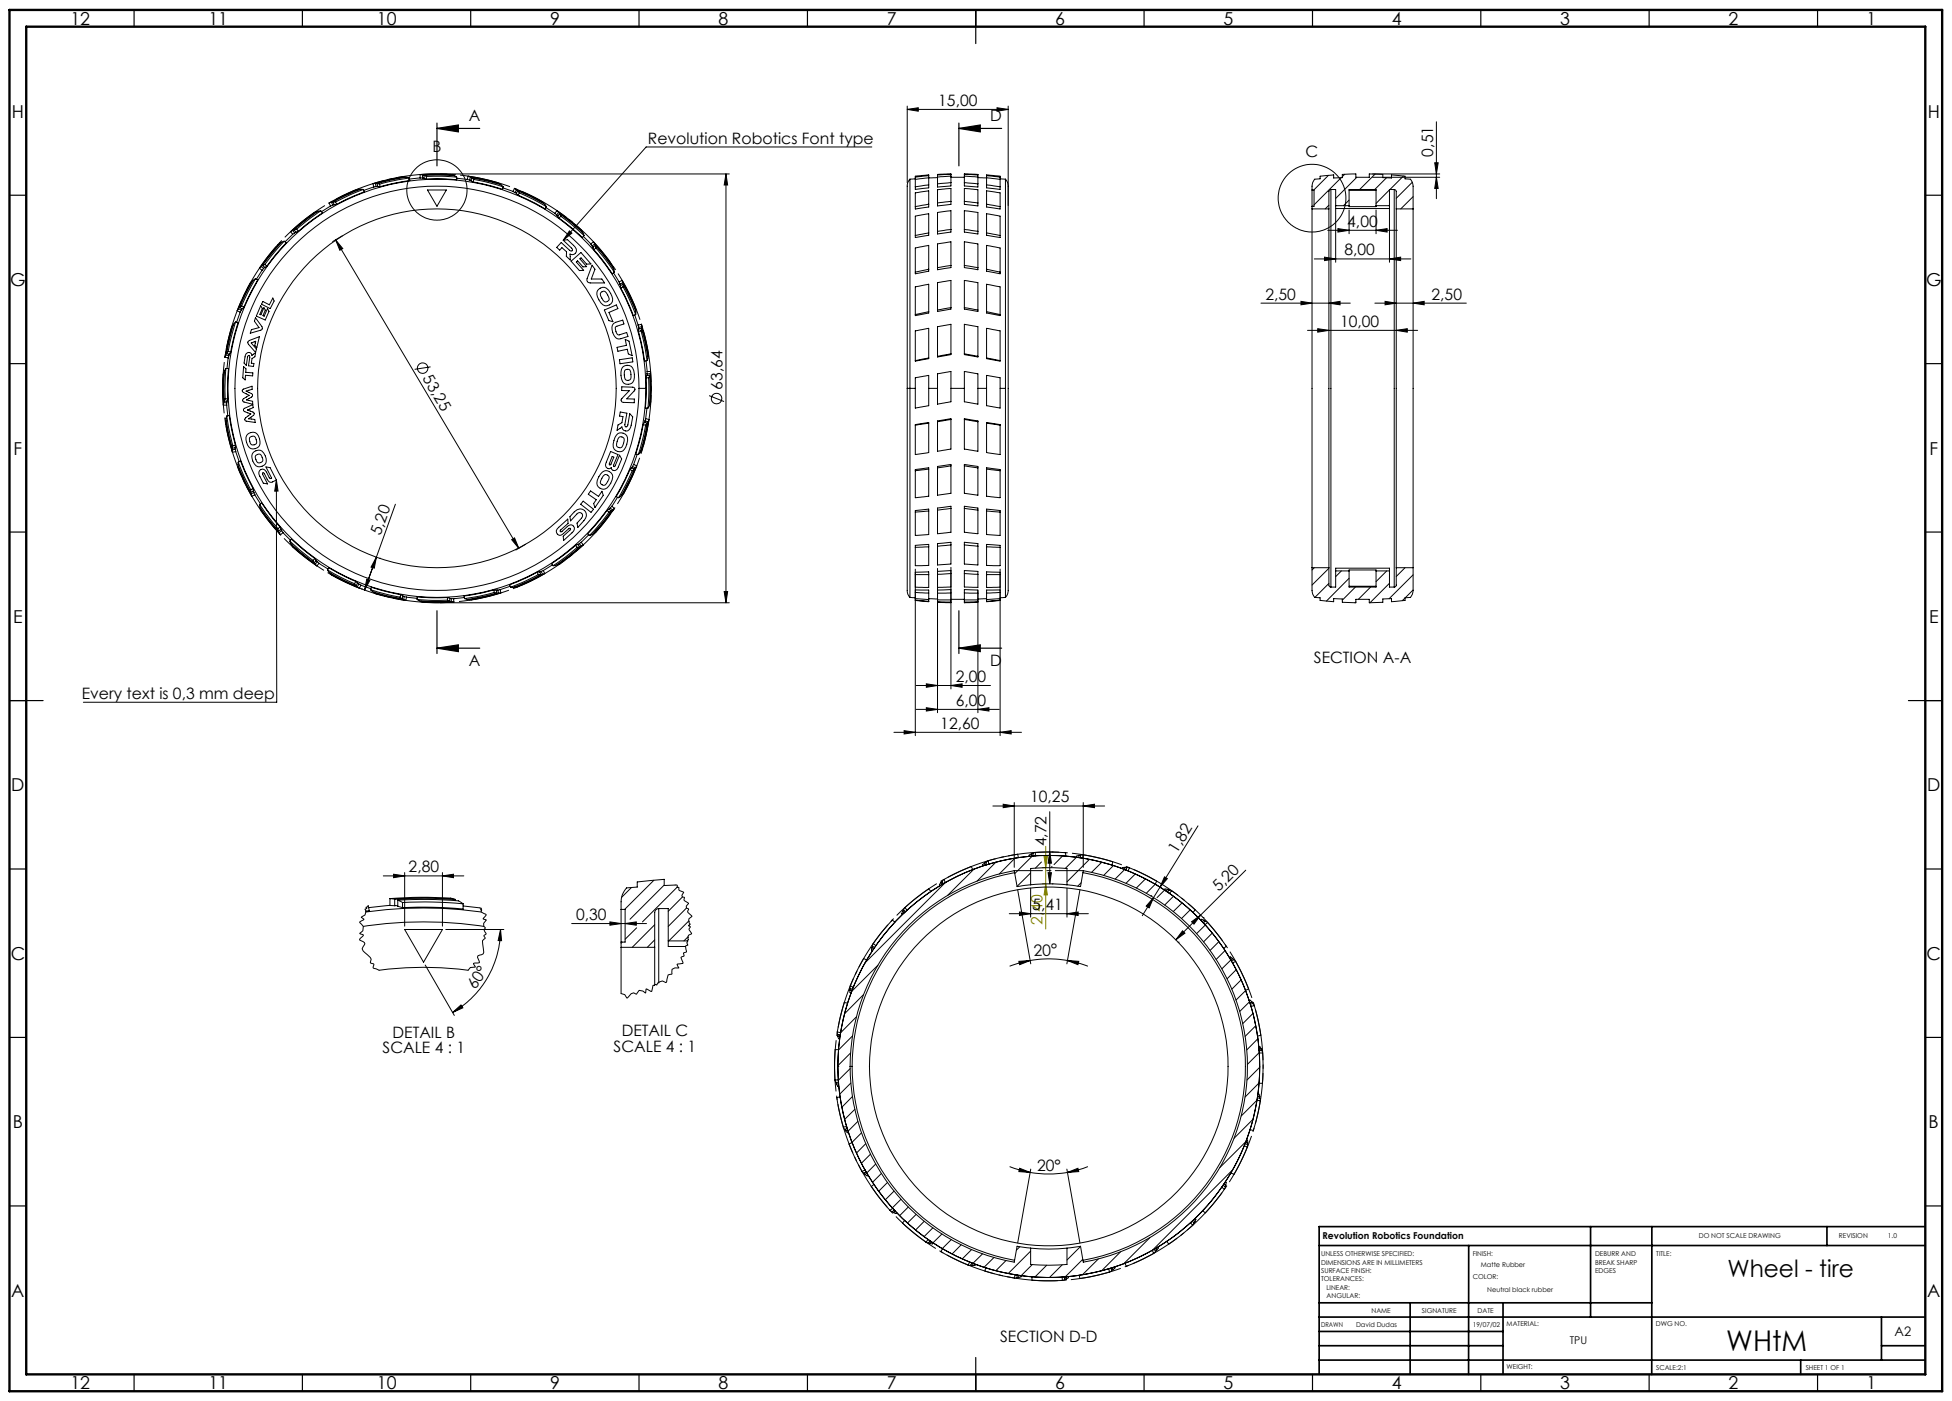
[picture p201: page 1]
SECTION A-A; DETAIL B SCALE 4 : 1; DETAIL C SCALE 4 : 1; SECTION D-D; SCALE:2:1; SHEET 1 OF 1

Revolution Robotics Font type

Every text is 0,3 mm deep

Revolution Robotics Foundation | | DO NOT SCALE DRAWING | REVISION 1.0

UNLESS OTHERWISE SPECIFIED: DIMENSIONS ARE IN MILLIMETERS SURFACE FINISH: TOLERANCES: LINEAR: ANGULAR: | FINISH: Matte Rubber COLOR: Neutral black rubber | DEBURR AND BREAK SHARP EDGES | TITLE: Wheel - tire

NAME | SIGNATURE | DATE

DRAWN David Dudas | | 19/07/02 | MATERIAL: TPU | DWG NO. WHtM | A2
