STEAM-Academy-PRO/revolution-robotics-kit/electronic parts/CS - Colour Sensor/_to_be_sorted/from-gDrive-2021-04-13-ColorSensor v1.pdf

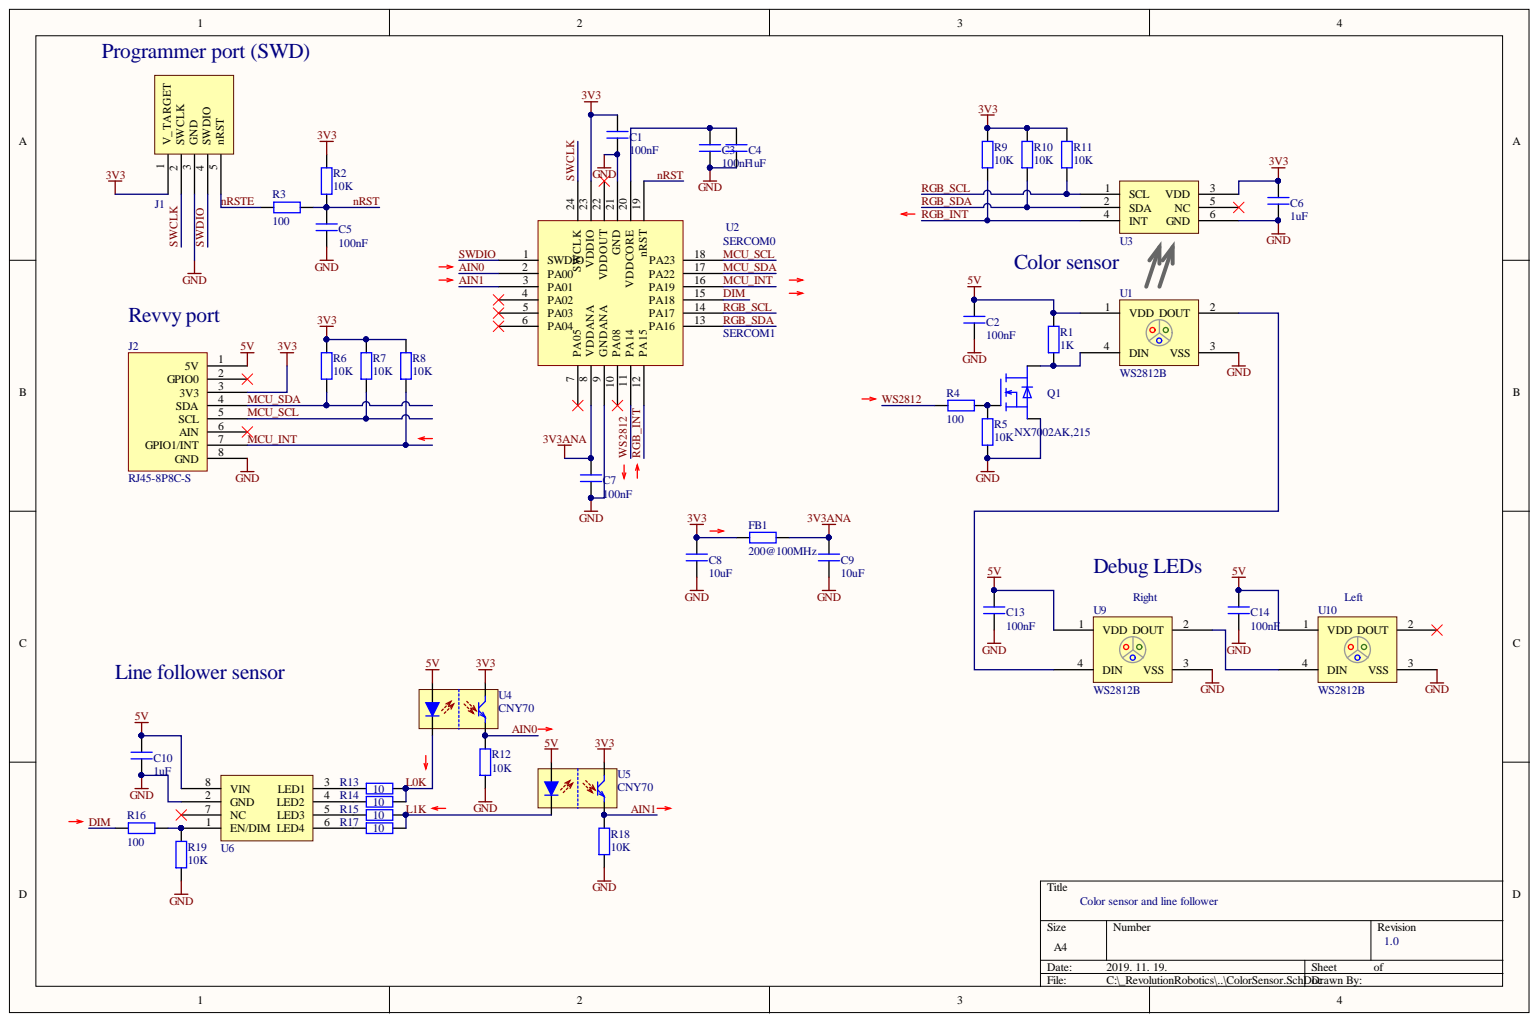
[picture p202: page 1]

18 RST 19 VDDCORE 20 GND 21 VDDOUT 22 VDDIO 23 SWCLK 24

Color sensor and line follower
