STEAM-Academy-PRO/revolution-robotics-kit/mechanical parts/AB - Angled Beams/A120/A120.PDF

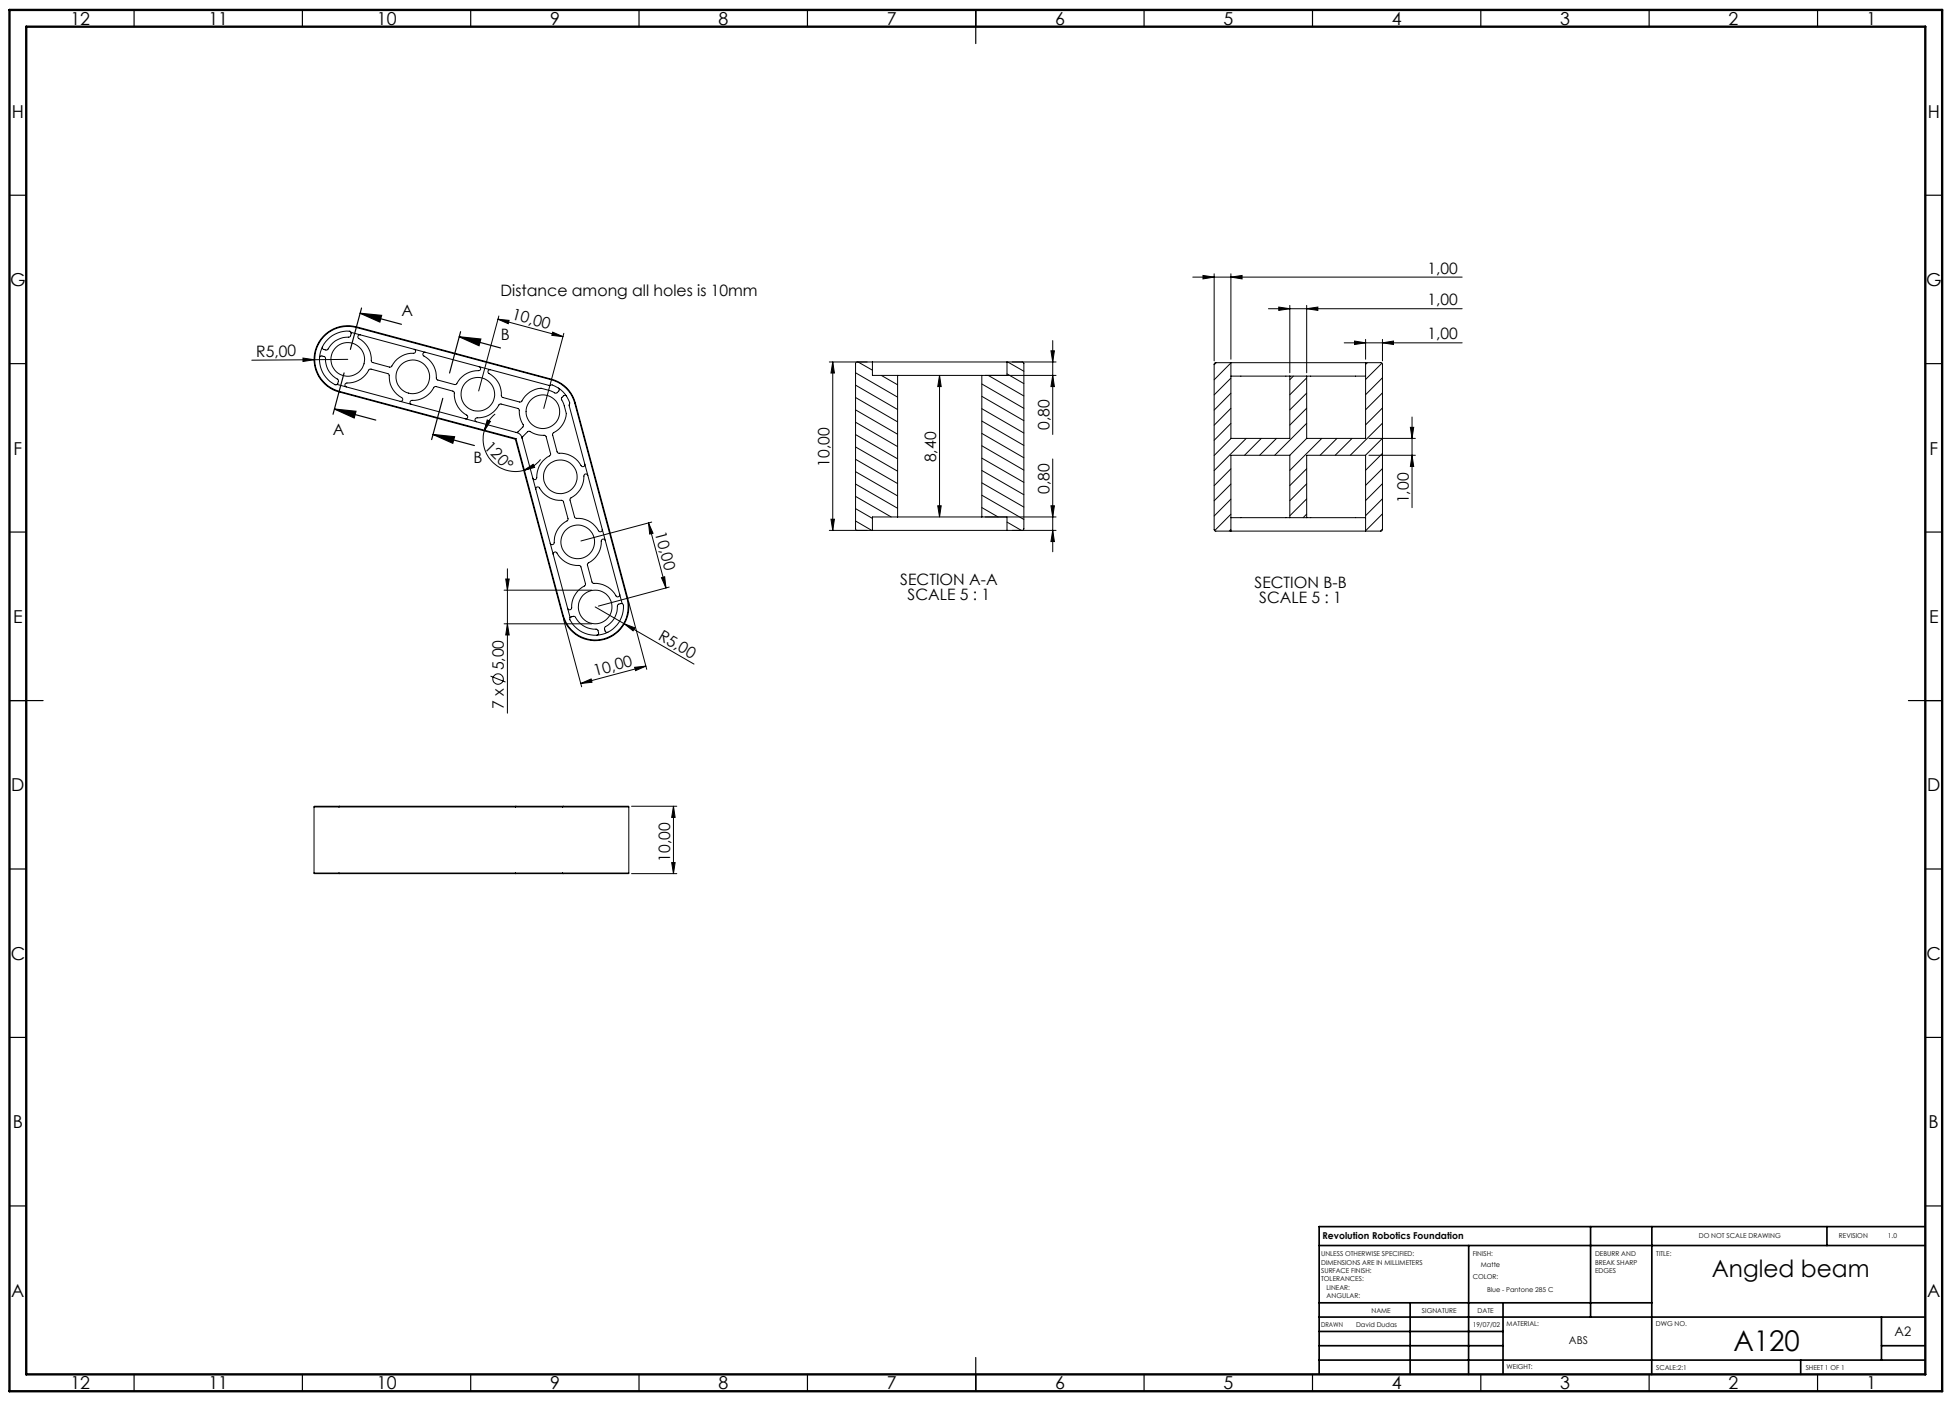
[picture p203: page 1]
SECTION A-A SCALE 5 : 1; SECTION B-B SCALE 5 : 1; SCALE:2:1; SHEET 1 OF 1

Distance among all holes is 10mm

Revolution Robotics Foundation | | DO NOT SCALE DRAWING | REVISION 1.0

UNLESS OTHERWISE SPECIFIED: DIMENSIONS ARE IN MILLIMETERS SURFACE FINISH: TOLERANCES: LINEAR: ANGULAR: | FINISH: Matte COLOR: Blue - Pantone 285 C | DEBURR AND BREAK SHARP EDGES | TITLE: Angled beam

NAME | SIGNATURE | DATE

DRAWN David Dudas | | 19/07/02 | MATERIAL: ABS | DWG NO. A120 | A2
