STEAM-Academy-PRO/revolution-robotics-kit/mechanical parts/AX - Axles/AXp2p/AXp2p.PDF

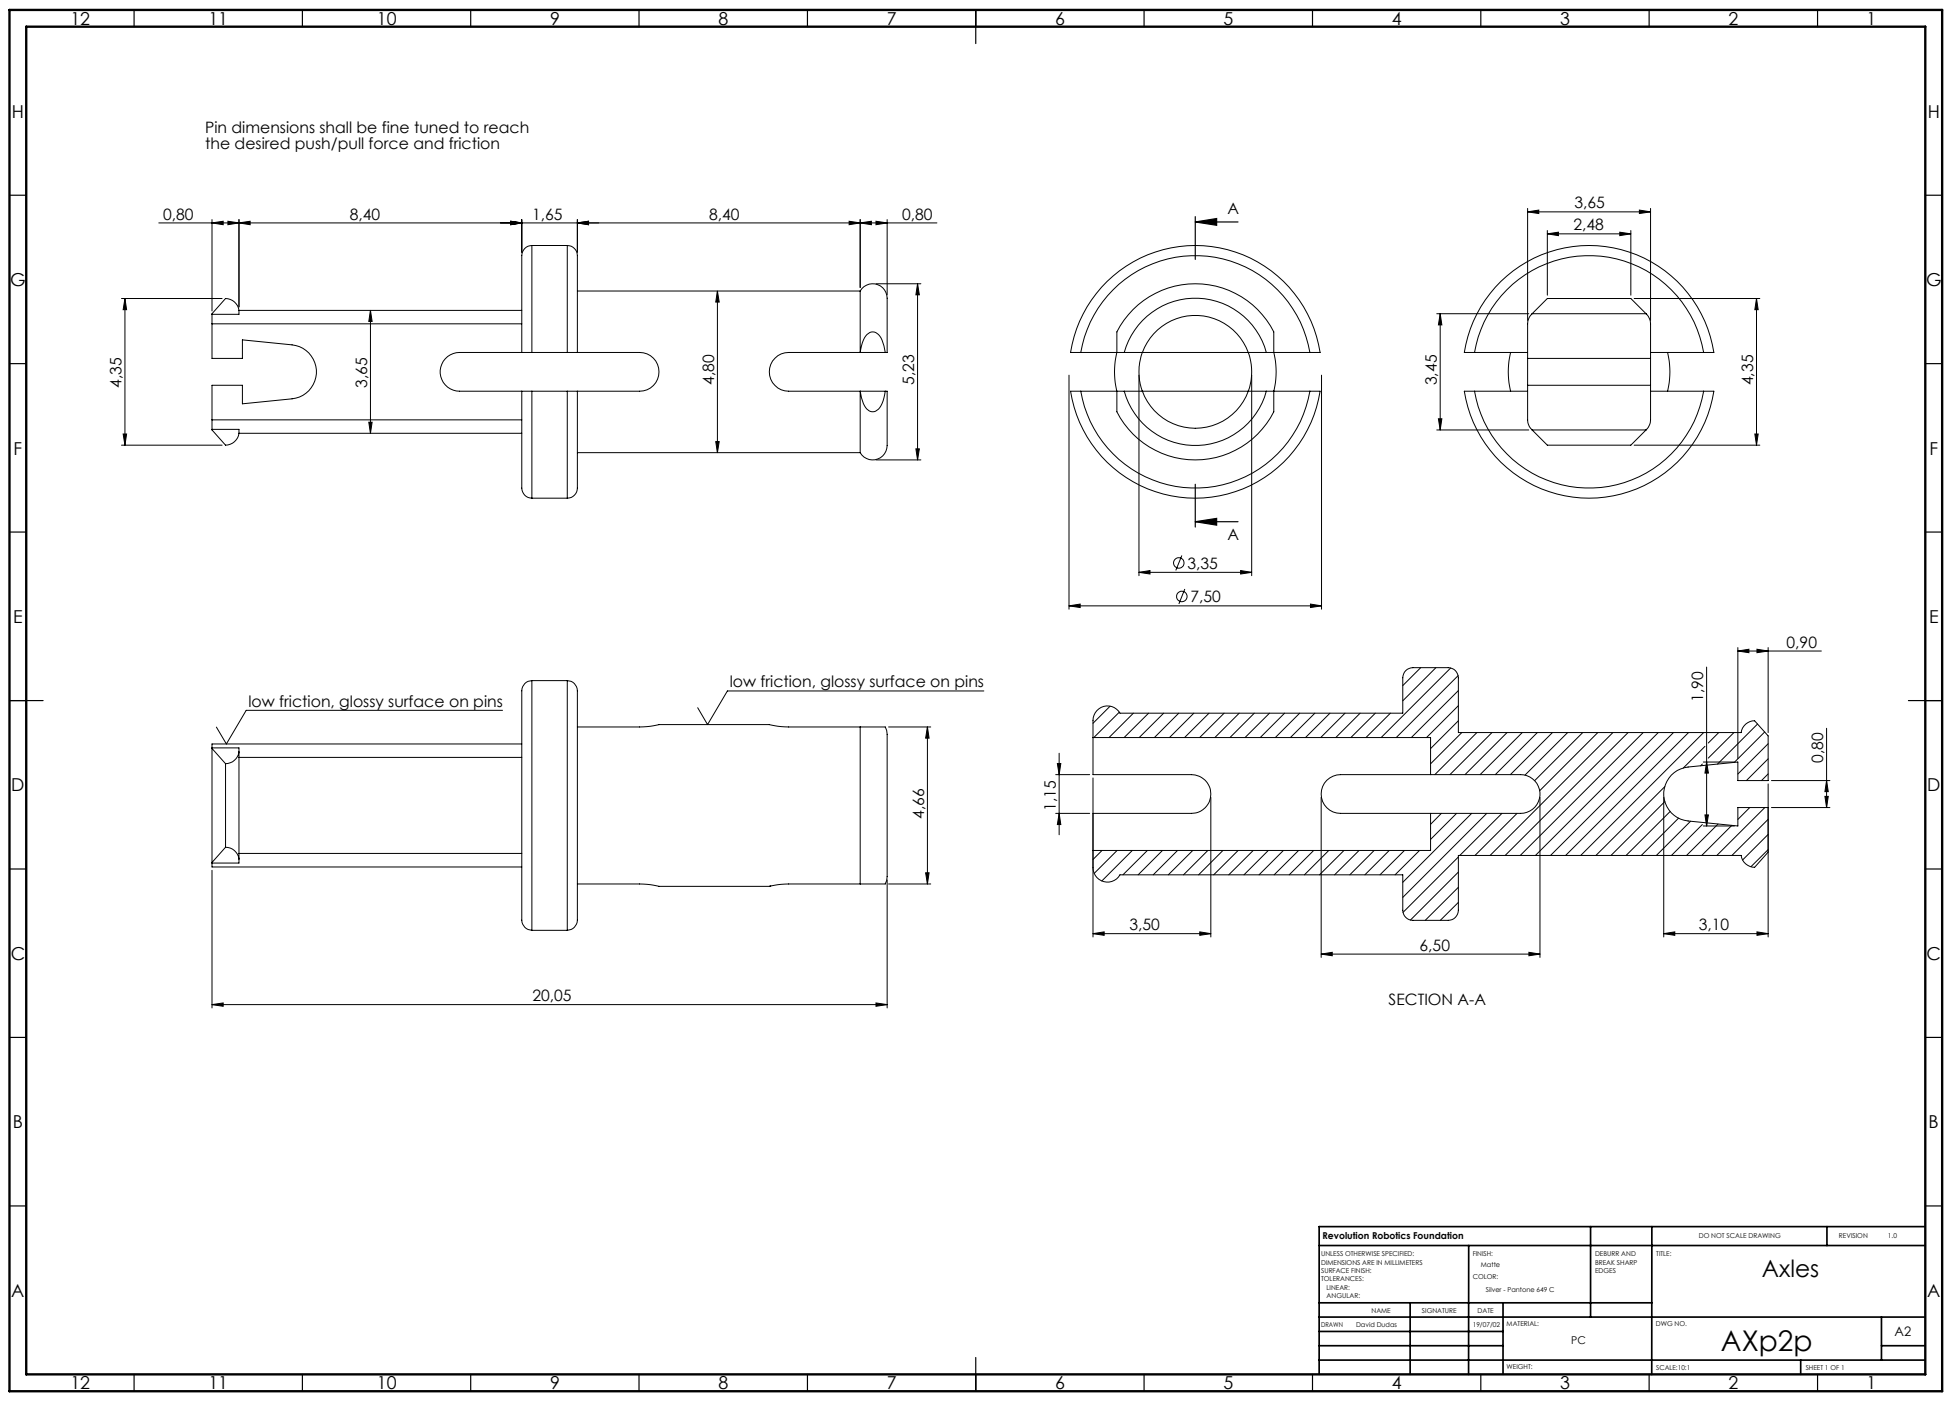
[picture p204: page 1]
SECTION A-A; SCALE:10:1; SHEET 1 OF 1

Pin dimensions shall be fine tuned to reach
the desired push/pull force and friction

low friction, glossy surface on pins

Revolution Robotics Foundation | | DO NOT SCALE DRAWING | REVISION 1.0

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

NAME | SIGNATURE | DATE

DRAWN David Dudas | | 19/07/02 | MATERIAL: PC | DWG NO. AXp2p | A2
