STEAM-Academy-PRO/revolution-robotics-kit/mechanical parts/AXB - Axle Beams/AXb1/AXb1.PDF

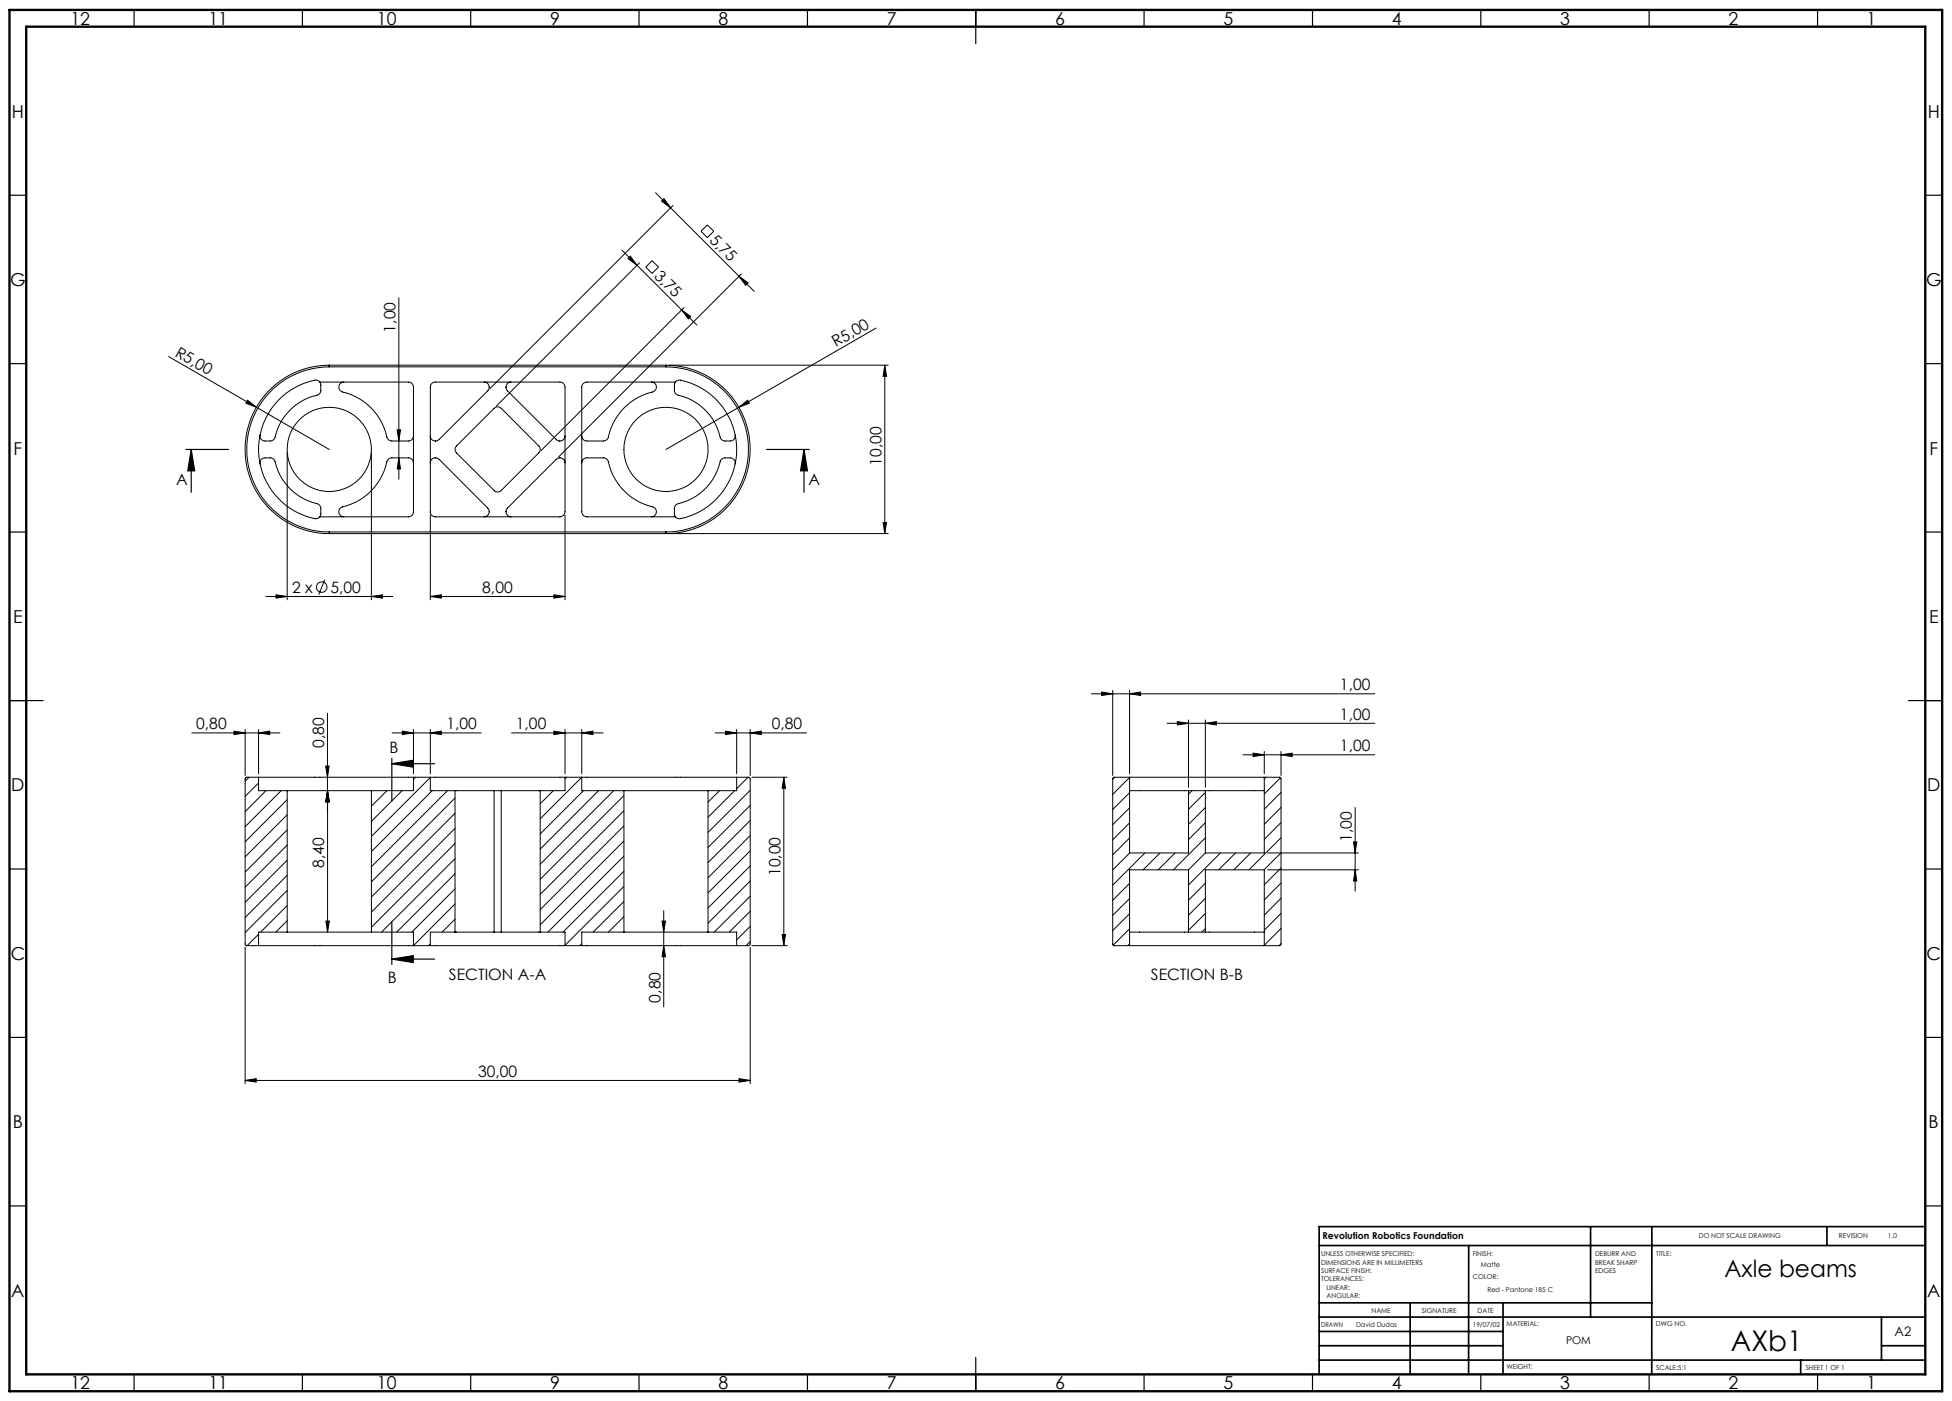
[picture p205: page 1]
SECTION A-A; SECTION B-B; SCALE:5:1; SHEET 1 OF 1

Revolution Robotics Foundation | | DO NOT SCALE DRAWING | REVISION 1.0

UNLESS OTHERWISE SPECIFIED: DIMENSIONS ARE IN MILLIMETERS SURFACE FINISH: TOLERANCES: LINEAR: ANGULAR: | FINISH: Matte COLOR: Red - Pantone 185 C | DEBURR AND BREAK SHARP EDGES | TITLE: Axle beams

NAME | SIGNATURE | DATE

DRAWN David Dudas | | 19/07/02 | MATERIAL: POM | DWG NO. AXb1 | A2
