STEAM-Academy-PRO/revolution-robotics-kit/mechanical parts/CB - Curved Beams/CB4H/CB4H.PDF

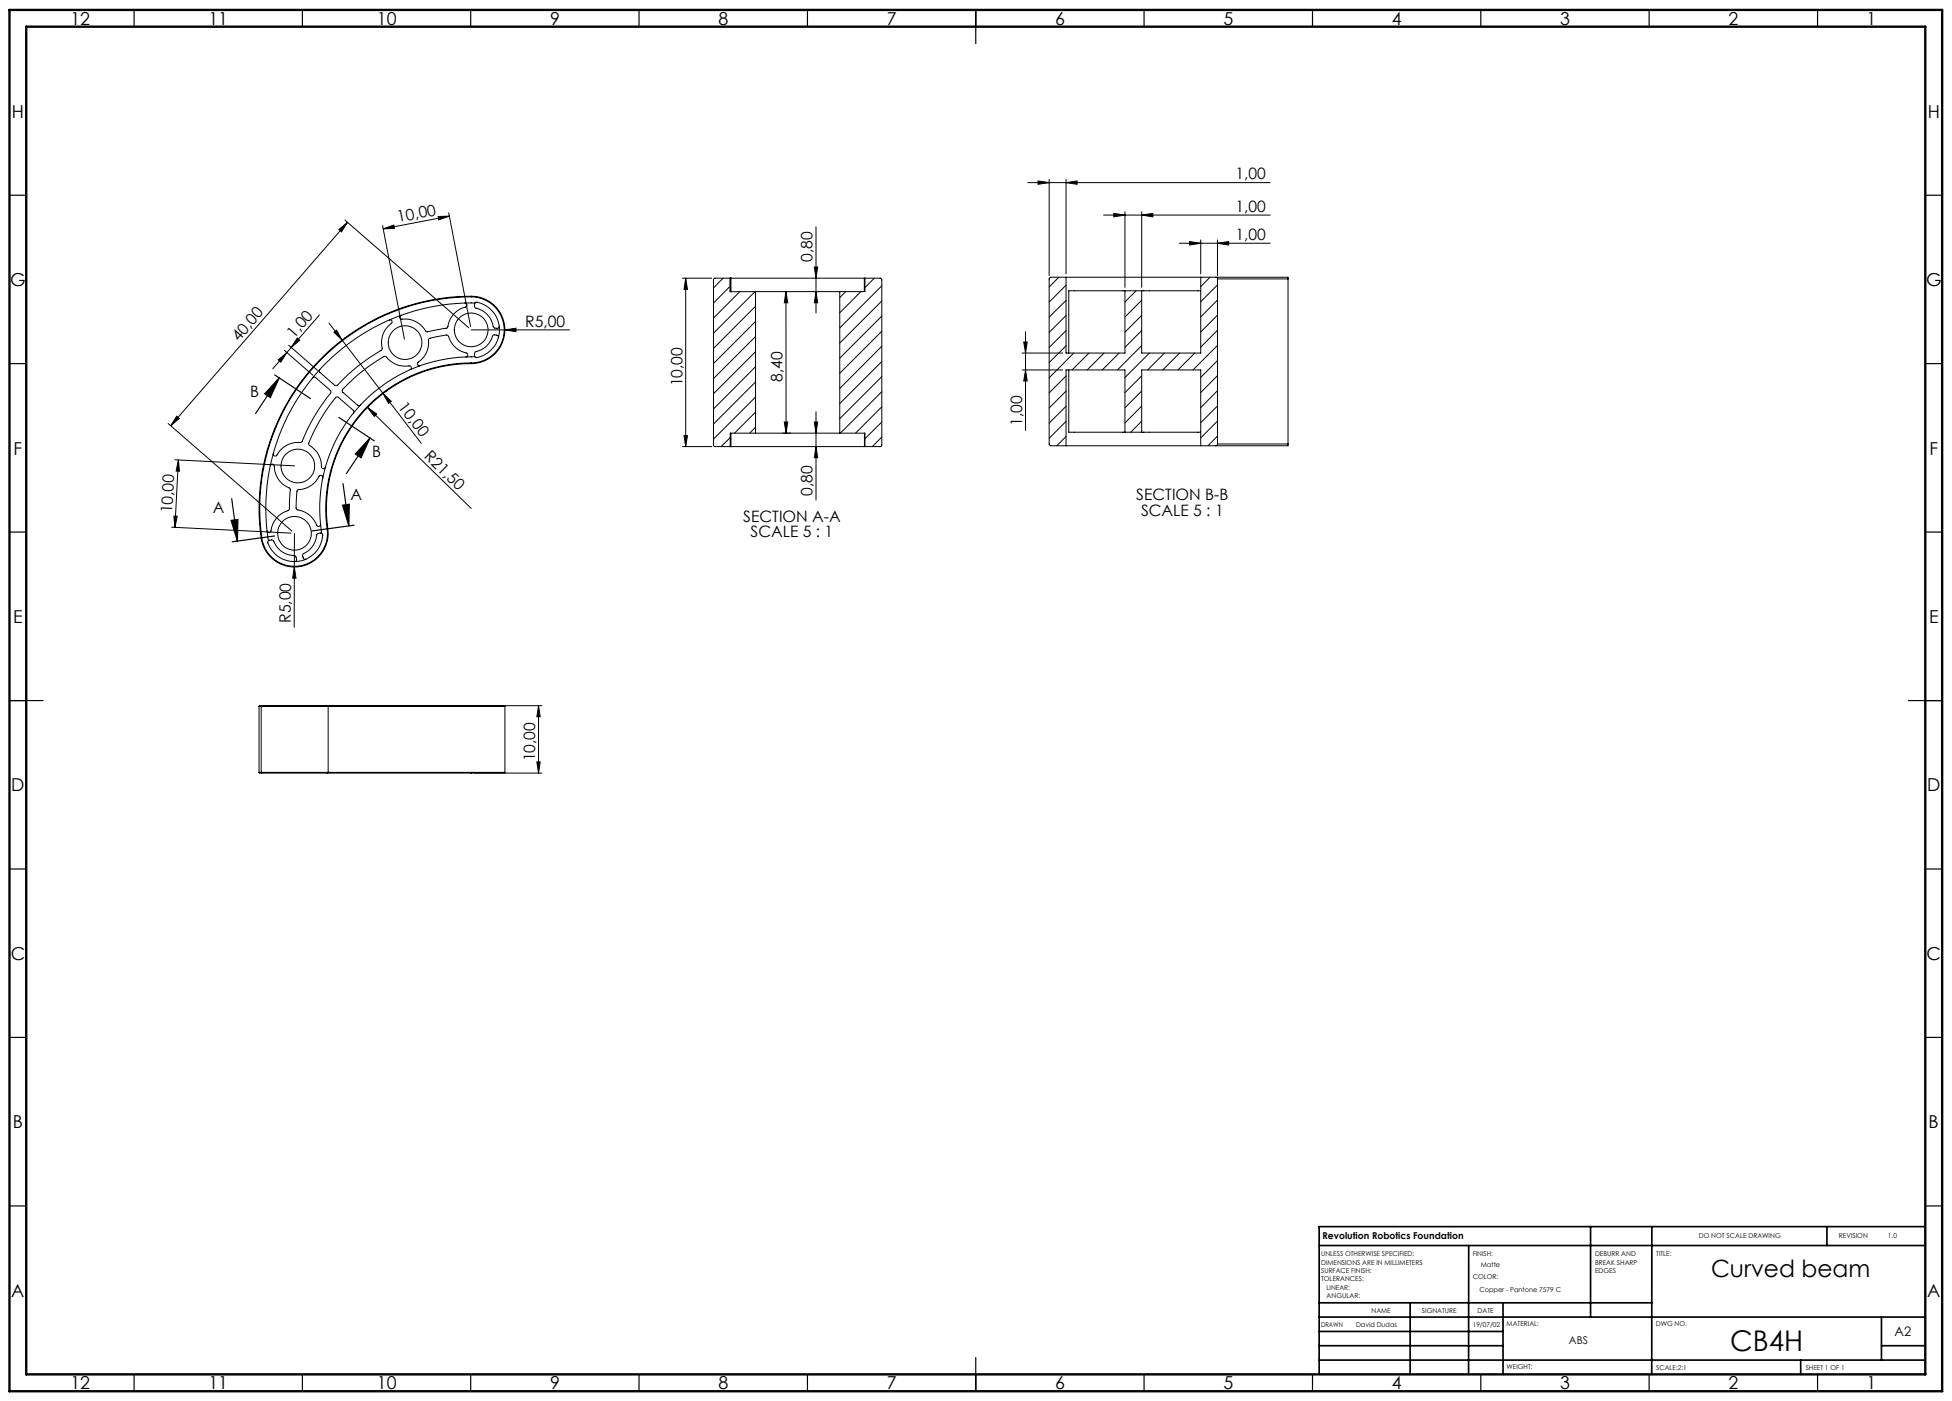
[picture p206: page 1]
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

Revolution Robotics Foundation | | DO NOT SCALE DRAWING | REVISION 1.0

UNLESS OTHERWISE SPECIFIED: DIMENSIONS ARE IN MILLIMETERS SURFACE FINISH: TOLERANCES: LINEAR: ANGULAR: | FINISH: Matte COLOR: Copper - Pantone 7579 C | DEBURR AND BREAK SHARP EDGES | TITLE: Curved beam

NAME | SIGNATURE | DATE

DRAWN David Dudas | | 19/07/02 | MATERIAL: ABS | DWG NO. CB4H | A2
