STEAM-Academy-PRO/revolution-robotics-kit/mechanical parts/CO - Connectors/CC1x1/CC1x1.PDF

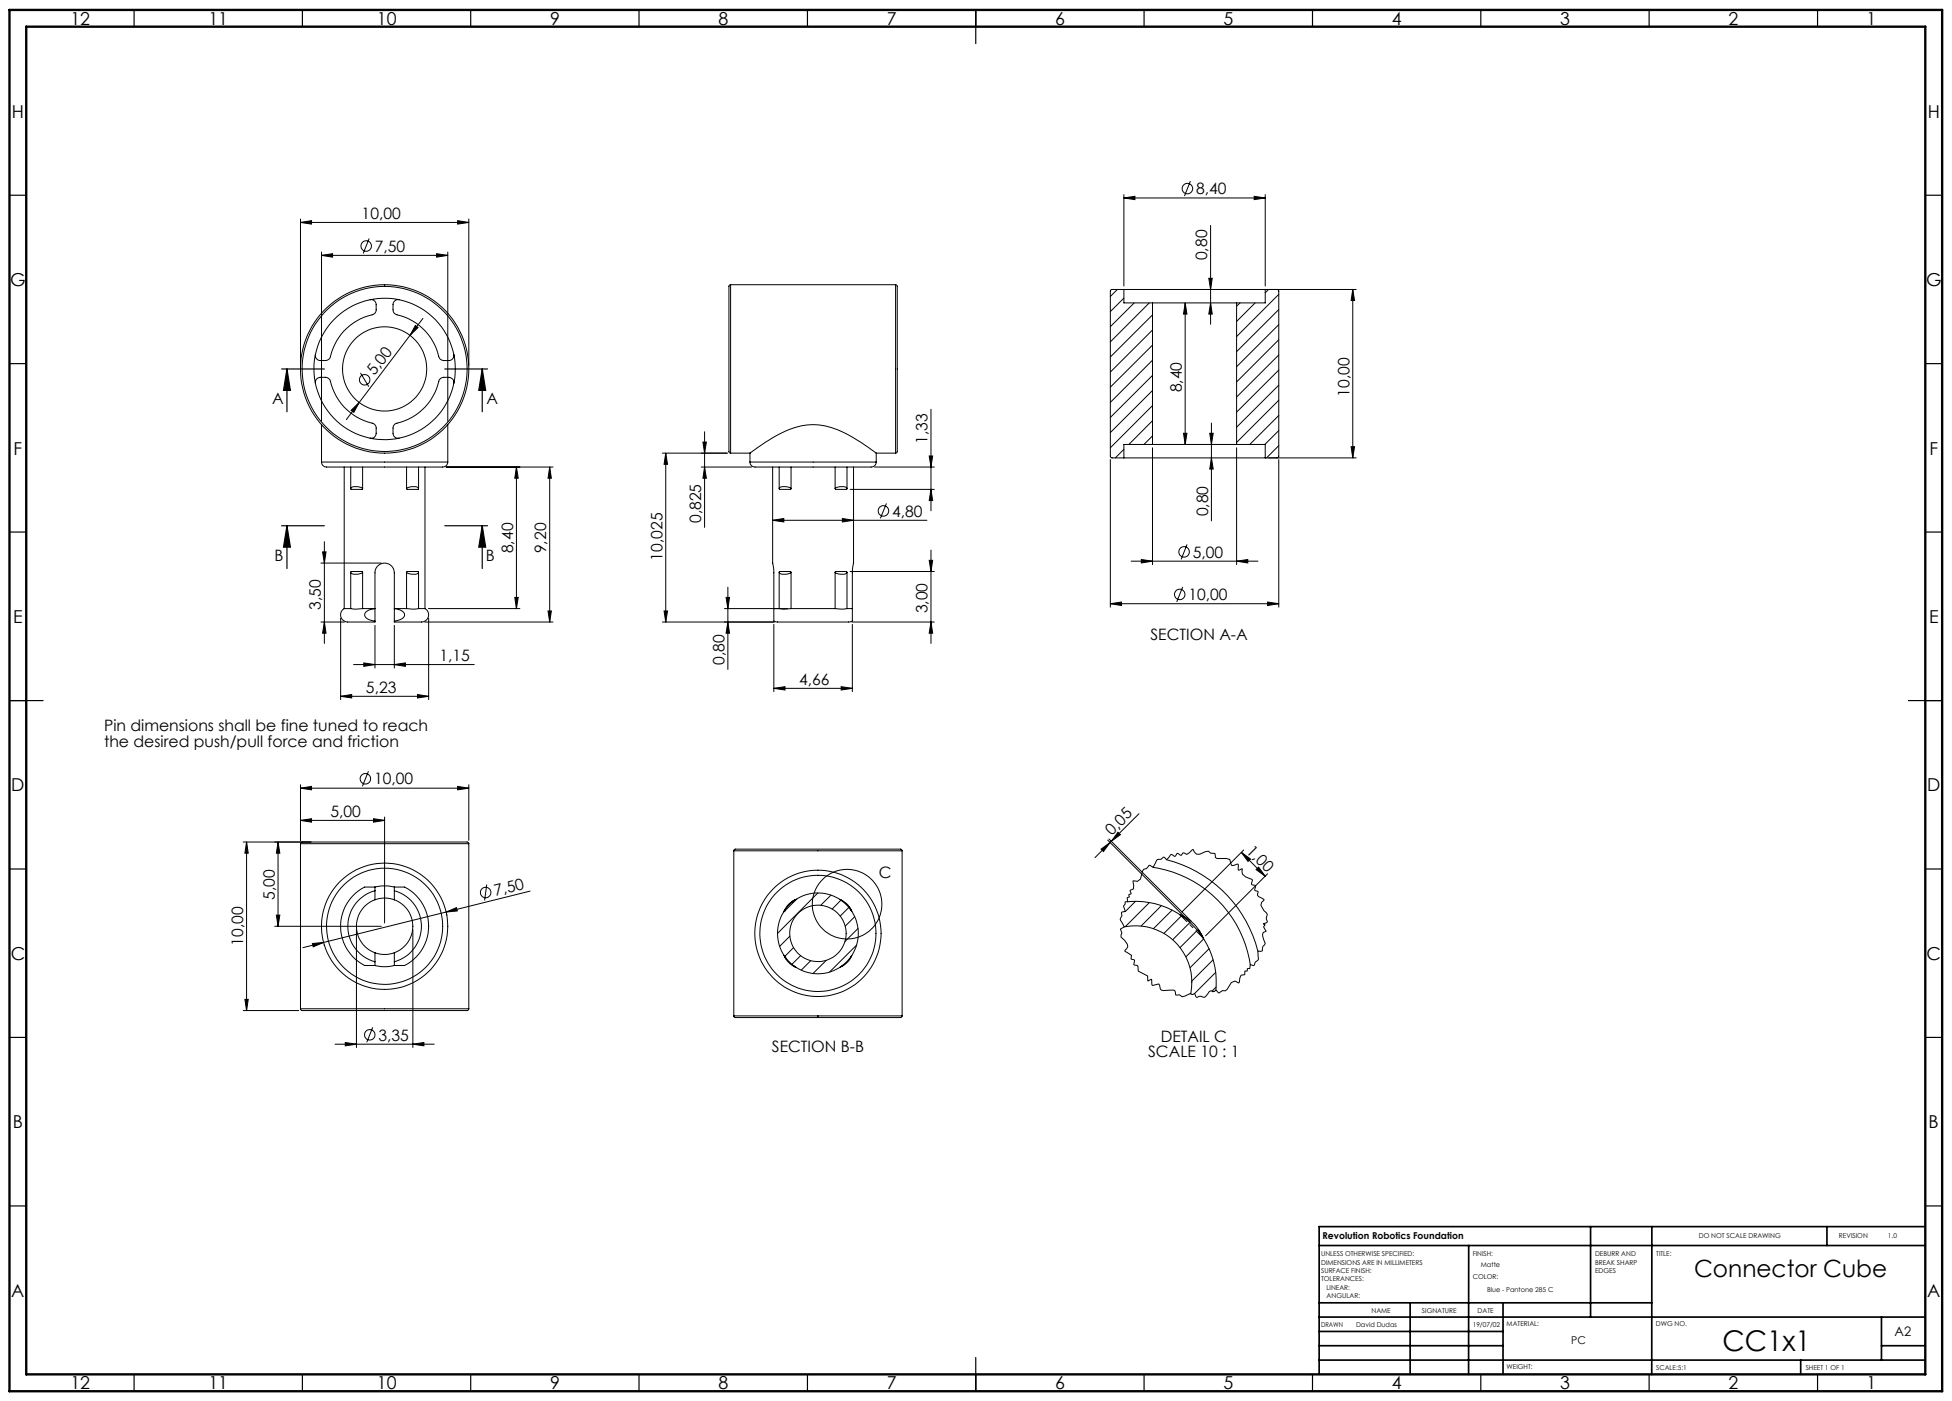
[picture p207: page 1]
SECTION A-A; SECTION B-B; DETAIL C SCALE 10 : 1; SCALE:5:1; SHEET 1 OF 1

Pin dimensions shall be fine tuned to reach
the desired push/pull force and friction

Revolution Robotics Foundation | | DO NOT SCALE DRAWING | REVISION 1.0

UNLESS OTHERWISE SPECIFIED: DIMENSIONS ARE IN MILLIMETERS SURFACE FINISH: TOLERANCES: LINEAR: ANGULAR: | FINISH: Matte COLOR: Blue - Pantone 285 C | DEBURR AND BREAK SHARP EDGES | TITLE: Connector Cube

NAME | SIGNATURE | DATE

DRAWN David Dudas | | 19/07/02 | MATERIAL: PC | DWG NO. CC1x1 | A2
