STEAM-Academy-PRO/revolution-robotics-kit/mechanical parts/CO - Connectors/CC2x2/CC2x2.PDF

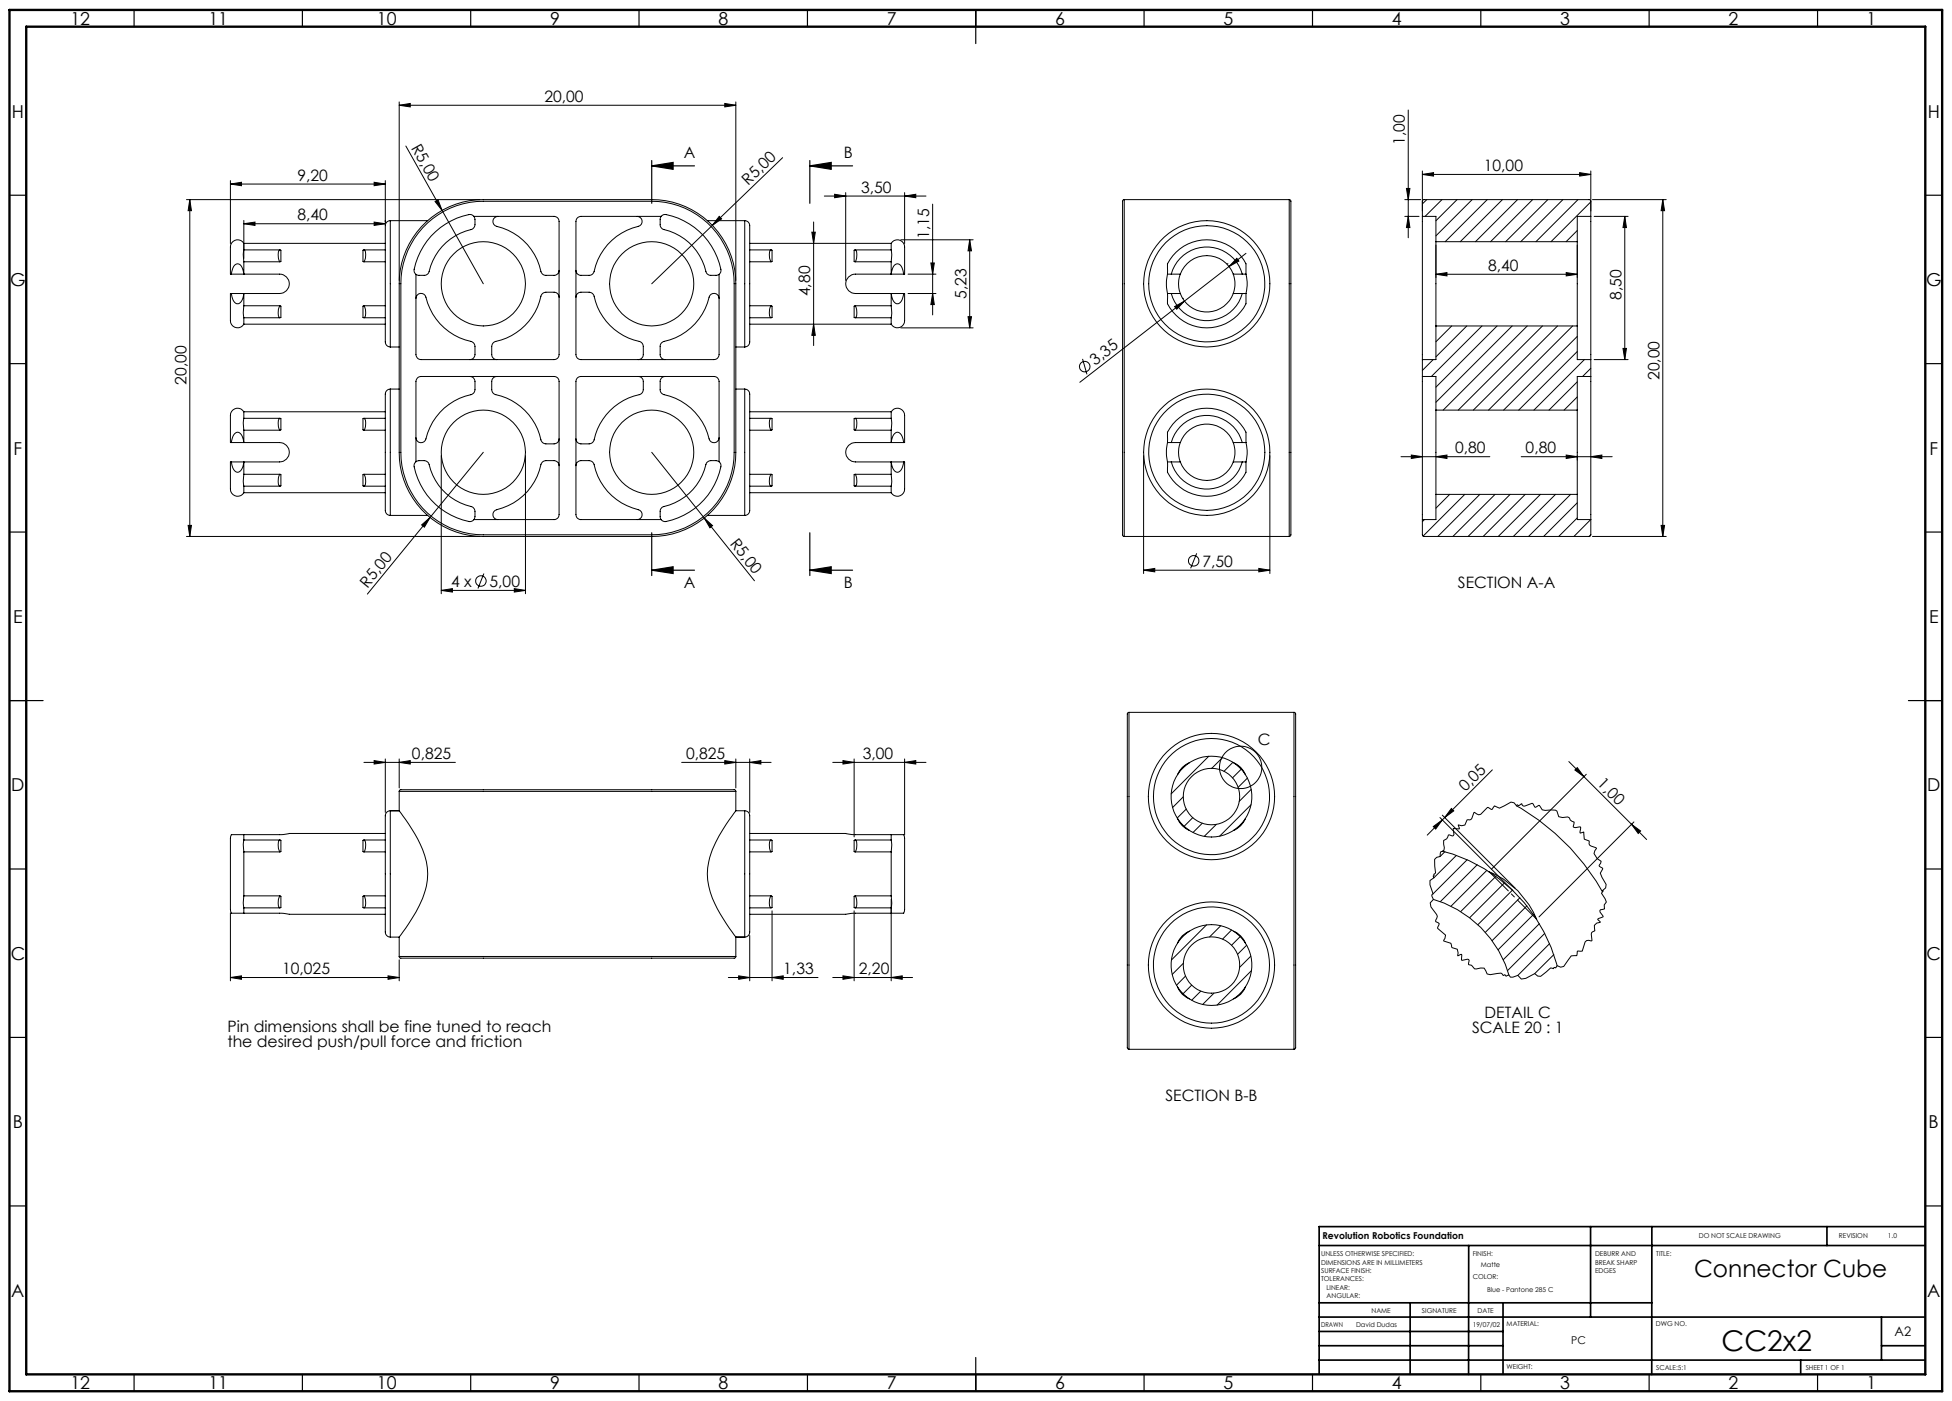
[picture p208: page 1]
SECTION A-A; SECTION B-B; DETAIL C; Pin dimensions shall be fine tuned to reach; SCALE 20 : 1; SCALE:5:1; SHEET 1 OF 1

the desired push/pull force and friction

Revolution Robotics Foundation | | DO NOT SCALE DRAWING | REVISION 1.0

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

NAME | SIGNATURE | DATE

DRAWN David Dudas | | 19/07/02 | MATERIAL: PC | DWG NO. CC2x2 | A2
