STEAM-Academy-PRO/revolution-robotics-kit/mechanical parts/RB - Round Beams/RB12/RBn.PDF

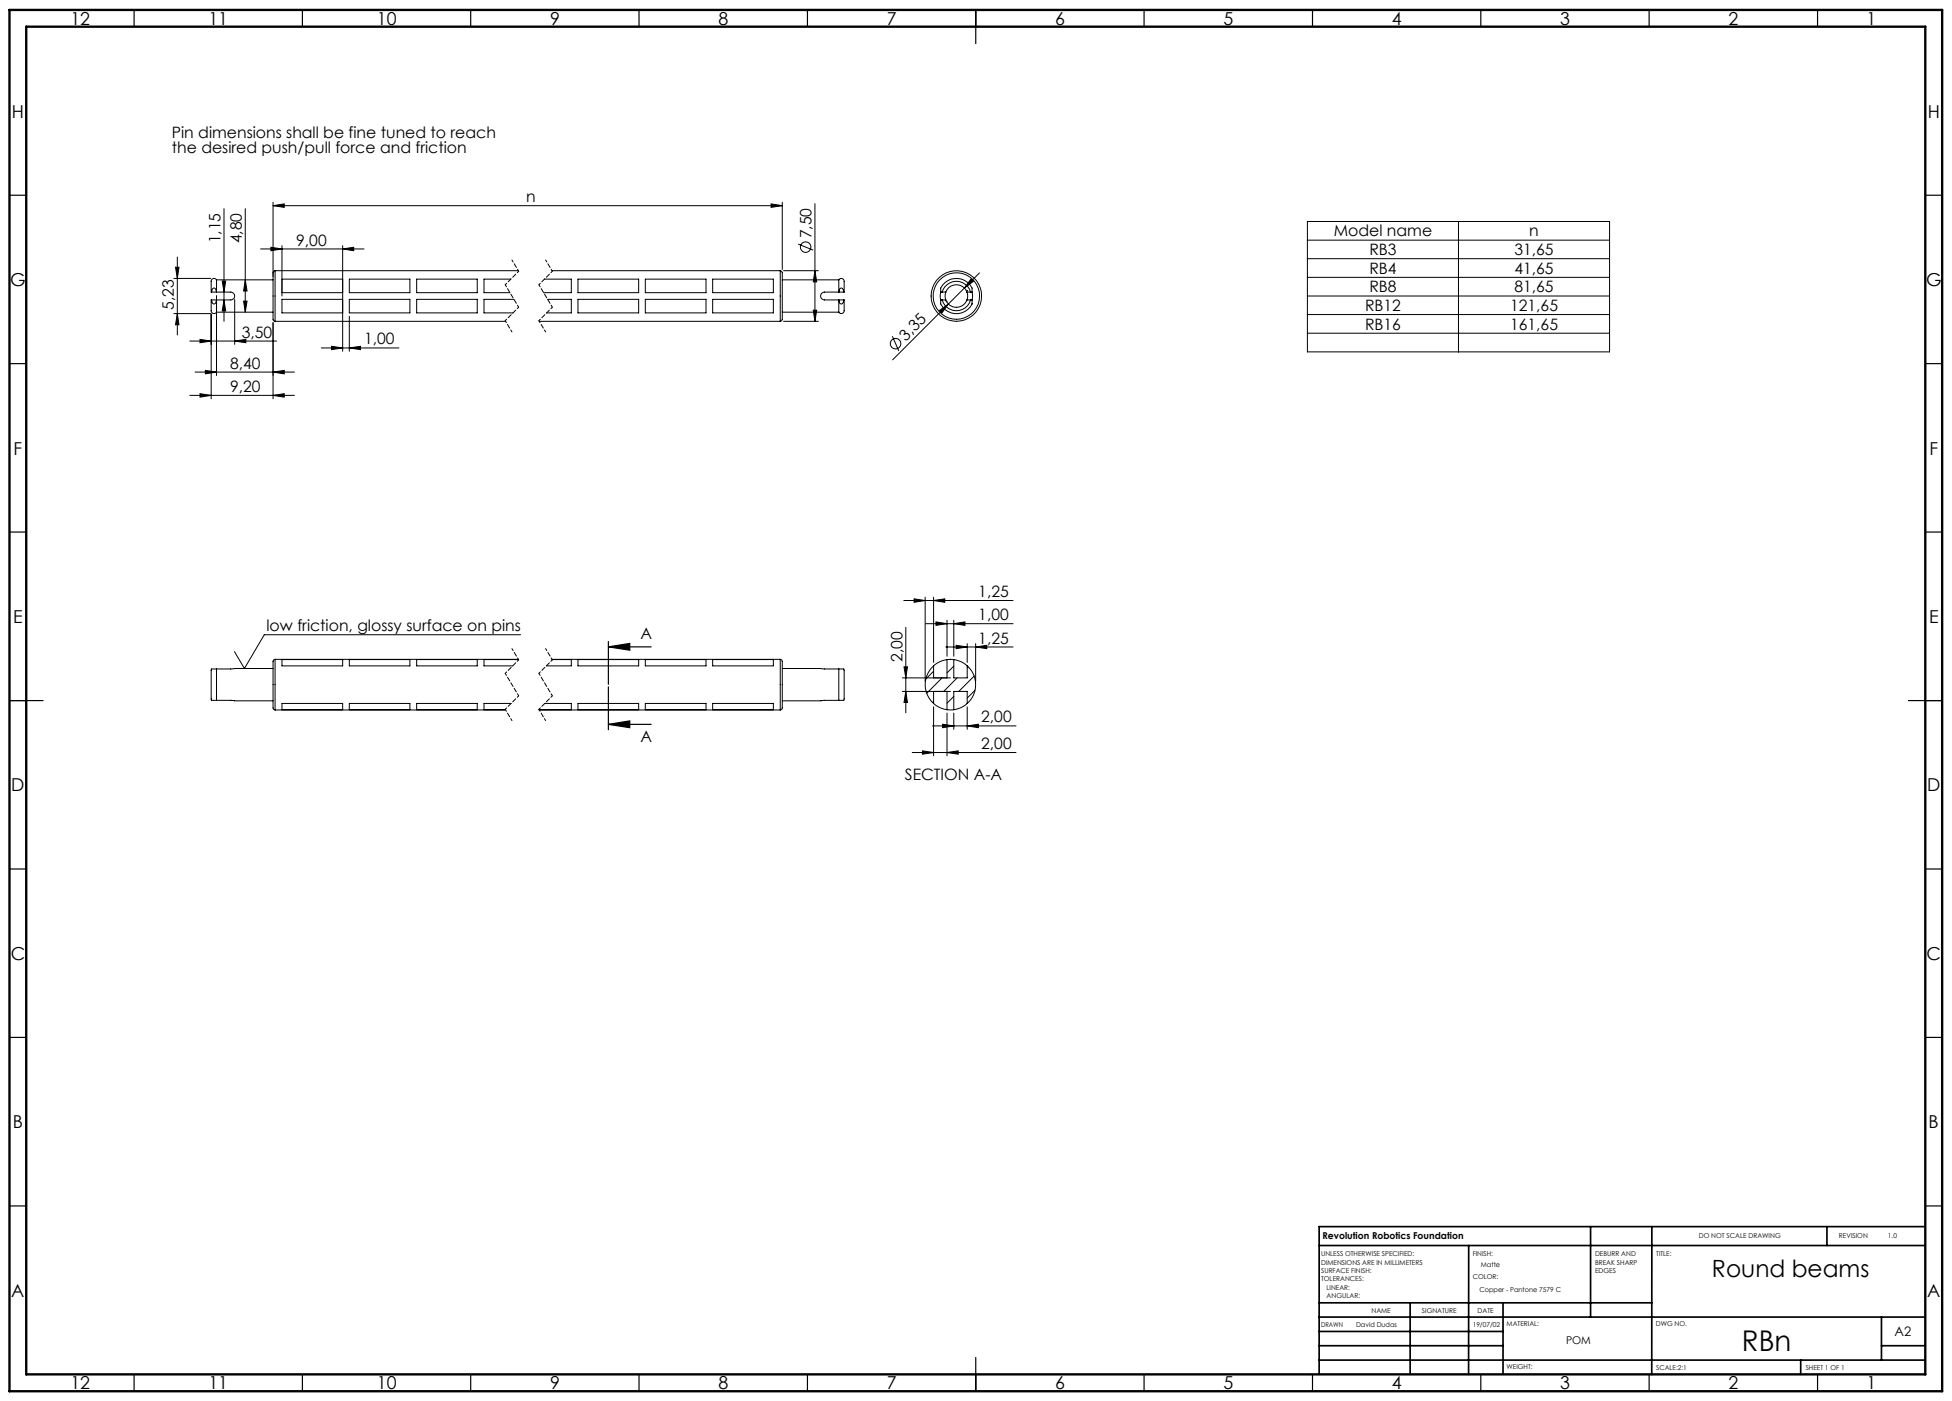
[picture p209: page 1]
SECTION A-A; SCALE:2:1; SHEET 1 OF 1

Pin dimensions shall be fine tuned to reach
the desired push/pull force and friction

Model name | n
RB3 | 31,65
RB4 | 41,65
RB8 | 81,65
RB12 | 121,65
RB16 | 161,65

low friction, glossy surface on pins

Revolution Robotics Foundation | | DO NOT SCALE DRAWING | REVISION 1.0

UNLESS OTHERWISE SPECIFIED: DIMENSIONS ARE IN MILLIMETERS SURFACE FINISH: TOLERANCES: LINEAR: ANGULAR: | FINISH: Matte COLOR: Copper - Pantone 7579 C | DEBURR AND BREAK SHARP EDGES | TITLE: Round beams

NAME | SIGNATURE | DATE

DRAWN David Dudas | | 19/07/02 | MATERIAL: POM | DWG NO. RBn | A2
