STEAM-Academy-PRO/revolution-robotics-kit/mechanical parts/SB - Straight Beams/S1x1/Sn1x.PDF

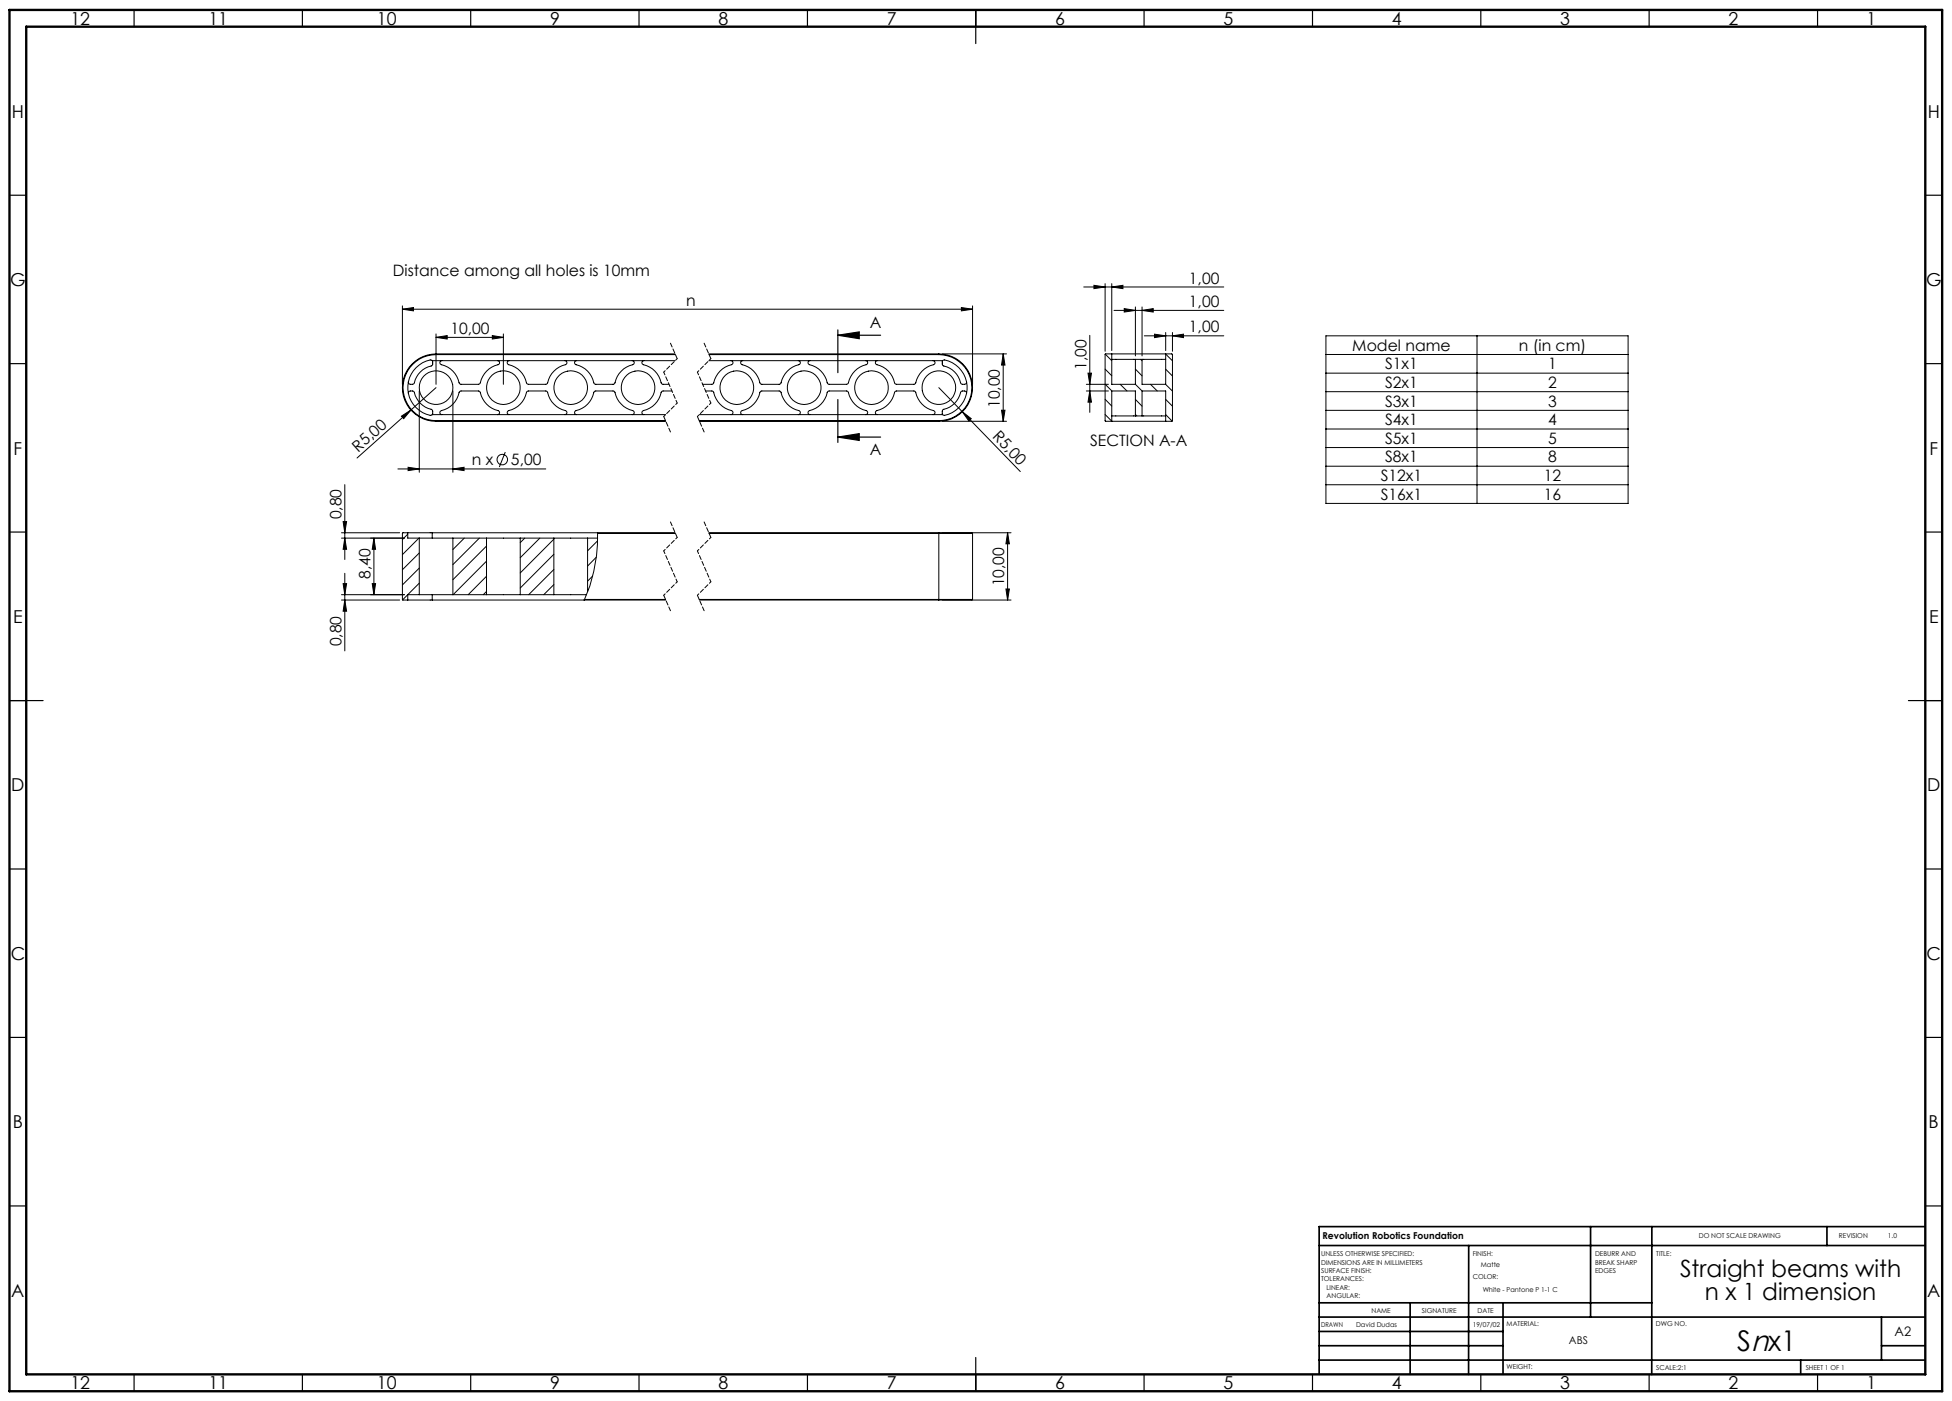
[picture p210: page 1]
SECTION A-A; SCALE:2:1; SHEET 1 OF 1

Distance among all holes is 10mm

Model name | n (in cm)
S1x1 | 1
S2x1 | 2
S3x1 | 3
S4x1 | 4
S5x1 | 5
S8x1 | 8
S12x1 | 12
S16x1 | 16

Revolution Robotics Foundation | | DO NOT SCALE DRAWING | REVISION 1.0

UNLESS OTHERWISE SPECIFIED: DIMENSIONS ARE IN MILLIMETERS SURFACE FINISH: TOLERANCES: LINEAR: ANGULAR: | FINISH: Matte COLOR: White - Pantone P 1-1 C | DEBURR AND BREAK SHARP EDGES | TITLE: Straight beams with n x 1 dimension

NAME | SIGNATURE | DATE

DRAWN David Dudas | | 19/07/02 | MATERIAL: ABS | DWG NO. Snx1 | A2
