STEAM-Academy-PRO/revolution-robotics-kit/mechanical parts/SB - Straight Beams/S2x10/Sn2x.PDF

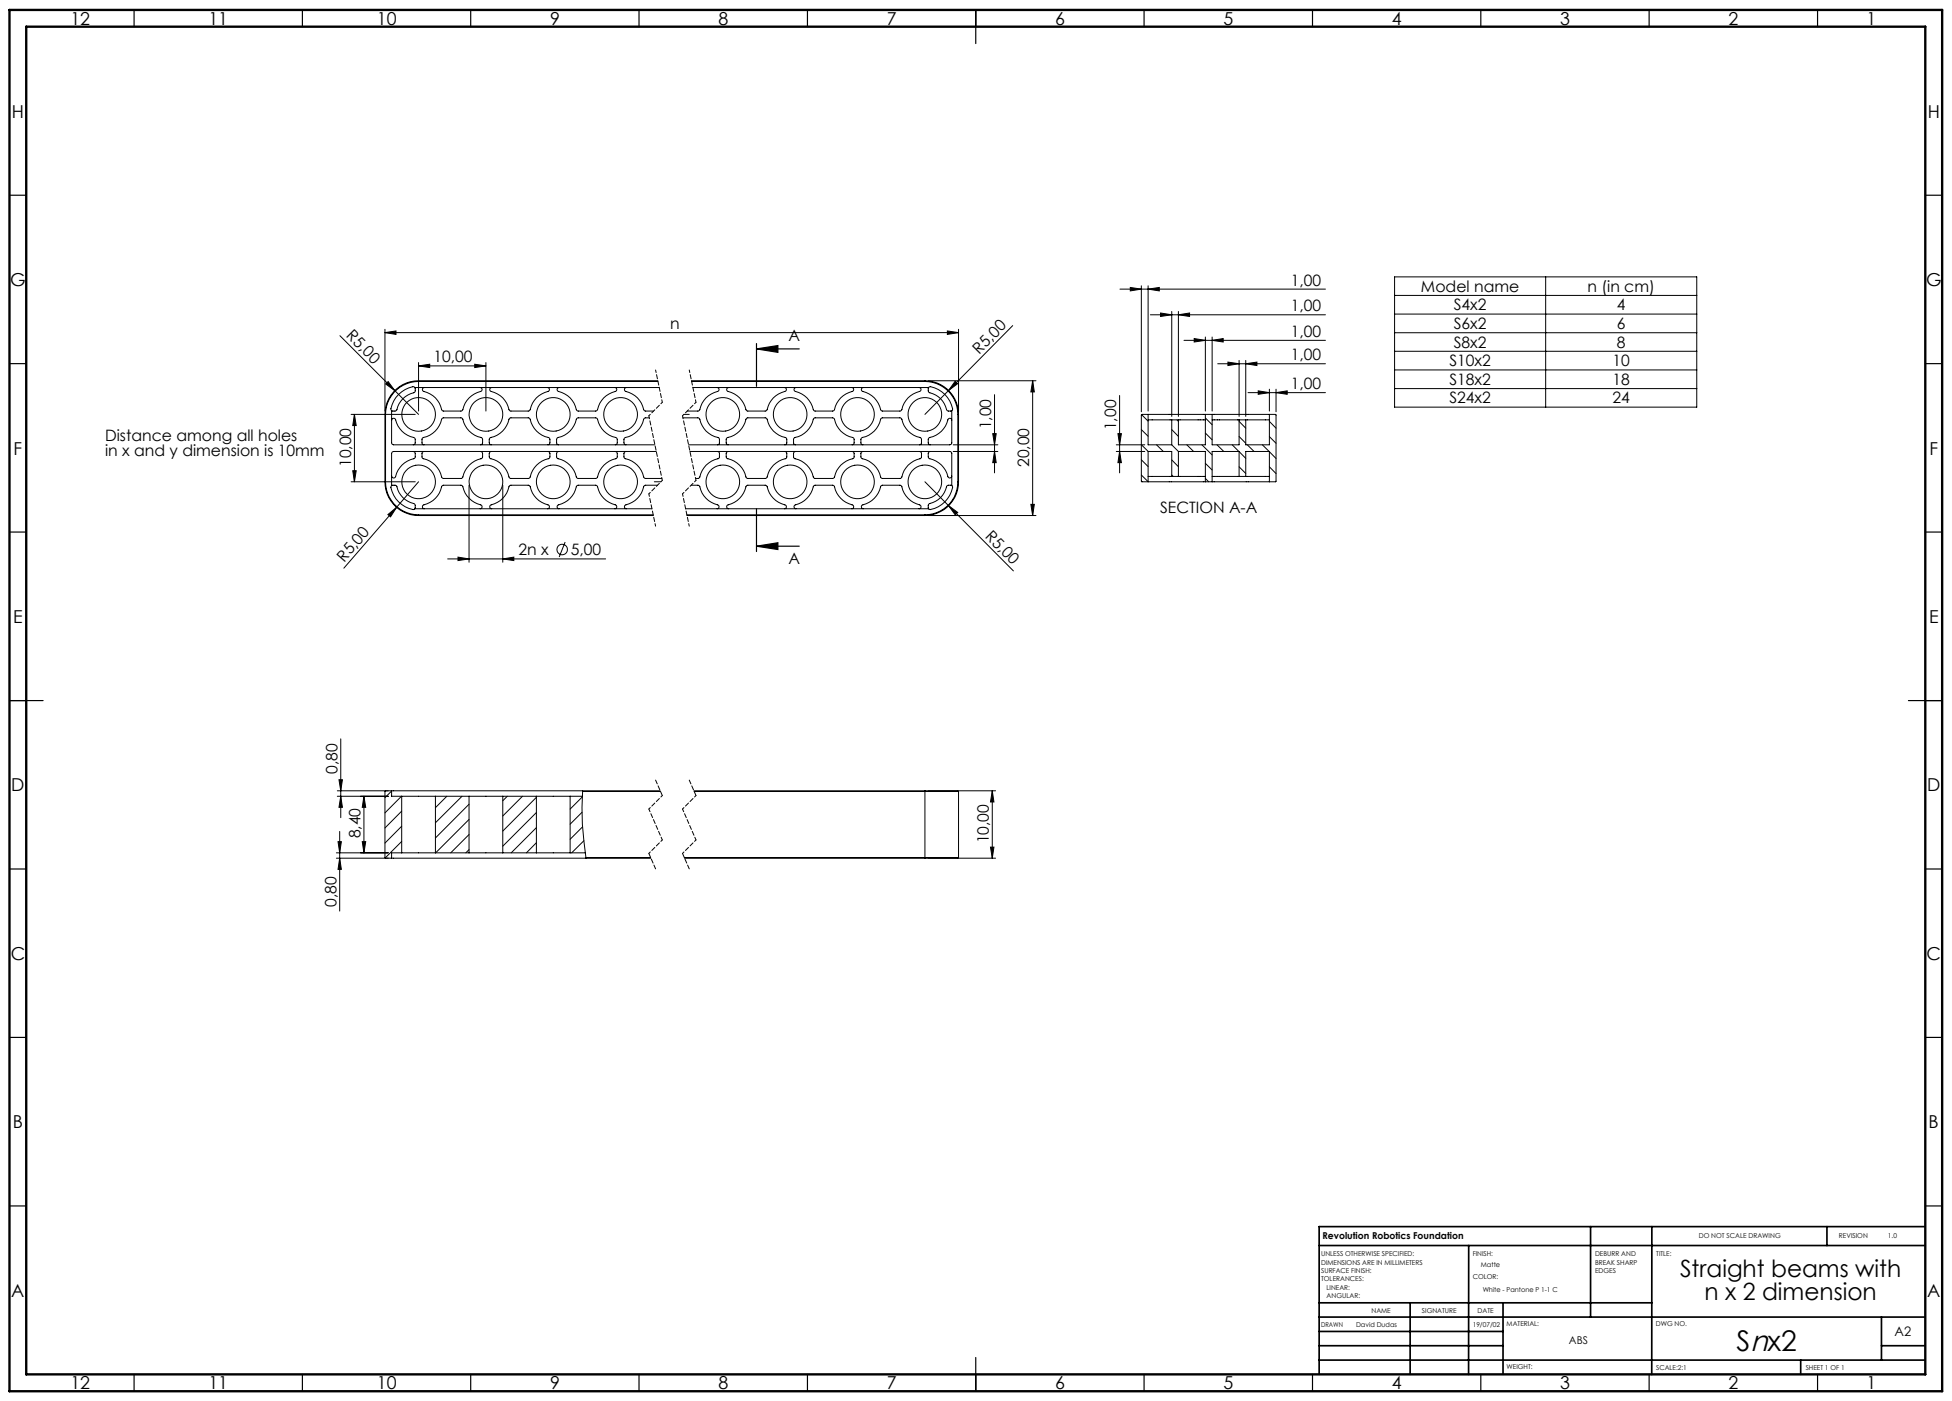
[picture p211: page 1]
SECTION A-A; SCALE:2:1; SHEET 1 OF 1

Model name | n (in cm)
S4x2 | 4
S6x2 | 6
S8x2 | 8
S10x2 | 10
S18x2 | 18
S24x2 | 24

Distance among all holes
in x and y dimension is 10mm

Revolution Robotics Foundation | | DO NOT SCALE DRAWING | REVISION 1.0

UNLESS OTHERWISE SPECIFIED: DIMENSIONS ARE IN MILLIMETERS SURFACE FINISH: TOLERANCES: LINEAR: ANGULAR: | FINISH: Matte COLOR: White - Pantone P 1-1 C | DEBURR AND BREAK SHARP EDGES | TITLE: Straight beams with n x 2 dimension

NAME | SIGNATURE | DATE

DRAWN David Dudas | | 19/07/02 | MATERIAL: ABS | DWG NO. Snx2 | A2
