STEAM-Academy-PRO/revolution-robotics-kit/mechanical parts/WE - Wedges/WE5x4/WE5x4.PDF

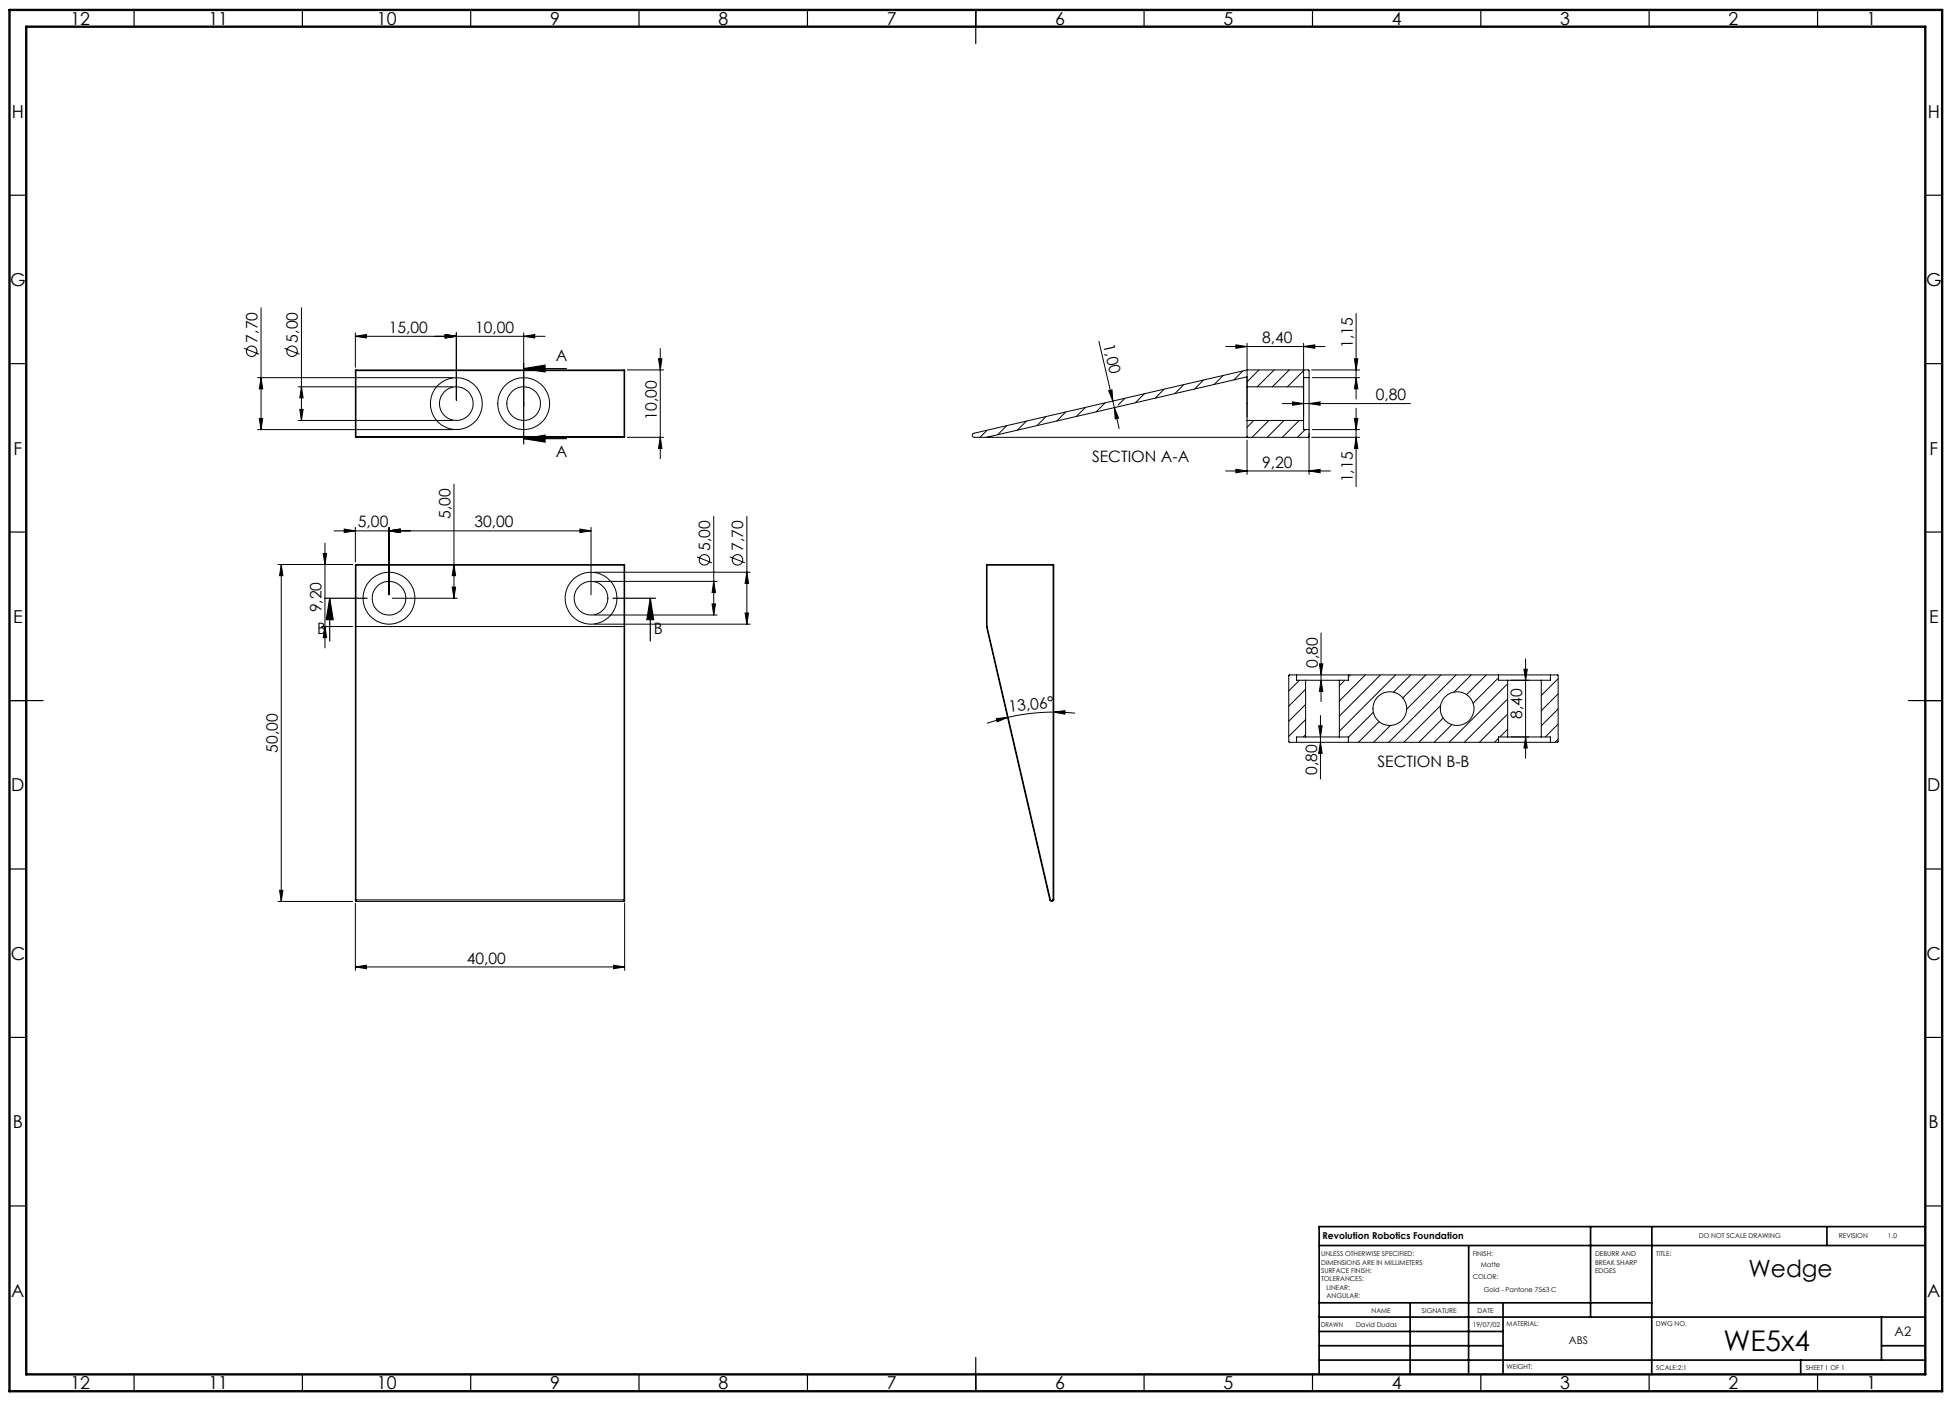
[picture p212: page 1]
SECTION A-A; SECTION B-B; SCALE:2:1; SHEET 1 OF 1

Revolution Robotics Foundation | | DO NOT SCALE DRAWING | REVISION 1.0

UNLESS OTHERWISE SPECIFIED: DIMENSIONS ARE IN MILLIMETERS SURFACE FINISH: TOLERANCES: LINEAR: ANGULAR: | FINISH: Matte COLOR: Gold - Pantone 7563 C | DEBURR AND BREAK SHARP EDGES | TITLE: Wedge

NAME | SIGNATURE | DATE

DRAWN David Dudas | | 19/07/02 | MATERIAL: ABS | DWG NO. WE5x4 | A2
