STEAM-Academy-PRO/revolution-robotics-kit/electronic parts/CS - Colour Sensor/Colour-sensor-v1-pre-production/PCB/Color_Sensor_Board_Assembly_Drawing.PDF

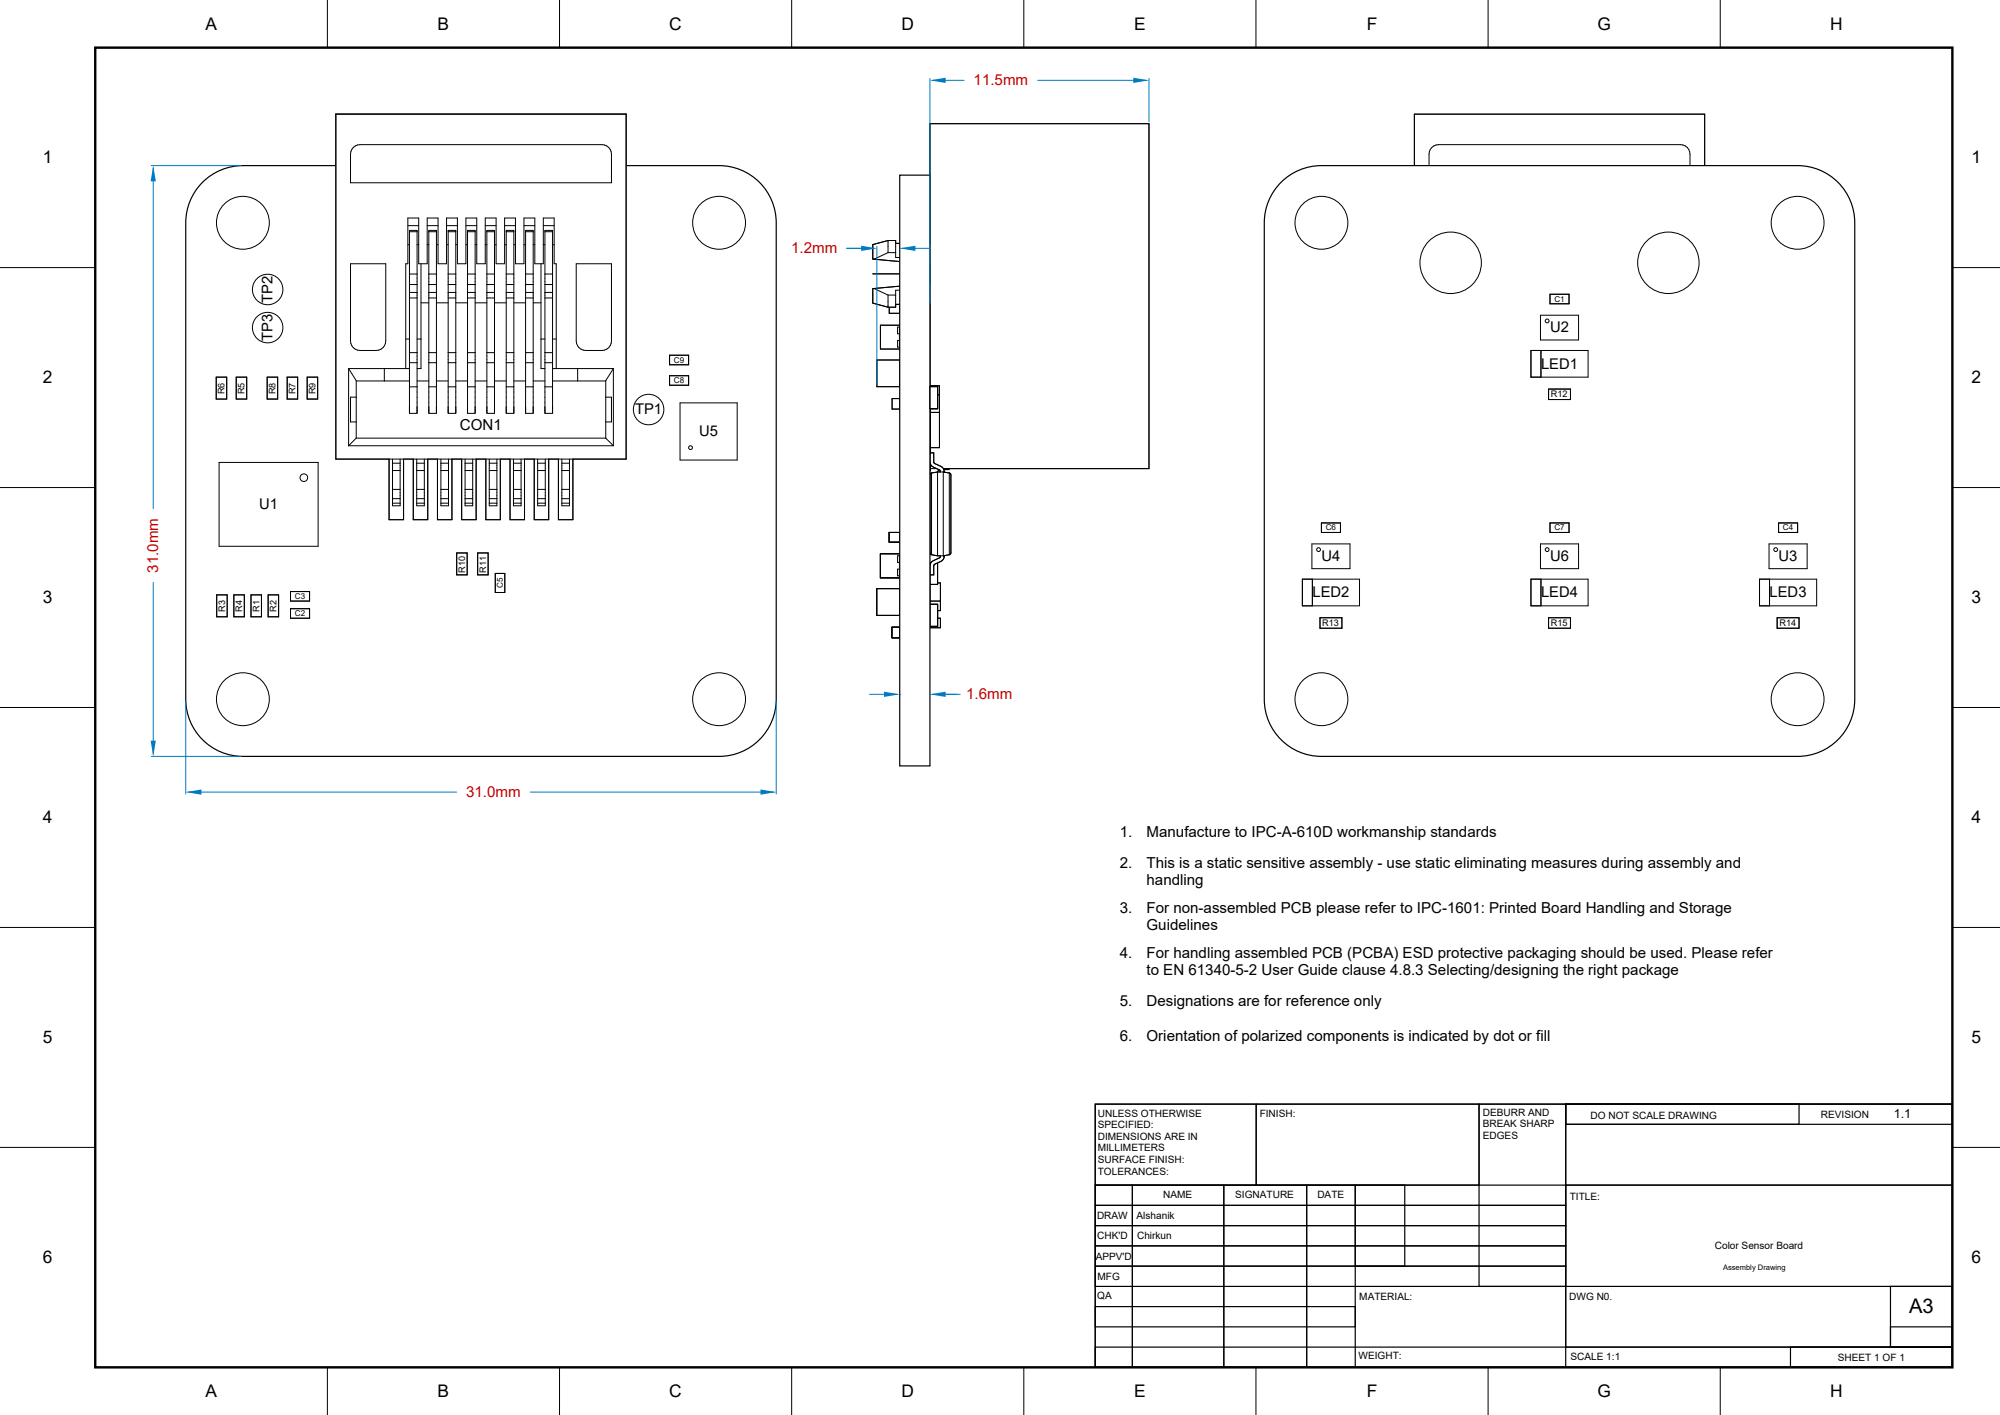
[picture p213: page 1]

1. Manufacture to IPC-A-610D workmanship standards
This is a static sensitive assembly - use static eliminating measures during assembly and
handling
For non-assembled PCB please refer to IPC-1601: Printed Board Handling and Storage
Guidelines
For handling assembled PCB (PCBA) ESD protective packaging should be used. Please refer
to EN 61340-5-2 User Guide clause 4.8.3 Selecting/designing the right package
5. Designations are for reference only

6. Orientation of polarized components is indicated by dot or fill

NAME | SIGNATURE | DATE | | | | TITLE: Color Sensor Board Assembly Drawing

DRAW | Alshanik
CHK'D | Chirkun

APPV'D
MFG
QA | | | | MATERIAL: | DWG N0. | A3
