STEAM-Academy-PRO/revolution-robotics-kit/electronic parts/CS - Colour Sensor/Colour-sensor-v1-pre-production/PCB/Color_Sensor_Board_Fabrication_Drawing.PDF

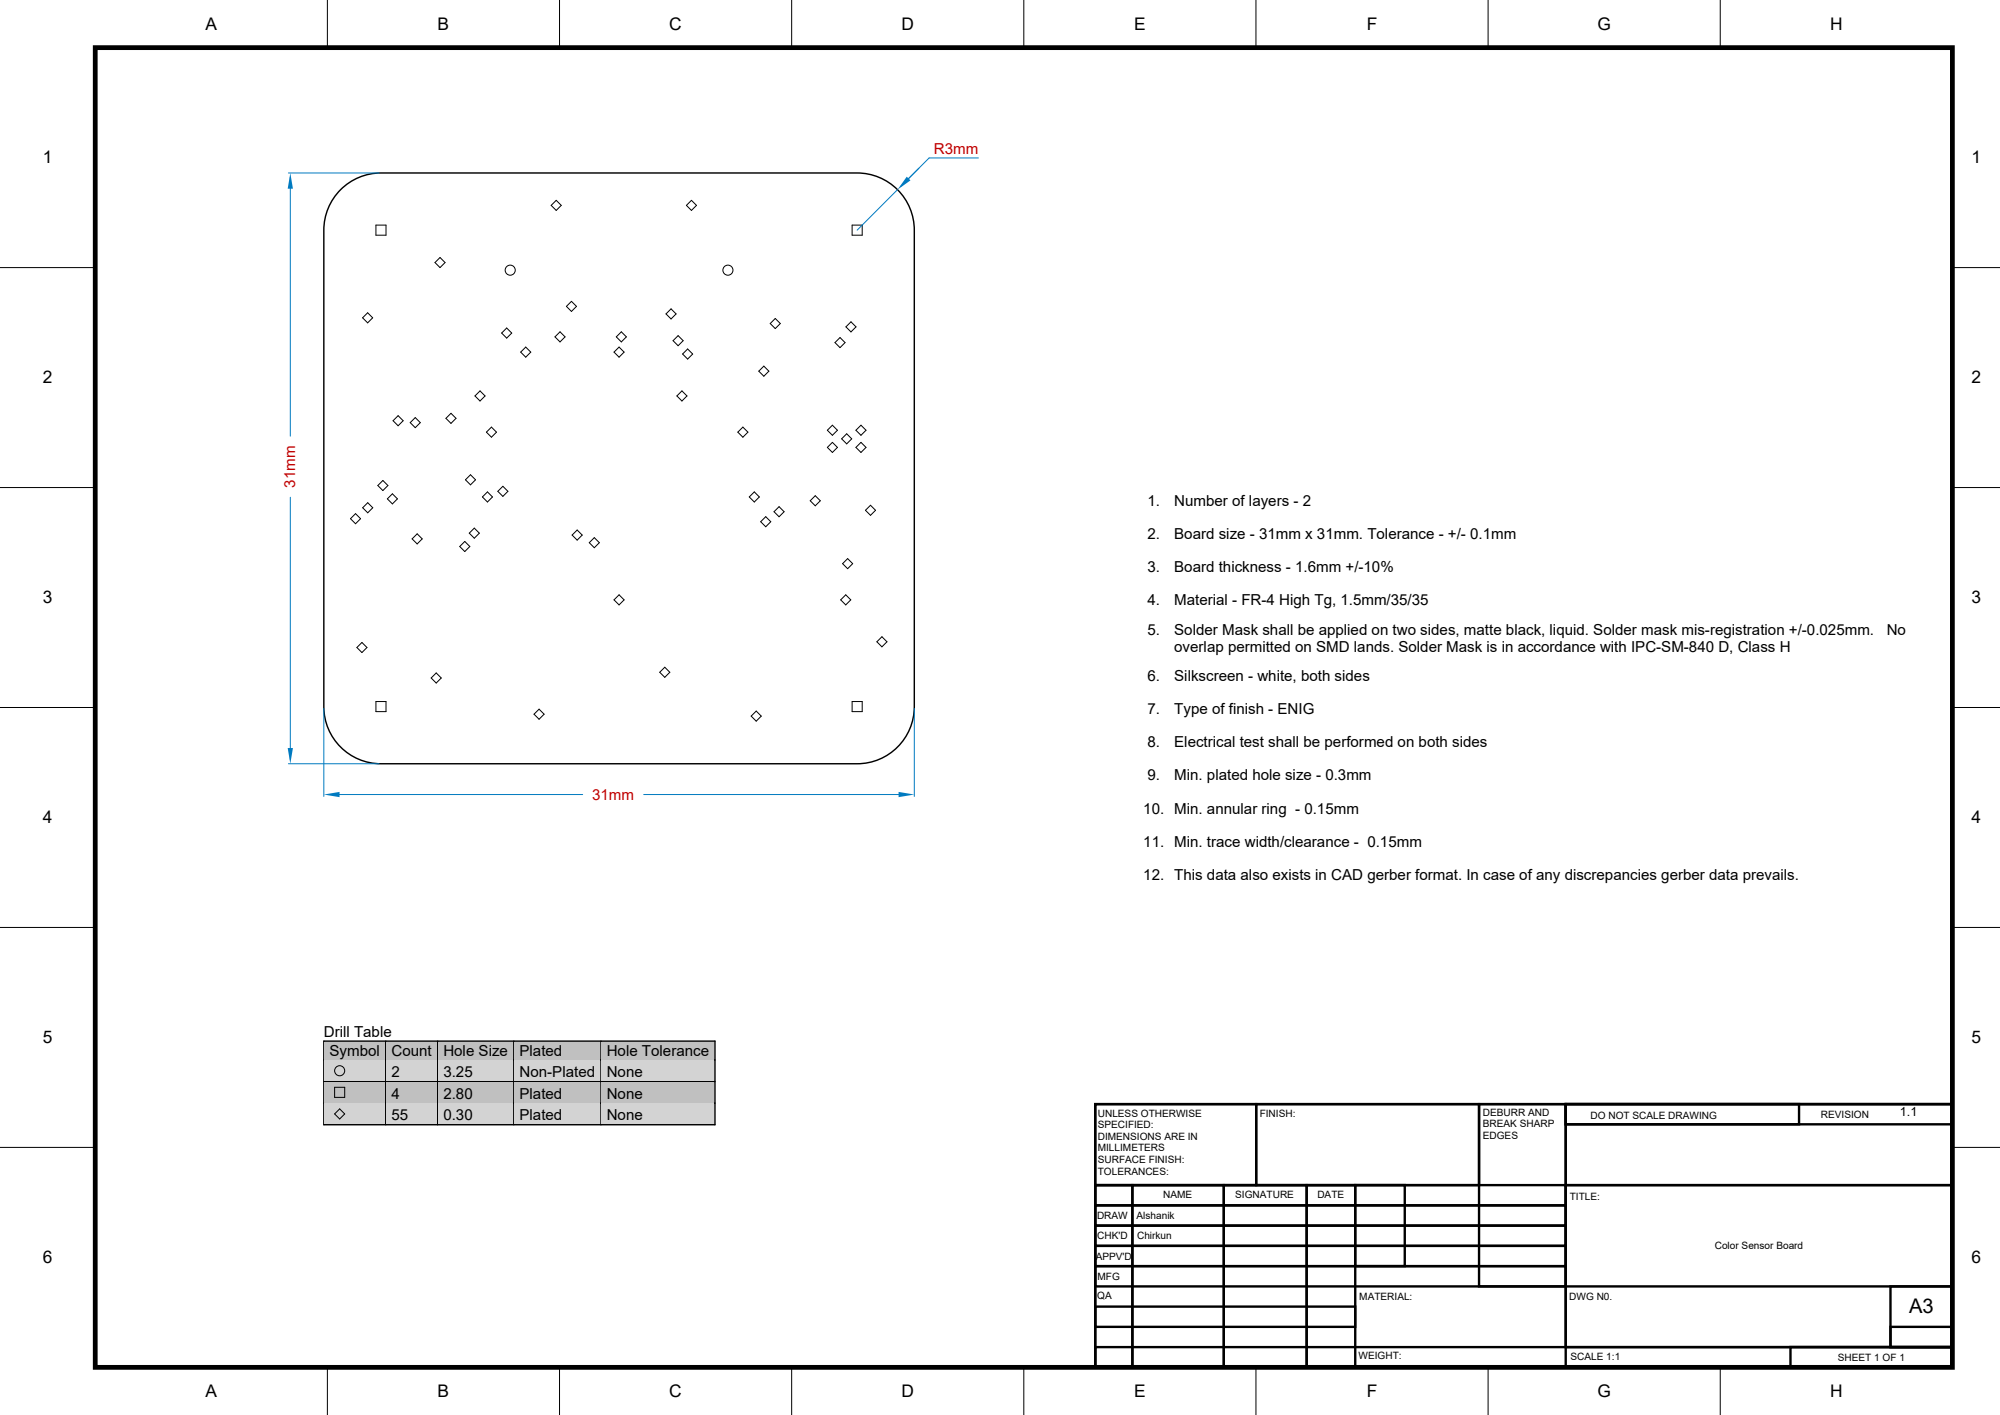
[picture p214: page 1]

4. Material - FR-4 High Tg, 1.5mm/35/35
Solder Mask shall be applied on two sides, matte black, liquid. Solder mask mis-registration +/-0.025mm. No
overlap permitted on SMD lands. Solder Mask is in accordance with IPC-SM-840 D, Class H
6. Silkscreen - white, both sides

7. Type of finish - ENIG

8. Electrical test shall be performed on both sides

9. Min. plated hole size - 0.3mm

11. Min. trace width/clearance - 0.15mm

12. This data also exists in CAD gerber format. In case of any discrepancies gerber data prevails.

Symbol | Count | Hole Size | Plated | Hole Tolerance

2 | 3.25 | Non-Plated | None
4 | 2.80 | Plated | None

NAME | SIGNATURE | DATE | | | | TITLE: Color Sensor Board

DRAW | Alshanik
CHK'D | Chirkun

APPV'D
MFG
QA | | | | MATERIAL: | DWG N0. | A3
