STEAM-Academy-PRO/revolution-robotics-kit/mechanical parts/WH - Wheels/OW - Omniwheel/Omniwheel/OWbeta.PDF

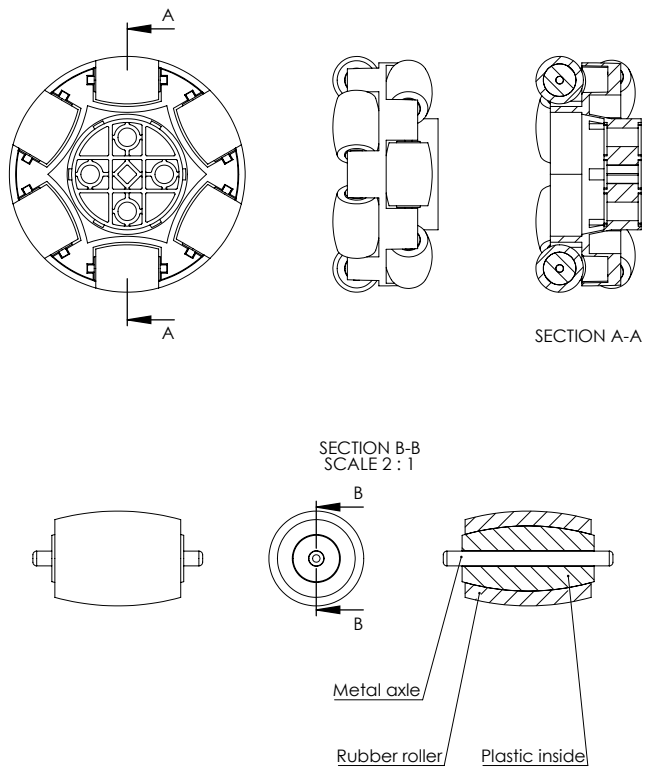
[picture p215: page 1]
SECTION A-A; SECTION B-B SCALE 2 : 1; Rubber roller; Plastic inside; Metal axle
