STEAM-Academy-PRO/revolution-robotics-kit/electronic parts/BR - Brain/Brain-v2-production/D sample [Start-of-Production]/PCB/RRRC_V2_LEDsBoard_assembly_drawing.PDF

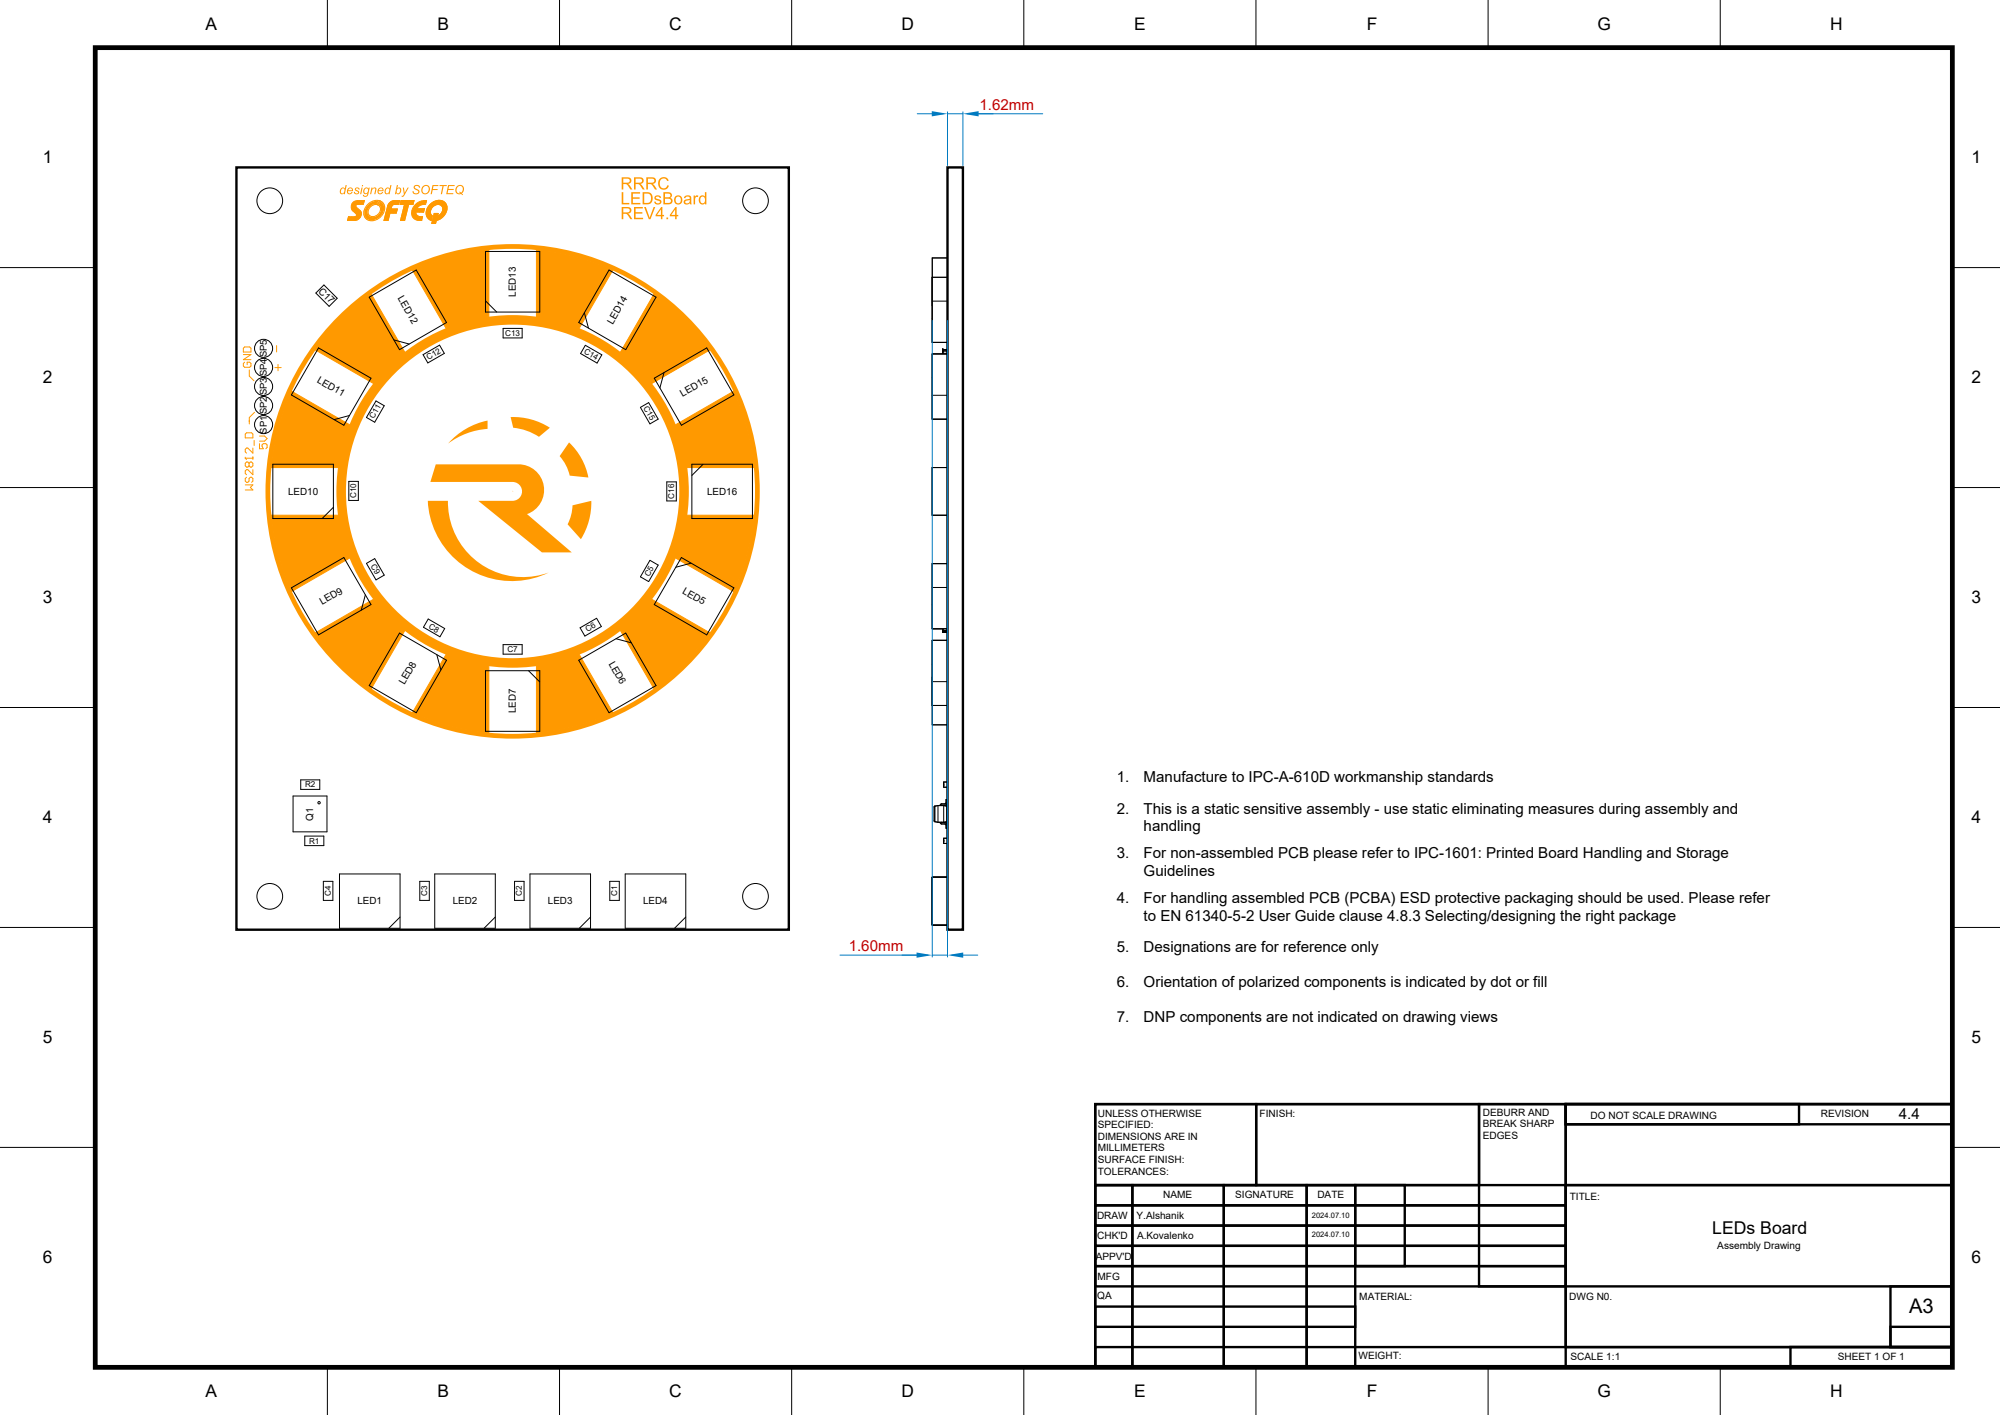
[picture p220: page 1]

1. Manufacture to IPC-A-610D workmanship standards
This is a static sensitive assembly - use static eliminating measures during assembly and
handling
For non-assembled PCB please refer to IPC-1601: Printed Board Handling and Storage
Guidelines
For handling assembled PCB (PCBA) ESD protective packaging should be used. Please refer
to EN 61340-5-2 User Guide clause 4.8.3 Selecting/designing the right package
5. Designations are for reference only

6. Orientation of polarized components is indicated by dot or fill

7. DNP components are not indicated on drawing views

NAME | SIGNATURE | DATE | | | | TITLE: LEDs Board Assembly Drawing

DRAW | Y.Alshanik | | 2024.07.10
CHK'D | A.Kovalenko

APPV'D
MFG
QA | | | | MATERIAL: | DWG N0. | A3
