STEAM-Academy-PRO/revolution-robotics-kit/electronic parts/BR - Brain/Brain-v2-production/D sample [Start-of-Production]/PCB/RRRC_V2_LEDsBoard_fabrication_drawing.PDF

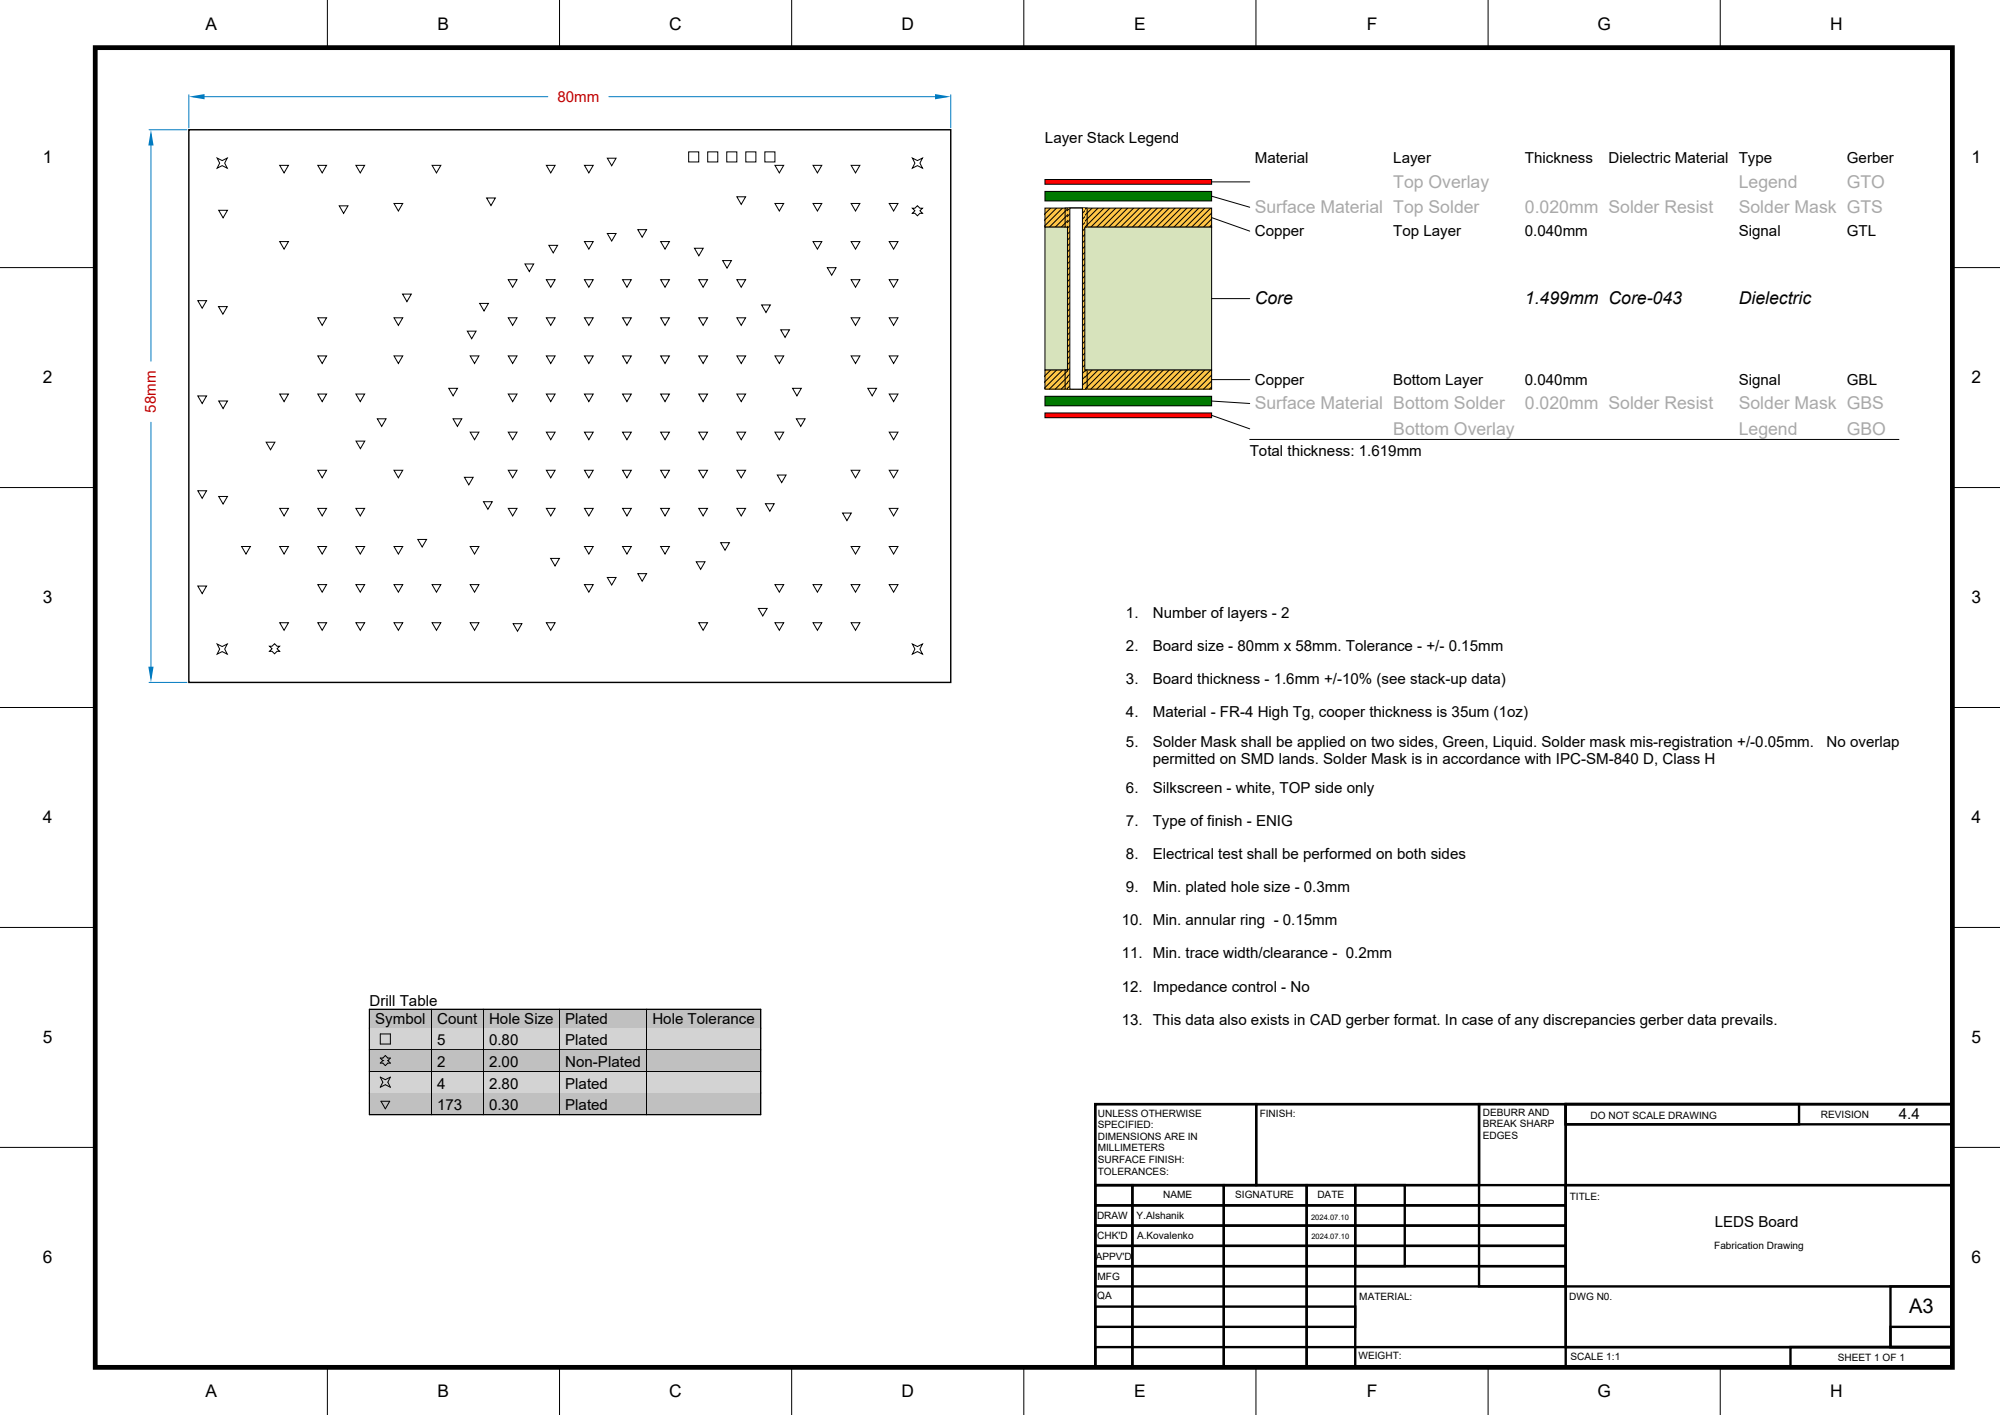
[picture p221: page 1]

3. Board thickness - 1.6mm +/-10% (see stack-up data)

4. Material - FR-4 High Tg, cooper thickness is 35um (1oz)
Solder Mask shall be applied on two sides, Green, Liquid. Solder mask mis-registration +/-0.05mm. No overlap
permitted on SMD lands. Solder Mask is in accordance with IPC-SM-840 D, Class H
6. Silkscreen - white, TOP side only

7. Type of finish - ENIG

8. Electrical test shall be performed on both sides

9. Min. plated hole size - 0.3mm

11. Min. trace width/clearance - 0.2mm

Symbol | Count | Hole Size | Plated | Hole Tolerance

13. This data also exists in CAD gerber format. In case of any discrepancies gerber data prevails.

5 | 0.80 | Plated
2 | 2.00 | Non-Plated
4 | 2.80 | Plated
173 | 0.30 | Plated

NAME | SIGNATURE | DATE | | | | TITLE: LEDS Board Fabrication Drawing

DRAW | Y.Alshanik | | 2024.07.10
CHK'D | A.Kovalenko | | 2024.07.10

APPV'D
MFG
QA | | | | MATERIAL: | DWG N0. | A3
