STEAM-Academy-PRO/revolution-robotics-kit/electronic parts/BR - Brain/Brain-v2-production/D sample [Start-of-Production]/Schematic/LEDs-board-v2-rev4.4.0-20240710.pdf

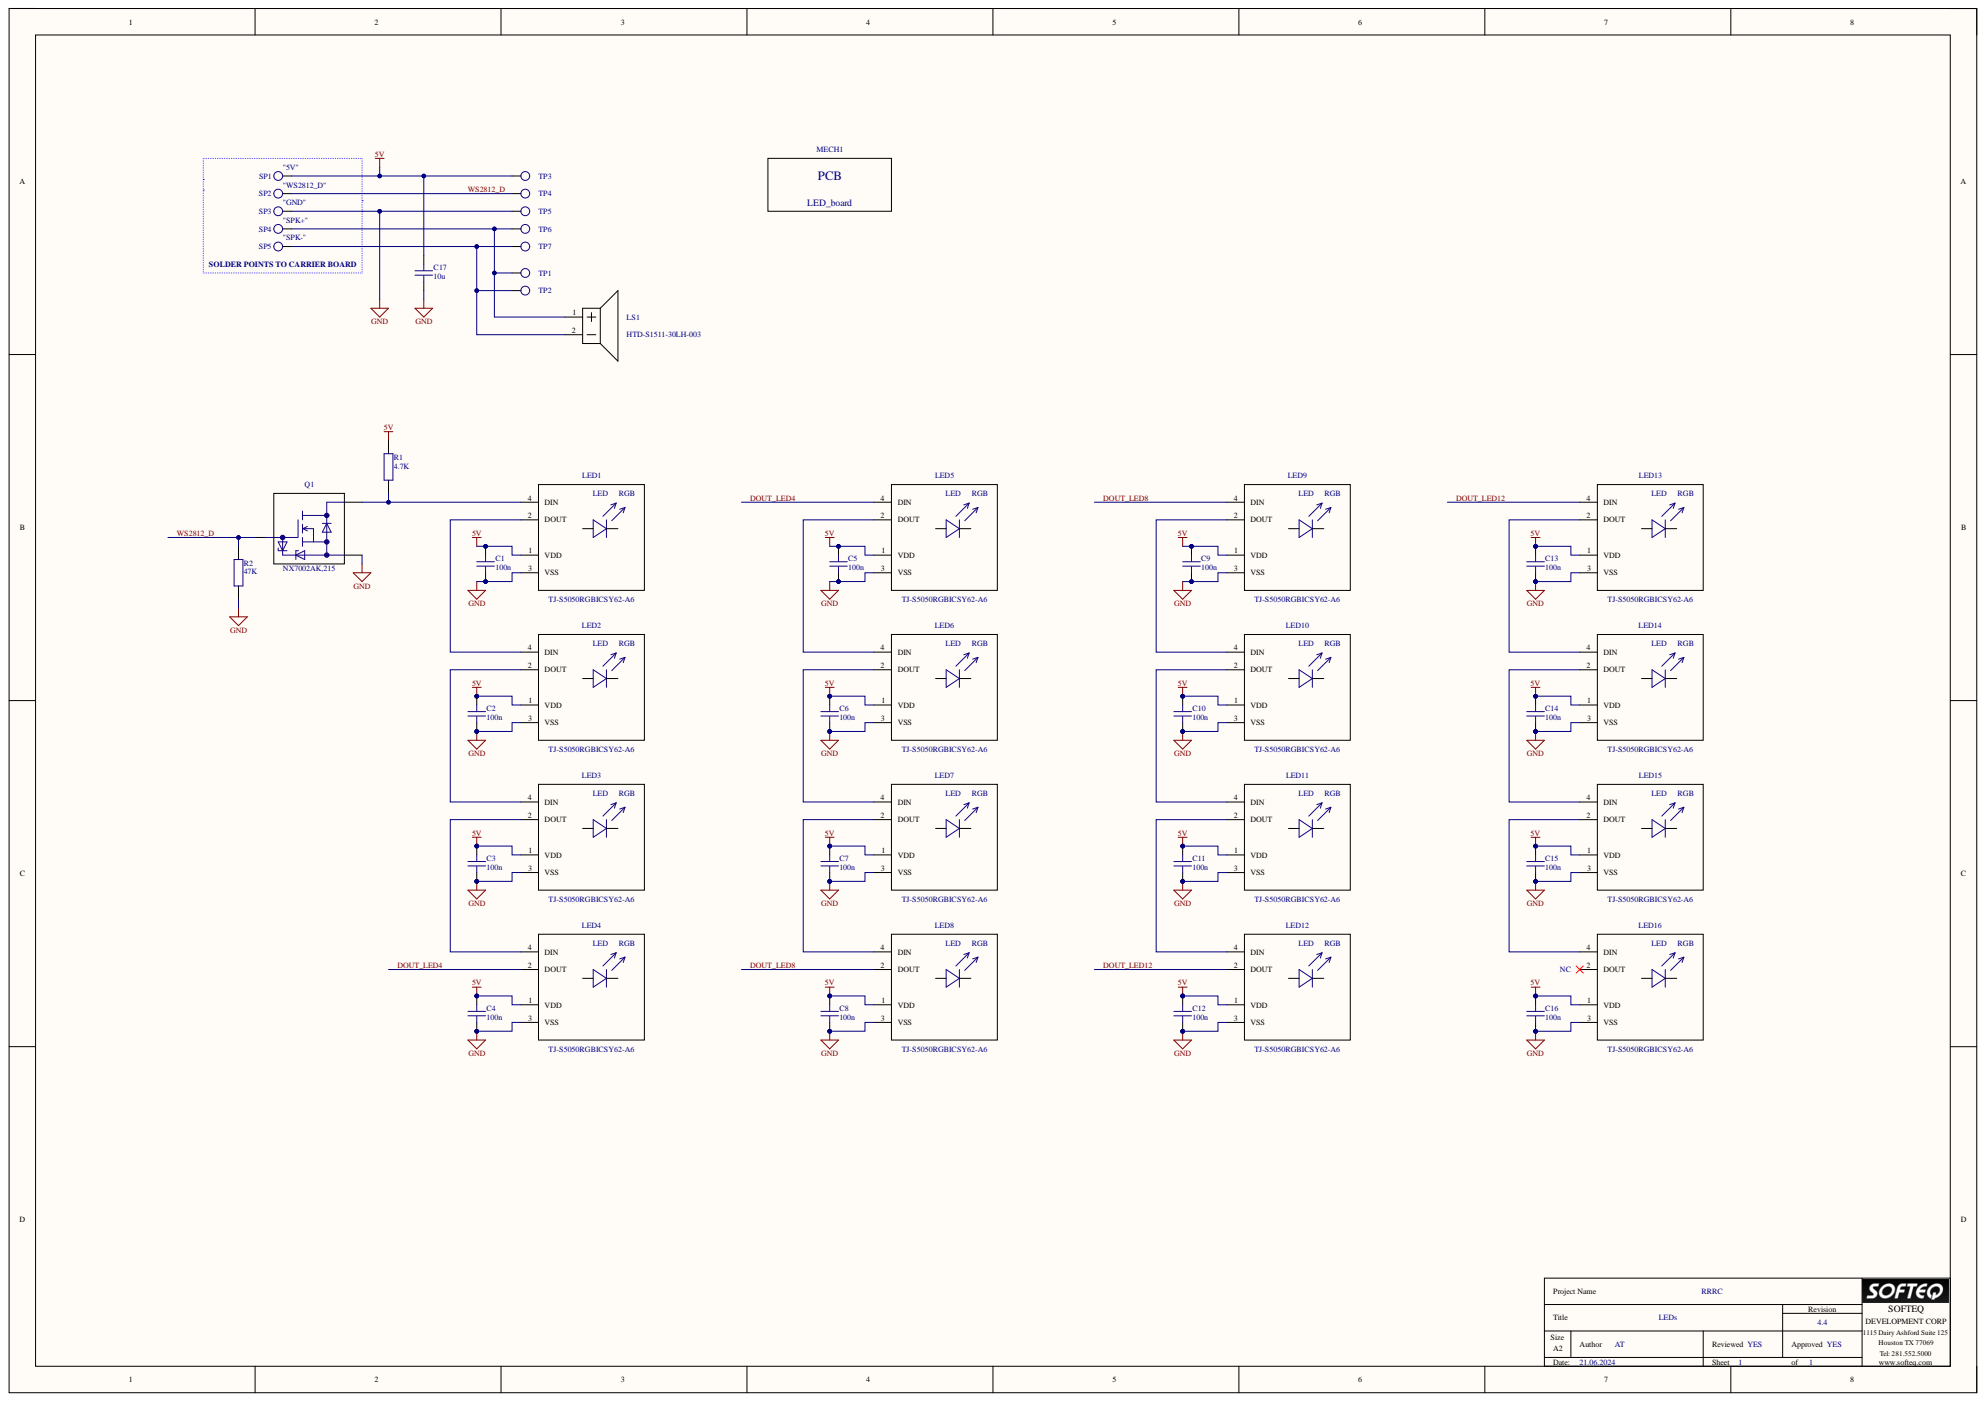
[picture p222: page 1]

SOLDER POINTS TO CARRIER BOARD

Project Name RRRC | SOFTEQ DEVELOPMENT CORP 1115 Dairy Ashford Suite 125 Houston TX 77069 Tel: 281.552.5000 www.softeq.com

Title LEDs | Revision

Size A2 | Author AT | Reviewed YES | Approved YES

Date: 21.06.2024 | | Sheet 1 of 1
