STEAM-Academy-PRO/revolution-robotics-kit/electronic parts/BR - Brain/Brain-v2-production/C sample [Pre-Production]/PCB/RRRC_V2_CarrierBoard_fabrication_drawing.PDF

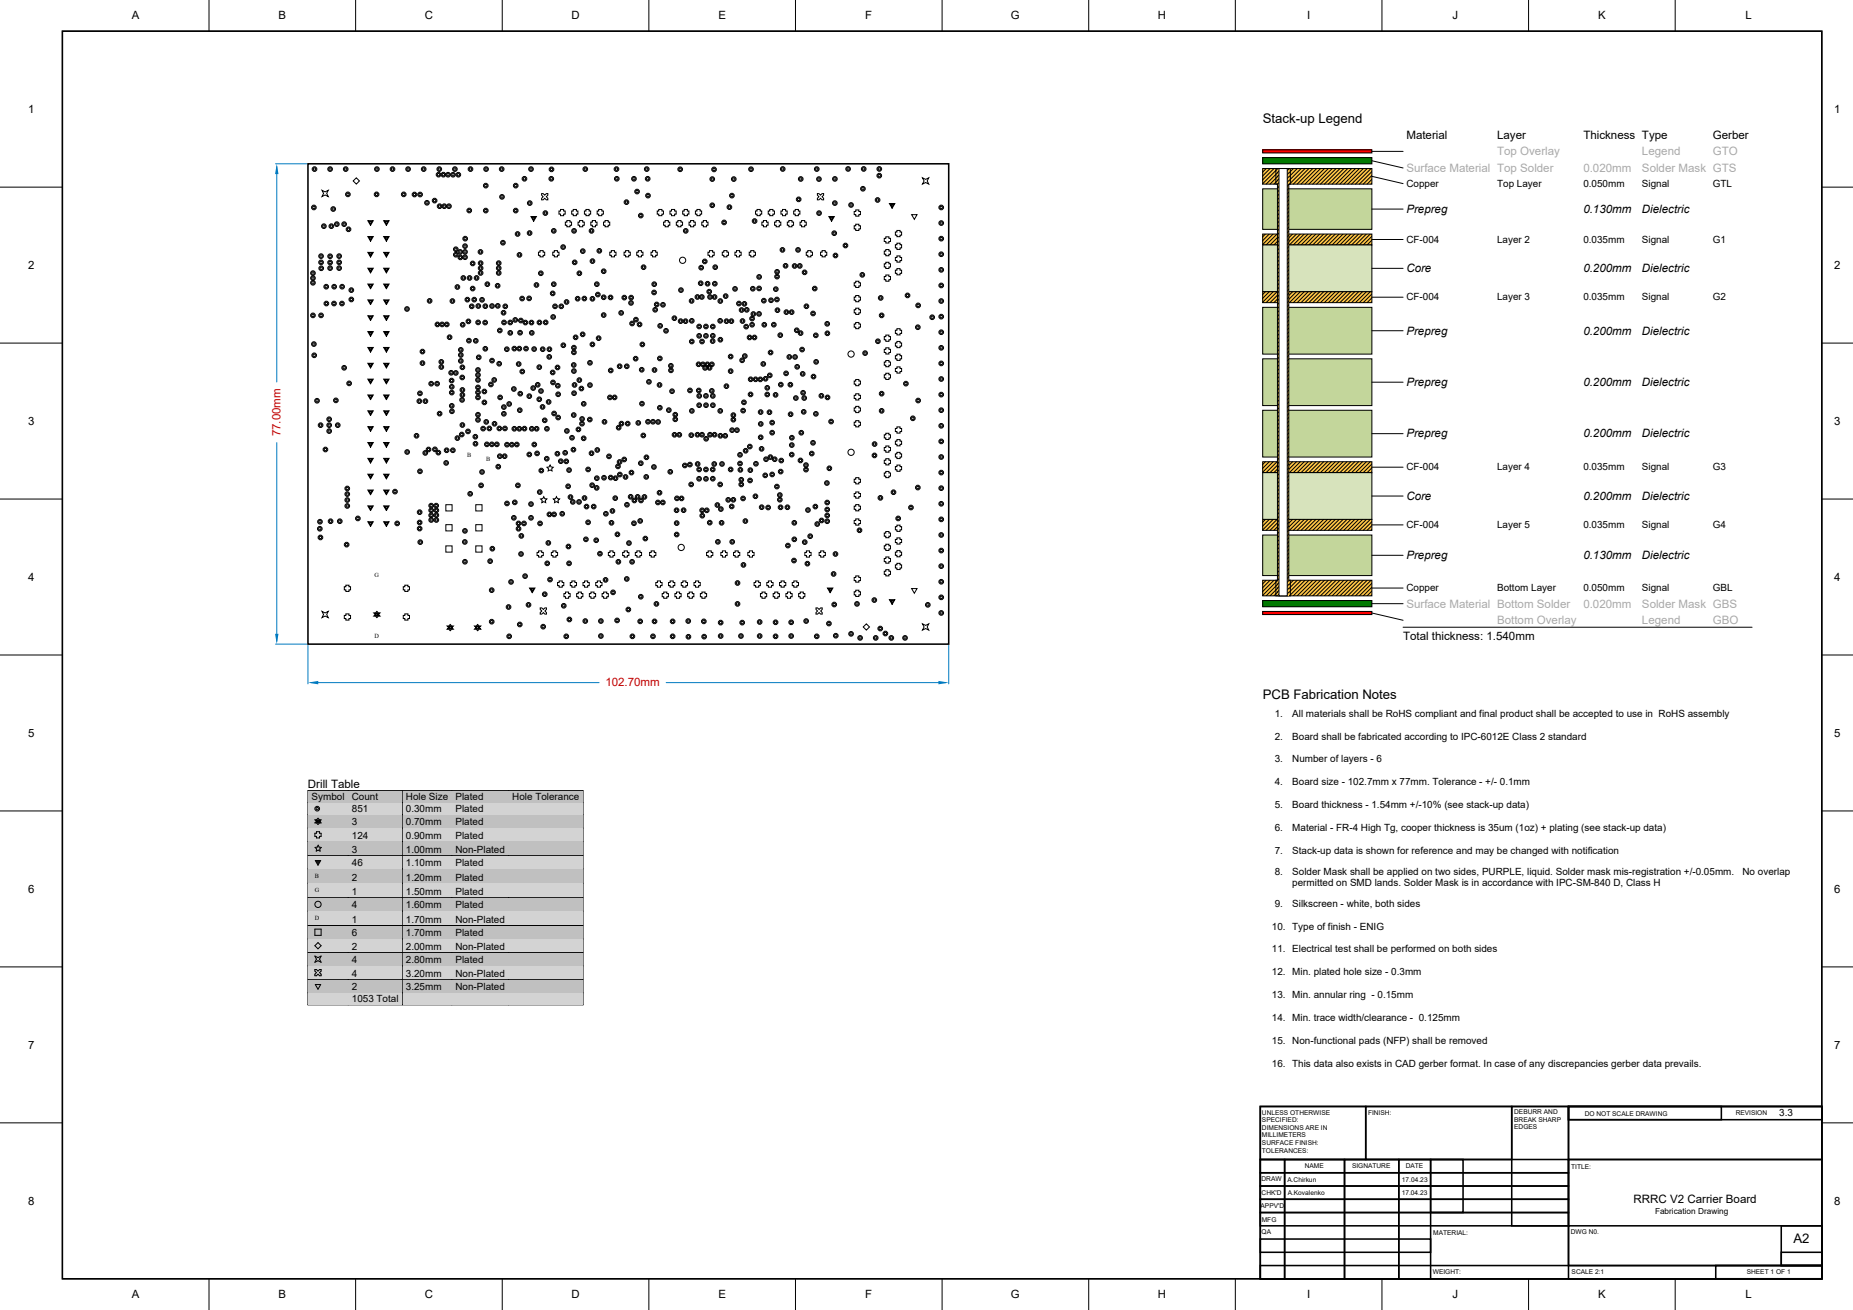
[picture p224: page 1]

Surface Material Bottom Solder 0.020mm Solder Mask GBS

1. All materials shall be RoHS compliant and final product shall be accepted to use in RoHS assembly

2. Board shall be fabricated according to IPC-6012E Class 2 standard

Symbol | Count | Hole Size | Plated | Hole Tolerance

851 | 0.30mm | Plated
3 | 0.70mm | Plated
124 | 0.90mm | Plated
3 | 1.00mm | Non-Plated
46 | 1.10mm | Plated

5. Board thickness - 1.54mm +/-10% (see stack-up data)

6. Material - FR-4 High Tg, cooper thickness is 35um (1oz) + plating (see stack-up data)

7. Stack-up data is shown for reference and may be changed with notification
Solder Mask shall be applied on two sides, PURPLE, liquid. Solder mask mis-registration +/-0.05mm. No overlap
permitted on SMD lands. Solder Mask is in accordance with IPC-SM-840 D, Class H
9. Silkscreen - white, both sides

B | 2 | 1.20mm | Plated

G | 1 | 1.50mm | Plated

4 | 1.60mm | Plated

D | 1 | 1.70mm | Non-Plated

6 | 1.70mm | Plated
2 | 2.00mm | Non-Plated
4 | 2.80mm | Plated
4 | 3.20mm | Non-Plated
2 | 3.25mm | Non-Plated
1053 Total

10. Type of finish - ENIG

11. Electrical test shall be performed on both sides

12. Min. plated hole size - 0.3mm

14. Min. trace width/clearance - 0.125mm

15. Non-functional pads (NFP) shall be removed

16. This data also exists in CAD gerber format. In case of any discrepancies gerber data prevails.

NAME | SIGNATURE | DATE | | | | TITLE: RRRC V2 Carrier Board Fabrication Drawing

DRAW | A.Chirkun | | 17.04.23
CHK'D | A.Kovalenko | | 17.04.23

APPV'D
MFG
QA | | | | MATERIAL: | DWG N0. | A2
