STEAM-Academy-PRO/revolution-robotics-kit/electronic parts/BR - Brain/Brain-v2-production/C sample [Pre-Production]/Schematic/Carrier_Board_v2_v1.1.6_20211217.pdf

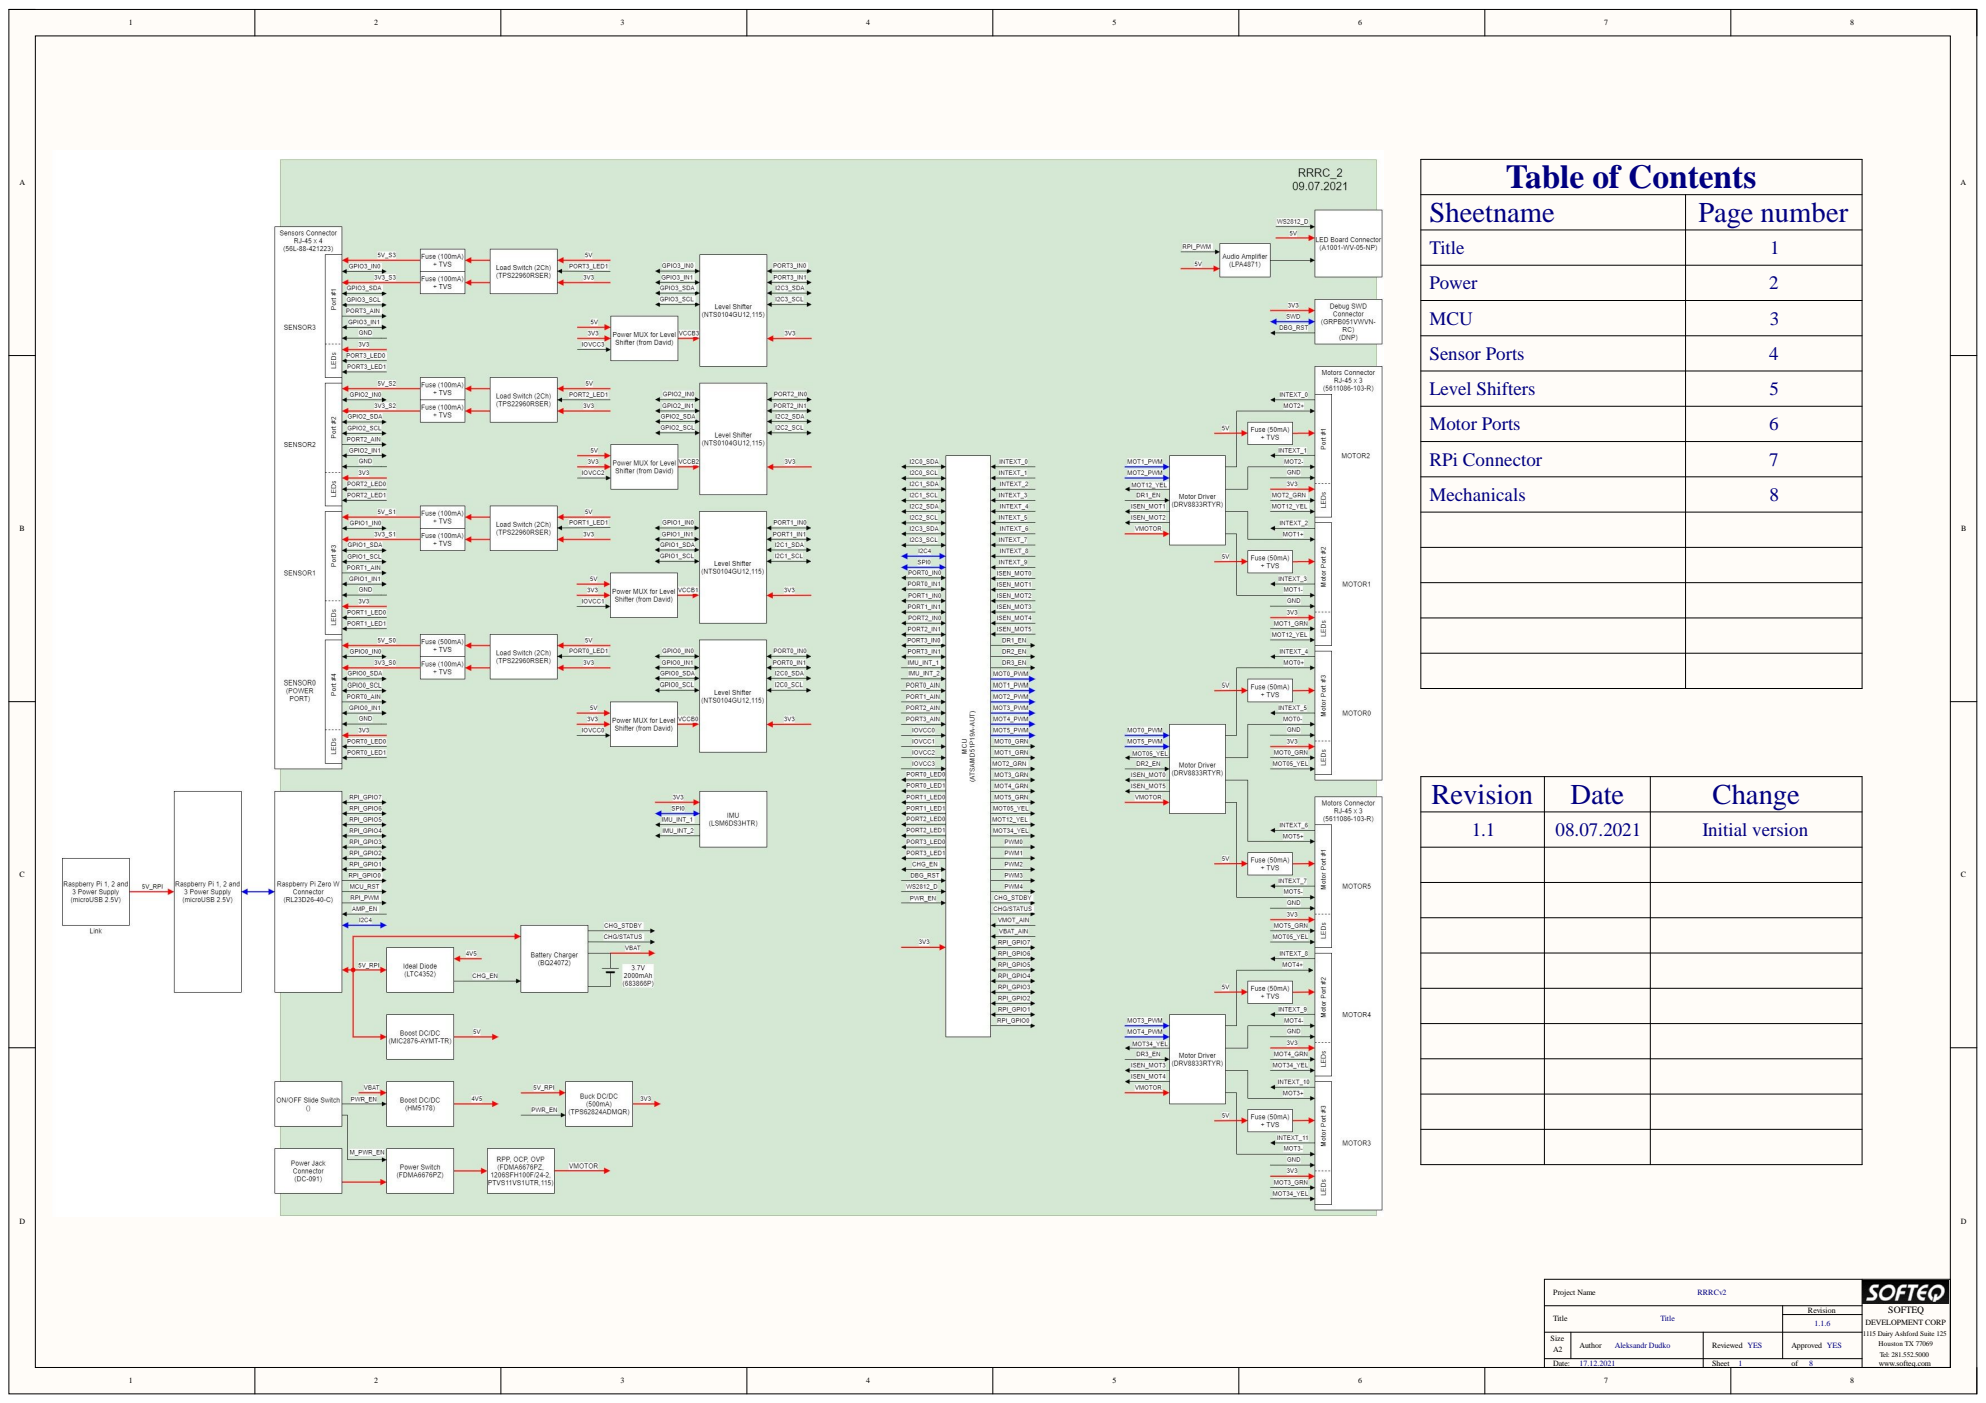
[picture p225: page 1]

Sheetname | Page number

Title | 1

Power | 2

MCU | 3

Sensor Ports | 4

Level Shifters | 5

Motor Ports | 6

RPi Connector | 7

Mechanicals | 8

Revision | Date | Change

1.1 | 08.07.2021 | Initial version

Project Name RRRCv2 | SOFTEQ DEVELOPMENT CORP 1115 Dairy Ashford Suite 125 Houston TX 77069 Tel: 281.552.5000 www.softeq.com

Title | Revision

Size A2 | Author Aleksandr Dudko | Reviewed YES | Approved YES

Date: 17.12.2021 | | Sheet of

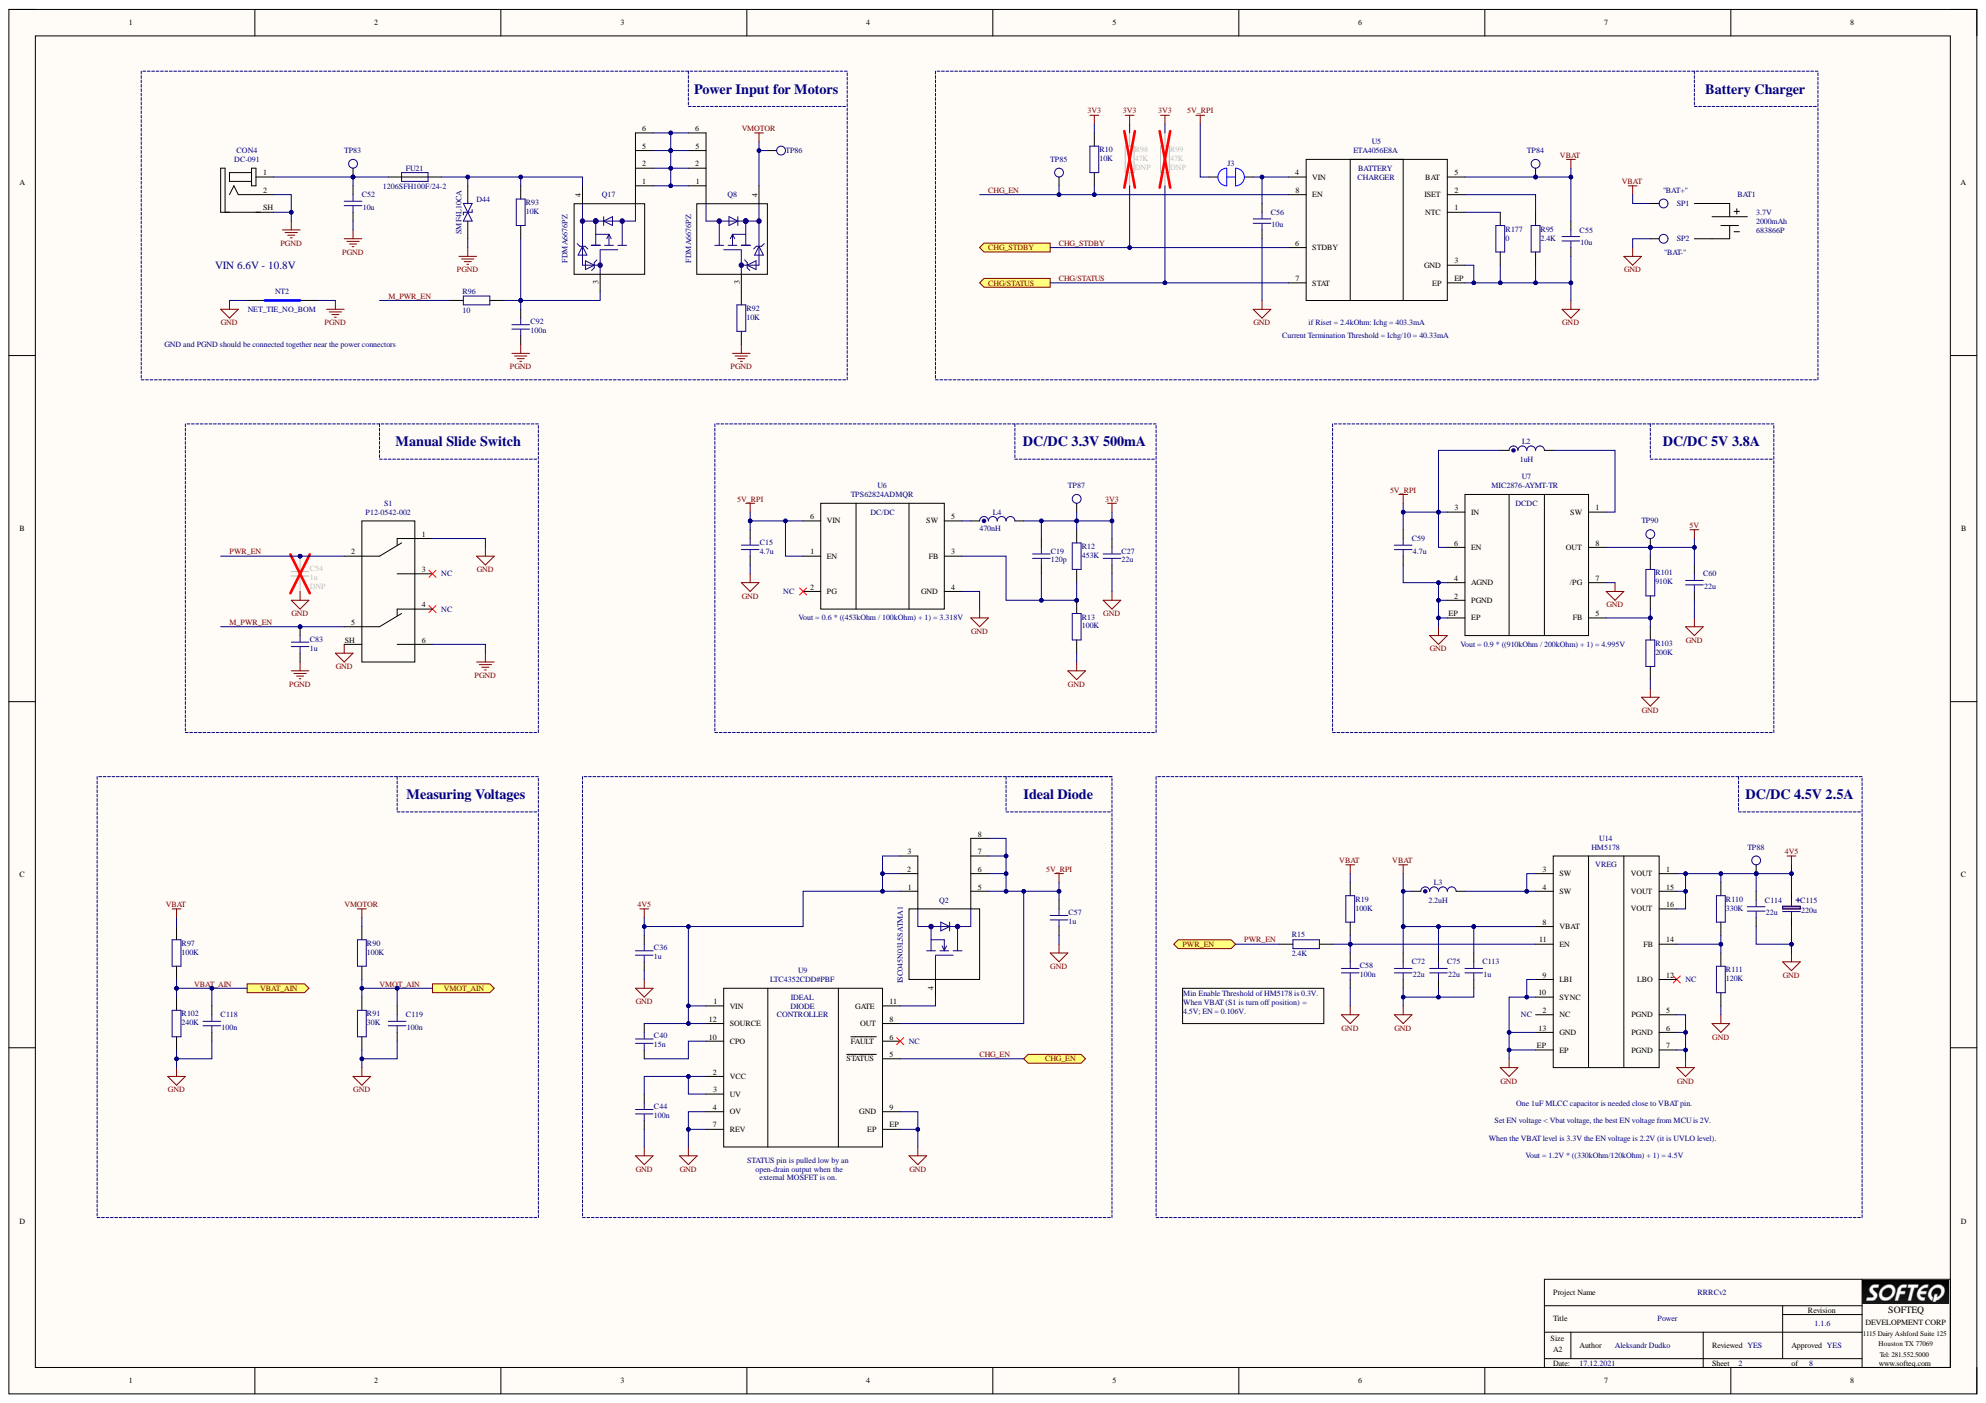
[picture p226: page 2]

Power Input for Motors

GND and PGND should be connected together near the power connectors

Current Termination Threshold = Ichg/10 = 40.33mA

VIN 6 | SW | 5 DC/DC

IN 3 | SW | 1 DCDC

Min Enable Threshold of HM5178 is 0.3V.
When VBAT (S1 is turn off position) =

15n | VCC 2

CPO 10 | CHG_EN

One 1uF MLCC capacitor is needed close to VBAT pin.

REV 7

Set EN voltage < Vbat voltage, the best EN voltage from MCU is 2V.

When the VBAT level is 3.3V the EN voltage is 2.2V (it is UVLO level).

STATUS pin is pulled low by an
open-drain output when the
external MOSFET is on.

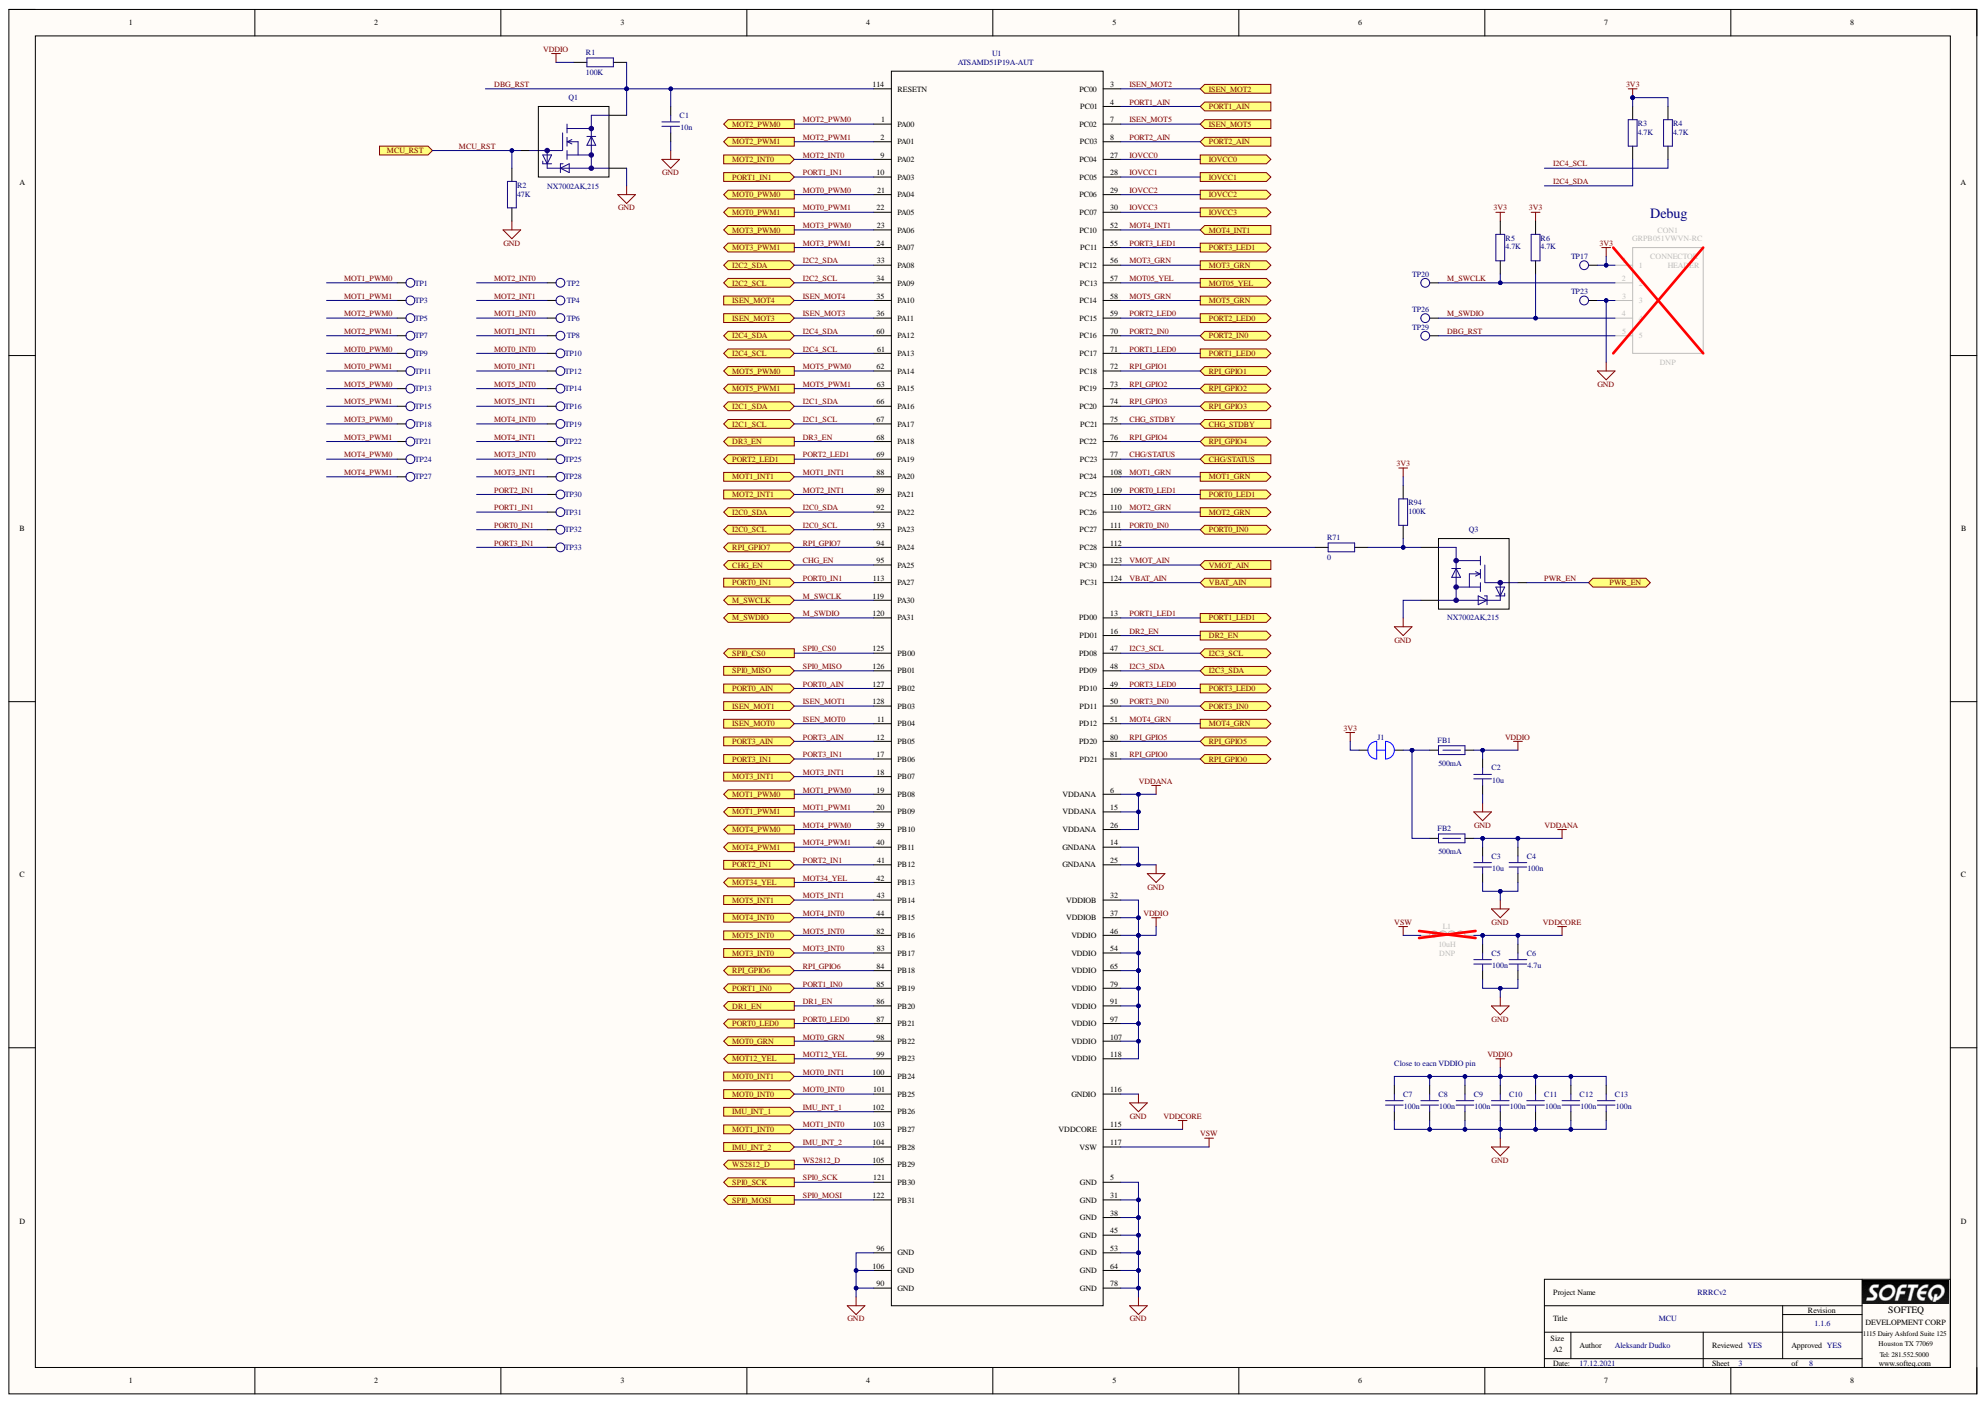
[picture p227: page 3]

Close to eacn VDDIO pin

GND 106

GND 90

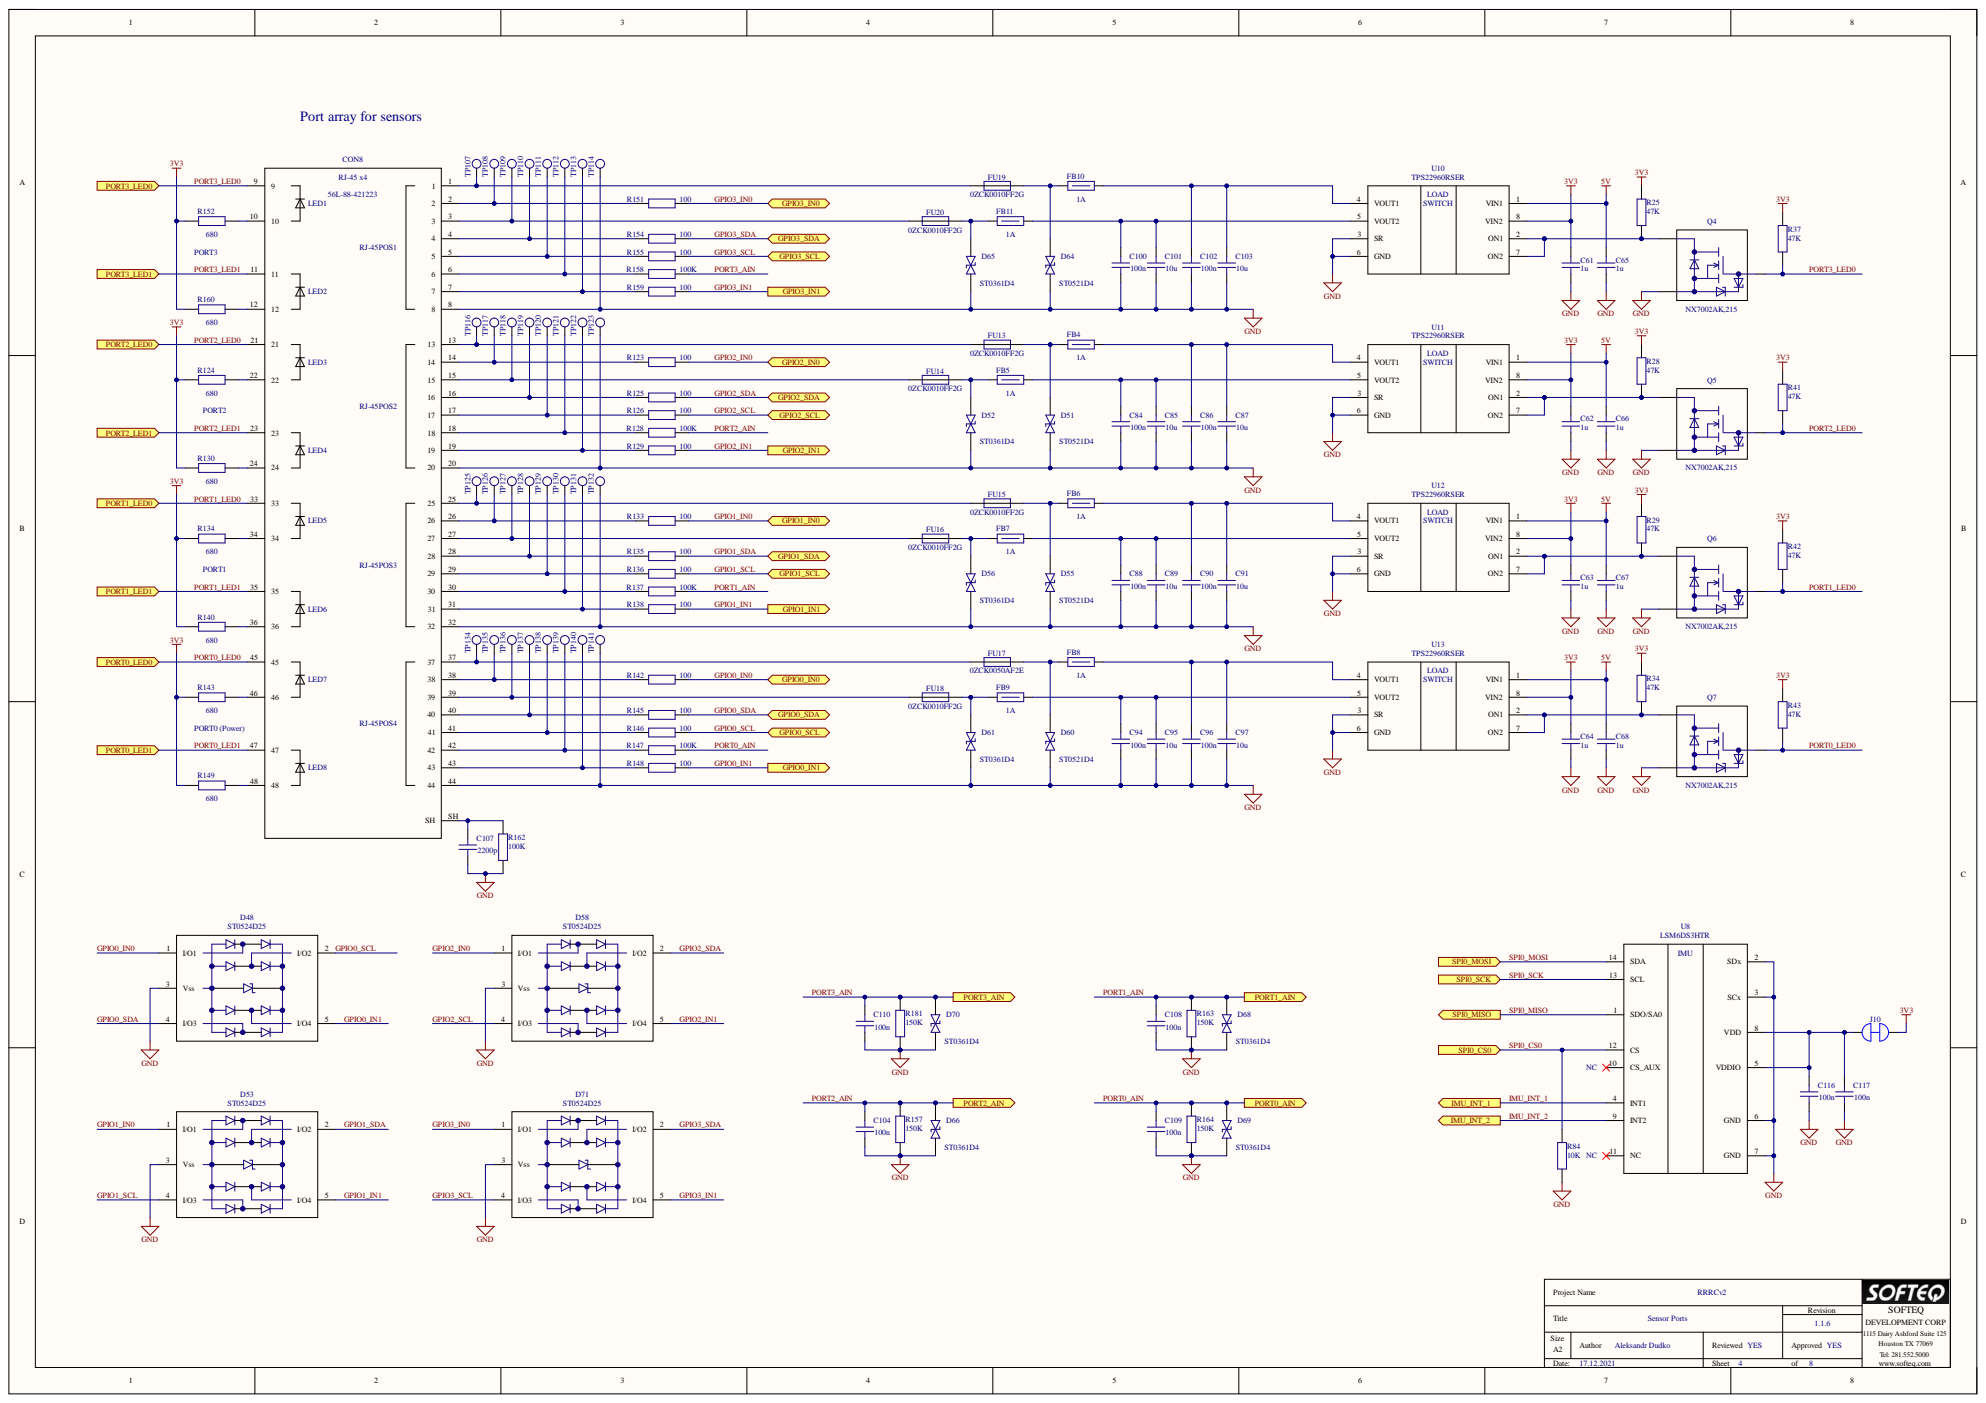
[picture p228: page 4]

SDA 14 L 13 SC S 12 SDO/S A0 C UX 10 C S_A INT 1 INT 2 NC | SDx S C x VDD VDDI O GND GND

P roje ct Na me C v2 | SO F T E Q DEVELOPMENT COR 5 Dai ry As h fo r d Su ite Ho u sto n TX Tel . w.softeq.com

Title Size S ensor Ports | vision

A | Author | R e vie w d | Approv

Date : | | She t of

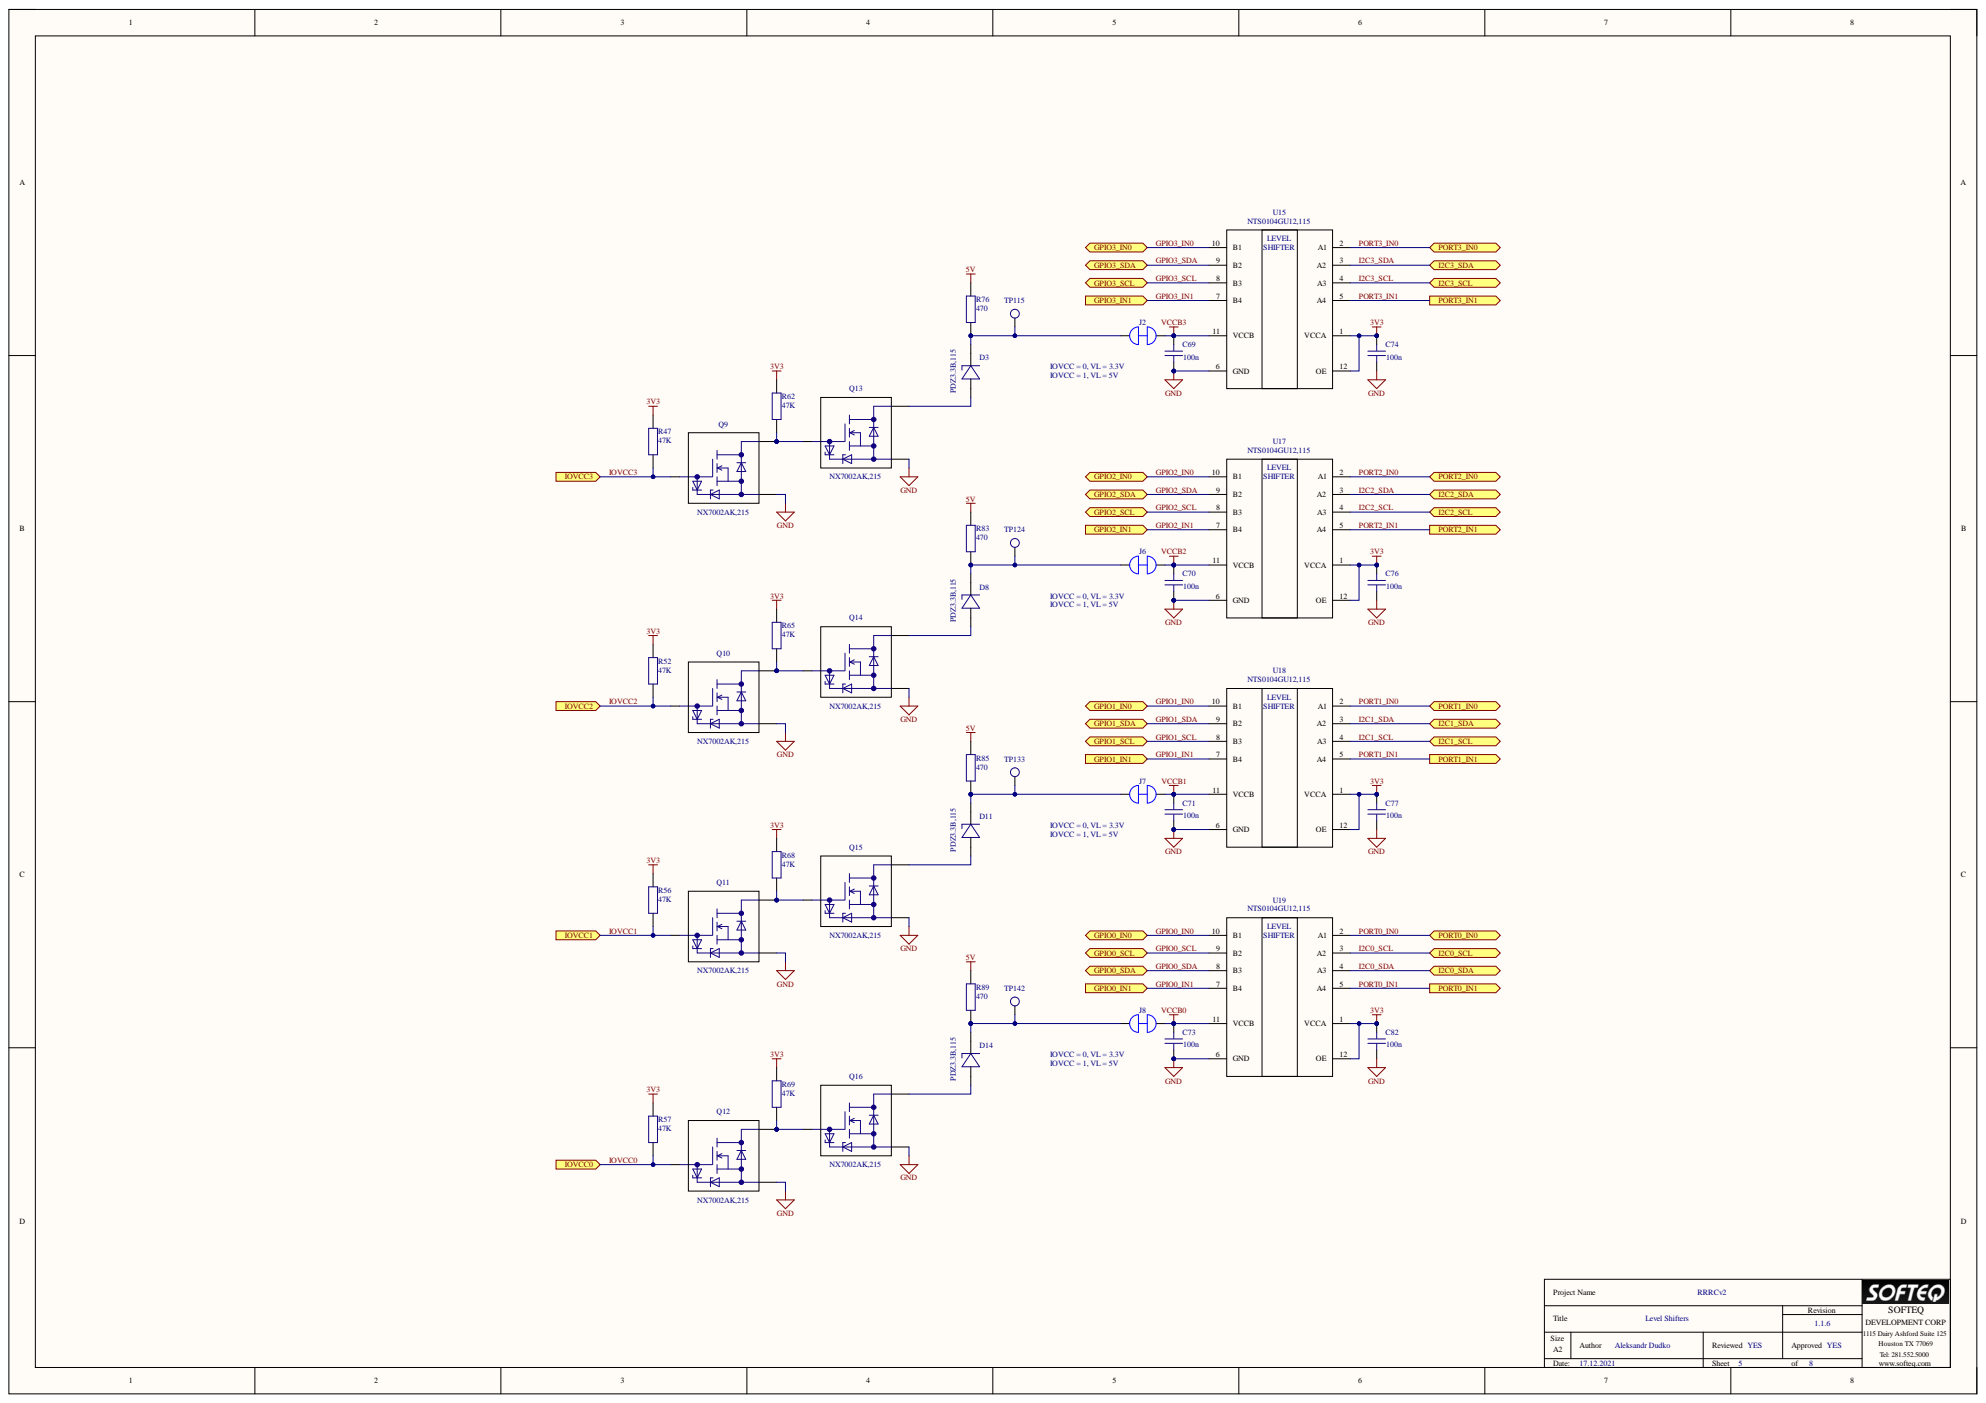
[picture p229: page 5]

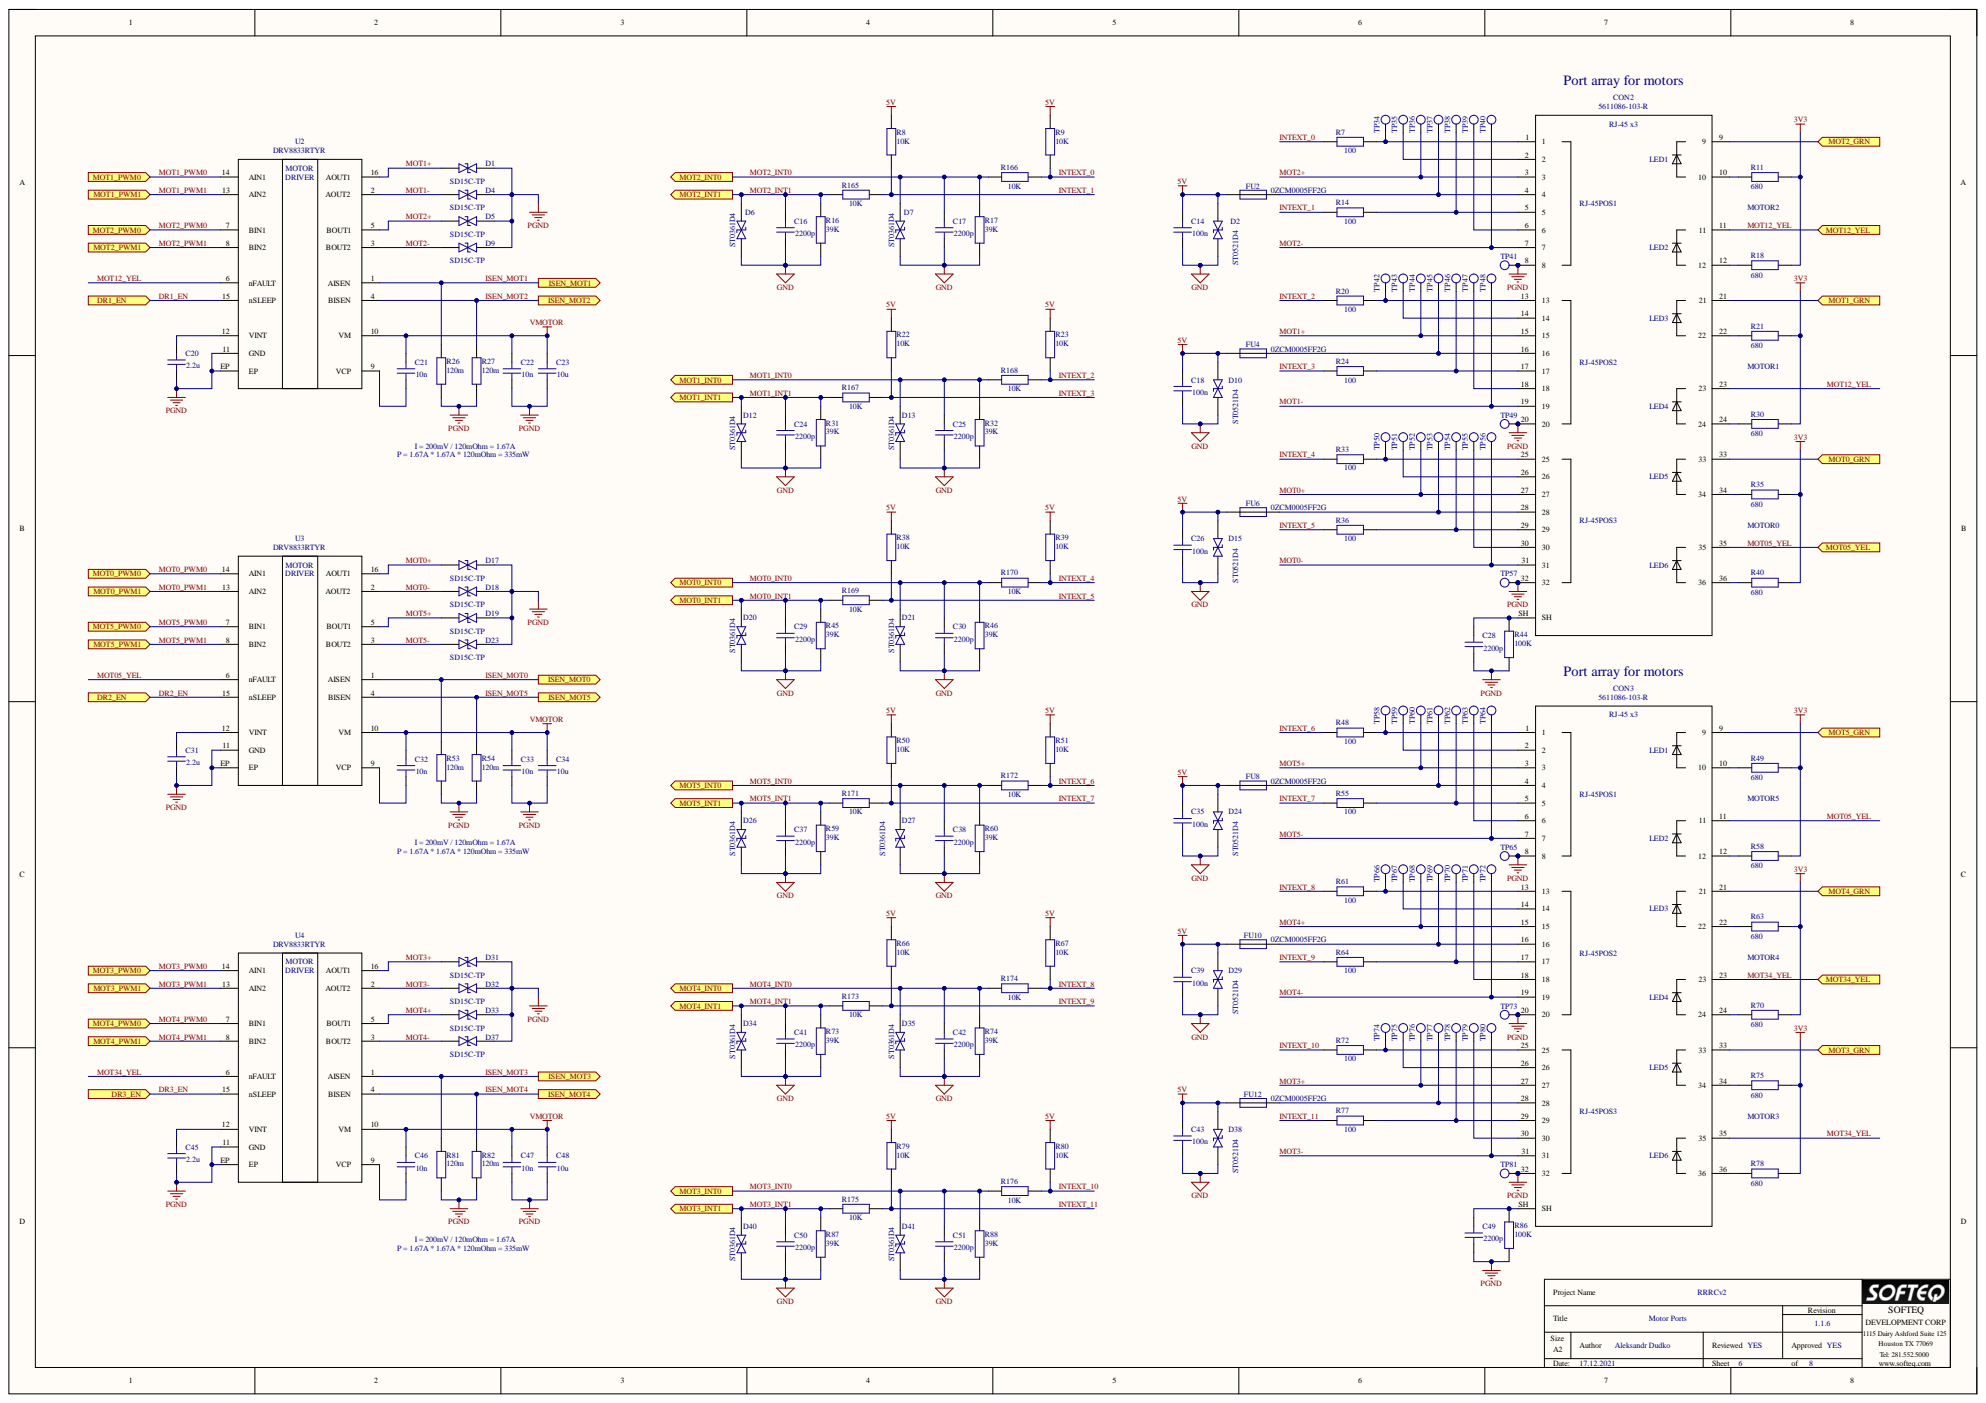
[picture p230: page 6]

GND GND GND

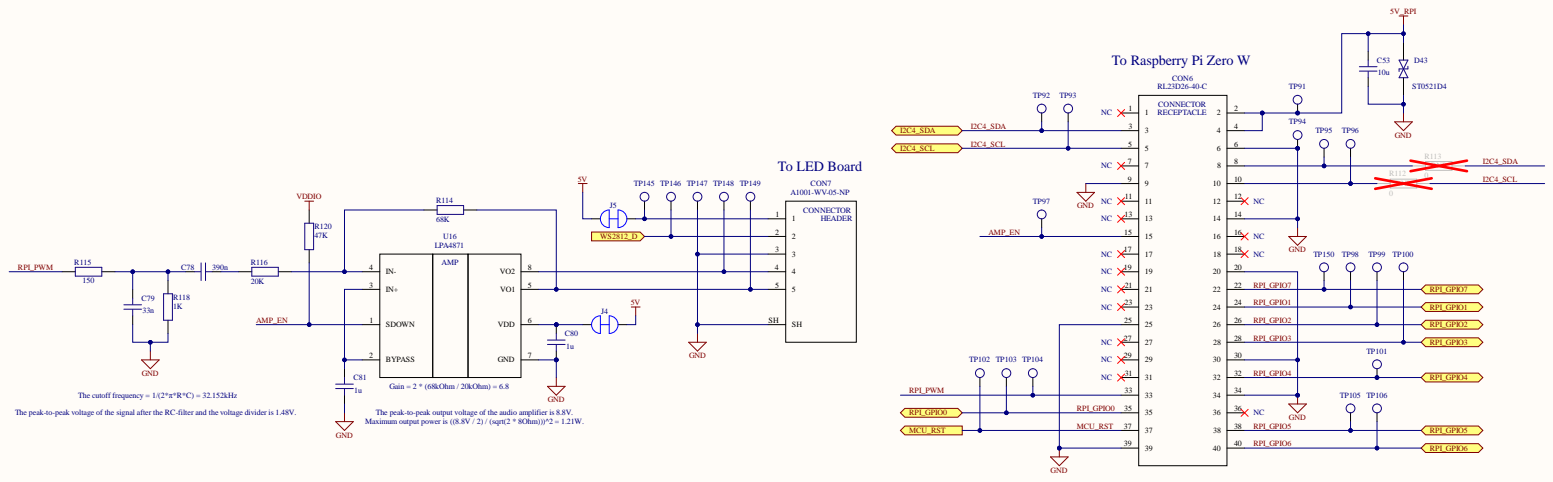
[picture p231: page 7]

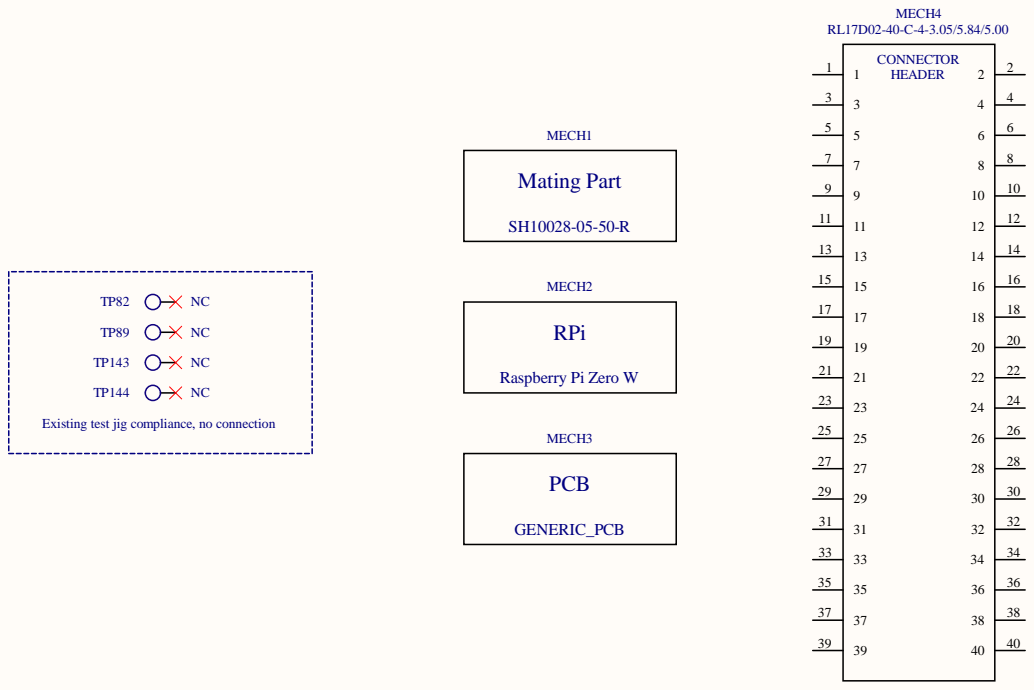
[picture p232: page 8]

Existing test jig compliance, no connection
