STEAM-Academy-PRO/revolution-robotics-kit/electronic parts/BR - Brain/Brain-v2-production/C sample [Pre-Production]/Schematic/Carrier_Board_v2_v2.2.1_20220627.pdf

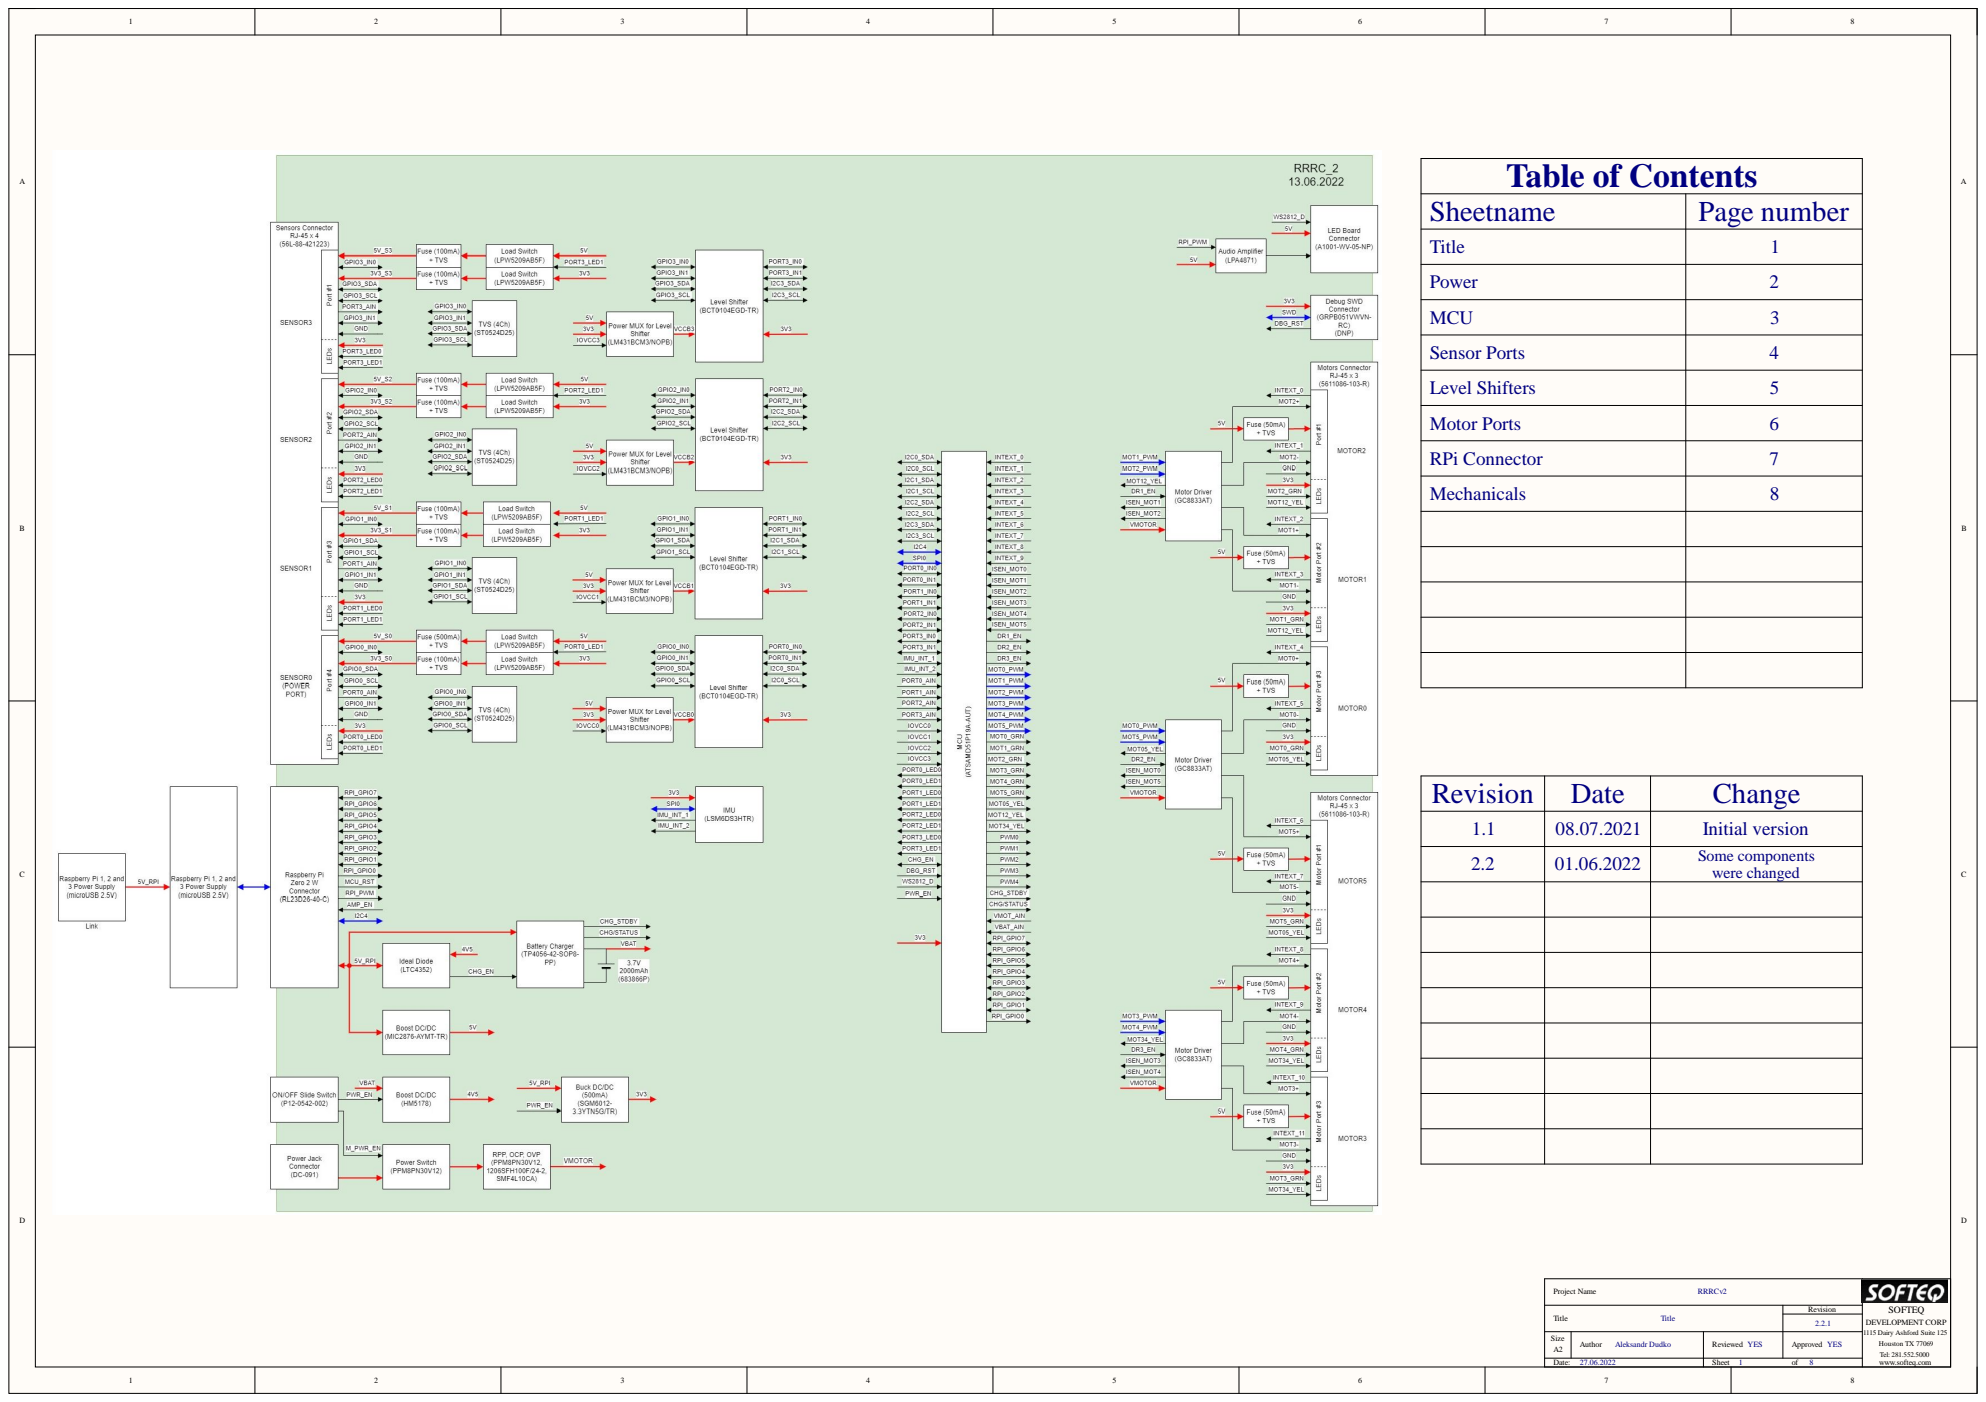
[picture p233: page 1]

Sheetname | Page number

Title | 1

Power | 2

MCU | 3

Sensor Ports | 4

Level Shifters | 5

Motor Ports | 6

RPi Connector | 7

Mechanicals | 8

Revision | Date | Change

1.1 | 08.07.2021 | Initial version

2.2 | 01.06.2022 | Some components were changed

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

Title | Revision

Size A2 | Author Aleksandr Dudko | Reviewed YES | Approved YES

Date: 27.06.2022 | | Sheet of

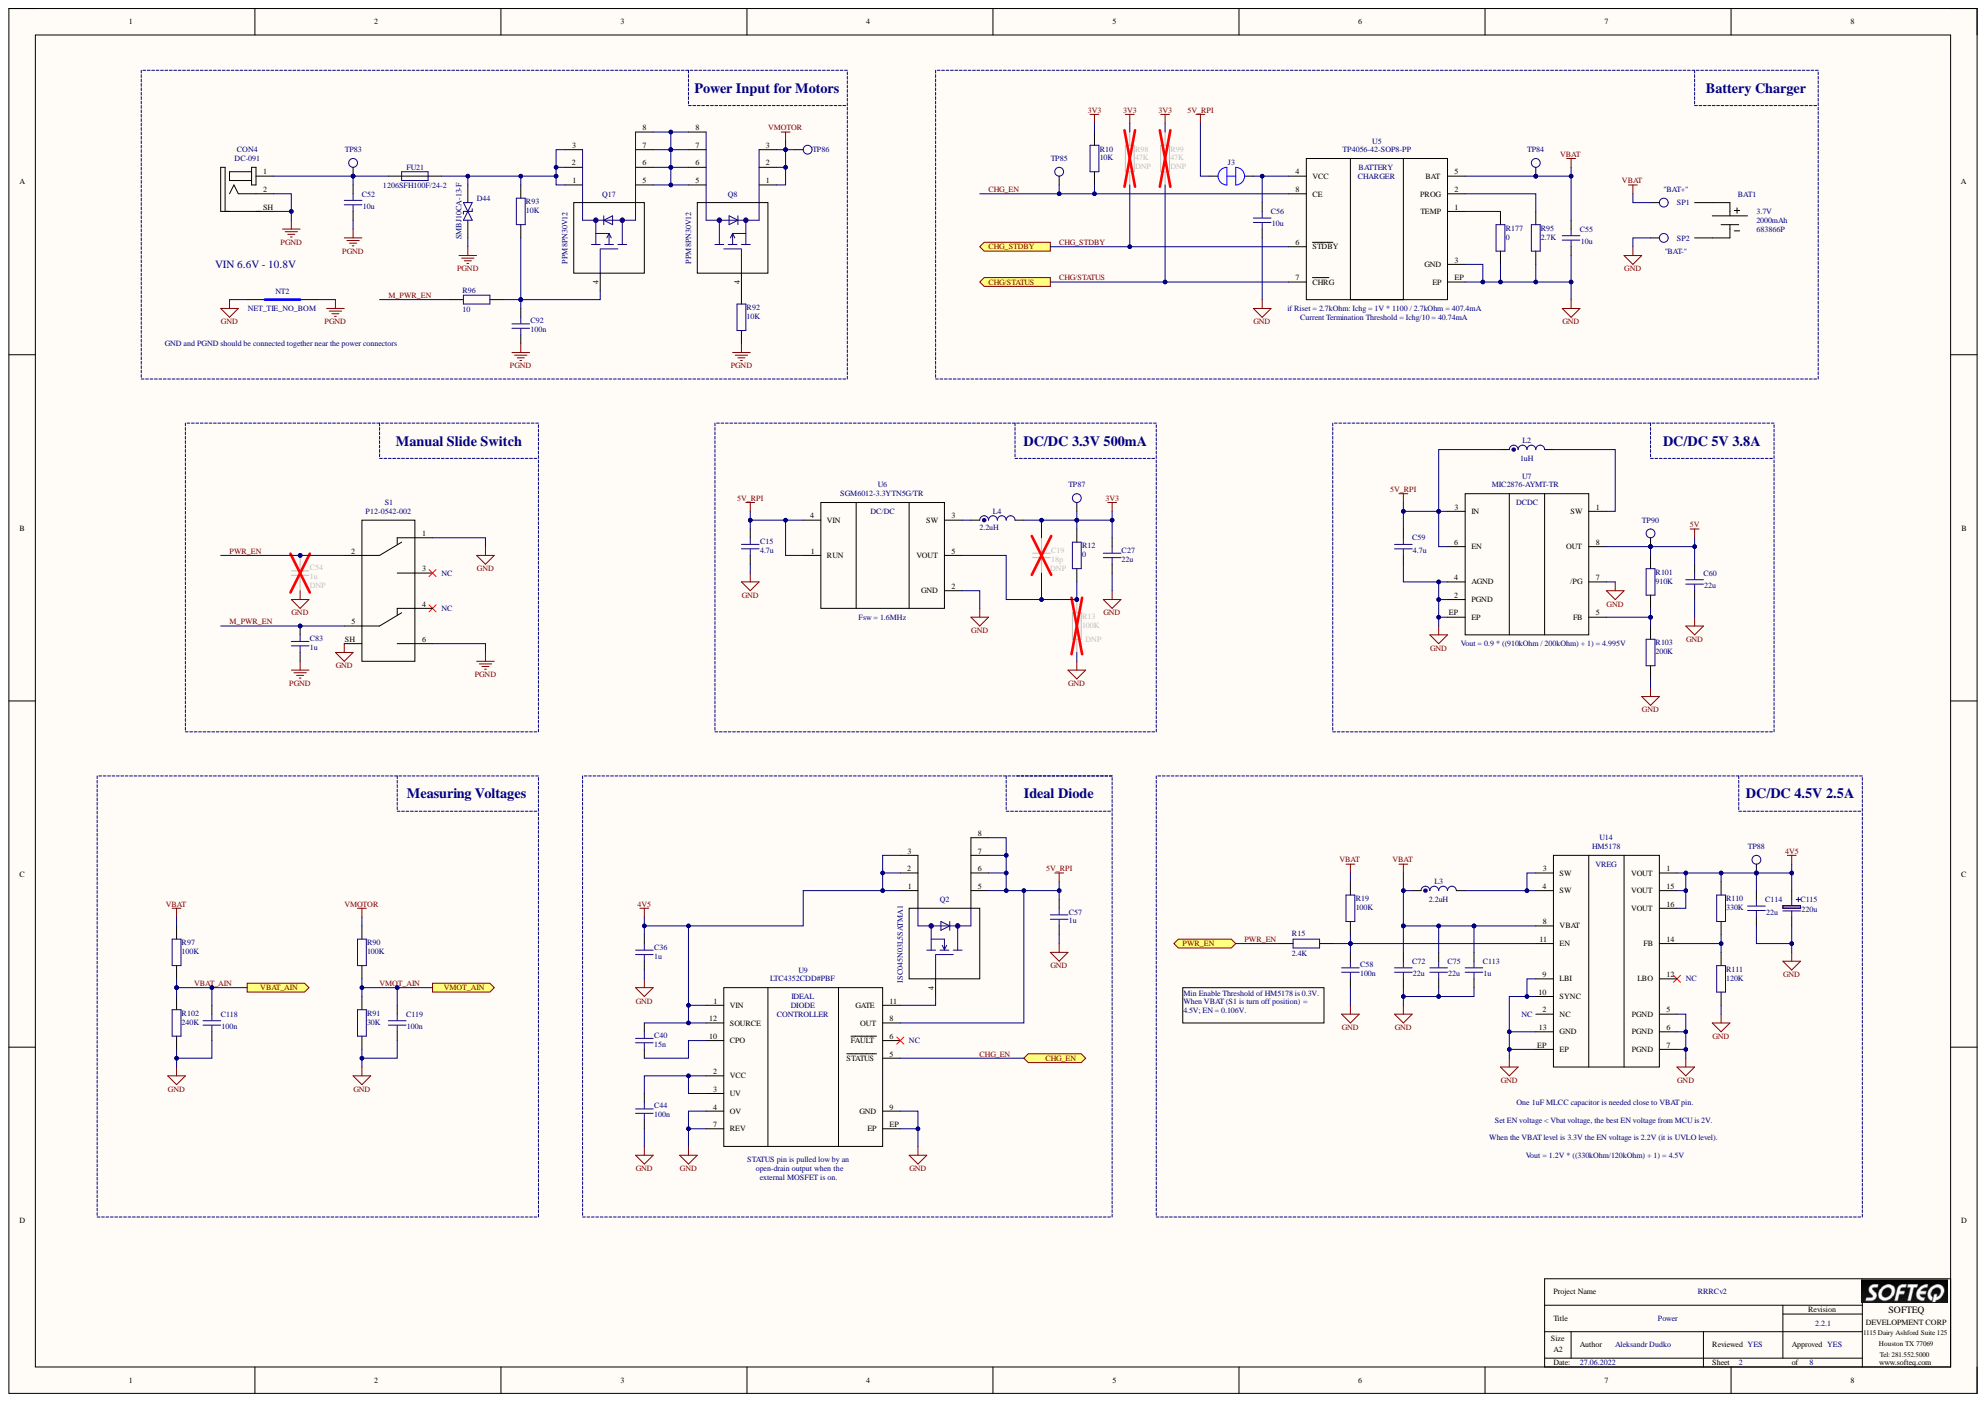
[picture p234: page 2]

Power Input for Motors

if Riset = 2.7kOhm: Ichg = 1V * 1100 / 2.7kOhm = 407.4mA
Current Termination Threshold = Ichg/10 = 40.74mA

GND and PGND should be connected together near the power connectors

VIN 4 | SW | 3 DC/DC

IN 3 | SW | 1 DCDC

Min Enable Threshold of HM5178 is 0.3V.
When VBAT (S1 is turn off position) =

15n | VCC 2

CPO 10 | CHG_EN

One 1uF MLCC capacitor is needed close to VBAT pin.

Set EN voltage < Vbat voltage, the best EN voltage from MCU is 2V.

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

STATUS pin is pulled low by an
open-drain output when the
external MOSFET is on.

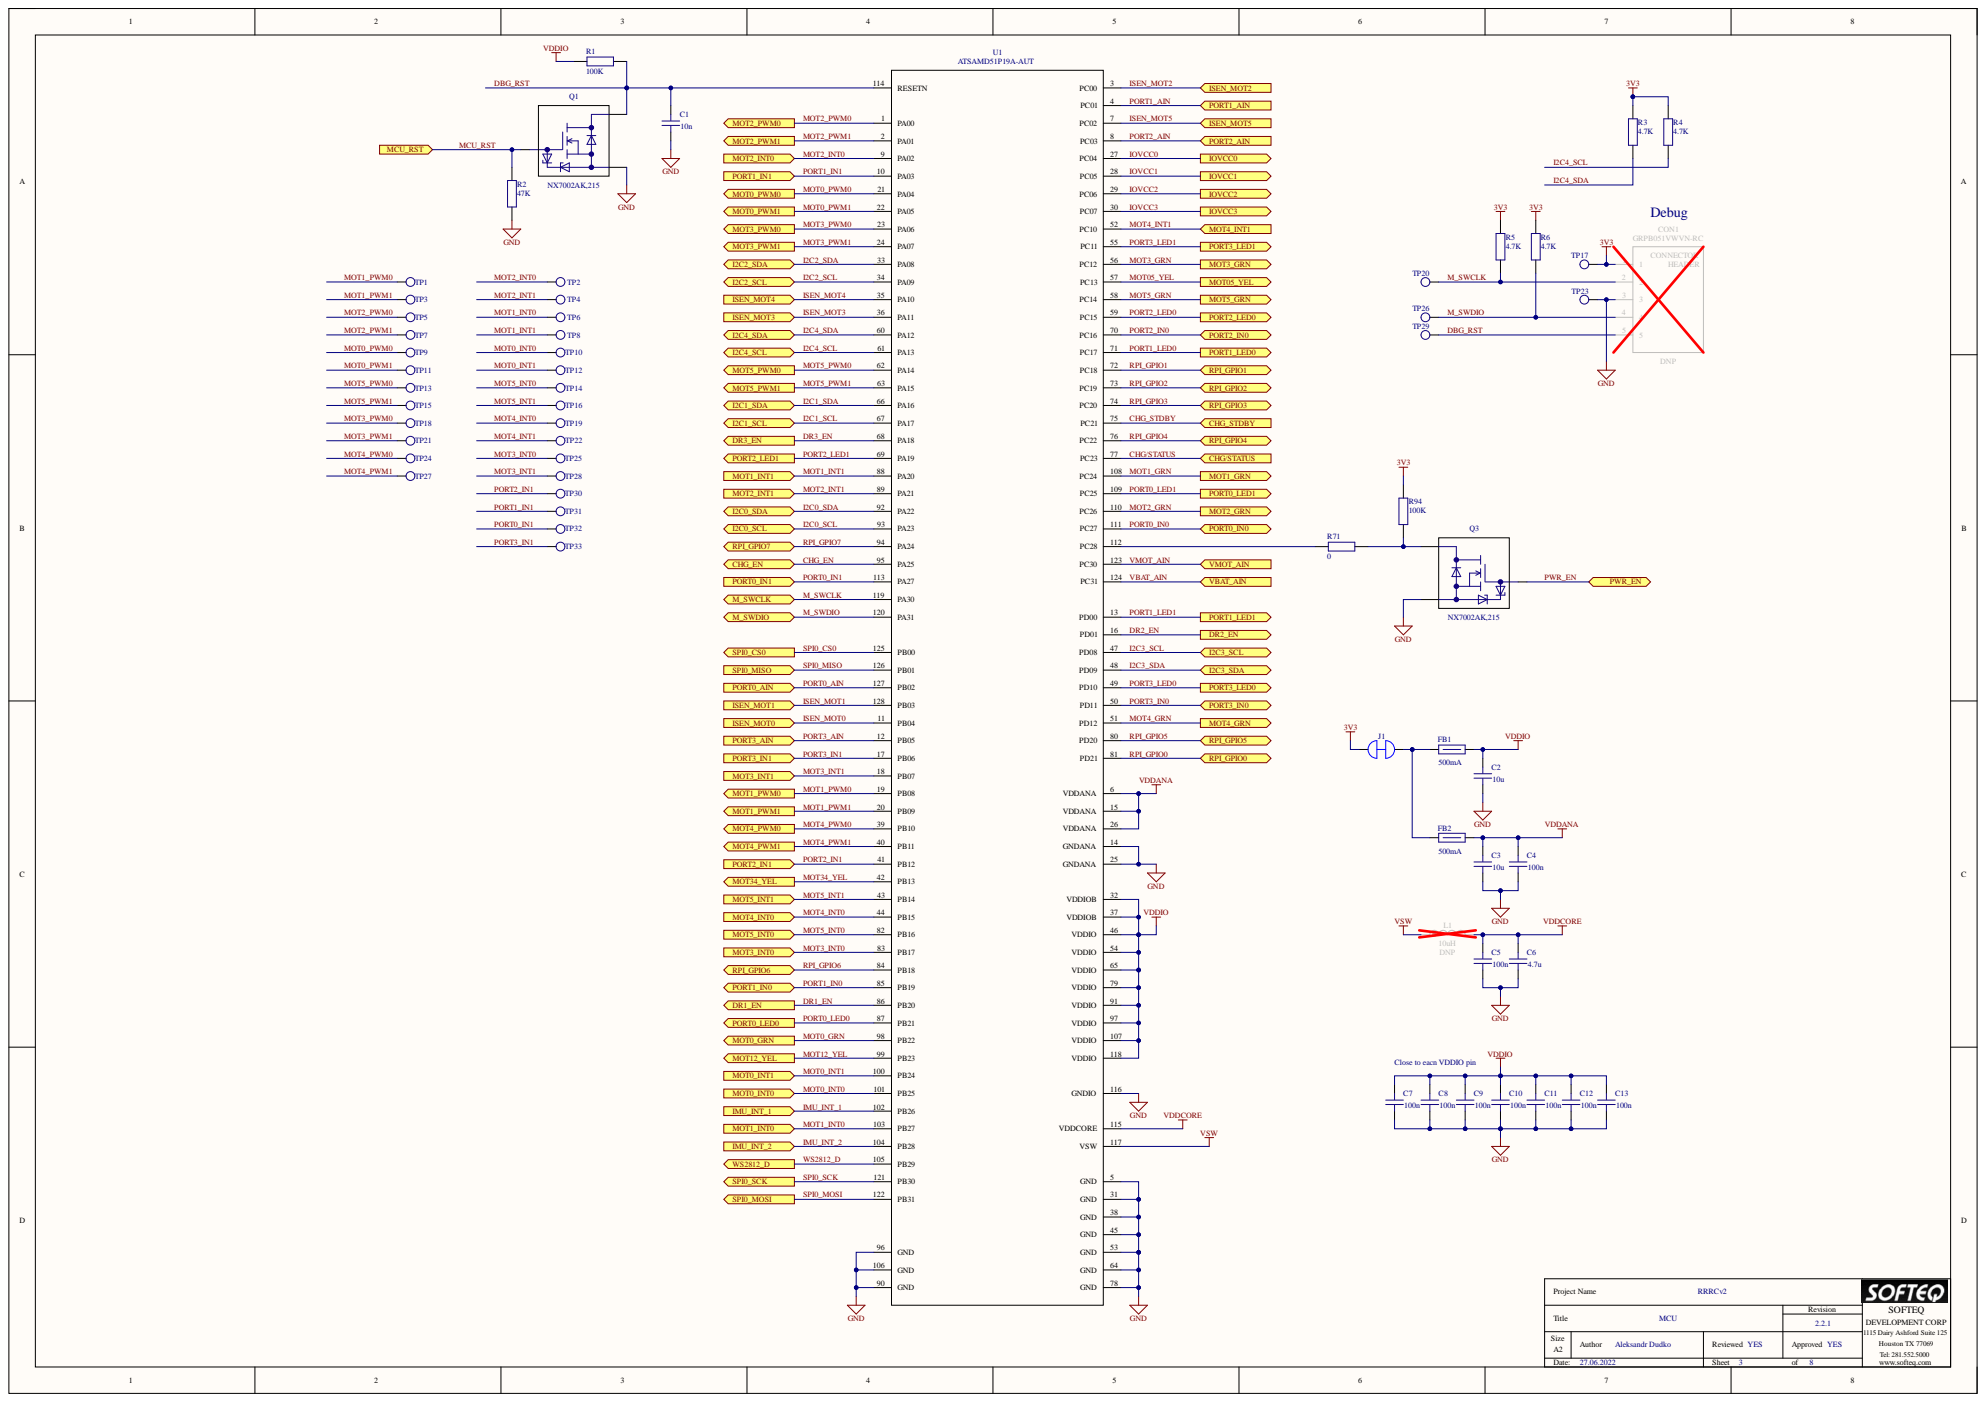
[picture p235: page 3]

Close to eacn VDDIO pin

GND 90

MCU

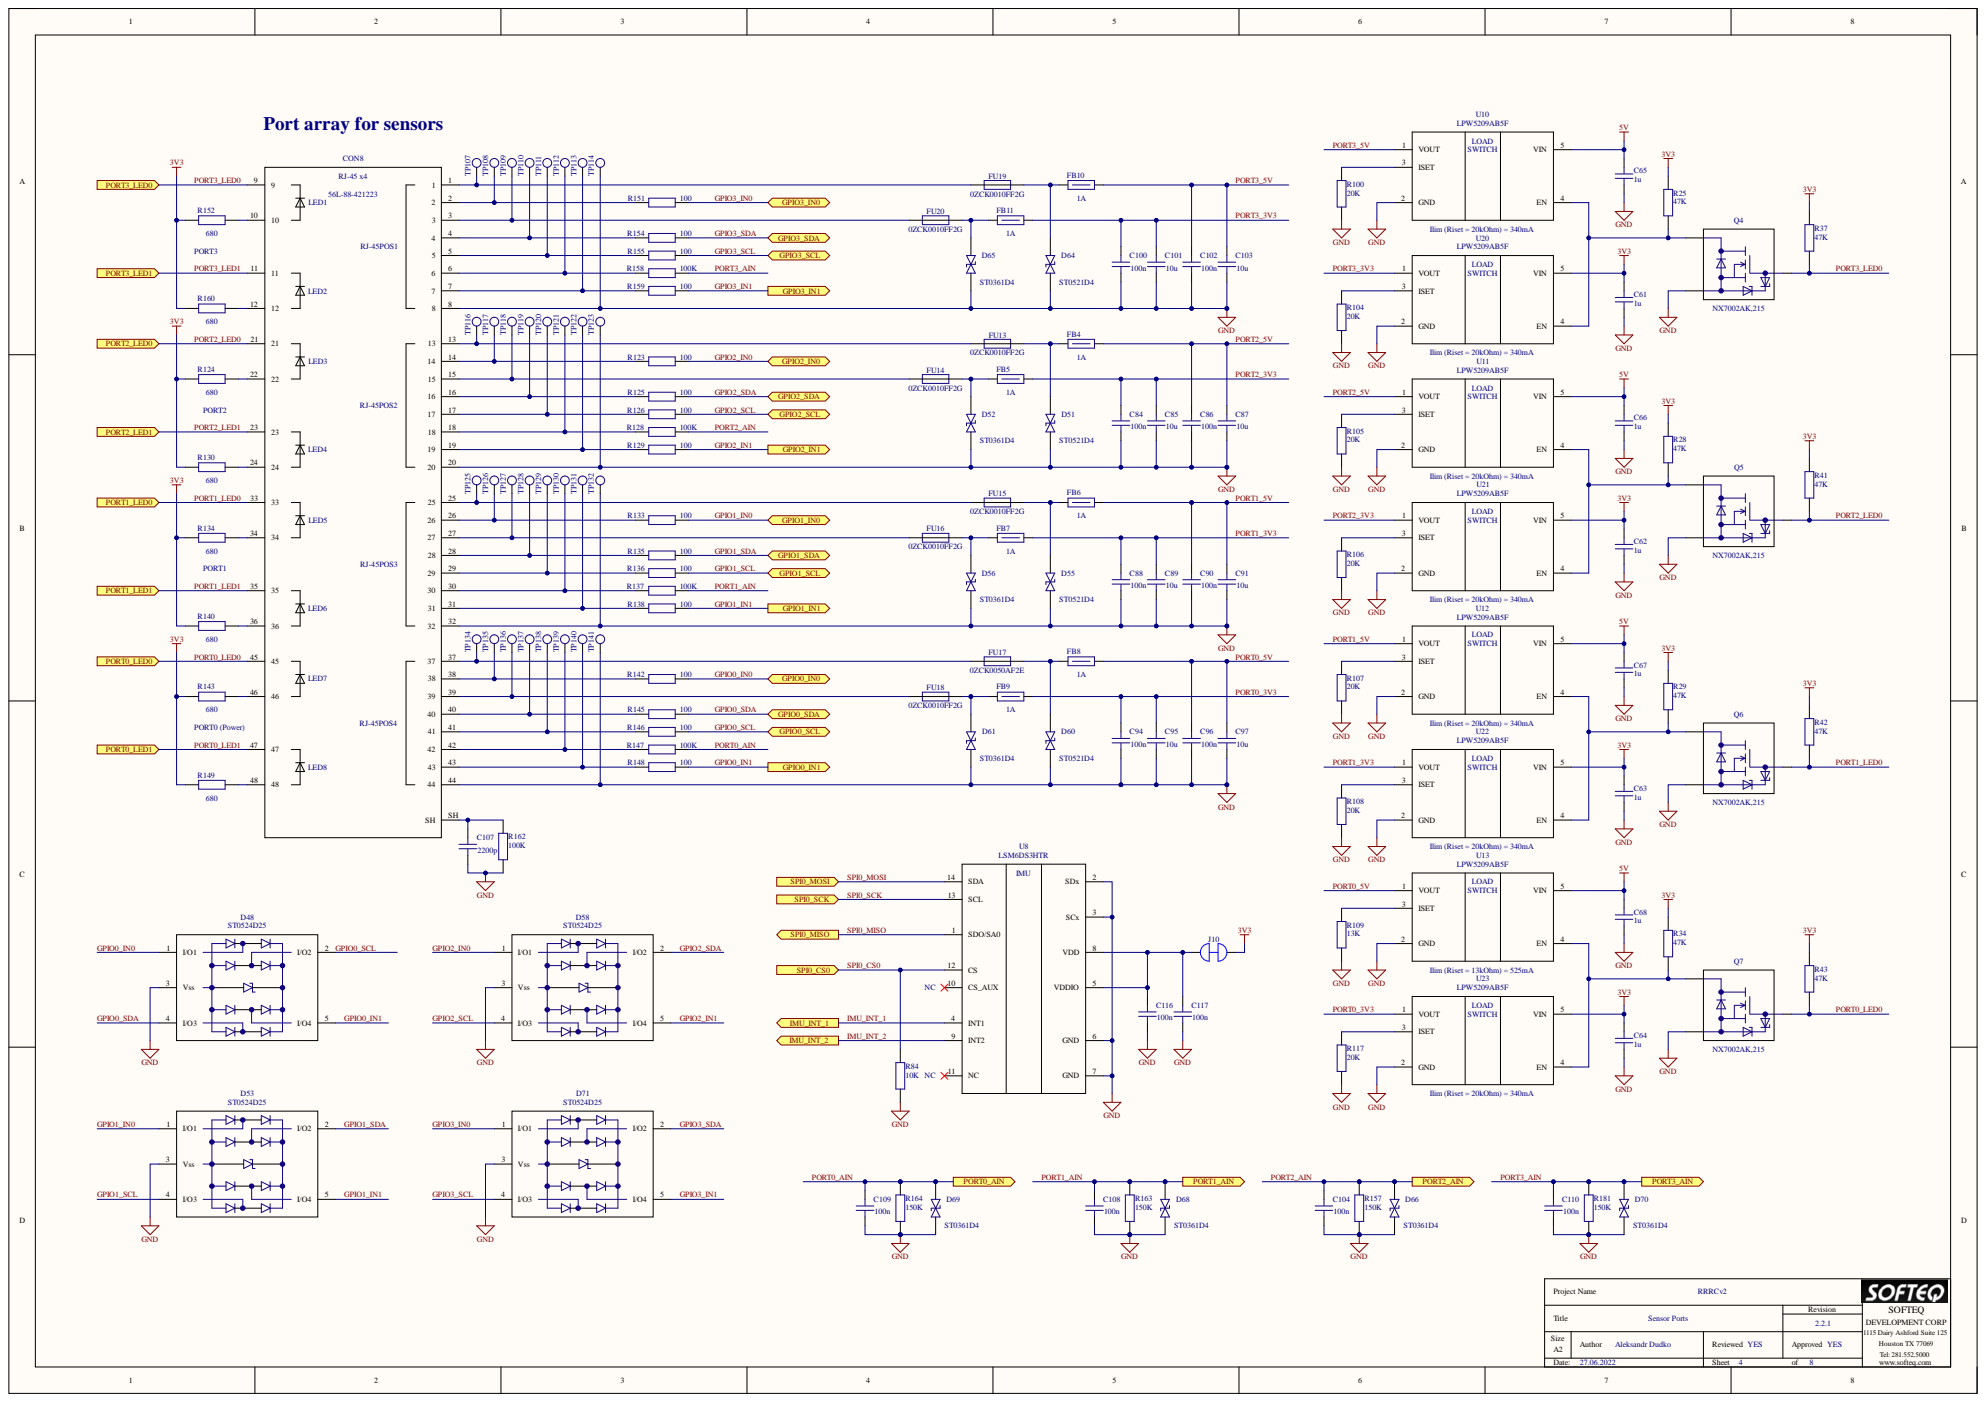
[picture p236: page 4]

VOU T I SET GND | LOA D S W IT C H | VI N

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

P roje ct Na me C v2 | SO F T E Q DEVELOPMENT COR 5 Dai ry As h fo r d Su ite 1 Ho u sto n TX 7 Tel w.softeq.com

Title Size S ensor Ports | vision

A | Author | R e vie w d | Approv

Date : | | She t of

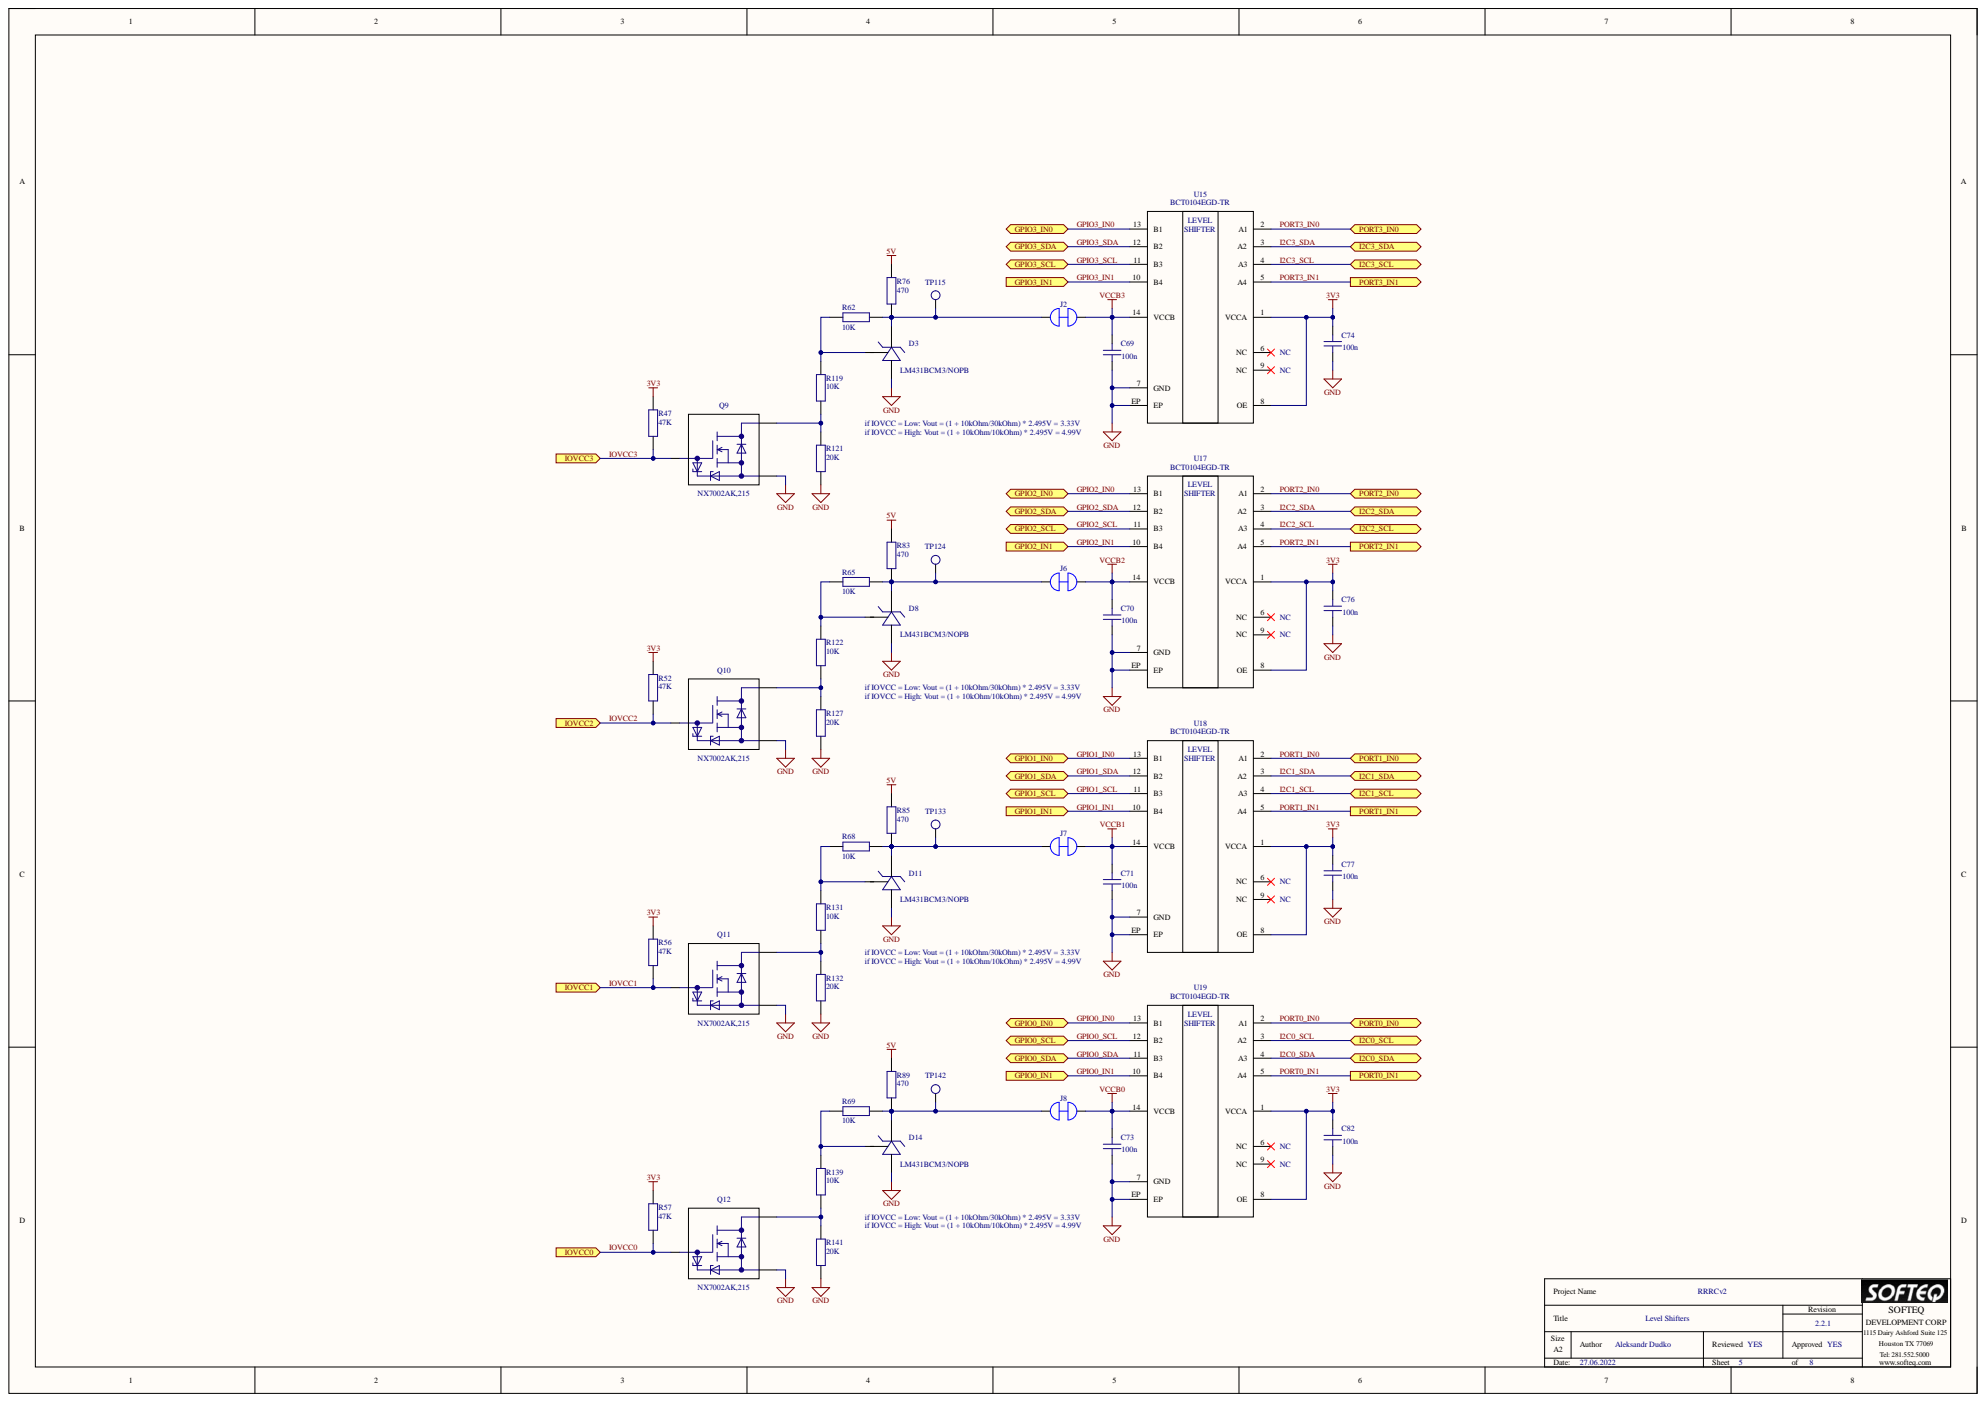
[picture p237: page 5]

1 13 B | LEVEL SHIFTER | A 1 A 2 A 3 A4 VC C A NC NC OE | 1 VCCB 14
B2 12 B3 11 B4 10 GND 7

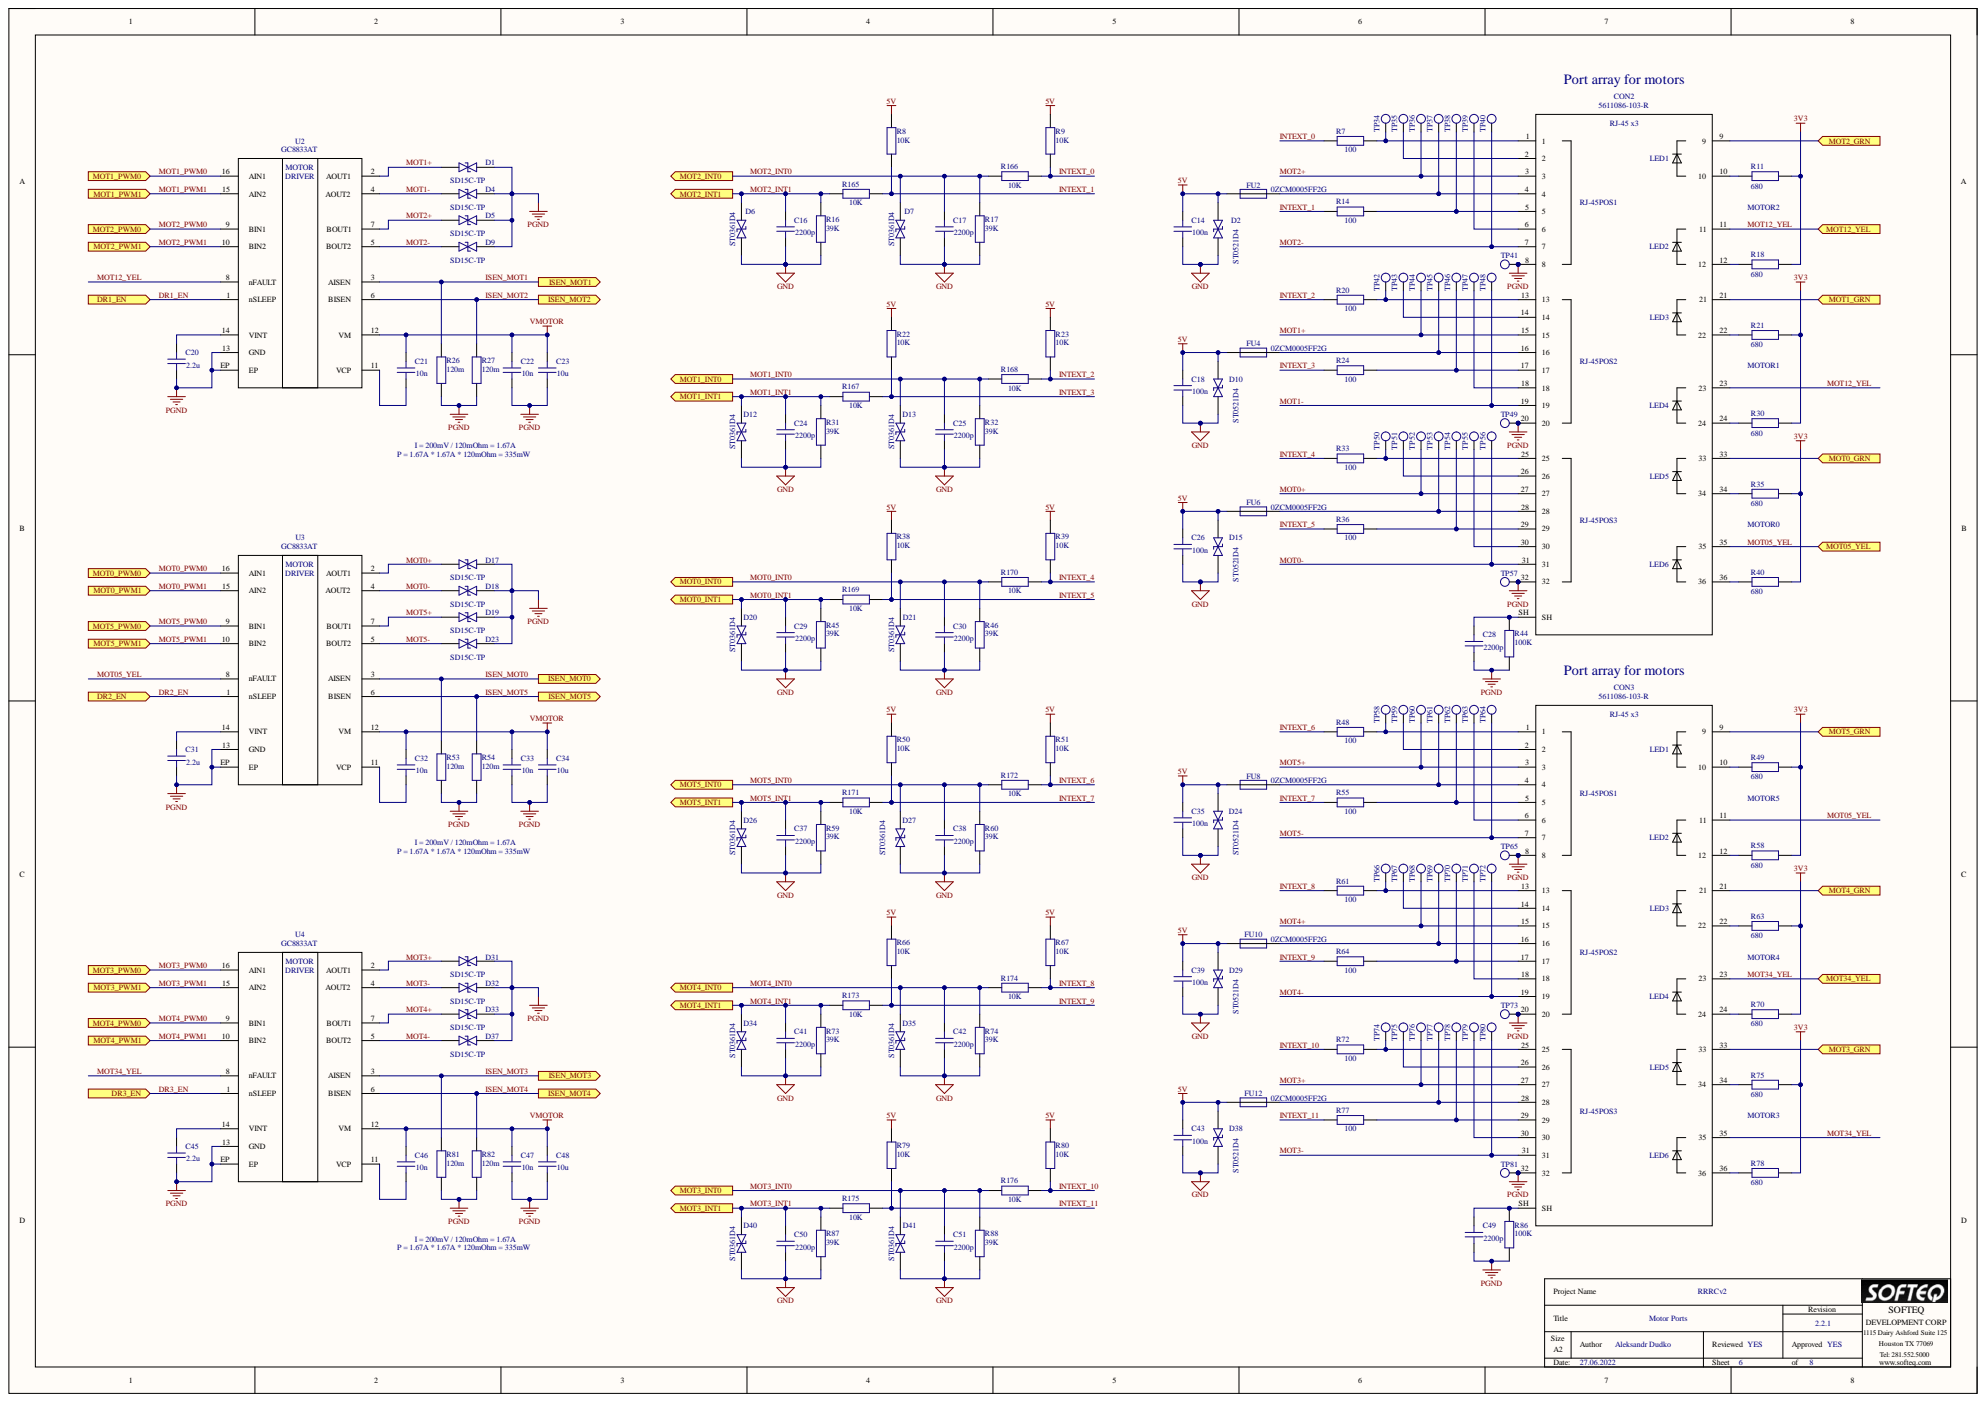
[picture p238: page 6]

GND GND GND

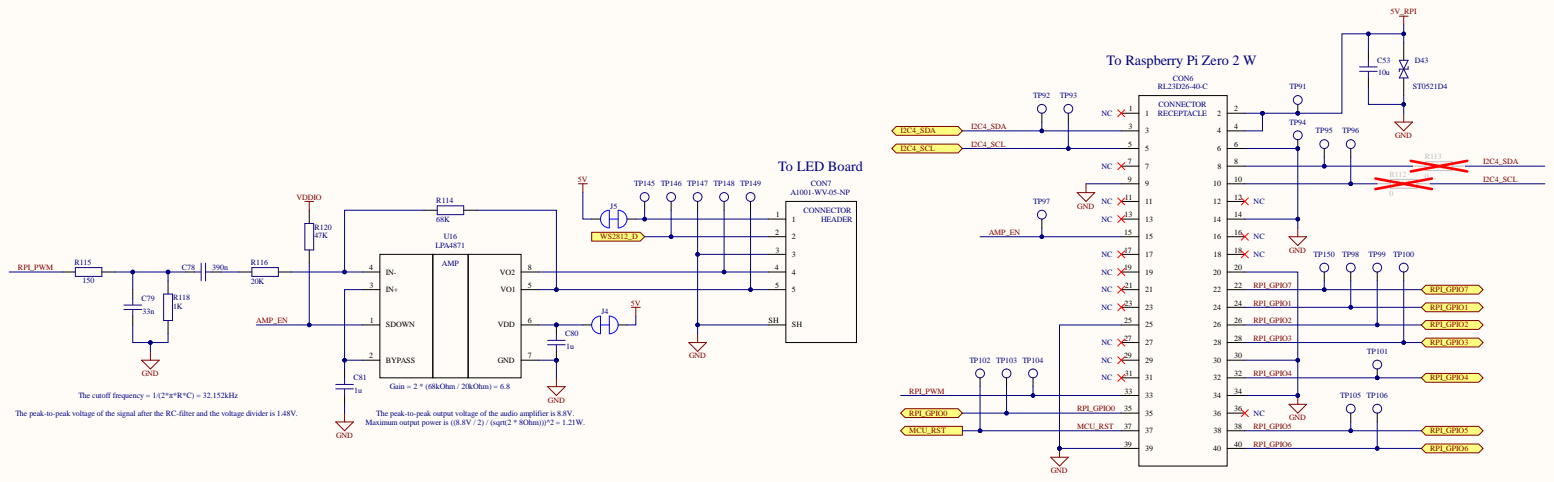
[picture p239: page 7]

To Raspberry Pi Zero 2 W

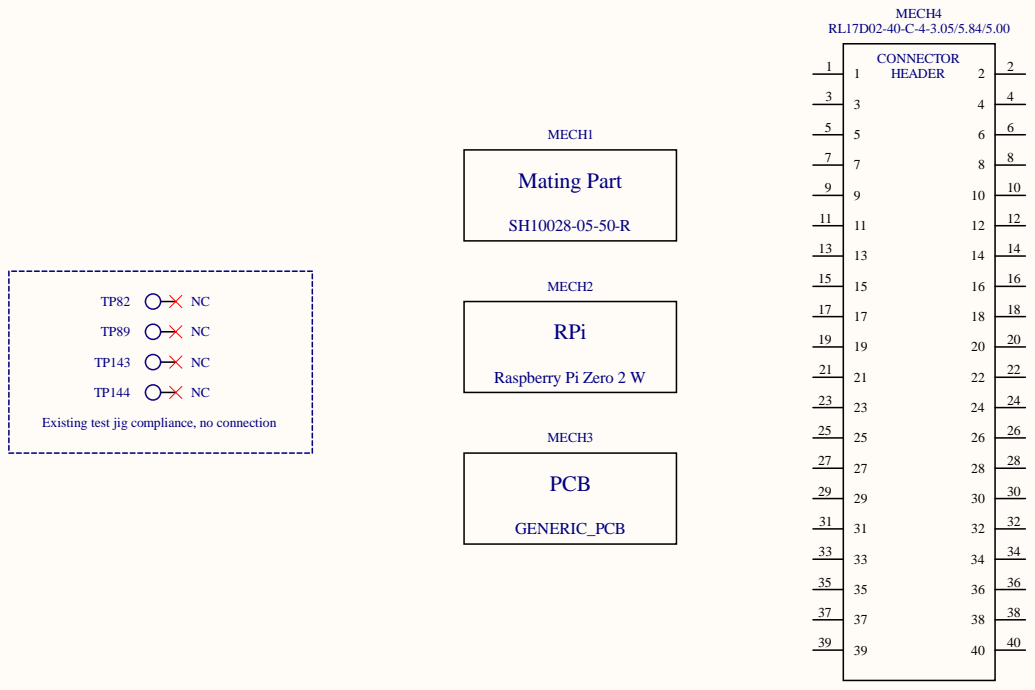
[picture p240: page 8]

Existing test jig compliance, no connection
