STEAM-Academy-PRO/revolution-robotics-kit/electronic parts/BU - Button Sensor/Button-sensor-v1-production/PCB/Specifications/button-hard-TD-06XB.pdf

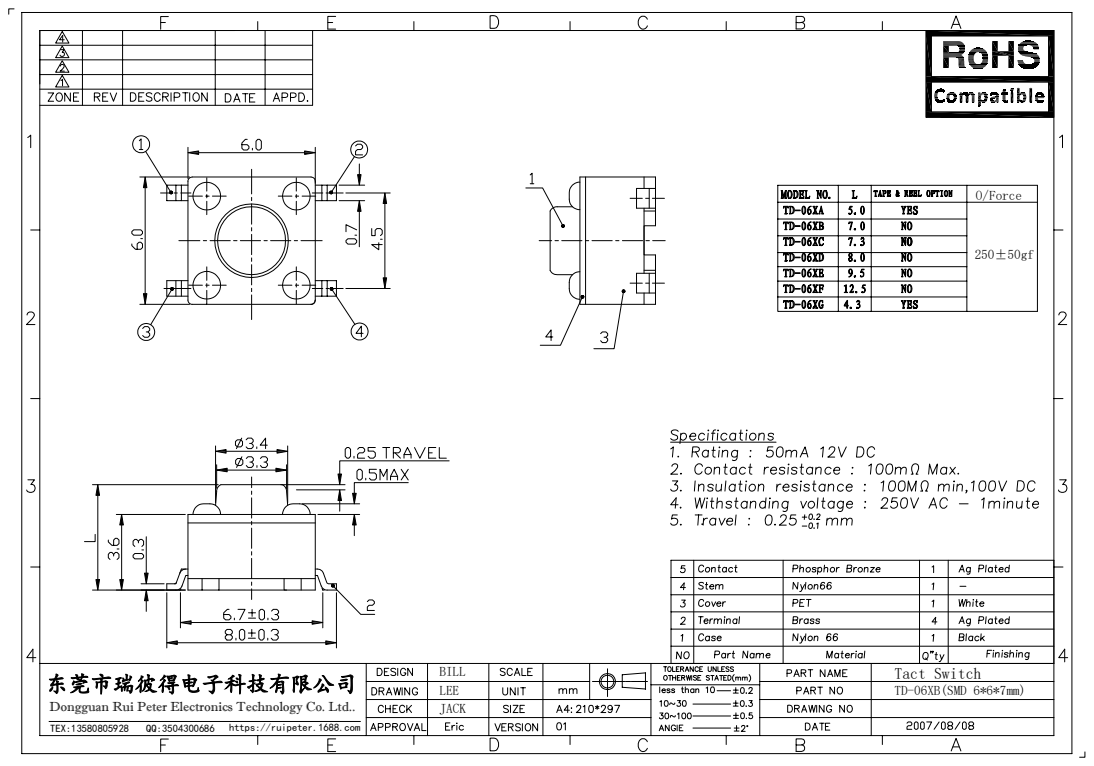
[picture p241: page 1]
O/Force

东莞市瑞彼得电子科技有限公司 Dongguan Rui Peter Electronics Technology Co. Ltd.. TEX:13580805928 QQ:3504300686 https://ruipeter.1688.com | | BILL
LEE | | Tact Switch TD-06XB(SMD 6*6*7mm)

JACK
