STEAM-Academy-PRO/revolution-robotics-kit/electronic parts/BU - Button Sensor/Button-sensor-v1-production/Schematic/Button-Sensor.pdf

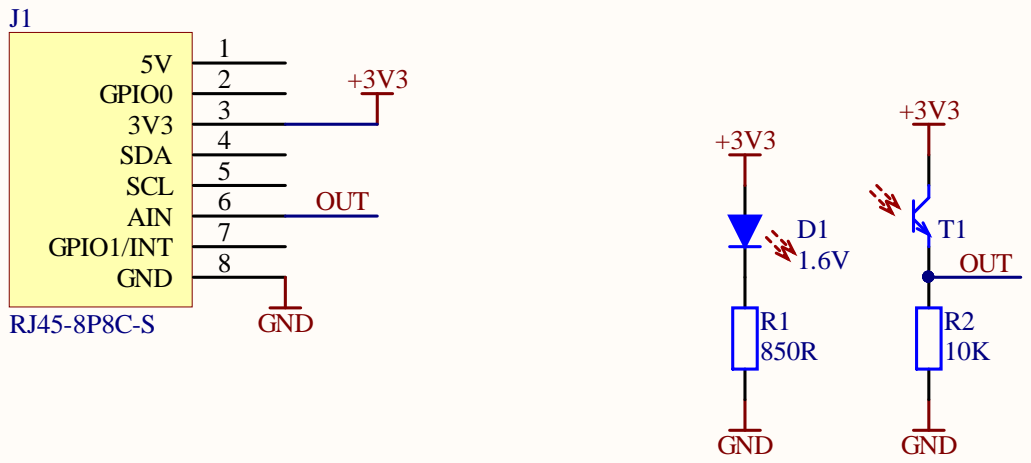
[picture p242: page 1]
