STEAM-Academy-PRO/revolution-robotics-kit/electronic parts/BU - Button Sensor/Button-sensor-v1-production/PCB/Specifications/button-soft-6X6x7LT.PDF

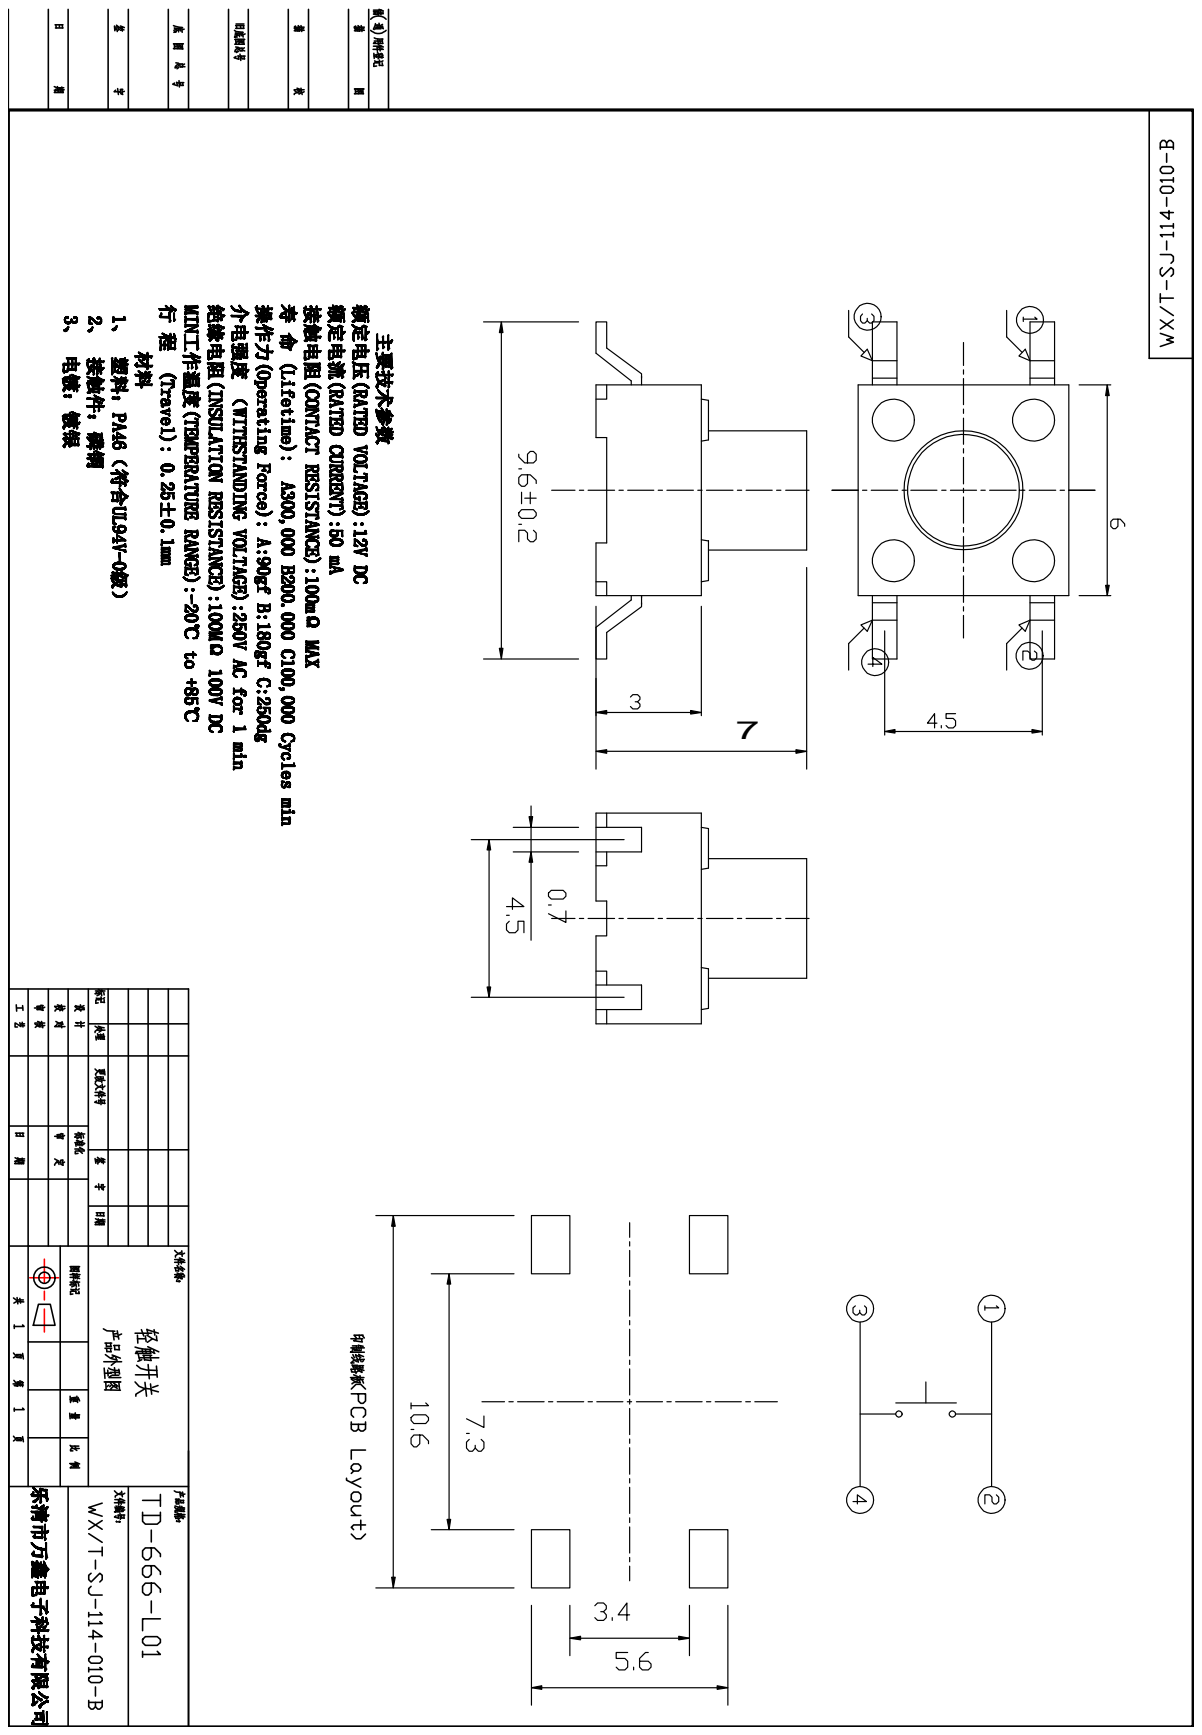
[picture p243: page 1]
