STEAM-Academy-PRO/revolution-robotics-kit/electronic parts/BU - Button Sensor/Button-sensor-v1-production/PCB/Specifications/5721-8P8C-全塑有耳.pdf

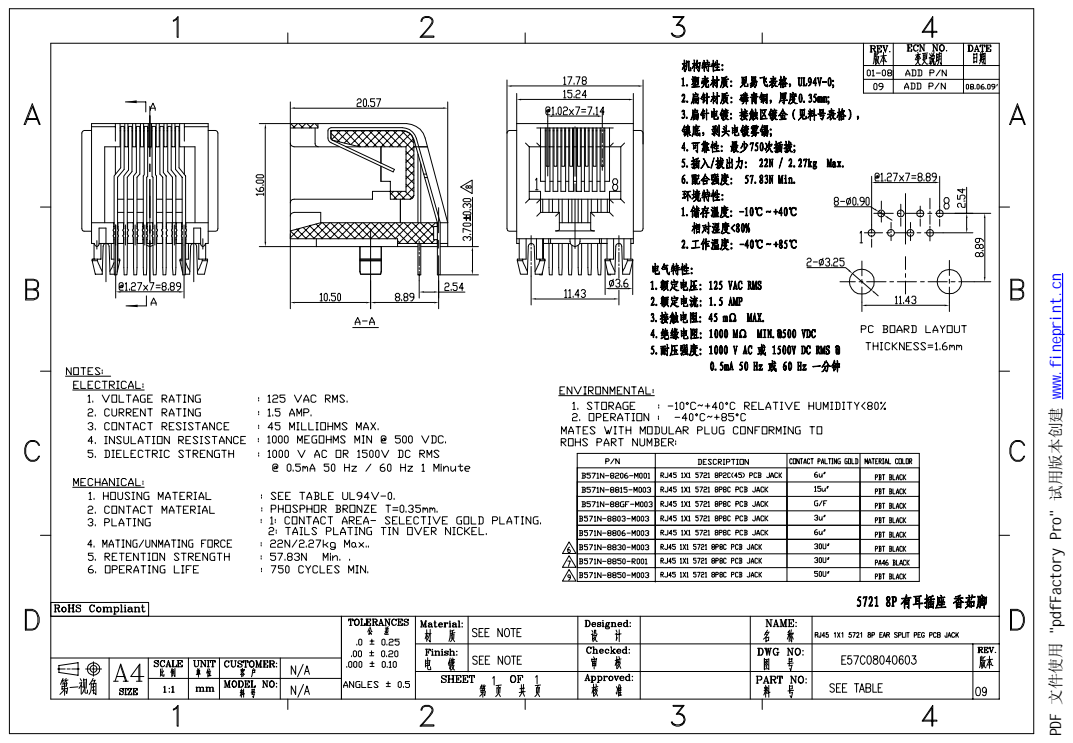
[picture p244: page 1]

PDF 文件使用 "pdfFactory Pro" 试用版本创建 www.fineprint.cn
