STEAM-Academy-PRO/revolution-robotics-kit/(list of files, drawings)

Other design files:
electronic parts/BU - Button Sensor/Button-sensor-v1-production/PCB/CAD/Button-Sensor.PcbDoc
electronic parts/BU - Button Sensor/Button-sensor-v1-production/PCB/CAD/Button-Sensor.PcbLib
electronic parts/BU - Button Sensor/Button-sensor-v1-production/PCB/CAD/Button-Sensor.PrjPCB
electronic parts/BU - Button Sensor/Button-sensor-v1-production/PCB/CAD/Button-Sensor.SchDoc
electronic parts/BU - Button Sensor/Button-sensor-v1-production/PCB/CAD/Button-Sensor.SchLib
electronic parts/LM - LED Matrix/LED-Matrix-v1-development/PCB/LedMatrix.PcbDoc
electronic parts/LM - LED Matrix/LED-Matrix-v1-development/PCB/LedMatrix.PcbLib
electronic parts/LM - LED Matrix/LED-Matrix-v1-development/PCB/LedMatrix.PrjPCB
electronic parts/LM - LED Matrix/LED-Matrix-v1-development/PCB/LedMatrix.SchLib
electronic parts/LM - LED Matrix/LED-Matrix-v1-development/PCB/LedMatrixMain.SchDoc
electronic parts/LM - LED Matrix/LED-Matrix-v1-development/PCB/LedMatrixPixel.SchDoc
electronic parts/LM - LED Matrix/LED-Matrix-v1-development/PCB/LedMatrixPixelArray.SchDoc
electronic parts/MO - Motor/Motor-v1-production/PCB/CAD/▒Я┬вкэ░тV2.1(1).PcbDoc
