STEAM-Academy-PRO/revolution-robotics-kit/(commit log)

2023-09-20 Readme BoM link added
2023-09-20 2D drawings in PDF added for the current mechanical parts
2023-09-20 RR full v2 kit manufacturing files added (2023-09-20 version).
    [BOM_bumper.xlsx, BOM_ultrasonic.xlsx, Bumper.PcbDoc, Bumper.PcbLib, Bumper.PrjPCB, Bumper.SchDoc, Bumper.SchLib, CG40_china.SLDPRT]
2023-10-31 electronic 3d files added as a test of the structure
    [button-sensor-3D-manufacturing.step]
2023-11-30 Initial commit - added everything form the factory package (unsorted)
    [2023-11-24-colour-sensor-factory-model-draft.stp, CC1x2.STEP, CC2x1.STEP, CG40_china.SLDPRT, CG40_china.STEP, TB1x4.STEP, WE5x4.stp, WG30-0806.SLDPRT]
2023-12-29 Drive version of Colour sensor added as to be sorted
    [from-gDrive-2021-04-13-ColorSensorv2.step]
2024-02-20 Adding all files from different sources
    [0437客户RRRC_LEDsBoard_manufacturing_v2.2_20190610工程咨询 ENG EQ(02AE21418A0)_answered.xls, 2023-11-24-colour-sensor-factory-model-draft.stp, 683866P_2000mAh.SLDPRT, BOM-Ultrasonic-Sensor.xlsx, BoM-Button-Sensor.xlsx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]
2024-02-24 Reorganizing electronic components
    [0437客户RRRC_LEDsBoard_manufacturing_v2.2_20190610工程咨询 ENG EQ(02AE21418A0)_answered.xls, 683866P_2000mAh.SLDPRT, Carrier_Board_v2_v1.1.5_20210823.xlsx, RRRC_CarrierBoard_manuf acturing_v3.4（SN028ZC06341A0）.xls, RRRC_CarrierBoard_manufacturing_v4.5（LN028ZC06267A0-06AE22212B0）EQ.xls, RRRC_LEDsBoard_manufacturing_v2.3_20190802(02AB22211A0)(SK167ZC02624A0) EQ.xls, RRRC_LEDsBoard_manufacturing_v2.3_2019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]
2024-03-27 Motor files updated to the latest version, old v1 production model moved to the legacy folder
    [GearTrax-1.ipt, Inner shaft.ipt, MObeta.iam, MObeta_ANY.iam, MOcA_1.ipt, MOcA_2.ipt, MOhA.ipt, Motor inner assembly.iam]
2024-03-27 Files added for the V1 Motor
2024-03-27 Motor folder restructuer
    [GearTrax-1.ipt, Inner shaft.ipt, MObeta.iam, MObeta_ANY.iam, MOcA_1.ipt, MOcA_2.ipt, MOhA.ipt, Motor inner assembly.iam]
2024-03-27 Battery production and development assets sorted
    [AA-battery.sldprt, BACA_bottom.SLDPRT, BACA_top.SLDPRT, BA_battery.SLDPRT, BAbeta_battery.STEP, BAbeta_bottom.STEP, BAbeta_top.STEP, BAbeta_tray_black.STEP]
2024-03-27 Button sensor files sorted
    [BUbeta.SLDASM, BUbeta_black.STEP, BUbeta_onepart.SLDPRT, BUbeta_white.STEP, BUbeta_yellow.STEP, BoM-Button-Sensor.xlsx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]
2024-04-02 Ultrasonic Sensor files sorted
    [BOM-Ultrasonic-Sensor.xlsx, HC-SR04.step, RJ45x1A.SLDPRT, USbeta.SLDASM, USbeta.STEP, USbeta_black.STEP, USbeta_black2-3.STEP, USbeta_white.STEP]
2024-04-02 Brain files sorted
    [0437客户RRRC_LEDsBoard_manufacturing_v2.2_20190610工程咨询 ENG EQ(02AE21418A0)_answered.xls, 6431150608.iam, 6431151088.iam, 6440465920.iam, 6440467760.iam, 6440772896.iam, 6440777696.iam, 683866P_2000mAh.SLDPRT]
2024-04-02 LED Matrix files sorted
    [LED-Matrix-case-bottom.STL, LED-Matrix-case-top.STL, LED-Matrix-full.SLDASM, LED-Matrix-singlepart.SLDPRT, LED-Matrix.step, LedMatrix.PcbDoc, LedMatrix.PcbLib, LedMatrix.PrjPCB]
2024-04-02 Axle-related files added
    [AXp12s-m.SLDPRT, AXp12s-m.iam, AXp12s-m.ipt, AXp12s-m.stl, AXp12s-m.stp, AXp2c.iam, AXp2c.ipt, AXp2c.stl]
2024-04-02 Angled Beam files added
    [A120.iam, A120.ipt, A120.stl, A120.stp, A135.iam, A135.ipt, A135.stl, A135.stp]
2024-04-02 Axle Beam files added
    [AXb1.iam, AXb1.ipt, AXb1.stl, AXb1.stp, AXb3.iam, AXb3.ipt, AXb3.stl, AXb3.stp]
2024-04-02 Curved Beam files added
    [Beam_bent_base-120.ipt, Beam_bent_base-135.ipt, Beam_bent_base-90.ipt, CB4H.ipt, CB4H.stl, CB4H.stp, CB6H.ipt, CB6H.stl]
2024-04-02 Round Beam files added
    [RB1+.iam, RB1.iam, RB12.iam, RB12.ipt, RB12.stl, RB12.stp, RB16.iam, RB16.ipt]
2024-04-02 Straight Beam files added
    [S1+x1.iam, S1x1.SLDPRT, S1x1.ipt, S1x1.stl, S1x1.stp, S1x12.iam, S1x12.ipt, S1x12.stl]
2024-04-02 New parts added
    [A1 field.SLDPRT, Beam_T_base.ipt, Beam_bent_base.ipt, CWBA_1.ipt, CWBA_2.ipt, CWBETA_ASM.iam, CWPA_ASM.iam, CWPA_STP_ASM.iam]
2024-04-02 Colour Sensor files added
    [ColorSensor.SLDASM, ColorSensor.SLDPRT, Colour-Sensor-case-attachment-1.stp, Colour-Sensor-without-case-attachment.STEP, Colour-Sensor.PcbDoc, Colour-Sensor.PcbLib, Colour-Sensor.PrjPCB, Colour-Sensor.SchDoc]
2024-04-02 Mechanical parts added
    [228-2536.SLDASM, 228-2536.STEP, A120.DWG, A120.SLDDRW, A120.SLDPRT, A135.DWG, A135.SLDDRW, A135.SLDPRT]
2024-04-03 file renamed
    [Colour-Sensor-case-attachment-example-1.stp]
2024-04-15 Labelling materials added to battery and brain
    [AA-battery.sldprt, BACA_2.SLDDRW, BACA_2.SLDPRT, BACA_bottom.SLDPRT, BACA_top.SLDPRT, BA_battery.SLDPRT, BAbeta_v2.SLDASM, BAbeta_v2.STEP]
2024-04-15 New (correct) pre-production motor model added
2024-04-16 Challenge field and cup materials added
    [challenge field.SLDDRW]
2024-04-18 New brain files added
    [Carrier-board-v2-rev3.3.0-20240415.xlsx, Carrier_Board_v2_v1.1.6_20211217.xlsx, Carrier_Board_v2_v2.2.1_20220627.xlsx, LEDs-board-v2-rev3.4.0-20190911.xlsx]
2024-04-23 V3 REV 1.1.1 Brain Carrier board added as D Sample SoP
    [Carrier-board-v2-rev3.3.0-20240415.xlsx, Carrier_Board_V3_Rev1.1.1_20240423.xlsx]
2024-04-23 Motor QC test result sheets added
    [Motor-QC-test-2024-04-20.xlsx]
2024-05-08 New colour sensor 3D model added
2024-05-08 SD card silkscreen modified
2024-05-10 Battery pack labelling properly added with all assets
2024-05-13 Reviewed colour sensor 3D model added
2024-05-21 Toolbox initial files added
    [lego-spike-box-inside-trays-3D.stp]
2024-06-03 New toolbox tray 3D added (modified by the factory)
    [lego-spike-box-inside-trays-3D-2024-05-21.stp]
2024-06-03 New color sensor files after PCB modification for production added
    [Color_Sensor_Board-2024-06-03.step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]
2024-06-03 Color sensor CAD project added
2024-06-19 V2 D sample Carrier Board modifications due to pre-production issues with HM5166
    [Carrier_Board_V3_Rev1.1.1_20240423.xlsx, Carrier_Board_V3_Rev2.2.0_20240612.xlsx]
2024-06-19 Brain White silkscreen added
2024-06-27 Notes added for the brain carrier board
2024-07-03 Button and brain side switch datasheets added
2024-07-08 2024-06-12 Pre-production trip changes added to the repo
    [2024-06-11-lego-spike-box-inside-trays-bottom.STEP, 2024-06-11-lego-spike-box-inside-trays-top.STEP, 2024-06-13-button-mockup-by-david.STEP, Color_Sensor_Board-2024-06-03.step, Color_Sensor_Board-2024-06-11.x_t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]
2024-07-08 Wire length correction
2024-07-12 Brain LED board modification (2024-07-10)
    [Assembly Testpoint Report for leds.csv, LEDs-board-v2-rev3.4.0-20190911.xlsx, LEDs-board-v2-rev4.4.0-20240621.xlsx]
2024-07-18 Battery label changed a bit
2024-07-18 Certificate materials (preparation to get certs) added
2024-08-16 Switched to production mode with V2 kit. Added missing files
    [AA-battery.sldprt, Assembly Testpoint Report for leds.csv, Carrier-board-v2-rev3.3.0-20240415.xlsx, Carrier_Board_V3_Rev2.2.0_20240612.xlsx, Carrier_Board_v2_v1.1.5_20210823.xlsx, Carrier_Board_v2_v1.1.6_20211217.xlsx, Carrier_Board_v2_v2.2.1_20220627.xlsx, GearTrax-1.ipt]
2024-09-11 3D printed version of pin removal moved to a subfolder
    [pin-removal-tool-3D-print.SLDPRT, pin-removal-tool-3D-print.STL]
2024-11-19 Added a comment about the size of the battery tray
2024-12-05 Battery pack label vectorized
2024-12-12 Labels changed after home print
2025-08-20 Committing changes for prod v2
    [Omniwheel - caster wheel.xlsx]
